StellaRigel/ESP32-Pressure-Temperature-Humidity-Recorder/实现细节.md

# 实现细节（PHT_2_X）

> **定位**：写**"怎么做"与"打算怎么做"** —— 原语 / 调用点 / 实测数据 / 踩坑台账 / **待做项的方案与论证**。
> **只写结论与做法，不写"一章要看半天"的推演**：设计文档图快览、本文档存细节，两份都不重复。
> 规格与版本规划看 [`设计文档.md`](设计文档.md)；怎么建 / 怎么跑 / 状态看 [`README.md`](README.md)。
> **约定**：某版本开发时段内的实现细节写进本文档对应小节；**同一份文档内不重复**。
> **待做项**：方案、根因、实测数据、边界与验收都写这里；设计文档只留一行「待办名 + 指向本文档」。

> **管理规则**：① 每节标题带**稳定编号** `D1…Dn`，**正文新内容一律往后追加、不重排**（编号 = 身份证，全项目靠它引用）；② 每节首行标**来源**；③ 原文对应位置只留**一行标记 + 本文档链接**；④ **待做项也在这里写全（含方案与论证），设计文档只留一行待办名 + 本文档链接**；⑤ 状态（做没做）不在本文档判断，看设计文档的版本标记与 README 状态总表；⑥ **模块化导航见下一节**「按模块找内容」——它按逻辑分组、**可随时重排**，正文顺序不受影响。

> ## ⛔ 铁律：**不要用 ESP32 去读 INA226/230 的电流做电量相关计算**（用户 2026-09-29 明确）
>
> **INA226/230 的电流读数，唯一允许的用途是判断充电阶段（CC/CV）**。
> **禁止**用它做：电量估算、电量百分比、能耗/功耗统计、放电速率、剩余时间、A/B 对比的"平均电流"、
> 以及任何"这个设备耗了多少电"的结论。
>
> **为什么**：这是**观察者效应** —— INA226 串在电池回路上，**ESP32 自己唤醒去读它的那一刻，
> ESP32（CPU + I²C + 外设）本身就是被它测着的负载**。读数里混着"测量动作自身的开销"，
> 而且这个开销随固件行为变化（睡不睡、刷不刷屏、开不开射频）→ **自己测自己，纯属胡闹**。
> 详见 **D11**（静置采样观察者效应，含实测：读数 ≥ 真实值 + 自身开销，电压被压低 ≈7mV）。
>
> **正确做法**：算电/比耗电一律**看电压（+ 由本机曲线表换算的电量%）随时间的下降**——
> 这是拓扑无关、不受测量动作污染的口径（标定的"时间轴"设计也是同一个理由，见设计文档 2.2 / **D15**）。
>
> **例外**：除非将来**加一颗独立的 MCU（如 STM32）专职读 INA226**，让测量与负载解耦，才可能重新考虑。

| 编号 | 小节 | 来源 |
|---|---|---|
| D1 | 充电控制 | 设计文档 V2.1 · 充电策略（两个「实现状态」节） |
| D2 | 气压距平与日平均基线 | 设计文档 V2.1 · 数据可视化 |
| D3 | 低电保护（三档阈值/深睡） | 设计文档 V2.1 · 电源管理模块 |
| D4 | 蓝牙三批实装（已搁置） | 设计文档 V2.1 · 无线 |
| D5 | 固件尺寸台账 | 设计文档（原「实现状态」行） |
| D6 | 屏幕布局参数 | README §三（79 行） |
| D7 | 怎么调屏幕 | README §四 |
| D8 | 屏幕提示 toast | 设计文档 V2.1 · 无线 |
| D9 | 标定首跑复盘（含 CSV 数据分析） | README §十三（123 行） |
| D10 | 第二跑结果与两跑对比 | README §十四（47 行） |
| D11 | 静置采样观察者效应/AVG 窗口 | 设计文档 2.4 |
| D12 | 标定落盘格式与掉电安全 | 设计文档 2.5 |
| D13 | 电量校准散落实测值/参数 | 设计文档 2.3 / 2.8（逐句挑出） |
| D14 | 连接策略与充电交互 | 设计文档 V2.1 · 连接策略 / V2.1.1 · 一 |
| D15 | 标定：充满判定、建表与使用 | 设计文档 V2.1.1 · 2.6 |
| D16 | 标定：流程与交互实现（设备隐身） | 设计文档 V2.1.1 · 2.8 |
| D17 | 顶栏即时反馈（V2.1.1-c） | 设计文档 V2.1.1 · 三 |
| D18 | 多组 WiFi 存储与自动选最强 | README §六 · 第 11 条（2026-09-17 搬入） |
| D19 | 手动归档下线 · `/download` 内存缓冲 · 术语改名 | README §十五 ①③④（2026-09-17 搬入） |
| D20 | V2.1.1 归纳：IO9 快慢充 · 实现顺序 · 本轮改动 · **待做项（计划细节）** | 设计文档 V2.1.1（2026-09-17 搬入；含 EEEE/FFFF 块去重） |
| D21 | V2.2 硬件规划：电源多路复用器 TPS2117 · 换 LDO RT9013 · 接线更改 | 设计文档 V2.2 · 硬件（2026-09-17 搬入；含 EEEE/FFFF 块去重） |
| D22 | V2.1 归纳：连接策略演化（被取代原文）· 充电/INA226 补遗 · 屏幕横幅规格 | 设计文档 V2.1 · 连接策略 / 充电策略 / 电池监测（2026-09-17 搬入并精简） |
| D23 | 三要素 24h 变率（整点环 · 屏幕箭头 · 网页显示） | 设计文档 V2.0 · 24h变率（2026-09-17 搬入；含 DDDD/CCCC 块去重） |
| D24 | 归档：引脚冲突实测 · BLE 铁律与崩溃取证 · BLE 搁置决策与连带项 | 设计文档原 附录 A.4~A.6 / 附录 B / 附录 C（2026-09-17 搬入并拆分） |
| D25 | 绝对湿度（AH）统一口径 · 湿度变率改 AH · 湿度图双轴曲线 | 设计文档 V2.1.1 · 交互和可视化 第 3/5 条 · 🚧 待做 第 6 条（2026-09-29 实装） |
| D26 | 网页 logo · favicon · 主屏图标（iOS + Android）（母题选型 · SVG data URI · PNG 路由 · PWA manifest） | 设计文档 V2.1.1 · 交互和可视化 第 2 条 · 🚧 待做 第 5 条（2026-09-29 实装） |
| D27 | 网页宽屏布局（≥1000px 多列仪表盘 · 数值行栅格化） | 用户 2026-09-30 实测反馈（4K 上曲线被拉平） |
| D28 | 未插卡时的日志兜底（按时间戳裁头 14 天）+ 按需挂载 SD（`ensureSD()`） | 用户 2026-09-30 问 flash 磨损 → 挖出"不轮转"与"sdOK 只判一次" |

## 按模块找内容（逻辑索引 —— 用这个导航）

> 正文仍按 `D1…Dn` **追加式**排列（编号 = 稳定身份证，规则见上）；**这一节是给"按模块找东西"用的导航表**。
> 归属唯一的模块；跨模块的条目以主模块为准，其余用途在条目里注明。
> 状态：**🔧 已实现** ／ **🧪 待验证** ／ **📋 计划中** ／ **📦 历史复盘**。

### ① 电源与电池
- **D1** 充电控制（原语 / 模式联动 / 80% 滞回）— 🔧
- **D3** 低电保护三档阈值与深睡 — 🔧（阈值来历待按本机表改造 → D20-5 ④）
- **D22-2 / D22-3** 充电硬件小项 · INA226 测量细节补遗（采样电阻、接法极性、CV 门限、离线兜底）— 🔧

### ② 电量标定与电池算法
- **D11** 静置采样观察者效应（INA226 AVG 窗口）— 🔧
- **D12** 标定落盘格式与掉电安全 — 🔧
- **D13** 电量校准散落实测值 / 参数（CSV 列 / 干跑 / 路由 / 原型坑 / 负载健康标志 / 进度屏）— 🔧
- **D15** 充满判定、建表与使用（21 点表 / 单调查表）— 🔧
- **D16** 标定流程与交互（设备隐身 / 停 HTTP / 中止条件 / 灰显）— 🔧
- **D20-5 ①~④** 网页响应抖动 · 今日统计回灌 · 换 LDO · 三档跟本机表走 — 📋🧪

### ③ 数据采集与算法
- **D2** 气压距平与日平均基线 — 🔧
- **D23** 三要素 24h 变率（整点环 / 屏幕箭头 / 网页显示）— 🔧（湿度档 2026-09-29 改绝对湿度 → D25）
- **D25** 绝对湿度（AH）统一口径 · 湿度变率改 AH · 湿度图双轴曲线 — 🔧
- **D19 ③** `/log.csv` 冻结调查与 `/download` 内存缓冲口径 — 🧪（根因未定）

### ④ 网页与前端
- **D13-3** 标定相关路由清单 — 🔧
- **D18** 多组 WiFi 存储与自动选最强（`/wifi` 页 / 接口 / 三条教训）— 🔧
- **D20-5 ⑤** 给网页加 logo — ✅（2026-09-29 实装 → **D26**）
- **D26** 网页 logo · favicon · 主屏图标（iOS + Android）（母题选型 / SVG data URI / PNG 路由 / manifest）— 🔧
- **D27** 网页宽屏布局（≥1000px 多列仪表盘 / 数值行栅格化）— 🔧
- **D28** 未插卡时的日志兜底（按时间戳裁头 14 天）+ 按需挂载 SD — 🔧

### ⑤ 无线通信
- **D14-1~D14-6** 连接策略：触发 / 流程 / 失败 / 空闲回收 / 静态 IP — 🔧
- **D14-3~D14-6** 与 **D22-4** 连网会话的历史原文（已作废，仅追溯）— 📦
- **D22-5** 屏幕横幅（连接成功 / 失败）文案与时长 — 🔧

### ⑥ 人机交互（按钮 · 屏幕 · 提示）
- **D6** 屏幕布局参数（顶栏 / 数据行 / 各状态）— 🔧
- **D8** 屏幕提示 toast 时机与版面 — 🔧
- **D14-7~D14-10** IO9 按钮：长按判定 / 快慢充 / 复位条件 / 反馈 — 🔧
- **D17** 顶栏即时反馈（V2.1.1-c）— 🔧
- **D20-1** IO9 按钮语义归纳（移动+插电切快慢充）— 🔧

### ⑦ 工程与流程
- **D5** 固件尺寸台账 — 🔧
- **D19 ①②④** 手动归档下线 · `/download` 口径 · 术语改名 — 🔧
- ⚠️ **D24-2 BLE 关闭铁律** —— **APP 阶段复活 BLE 前必读**（`deinit` 前必须确认无客户端连接，否则必 PANIC）— 📦

### ⑧ 历史复盘与决策留档
- **D9** 标定首跑复盘（含 CSV 数据分析）— 📦
- **D10** 第二跑结果与两跑对比 — 📦
- **D24-1 / D24-3** IO35 冲突实测与飞线工序 · 崩溃现场取证流程 — 📦
- **D24-2** ⚠️ BLE 关闭铁律（APP 阶段复活 BLE 前必读）— 📦
- **D24-4 / D24-5** BLE 搁置决策与连带项 · 蓝牙配网会话时序（已作废）— 📦
- **D20-3 / D20-4** V2.1.1 实现顺序 · 本轮改动台账 — 📦
- **D21** V2.2 硬件规划（TPS2117 / 换 LDO / 接线更改）— 📋（引脚待 PCB 画完确认）
- **D22-1** V2.1 各细节的归属总表 — 📦
- **D4** 蓝牙三批实装（已搁置）— 📦

> ⚠️ **D19** 是「三件事打包在一节」的例子——按模块找的时候会被拆到 ③④⑦ 三处，这是**索引特性**，不是重复。

---

## D1. 充电控制（V2.1，2026-09-11 / 09-13）

### 底层原语（2026-09-11）

**底层原语已实装**（`PHT_2_X.ino`，引脚定义区之后）：

```cpp
const int PIN_CE   = 17;   // BQ24074 CE#：低=允许充电，高=停止充电
const int PIN_ISET = 18;   // ISET切换MOS栅极：高=快充(~890mA)，低=慢充(~297mA)

chargeInit();                     // setup() 最优先调用：慢充 + 允许充电，杜绝引脚悬空
chargeSetCurrent(bool fast);      // true=快充 / false=慢充
chargeSetEnabled(bool en);        // true=允许充电 / false=停充
bool  chargeIsFast();             // 当前是否快充档
bool  chargeIsEnabled();          // 当前是否允许充电
float chargeSetpoint_mA();        // 当前档位设定电流，供 INA226 闭环/CV 判定
```

**设计原则**：本层只提供原语，业务侧只调函数、不直接操作 IO 电平。固定/移动模式联动、80% 停充策略均在原语之上实现。

**硬件实测验证（2026-09-11）**：手动拉高/释放 Q1 栅极，充电电流在 ~900mA / ~300mA 间稳定切换，ISET 网络通路正常。

**已知硬件小遗留**：Q1 栅极为无下拉设计，上电至 `setup()` 执行的几十毫秒内处于悬空态。但 ISET 节点电压低（≈1.2V）不足以经 Cgd 耦合到 Vgs(th)≈1.4V，实测无异常导通；且即便意外导通，也有 1kΩ 电阻兑底（最大 ~890mA，0.5C），**安全可接受**。下一版 PCB 建议补 100kΩ 栅极对地下拉。

### 模式联动（2026-09-13）

`applyChargeStrategy(const PowerState& ps)` 已实装（`PHT_2_X.ino`，充电原语之后），调用点三处：
开机 `setup()`（用唤醒后的电源状态）、每次采样 `readAndLog()`、网页切换模式 `/mode?m=` 之后。

| 模式 | IO18（ISET） | CE（IO17） | 触发条件 |
|---|---|---|---|
| **固定 0** | 低 = 慢充 ~297mA | 停充 **≥4.05V** / 恢复 **≤4.00V** | 按 INA226 电压滞回，≈80% 浮充 |
| **移动 1** | 高 = 快充 ~890mA | 恒低（允许） | 由 BQ24074 硬件终止于 4.2V |

* **滞回必须软件实现**：CE 拉高时 BQ24074 的内部 recharge 不会自己生效，故恢复点（4.00V）需软件判定；“80% 左右浮充”即由此达成。
* INA226 离线 → 无法判电压，**一律允许充电**（fail-safe），仅告警一次。
* 状态量 `fixChargeBlocked`（RAM）；档位/停充变化**仅在跳变时**打日志，避免刷屏。

## D2. 气压距平与日平均基线（2026-09-13）

- 只有固定样本进日平均/距平；移动模式接口报 `fix:false`、网页卡片显“仅固定模式可用”。
- 基线语义修正：**没采集的槽不再算作“参与天”**——原先空槽写 0 也被计入，30 天窗口均值被稀释（1012 hPa 曾算成 507，距平遂显示 +505 hPa）；
  现空槽写 `NaN`，旧的 0 值文件按“无数据”跳过（`avgDateValid()`）。自检：`node tools/anomaly-check.mjs <ip>`。

## D3. 低电保护（V2.1.1）

> **来源**：设计文档 V2.1 · 电源管理模块（2026-09-17 搬入）

- **三档阈值**（`.ino` 常量，V）：`BATT_ARCHIVE_SD 3.6` / `BATT_STOP_RECORD 3.55` / `BATT_DEEP_SLEEP 3.5` ——
  ≥3.6 正常记录；3.55~3.6 **存档数据至 SD**；3.5~3.55 **停止采集**；<3.5 **深睡保护**（保命，防低压下写 SD/Flash 损坏数据）。
- **深睡实现**：`enterDeepSleepIfNeeded()` → `esp_deep_sleep_start()`（调用后重启，从 `setup()` 重新开始）；
  唤醒开机再判一次（`!powered && inaOK && battVolt < 3.5V` 继续深睡），插电则转入外接电源模式。
- **电压来源 INA226**；**INA226 离线时本保护整体作废**（不判低电、不深睡，屏幕/网页显示告警）。
- ⚠️ **阈值来历**：原 3.3/3.25/3.2V **低于 LDO(SPX3819) 崩溃点 ~3.4V** → 三档实际从未生效；整体上移为 3.6/3.55/3.5V。
- ⚠️ **待定**：若换 LDO RT9013-33B（崩溃点下移）→ 三档需重定（0% 端 = 崩溃点，须重跑标定）；方向是改成从本机曲线表取。

## D4. 蓝牙三批实装（已搁置，2026-09-13）

> **来源**：设计文档 V2.1 · 无线（蓝牙配网 / BLE 中继）

**用途**：移动模式户外使用（无路由器时用手机蓝牙读数据 / 配网）。

- **第一批（无线互斥状态机 + BLE 只读通道）**：互斥状态机照设计文档表格四条组合（**仅「移动+电池」用蓝牙**）+ BLE 只读通道（core 自带 Bluedroid；Service `6e400001-…` + RX(write)/TX(notify)，协议 `GET /path\n` → JSON + `\n`）+ 实体 WiFi 键 IO9 + `/wireless?force=` 联调口（3 分钟自愈）。日志实证全周期切换正常、采样不中断。
- **第二批（蓝牙版完整只读页）**：`/history` `/today-stats` `/anomaly` `/daily-avg` 抽成 `build*Json()` 与 HTTP 共用（`/history` 蓝牙下默认 100 条；响应由 `bleTxPump()` 在 loop 里非阻塞分片发）；主页加**传输层 shim** `apiFetch()`（WiFi→fetch / 蓝牙→BLE，一份 HTML 两处通用）+ `tools/dump-page.mjs` 取页到手机本地。
- **第三批（蓝牙配网）**：后端复用 `wifiUpsert()`（多组、同 SSID 覆盖、`useIPMode=-1` 不改地址方式），新增 BLE 分发器接口 `/wifi-list` `/wifi-scan` `/wifi-save` `/wifi-del`（`wifi-scan` 原 HTTP 内联逻辑抽成 `buildWifiScanJson()` 共用；`/wifi-list` 同时开放 HTTP）；页面「📶 配网（WiFi）」卡全靠 `apiFetch`（蓝牙/局域网同一张卡）；**只写 Flash、不立即连**，插电时保存后 20 秒自动重启连网（继续保存则顺延），电池供电则提示按 IO9；密码只走请求不写日志，`/wifi-list` 不回显密码，请求缓冲 192→512 字节。
- **卡片去重（两处配网不重叠）**：`caps.prov`（仅蓝牙/只读置 `true`）控制主页「📶 配网」卡；`caps.wifi` 控制系统卡里通往 `/wifi` 页的链接（蓝牙模式 `false` —— 设备无 HTTP 服务，链接是死的）。BLE 搁置后 `caps.prov` 与蓝牙分发器一并停用。
- **手机实测（2026-09-13）**：只读数据页在 Android Chrome（content:// 打开）可用，①主屏幕快捷方式可用。
- **手机端 bt-page.html 怎么开（2026-09-13 实测）**：
  - ① **主屏幕快捷方式**（实测可用）：文件管理器 → Chrome 打开 `bt-page.html` → Chrome ⋮ → 「添加到主屏幕」→ 之后一点就开
  - 打开后页面**自动重连**上次授权过的设备（`navigator.bluetooth.getDevices()` + `gatt.connect()`），失败才提示手选 PHT_2_X
  - ② WiFi 场景：直接书签设备页 `http://<设备IP>/`（功能最全，文件/OTA 都有），最省事
  - ③ 【可选·未做；随 BLE 搁置一并挂起】挂到 HTTPS 静态托管（GitHub Pages / Cloudflare Pages / 自建 NAS 反代）：手机只存书签、永远最新版、不必反复传文件；要启用时把页面整理成单文件发布即可（亦见附录 α · 5）
  - ⚠️ 不要把设备 http 页存成书签当蓝牙入口：设备进蓝牙模式时 HTTP 服务是关的，书签会打不开
  - 页面每次改动后：`node tools/dump-page.mjs <IP> bt-page.html` 重新取一份发给手机
- **手机测试页**：`tools/ble-web.html`（Android Chrome + Web Bluetooth）—— 随 BLE 搁置一并挂起。
- ⚠️ **BLE 写回调硬约束（2026-09-13 踩坑）**：写回调跑在协议栈任务上（栈约 3KB），**严禁在回调里做重活**（解析 CSV、拼大 JSON、delay）。回调只把请求拷进 `blePendBuf` 置标志，处理与分片发送都在 `loop()` 里做；大缓冲一律放堆（`malloc`/PSRAM），不要放栈。
- **代码现状**：包在 `#if ENABLE_BLE`（默认 0）→ 不编入固件；搁置决策见 **D24-4**。

## D5. 固件尺寸台账

| 时间 | 版本 / 事件 | 编译尺寸 | Flash | 备注 |
|---|---|---|---|---|
| 2026-09-15 | V2.1.1-a（IO9 快/慢充） | 1219127 B | 7% | 全局变量 16%；同日网页 OTA 一并验证 OK |
| 2026-09-15 | V2.1.1-b | 1241891 B | 7% | 干跑端到端验证通过 |
| 2026-09-14 | BLE 条件编译关闭 | 1214259 B | 7% | 由 1468379 B 降下来（−245KB）；全局变量 −2.7KB |

> 更早的编译记录见 git 历史。

## D6. 屏幕布局参数（逻辑坐标 250×122）

> **来源**：README §三（2026-09-17 搬入）

```
x6      x70      x166 x176   x209  x231
 │        │        │    │      │     │
09:41   FIX      ⚡    CC    [███]  📶     ← 顶栏（全部由代码绘制）  y0~17
时间    模式      充电指示     电池   WiFi

温度  26.5°C                    ↑0.5         y24
湿度  40.6%                   ↓10.0         y56
气压  1013.5hPa               ↑10.5         y88
     ↑ 数值：一位小数 + 单位          ↑ 24h变率：右对齐、省略单位（x→247）
     ↑ 中文标签「温度/湿度/气压」由 ui_cjk.h 字模动态绘制（x6~54；原底图已删，全屏已无静态图）
     ↑ 提示横幅（Toast）出现时：整条 y22~121 刷白（连中文标签一起盖掉），**顶栏保持不动**
```

**数据行右侧 24h 变率**（箭头 + 绝对值，一位小数）：

```
↑ 上升(Δ≥0.1)    ↓ 下降(Δ≤-0.1)    → 平稳(|Δ|<0.1)    无数据=留空
```

* 箭头为**自绘**（三角头 + 杆），字库无此字符；↑↓ 占 11×18，→ 占 14×11
* 右对齐基准 `UI_TREND_RIGHT = 247`；阈值 `UI_TREND_TH = 0.1f`
* 最紧的是**气压行**（`1013.5hPa` 宽 108px，与变率间只剩约 15px），不要再往里加内容

**顶栏各状态**

```
未充电     09:41  MOV          85%  [███] 📶
充电·恒流  09:41  FIX    ⚡  CC      [███] 📶
充电·恒压  09:41  FIX    ⚡  CV      [███] 🔥
AP 热点    09:41  FIX                [███] 🔥(AP)
WiFi 断开  09:41  FIX                [███] 📶̸
时间未同步 --:--  FIX                [███] 📶
INA 离线   09:41  FIX                  INA! ❗ 📶
INA 离线·充电中 09:41  FIX      ⚡  INA! ❗ 📶
蓝牙(搁置) 09:41  FIX                [███] bt      ← 第 4 档，BLE 已搁置（不编入固件）→ 实际不会出现
```

* 模式：`FIX` = 固定(0)，`MOV` = 移动(1)
* 充电中才显示 ⚡+CC/CV；未充电时同位置显示电量百分比
* WiFi 三种图标：已连接 / AP 热点 / 断开（弧上带斜杠）
* **INA226 离线**（`inaOK=false`）：电池图标位改画 `INA!`（右对齐 x198、宽 36 → 墨迹 163..195）+ 自绘叹号（x213）；若同时在充电，`⚡` 由 166 **左移到 152** 避让（正常态仍 166，与 `CC`/`CV` 的 x176 对齐）。网页同步：电量 `⚠`、电压/电流 `--`、充电状态 `⚠ INA226 失联`；低电三档门控整体作废（继续记录、不深睡）

---

## D7. 主逻辑怎么调屏幕

> **来源**：README §四（2026-09-17 搬入）

```cpp
uiDisplay.init();                                     // setup()，全量重绘（无底图：白底 + 中文标签 + 顶栏）

// 每次采样后（readAndLog 末尾）：
uiSyncStatus();                                       // 电源/WiFi/模式 → 屏幕对象
uiDisplay.setTrend(dT24, dH24, dP24);                 // 24h变率（整点算好后缓存）
uiDisplay.showAll(temp, hum, pres, time(nullptr));    // 数值 + 顶栏，全刷
uiDisplay.showTop(time(nullptr));                     // 只刷顶栏（省电用）
uiDisplay.readLogical(x, y);                          // 读回逻辑像素（仅供 /ui-dump 自检）
uiDisplay.redrawAll(t, temp, hum, pres);              // 整屏重绘（底图删除后新增的唯一全屏入口）

// 提示横幅（Toast）：盖住数据区、顶栏不动，到期自动还原
uiDisplay.showToast(UI_TOAST_OK, "WiFi OK", "SSID \"mywifi\"", "192.168.1.9", 20000);
uiDisplay.queueToast(UI_TOAST_AP, "AP MODE", "SSID \"hotspot\"", "192.168.5.1");  // 到期接着弹下一条
uiDisplay.tickToast();                                // loop() 里每次调用：到期还原 / 接着弹排队那条
uiDisplay.toastActive();                              // 查询是否有横幅在显示
uiDisplay.textWidthLogical("abc", true);              // 量宽度（拼长文本前先看会不会超屏）
```

| 屏幕元素 | 数据来源 |
|---|---|
| 时间 | DS3231 / NTP → `time(nullptr)`；未同步显示 `--:--` |
| 模式 MOV/FIX | `deviceMode`（NVS，`/mode` 接口切换） |
| ⚡ CC / CV | `PIN_CHG` 判充电；充电阶段取 INA226 `cvZone`（与网页同源） |
| 电量 % | `readPowerState().battPct` |
| 电池图标 0~4 格 | 由上面 % 换算 |
| WiFi 图标 | `WiFi.status()` 已连接 / AP 已开 / 断开 |
| 温度/湿度/气压 | SHT30 + BMP580 **原始读数**（不滤波，与落盘值分开）；湿度/气压一位小数 |
| 行右侧 24h 变率 | 整点环（RAM 24 槽）算得，`setTrend()` 传入 |

### 刷新策略（对应设计文档 · 电源管理）

`readAndLog()` 末尾按供电方式节流：

* **插电**：每次采样（:00 / :30）都刷屏，实时。
* **电池**：**只在整分钟那次采样刷屏**，即每分钟 1 次，省电。

深睡 / 低电保护逻辑已按设计文档改为**三档**；IO9 分压回退已删除；INA226 离线时整体降级为告警（不判低电、不深睡）。
**2026-09-15（V2.1.1-b）三档阈值上移**：3.3/3.25/3.2V → **3.6/3.55/3.5V**（原值低于 LDO 压缩点 ~3.4V，设备会在保护触发前硬掉电，三档实际从未生效）。

---

## D8. 屏幕提示（toast）时机与版面

> **来源**：设计文档 V2.1 · 无线（2026-09-17 搬入）

> **屏幕提示（无蓝牙也可用）**：自动提示四个时机——开机连上（√）、开机连不上（× → **10 秒后自动接热点页**）、AP 启动（热点图标）、热点开着时又连回路由器（√）；另可网页点「📺 屏幕显示」或 `GET /toast[?d=毫秒][&k=ok|fail|ap][&q=1]` 手动弹出。版面：三行居中（图标+大字状态 / SSID 小字 13px **带引号** / IP 大字 20px；失败页第三行是 `not connected`、**不给 IP**），盖住数据区与中文标签，**顶栏始终不动**。热点图标＝「中心点 + 双侧对称 90° 同心弧 x2」，与顶栏（上方三道弧）区分。

## D9. 标定首跑复盘（2026-09-16）

> **来源**：README §十三（2026-09-17 搬入）

#### 好的部分：数据有效，表已建好并生效

| 项 | 值 |
|---|---|
| 时间窗 | 2026-09-15 **23:21:15** → 2026-09-16 **17:45:55**（`/log.csv` 采样空档 **18h24m**）|
| 轮次 | **110**（理论 110×10min=1100min，实测空档 1105min ✓ 吐合）|
| 纯放电 | 110 × 9min = **16.5h** |
| 表 | `n=110, dry=0, v100=4.168V, v0=2.945V`（`tableDry=false` ✓ 已生效）|
| 现状 | 插电充电中（`canStart=false`：等 BQ 停充 + 满电保持 5min）|

#### ⚠️ ① 自动建表没触发（根因已定位）
最后一条样本 `V_rest=2.945V < CAL_FLOOR_V(3.0V)` → 收工走的是 **`calAbort("电压触底")`**，
而 `calAbort()` 会 **`setCalFlag(false)`**，`calBootCheck()` 又只在标志还在时才建表 →
下次开机（17:46 插电 / PGOOD 唤醒）**静默跳过** ✗，表一直是干跑那张。
✅ **已实装（2026-09-16）**：`calAbort(why, tryBuild)` 新增 `tryBuild` 形参 + 触底处 `calAbort("电压触底", true)` ——
先 `calBuildTable(false)`，**建成功才清标志**；建失败则保留标志，下次开机 `calBootCheck()` 补建。
其它中止（按钮/插电/网页）行为不变。
> 讨论要点（2026-09-16）：**“标记”机制其实已经有了** —— `setCalFlag(true)` 写在 **NVS**（掉电不丢），`calBootCheck()` 上电读它 → 建表 → 抹掉，
> 正是“加标记 / 上电检测 / 建表抹掉”那一套。唯一毛病是 `calAbort()` **在建表之前就把标志抹了** ✗。
> 而且 **“触底”并不是掉电**：它是软件检查（`V_rest < 3.0V`）在**设备还活着**时触发的 —— 证据：那之后它还写了 `17:45:55` 那条记录，
> 再按 3.5V 档进深睡。所以最小改动＝**触底时先建表、建成功再抹标志**（建失败就留标志，让下次开机补建）。
> → 真掉电（来不及跑软件）时标志仍在 → 下次开机照样自动建表 ✓ **两种情形一套机制全覆盖**，不必再加新标记。
> 本次用网页「建部分表」（`POST /battcal/build`）手动补建 → 表已生效；旧表备份在 `/battcal.prev.json`。

#### ⚠️ ② `0% = 2.945V` 与先前“LDO 崩溃点 ~3.4V”**冲突**（待确认）
- 若为真：三档 3.6/3.55/3.5V **明显偏高**，白丢 0.1~0.6V 可用区间（换 LDO 后一并重定）。
- 待判：曲线 **0%~5% 有 0.69V 台阶**（2.945 → 3.635）—— 要看原始 CSV 才能分清“真陡尾”还是“末段坏样本”。
- **2026-09-16 用户解释（采纳）**：崩得早 **不是 LDO 本身** —— ① 标定负载 130mA **比日常峰值小**（有峰值尖峰时会提前崩）；
  ② 先前 3.4V 很可能测自**最早一批板**（LDO 输出端电容疑 **Y5V**，容量保持差）vs 今天这块 **X5R** → **板间不一致** ✗
  → **结论（用户 2026-09-16 修正）**：**不用按最差板** —— 每台标自己的电池，三档阈值改成**跟着本机表走**即可自动吸收板间差异 ✓（方案见本文档 **D20-5 ④**）
- 容量侧（③）用户倾向：**商家标定用的放电终止点更高** → 同电芯在我们更低的终点上量出 2145mAh > 1800mAh 合理 ✓（待用原始 CSV 核算 i_load 平均）

#### ⚠️ ③ 每样本的 `load_ok` 列其实写的是 `wl`（同一变量）
`calCsvRow()`：`int wl = (WiFi…CONNECTED)?1:0; … ,wl,wl);` → 设计文档说的「负载健康标志 `loadOk`」**从未真正测量**；
建表过滤 `if (!wl || !lo) continue;` 实际只筛了“WiFi 在不在”。
→ 建议：第 9 列改记**真实负载健康**（如加载循环迭代数），或把列语义写进表头。

#### ⚠️ ④ 容量交叉核对对不上 → 需要原始 `i_load` 列
130mA × 16.5h = **2145mAh** > 标称 **1800mAh** → 说明 `i_load` 平均值应低于 130mA（或电芯容量大于 1800mAh）。
这正好是 **α1 档位设计**要的第一手数据。

#### ✅ ⑤ 读 `/battcal.csv` 的口子（已实装 2026-09-16）
原本 `/download` 写死读 `/log.csv`、`/sdread` 又要 SD 卡（本机 SD 初始化失败）→ 标定原始 CSV 取不出来。
**已实装**：`GET /download?f=/battcal.csv`（白名单只放行这两个文件，防路径穿越）✓
> **2026-09-17 更新**：本机 SD 卡现在启动时报 `✅ SD卡已就绪`（早前记录为“初始化失败”）→ `/sdread` 可能已可用 ✓；
> 同时“SD 常驻”也是 十四、④ 里 +20~30mA 常态电流的**首要候选** ⚠️

#### ⚠️ ⑥ 电量显示长期 0%（2026-09-16 发现，已修）
`calPctFromVolt()` 的插值循环按**递减**表写（`v>=calPctV[k+1] && v<=calPctV[k]`），而实际表是**递增**（`[0]=0%` 最低电压 … `[20]=100%` 最高电压）
→ 电压落在区间内部时**永远不命中** → `return 0` ✗（只有 `v ≥ 100% 点` 才走上面的 100% 分支，所以满电时看着“正常”）。**已改为升段插值** ✓。

> **教训**：干跑“端到端验证通过”是**假象** —— 干跑表是退化的（`v100 = v0 = 4.156V`），永远命中 100% 分支，**插值路径根本没被覆盖** ✗。
> → 建表/查表自检应加一条**合成表**用例（如 [2.90 … 4.15] 等差），把插值走通。

#### 📊 ⑦ 首跑数据分析（原始 CSV 到手后，2026-09-16）

原始样本已可取：`GET /download?f=/battcal.csv`（5652 B / 110 行）。

| 指标 | 值 |
|---|---|
| 累计加载时长 | **13.57 h**（88 轮 × 9min + 22 轮 × 1min 低压加密）|
| 静置合计 | 110 × 1min = 1.83 h → **放电共 ≈ 15.4 h** |
| **实测容量** | **1791 mAh / 6.95 Wh**（到 V_rest = 2.944V），平均放电电压 3.880V |
| 平均电流 | i_load **125.3 mA**、i_rest **54.3 mA**（静置段 WiFi 仍挂着）|
| 曲线单调性 | 110 点里只有 1 次 >2mV 回弹（最大 +3mV）→ **基本单调 ✓** |
| 坏样本 | wl=0 / load_ok=0 各 **0** 个（这次 WiFi 全程在线）|

**① 容量疑问（③）结清：我上次算错了** ✗→✓

“130mA × 16.5h = 2145mAh”是**把加载时长当成了全程时长** ✗；真实为放电 15.4h、平均 116mA → **1791mAh**，正好贴着标称 **1800mAh** ✓。
→ 电芯没问题；用户“商家终止点更高”的解释可能（我们到 2.944V 才放出 1791mAh），但**已不再需要**用它解释异常 —— 本来就没有异常。

**② 0%~5% 那个 0.69V 台阶：是真的（不是坏样本）** ✓

最后 22 轮全是低压加密（`dt=1min`，V_rest 3.5→2.944V），i_load 稳定 117~145mA、wl/load_ok 全 1 → **末段读数干净** ✓
→ 是电芯**拐点（knee）**的真实表现；表里显得陡，是因为横轴是**累计加载时长**、低压段每轮只计 1min ✓ → **不需要裁表** ✓

**③ 三档阈值：现在这三个值基本就是对的值，不用大改** ✓

| 电压 | 已放出 | 占比 |
|---|---|---|
| < 3.50V | 67 mAh | **3.7%** |
| < 3.20V | 19 mAh | **1.1%** |

→ “跟本机表走”算出来是：深睡 = 表 5% 电压(3.635) − 余量 0.1 = **3.54V** ≈ 现值 3.5V ✓；停采 ≈ 3.61V ≈ 现值 3.55V ✓；存档 ≈ 3.65V ≈ 现值 3.6V ✓
→ **现值 ≈ “5/10/15% × 本机表 − 100mV”，两种口径互相印证** ✓ → 改造只是把它**自动化、按台适配**，不是为了多榨电量（下面这段本来也没多少）

**④ α1 档位参考（本次实测容量外推）**

| 恒流 | 时长 |
|---|---|
| 30 mA（移动 idle）| **59.7 h ≈ 2.5 天** |
| 52 mA | 34.4 h |
| 80 mA | 22.4 h |
| 130 mA（本次标定负载）| 13.8 h |
| 200 mA | 9.0 h |

**⑤ 时间账的小坑（下轮注意）**

日志空档 18h24m ≠ 放电 15.4h → 差的 ≈ 3h 就是 **CAL_ARM 等拔充电器**那段（arming 就把采样停了，日志看不出来 ✓）。
→ 表本身用“累计加载时长”做横轴，**不受影响** ✓；但报告“跑了多久”时别拿日志空档当放电时长 ✗

**⑥ 负载电流为什么会跳（2026-09-16 第二跑当晚记录）**

首跑 110 个样本的 `i_load` 分布：min 107.2 / p10 112.2 / **中位 124.2** / p90 140.5 / **max 150.0** / 平均 125.3 mA
（相邻样本 145→150→150→119→133→122… 就是这样跳的）→ **“130mA”是典型值，不是恒值** ✓

原因：负载本身是“**20×512B UDP 连发 → 空等 ~190ms**”的**突发**形态（`calUdpBurst()` 每次 20 包），
而屏幕上的 `calLastI` 与 CSV 的 `i_load` 都是**同一口径的多秒平均**（`CAL_AVG`，INA 窗口被芯片夹在 128 档，见 α8）
→ 样本间 **±20% 波动完全正常**；跨跑差异（如第二跑初段偶见 165mA，高于首跑 max 150）**大头在射频侧**：
AP 忙/信道挤/重传多 → WiFi TX 占空比上去 → 平均电流上去 ✓（与固件改动无关：负载代码 `calUdpBurst + calCpuBurn(180) + delay(2)` 一字未改）

**对表的影响**：表是“电压 ↔ 剩余电量%”映射，只要**单跑内部负载大致稳定**就成立 ✓；
负载高只是让这跑**更快跑完**、**0% 落点略高**（重载下底线抬高）✓。跨跑对比看**曲线形状**（差异应在几十 mV 的 IR 量级）✓

> **可选改进（下轮之后）**：建表现在按**时间**加权，改为按**电量（|I|·dt）**加权 → 负载有浮动也不影响表 ✓
> （`i_load`/`i_rest` 列本来就记着，改动很小）；但**同一对对比的两个跑不要中途改口径** ✗

---

## D10. 第二跑（09-16→17）结果

> **来源**：README §十四（2026-09-17 搬入）

#### ① 时间线（可复现性）

| 时刻 | 事件 |
|---|---|
| 09-16 22:46:47 | 标定开始（CSV 头 `start=`）|
| 09-17 11:14:30 | **电压触底 → 收工，表已落盘**（`/battcal/report` 的 `date`）|
| 09-17 11:17 | 设备重启（启动日志显示 11:17:02 同步 NTP）**原因待查** ✗ |

**✅ 触底自动建表已实测生效**（十三、① 收尾）：
- `/battcal/status` → `tableOk=true, tableDry=false, tableN=85` ✓（真表，不是干跑表）
- 表的落盘时间 **11:14:30 = 跑完那一刻** ✓
- 关键的**反证**：11:17 那次重启的启动日志里**没有**任何“建表/补建”行 → 说明 NVS 标志已被“触底那次成功的建表”清掉了 ✓✓

#### ② 两跑对比（85 vs 110 样本）

| 指标 | 第一跑 | 第二跑 | 差异 |
|---|---|---|---|
| 累计加载时长 | 13.57 h | **11.02 h** | −18.8% |
| 低压加密轮数 | 22 | 13 | −40.9% |
| 实测容量 | 1791 mAh | **1682 mAh** | −6.1% |
| i_load 中位/平均 | 124.2 / 125.3 mA | **139.7 / 143.8 mA** | +12.5% / +14.7% |
| i_rest 中位/平均 | 53.0 / 54.3 mA | **82.8 / 83.0 mA** | **+56.2% / +52.9%** ⚠️ |
| 末点 V_rest | 2.945 V | 2.969 V | +0.8% |
| 温度 | 27.9 ℃ | 25.5 ℃ | −2.4 ℃ |

**21 点表差异（5%~100%）：平均 −11.7 mV，最大 −17 mV**（逐点全在 −8…−17 mV）；0% 点 +24 mV
→ 差异正好是“更大负载下多出来的 IR 压降”量级 → **两跑的表实质等同 ✓✓，标定流程与表都可信** ✓

#### ③ 结论

1. **一致性达标**：同一台设备两次独立标定，曲线 5~100% 全程差 ≤17 mV ✓（0% 落点 2.945 / 2.969V，两次都撞在实机底线上 ✓）
2. **容量 −6% 是预期的**：电流大（Peukert）× 温度低 → 放出容量少一点、但“更快跑完” ✓（非固件差异）
3. 负载电流本身比首跑高 **+15%**（与用户当晚看到的 165mA 对得上）→ 大头在**射频侧** ✓
4. **遗留：静置电流 +30 mA（+53%）** ⚠️ —— 静置段没 CPU 空转、没 UDP，所以这是**常态额外负载**，待查：
   - 候选 A：**SD 卡这跑是挂着的**（本次启动日志 `✅ SD卡已就绪`，而早前记录是“SD 初始化失败”）
   - 候选 B：**USB/串口线插着**（USB PHY 常态 ~10~25 mA）
   - 候选 C：WiFi/AP 环境（与负载那 +15% 同源）
   - 区分办法：分别在“拆 SD / 不插 USB”下量一次电池端静置电流（需拔充电器、WiFi 已连）
5. 电量显示正常：4.10V → **98%** ✓（0% bug 修复后首次实跑验证 ✓）

> 工具：`tools/cal-chart.cjs`（单跑三合一图）、`tools/cal-chart-cmp.cjs`（两跑对比图，内含 T1/T2 两个表，换跑要更新）

---

## D11. 静置采样的实现约束（观察者效应）

> **来源**：设计文档 V2.1 · 电量校准 2.4（2026-09-17 搬入）

#### 2.4 静置采样的实现约束（观察者效应）

INA226 串在**电池回路**上 → **ESP32 自己醒来读数的那一瞬，也在被它自己测着**。
点采样存在固有下限：`读数 ≥ 真实值 + 自身测量开销`，永远读不到“低于固定值”的电流；
对**电压**同理：醒来那几十 ms 的峰值（CPU + I²C）经内阻会把电压压低 **≈ 7 mV**（50mA × 0.15Ω）。

**破解思路：让测量发生在你睡着的时候**（INA226 是独立芯片、用自己的 ADC 连续测量，不依赖 ESP32）。

1. **醒来第一件事只读 INA226 寄存器** —— 不初始化 WiFi、不读传感器、不刷屏、不写日志（除必要的落盘）。
2. **启用 INA226 硬件平均**（设计目标最多 1024 次转换 → 窗口 8.4s；
   **实测本板只认到 AVG=128 → 窗口 ≈ 2.11s**，仍够用，详见 [`实现细节.md`](实现细节.md)）：
   该窗口覆盖的主要是睡觉期间的数据 → 把自身开销稀释到 <1%，下限降到接近真实静态。
3. **顺手记下醒来瞬间电流 `I_wake`**：日后可用 `V_ocv ≈ V_read + I_wake × R_app` 做自洽修正
   （`R_app` 由 `V_load/V_rest` 对算得，已在存）。
4. 结论：**不影响本次标定** —— 加载段（200mA 量级）开销可忽略，静置段只差几 mV 且可修正；
   这也是**不用电流积分**的又一个理由（时间轴彻底绕开这一环）。

## D12. 标定落盘与掉电安全

> **来源**：设计文档 V2.1 · 电量校准 2.5（2026-09-17 搬入）

#### 2.5 落盘与掉电安全

- **存内部 LittleFS**（实测 SD 常未插卡）：`/battcal.csv`，表头记元数据（开始时间、负载档、`T_LOAD/T_REST`、固件版本），
> 网页下载：`GET /download?f=/battcal.csv`（2026-09-16 新增；`/download` 默认仍下 `/log.csv`，白名单只放行这两个文件）
  每行 `t_loaded_ms, V_load, V_rest, I_mA, T_C`。
- **掉电是预期结局**（测试终点就是掉电）→ **每行写完立即 flush**，绝不依赖「结束时统一保存」。
- 另存「标定进行中」标志（NVS / 文件头）；开机见到它 = 上次是标定中途掉电 → **自动退出标定态并建表**。

## D13. 电量校准：散落实测值 / 参数

> **来源**：设计文档 V2.1 · 电量校准 §二 引言 / 2.3（2026-09-17 搬入，逐句挑出）

### D13-1

- **CSV 实际列**：`t_loaded_ms,dt_ms,v_load,v_rest,i_load_mA,i_rest_mA,temp_c,wl_ok,load_ok`；
  头部一行 `#` 元数据（start / fw / dry / v100 / load_ms / rest_ms / low_from）。
  `temp_c` 取**标定开始时一次性读到的环境温度**（标定期间不读传感器）。

### D13-2

- **干跑模式**（`/battcal/start?dry=1`）：缩短时长（20s 加载 / 10s 静置）、**保留网页**（便于远程观察）、
  不要求充满、跑 6 轮后自动重启，专门跑「掉电后开机建表」路径；建出的表标 `dry:1`，**只用于查看、绝不生效**。

### D13-3

- 路由：`/battcal`（页面）、`/battcal/status | start | stop | build | report | clear`。

### D13-4

- 实测踩坑（与 a 同源）：`.ino` 的**自动函数原型会漏**（raw string 字面量一多就乱）
  → 标定函数全部在「前向声明区」显式声明。

### D13-5

- 低电三档已同步上移（3.6/3.55/3.5V），标定期间整体旁路。

### D13-6

- **每样本记「负载健康标志」**：`wlOk`（采样时刻 WiFi 是否仍关联）/ `loadOk`（**整个加载段** WiFi 是否全程在线 —— 中途掉线 = 负载腰斩）。
  WiFi 掉线、路由器重启等异常会让负载腰斩 → 该段样本事后可识别剔除（否则曲线会“凭空变长”）。
  > **⚠️ 2026-09-16 修正**：原实装把这两列写成了同一个 `wl`（`…,wl,wl);`）→ `loadOk` **从未真正测量**，建表过滤 `if(!wl||!lo)` 实际只筛了“WiFi 在不在”。
  > 已改为 `calLoadBad`（加载段每次循环查 WiFi，掉线则黏住）→ 第 9 列 = `!calLoadBad`；CSV 另加一行 `# 列义` 注释。

### D13-7

- **进度屏两行**（`calScreenProgress()`）：`CAL <pct>%`（线性估值：4.20V=100%、3.00V=0%）+ `<h>h<mm>m <V>V <I>mA c<轮次>` —— **`c<n>` = 已完成轮次数**（一轮 = 加载 `T_LOAD` + 静置 `T_REST` ≈ 10 min；V<3.5V 后加载缩短为 1 min → ≈2 min/轮）。

## D14. 连接策略与充电交互的实现细节

> **来源**：设计文档 V2.1 · 连接策略（会话流程/静态 IP）/ V2.1.1 · 一（2026-09-17 搬入，小步逐条）

### D14-1

- **静态 IP**：配网卡可勾「静态 IP」填 IP/网关/掩码（`useIP=1`）；不勾发 `useIP=0`（明确自动，避免历史上"表单没带 useIP 就把静态 IP 关掉"的事故重演）。

### D14-2

- **不持久化**：RAM 标志 `chargeForceSlow`；`applyChargeStrategy()` 移动分支改为 `chargeSetCurrent(!chargeForceSlow)`。

### D14-3

- **触发**：蓝牙配网页「💾 保存并连接」/ 点已保存网络的「🔗 连接」/ 移动+电池下长按 IO9 —— 三者走同一流程。
  > **BLE 搁置后（2026-09-14）**：蓝牙入口作废，只剩「设备自身 AP 配网页」与「长按 IO9」（见 **D24-4**）。

### D14-4

- **流程**：置会话 → **立即切 WiFi 连接**（旧的「只写 Flash、不立即连」「20 秒后重启」均作废）→ 连上后向蓝牙网页推送 `{event:"wifi-connected", ssid, ip}`（蓝牙**缓关 2.5 秒**确保推送送达）→ 屏幕拉横幅 `WiFi OK / SSID / IP` → 关蓝牙。
  > **BLE 搁置后**：推送一环作废；屏幕拉横幅保留。

### D14-5

- **失败**：屏幕报错 + 推送 `{event:"wifi-failed"}`，**留在蓝牙模式、绝不开热点**。
  > **BLE 搁置后**：停在这里。现行 V2.1 语义是「失败 → 直接开 AP 配网热点（带超时）」，见 **D24-4** 与设计文档 **无线策略与静态 IP（现行）**。

### D14-6

- **空闲回收**：会话期间每次网页请求都续期（网页每 3 秒轮询 `/status`）；**60 秒无请求自动切回蓝牙**。
  > **BLE 搁置后**：回收对象从「切回蓝牙」变为「关掉无线」，超时改为 `AP_SESSION_MS`。
- **网页访问确认**：收到第一口网页请求 → 立即收起横幅（等于"用户真的进来了"，不必傻等）。

### D14-7

- **按键逻辑与开 WiFi 完全一致**：复用手势判定与消抖，不新增手感差异。

### D14-8

- **复位条件 = 断电即复位**（不再是充电插入沿）：`serviceChargeTemp()` 在 `loop()` 每圈检查，
  未切慢充时零开销；一旦外部电源断开 → 清标志 + 立即按默认快充应用 + 打日志。
  等价于“拔插回来就是快充”，且**不会在电池态留下“慢充”假状态**。
- **模式切换**（`/mode`）也清掉临时慢充（换模式 = 新场景），并用 `readPowerState()` 取新鲜电源状态。

### D14-9

- ⚠️ **踩坑**：`chargeForceSlow` 定义在充电策略段（`checkWifiButton()` **之后**），而 `.ino` 只自动补**函数**原型、
  **不补变量声明** → 必须在「前向声明区」手写 `extern bool chargeForceSlow;`（首次编译报 'was not declared'）。

### D14-10

- **反馈**：屏幕弹 3 秒提示（`FAST CHG` / `SLOW CHG`）；`/status` 增 `chgSlow` 字段便于远程核对。
- 网页「设备模式」卡片在慢充后追加 `(临时)` 标记（取 `/status` 的 `chgSlow`）。

## D15. 标定：充满判定、建表与使用

> **来源**：设计文档 V2.1.1 · 2.6（2026-09-17 搬入）

- **充满判定（100% 锚点）= BQ24074 停止给电池充电就是满**：条件 `PGOOD 低（有外部电源） && CHG 高（不在充电）`
  **持续 ≥ 5 分钟**，且 `battVolt ≥ 4.10V`（双保险：防“刚插上还没开始充”与“USB 电流不足根本没充起来”两种误判）。
- `V_100` **不写死 4.2V**，**每次充满都重设**（自适应温度 / 老化）；写入前**强制单调**（`V_100` 必须 ≥ 表内 99% 点，
  否则沿用旧值），防止“100% 比 99% 还低”的跳变。
  > ⚠️ **取法已更正**：原稿“取拔掉充电器后静置 2~5 分钟测得的电压”作废 → 直接取**满电停充、电池侧无电流**时的电压
  > （= 电芯静置电压，与其余采样点同为静置态），用不着拔电再等（见 2.8 表②）。
- **建表**：由样本生成 **21 点单调表**（每 5% 一个电压）`pct[k] = V_rest(t = k% × T_total)`；**强制单调递减**（去噪，防查表跳变）。
  0% 取「掉电前最后一次成功落盘的 `V_rest`」（略偏乐观，即会在真·关机前一点点先显 0%，安全方向）。
  > ⚠ **表内顺序（务必一致）**：`calPctV[0]` = 0%（最低电压）… `calPctV[20]` = 100%，**电压随下标单调递增**；
  > 2026-09-16 因这点写错过一次查表循环（按递减写 → 区间内恒返回 0%，见 **D9 ⑥**）。
- **存档**：表存 `/battcal.json`（含标定日期 / 负载 / 样本数 / `V_100`），**并备份旧表到 `/battcal.prev.json`**（可回滚）。
- **运行时线性插值**得 `battPct`；样本不足（如 < 20 行）→ **不建表**，保留原线性估算并报错。

## D16. 标定：流程与交互实现（设备隐身）

> **来源**：设计文档 V2.1.1 · 2.8（2026-09-17 搬入；流程表/原则留原文）

- **停掉 HTTP 服务**（`server.stop()`）：原 IP 直接连不上 → 已达成“找不到设备”。
  **不需要另设一个 IP** —— 服务都停了，换 IP 只是多一个变量（静态 IP 是用户配的，改来改去反而增加风险）。
- **WiFi 保持关联**（它就是负载的一部分，也保证负载与“WiFi 开”这一典型工况一致）。
- ⚠️ **标定期间不记录数据**：停采样、停写 `/log.csv`、停归档、停蓝牙。
  数据缺口由 `/battcal.csv` 的头尾时间戳说明；`/log.csv` 时间轴上的跳跃即“标定时段”。
- **调试留痕照写**：日志仍落 `/cfgdbg.log`，恢复联网后可从网页翻（标定失败时唯一的排查线索）。
- **中止**：长按 IO9 = 立即中止（恢复 HTTP + 记录 + 常规策略）；**插电（插回充电器）同样中止**。
  注意“拔电”不是中止条件而是开始条件（待放电态等到外部电源断开才开跑）。
  代码依据：`serviceCal()` 里加载/静置两段各一句 `if (!calDry && isExternallyPowered()) calAbort("检测到插电")`。
- **待放电 → 立即开跑**：检测到外部电源断开 → 立即开始第一个加载段（不等静置）；`V_100` 在准备阶段已取好（见 D15）。
- **网页按钮灰显**：`/battcal/status` 增 `canStart`/`canStartDry`/`why`/`whyDry`；页面每 3s 轮询 → 条件不满足时「开始」按钮
  **disabled（灰）**，下方直接写出**缺什么**（如“满电需保持 5 分钟（已 2分10秒）”）；干跑按钮单独判据（只要移动 + INA 在线）。
  服务端 `calStart()` 仍二次校验（与网页**同一函数** `calStartCheck()`）→ 就算客户端被绕过/乱点也无害；「立即中止」在非运行态也灰显。
  验证：切固定 → `canStart=false` + 原因正确 ✓。
  > 路由清单见 **D13-3**；本节只补 `canStart`/`canStartDry`/`why`/`whyDry` 这组灰显字段。

## D17. 顶栏即时反馈（V2.1.1-c，2026-09-15）

> **来源**：设计文档 V2.1.1 · 三（2026-09-17 搬入；问题/根因留原文）

**做法：边沿触发 + 值变化检测，全部只读、不阻塞**

| 触发 | 判据 | 检查频率 | 反馈延迟 |
|---|---|---|---|
| 插拔 | `PGOOD`(IO2) GPIO 电平变化 | loop 每圈（µs 级） | ≤ 1 圈（ms 级） |
| 充电中 | `CHG` GPIO 电平变化 | loop 每圈 | ≤ 1 圈 |
| 无线图标 | `WiFi.status()` / AP 态变化 | 每 5 s | ≤ 5 s |
| 电量% / CC·CV | INA226 新读数与**屏上不同** | 每 5 s | ≤ 5 s |
| 时间 HH:MM | 分钟变化 | 每 5 s | ≤ 5 s |

- 插拔后额外 **+800 ms 补刷一次**：等电流/CC·CV 稳一下再读 INA226。
- **不碰采样、不写 SD、全程无阻塞**：每圈只多 2 次 `digitalRead`；每 5 s 多一次 INA226 读（~1ms，占空 0.02%）。
  数据采集节奏（:00/:30 对齐、SD 写入）**完全不变** —— 这是底线。
- **省电无回归**：只有“屏上真的会变的量”才刷 → 电池放电时仍约 **1 次/分钟**（与原“整分钟刷”同量级）；插电时才 5s 检查一次。
- **顺带更跟手**：拔插/值变化时也调 `applyChargeStrategy()`（幂等）→ 固定 80% 停充、移动临时慢充复位都即时生效。
- **标定期间不跑**（loop 开头就 return 交给 `serviceCal`）✓
- 可观测：`/status` 的 `topRefresh`（顶栏重画计数）+ 日志 `🔌 顶栏即时刷新：插电 / 拔电(转电池)`。

**实测（2026-09-15）**：开机“未知→插电”边沿即时触发（`topRefresh` 1→2）；5s 轮询在 72s 内因“分钟变化”刷 1 次
（3→4，无额外刷新）✓；`tools/screen-check.mjs` **6/6 通过**（顶栏 ink=1021、标签 1261 点均不变）。
**用户上机实测（2026-09-15）：拔插切换即时、体验“好多了”，判定通过 ✓**。

## D18. 多组 WiFi 存储与自动选最强（2026-09-13）

> **来源**：README §六 · 第 11 条（2026-09-17 搬入）

- **存储**：`/wifi.json` 存 `{"list":[...]}`（最多 5 组）；旧单组格式开机自动升级，**升级前先备份到 `/wifi.old.json`**。
- **选网**：启动与断线重连时扫描，**只在已保存的组里挑 RSSI 最强**（一个都扫不到时，单组就直接试）。
- **页面 / 接口**：`/wifi` 列出/增删/复制附近网络；`/wifi-scan` 返回扫描列表（同名只留最强）；`/wifi-reconnect` 手动重挑；
  `/status` 增 `wifiCount` / `wifiSsid` / `wifiRssi` / `caps`。自检：`node tools/wifi-check.mjs <ip>`（15 项）。
- ⚠️ **教训①（键名不兼容）**：升级旧格式时把密码键 `password` 读成了 `pass`，导致设备丢密码。
  已修：两个键都认 + 升级前先备份。
- ⚠️ **教训②（缓存没刷新，实测）**：保存后 `wifiCfg` 没刷新 → 自动重连、“重新选择并连接”、loop 60 秒重试**全在用旧凭据**；
  用户实测表现为“保存后不重连，必须按 EN”（装壳后按不到 EN 键 → 必须修）。
  现 `wifiSyncCurrent()` 在增删后刷新当前组（优先保持已连上的）并打日志。
- ⚠️ **教训③（参数缺失被当成关闭，实测）**：`/save-wifi` 缺 `useIP` 参数时被当成“关闭静态IP” → 设备一重启就跳 DHCP（.99 → .128）；
  现“参数缺失 = 不改动地址方式”，页面复选框改下拉（总会提交），`/status` 加 `ip` 便于自检。

## D19. 手动归档下线 · `/download` 内存缓冲 · 术语改名（2026-09-17）

> **来源**：README §十五 ①③④（2026-09-17 搬入）

**① 手动归档下线**

- 缘由：下载 CSV 已能代替手动落盘；“先在网页点一下、再拔卡”的流程别扭（用户拍板）。
- 删除：网页按钮、`doManualArchive()`、`/archive-manual` 端点、`_manual` 图例。
- 保留：**自动归档**（每天 02:00）+ 低电存档（阈值见 **D3**，`archiveToSD(false)`）。
- 残留：内部 `isManual` / `manualSuffix` 形参仍在（已无调用者，无害死代码）。
- 实体「存档」按钮降级为想法（非待办）→ 设计文档 **附录 α · 9**。

**③ `/download` 默认吐内存环形缓冲**

- 起因：用户反馈下载到手是旧数据 → 查证 `/log.csv` **自 09-12 22:52 起停止增长**（文件冻结），而网页图表（走内存缓冲）一直最新 → 两者不一致。
- 现状：`/download`（不带 `f=`）= 内存缓冲实时生成 CSV（序号/时间/温度/湿度/气压/模式；**模式列暂为 `-`**）；Flash 文件仍可 `/download?f=/log.csv` 取（白名单不变）。
- **根因未定**：已排除 `fileBusy` 泄漏；已加**写失败告警** `warnAppendFail()`（首次失败才提示，提示语点名“`/log.csv` 会停在旧数据，可能文件系统满/损坏”）→ 下次跑起来看日志即可定位。
- 内存缓冲窗口：600 条 × 30min ≈ **12.5 天**（重启后从 Flash 重新加载）。

**④ 术语「驻场」→「固定」**（commit 1331003）

- 174 处（`.ino` / `README` / `ui_display.h` / 设计文档），词元同步 `SITE_*` → `FIX_*`、顶栏 `SITE` → `FIX`。
- 编译产物大小与改名前一致 = 纯文本改名；`/log.csv` 的模式列本来就写数字 0/1（不受影响）。

---

## D20. V2.1.1 归纳：IO9 快慢充 · 实现顺序 · 本轮改动 · 待做项

> **来源**：设计文档 V2.1.1（2026-09-17 搬入）。原「EEEE…FFFF」草稿块按本节搬运并去重：
> 块内与新版 V2.1.1 章节重复的草稿（一/二/三/四 与 5.5）已删，只留此处一份。
> **本节含两半**：D20-1~3 = 已实现细节；**D20-4~5 = 计划中细节（待做项方案与论证）**。
> 设计文档那边只留一眼能看完的简表与待办名。

### D20-1 IO9 按钮（V2.1.1-a）：移动 + 插电 → 切快/慢充

- 只给「移动 + 插电」这一个组合附加新语义；固定（本就慢充，切了没意义）与移动+电池（开无线，沿用 V2.1）不变。
- 按键逻辑与开 WiFi **完全一致** → **D14-7**；不持久化 → **D14-2**；复位条件（断电即复位 / 换模式也复位）→ **D14-8**；
  踩坑（`extern bool chargeForceSlow` 前向声明）→ **D14-9**；反馈（`FAST CHG` / `SLOW CHG` + `/status` 的 `chgSlow`、网页 `(临时)` 标记）→ **D14-10**。
- 移动模式 CE 恒低（允许充电），所以切档始终有效；固定分支不受影响。

### D20-2 与既有小节的对应（避免重复）

V2.1.1 的标定与顶栏两块**实现细节已在本文档**，本节只记归属，不重抄：

| 设计文档位置 | 细节在本文档 |
|---|---|
| 电量校准引言（AVG 窗口 / 静置不关 WiFi / CSV 列 / 干跑 / 路由 / 原型坑 / 三档上移） | **D11、D12、D13-1~D13-7、D15、D16** |
| 电量校准 2.4 / 2.5 / 2.6 / 2.8 | **D11 / D12 / D15 / D16** |
| 顶栏即时反馈（V2.1.1-c）的边沿触发、实测 | **D17** |
| 连接策略与连网会话（含 IO9 → 开 WiFi 的 STA 优先 / 失败转 AP） | **D14-3~D14-6**、**D18** |

### D20-3 V2.1.1 实现顺序

1. **V2.1.1-a**：IO9 快/慢充
2. **V2.1.1-b**：电量校准
3. **V2.1.1-c**：顶栏即时反馈
4. **连带项**：低电三档阈值上移（设计文档 2.7 / 本文档 **D3**）

**先不做（留扩展点，记在设计文档附录 α）**：负载档位（高/中/低，先只做**高**档看效果）、内阻补偿（数据已在存，届时再算）、
静置期轻睡（若 60s 静置误差偏大再加）、离线图表工具。

> 各项做到哪一步 → 看 [`README.md`](README.md) **状态总表**（唯一状态源）。

### D20-4 本轮改动台账（2026-09-16 ~ 17，V2.1.1 开发时段内）

- **术语统一**：驻场 → **固定**（含 `SITE`→`FIX` 词元，顶栏 `MOV⇄FIX`），共 174 处、纯文本改名（commit `1331003`）→ 见 **D19 ④**。
- **移除「手动归档」**：网页按钮 / `doManualArchive()` / `/archive-manual` / `_manual` 图例全删（**保留自动归档 + 低电存档**）。
  理由：下载 CSV 已可替代 + “先网页后拔卡”别扭。原计划的实体「存档」按钮**降级为想法**（附录 α · 9）→ 见 **D19 ①**。
- **`/download` 口径改为内存环形缓冲**（永远最新）；Flash 文件改走 `?f=/log.csv`。
  起因：`/log.csv` 自 09-12 22:52 起**静默停止增长** → 见 **D19 ③**。
- **Flash 写失败不再静默**：新增 `warnAppendFail()`（首次失败即告警，提示“可能文件系统满/损坏”）。根因待查 → 见 **D19 ③**。
- 相关状态见 `README.md` 状态总表 #12 / #13 / #17。

### D20-5 待做项（计划细节：方案 · 根因 · 实测 · 验收）

> 设计文档 **V2.1.1 · 待做** 只列一行待办名 + 指向本节；推演与数据全在这里。

#### ① 网页响应抖动（`/status` 偶发 0.4~5s）

- **现象**：`/status` 间歇要 0.4~5s；157 字节的 `/battcal/status` 也要 1s。
- **疑因**：ESP32 **默认 WiFi modem sleep**（代码里没有任何 `WiFi.setSleep` 调用）＋ 偶发阻塞式 Flash 写。
- **方向**：先在**连网会话期间**试关睡眠（会话本来就短，耗电可接受）；这与 README 状态总表 **#14 省电四步**里
  “无线开着时用 modem sleep”是同一件事的两面 —— 先量默认睡眠对延迟的影响，再决定会话期是否强制关。
- **状态**：待测。

#### ② 【待修】今日极值 / 距平曲线：只统计“本次开机以来”的数据

- **现象**：`/today-stats` 的「🏆 今日极值」（温/湿/压 max·min）与「📈 今日气压距平曲线」的 1 分钟槽，
  **只含本次开机之后的采样点** —— 当天重启前已经采到的数据不算进去。
- **根因**（`PHT_2_X.ino`）：
  - `todayExt` / `todaySlots` 只在**实时采样路径**里更新（3553~3558：槽累积 + `updateExtreme()`）；
  - 开机时的 `loadBufferFromFlash()`（1843）只把 `/log.csv` 尾部 `KEEP_IN_MEMORY = 600` 条
    （30s 间隔 → **仅 5 小时**）灌进 RAM 环形缓冲，**只供图表 / 历史页渲染**，没有回灌到极值/槽；
  - 于是 OTA、掉电、长按复位之后，当天已过去的极值全丢 —— 开发期 OTA 频繁，特别明显。
- **修法（建议）**：
  1. 把「采样点 → 今日统计」抽成一个函数（如 `feedTodaySample(uint32_t t, float tC, float h, float p)`，
     内部就是现在的槽累积 + `updateExtreme()`），实时采样改调它（**行为不变**）；
  2. 开机初始化里，在 `initAvgEngine()` 与「跨天重置」（见 1687「跨天：存档昨天 → 更新滑动窗口 → 重置今日」）
     **都完成之后**，单独扫一遍**整个 /log.csv**（不能只扫 RAM 那 600 条 —— 覆盖不了“今天”），
     按时间顺序把**属于今天**的记录喂给同一个函数：
     - 判定“今天” = 记录时间戳的本地日期 == 今天（CSV 第 2 列就是 `YYYY-MM-DD HH:MM:SS`，已用 `strptime` 解析）；
     - 成本：一次线性扫描（几千行 ≈ 几十 ms），只在开机做一次，**不碰采样节奏、不写 SD**。
  3. 顺带核查**今日平均 / 距平基线的“今天”那一侧**是否同样只有开机后的数据（同一处一起修）。
- **边界**：
  - 与跨天归档（`archivedDay`，1524「📦 今日已自动归档，跳过」）的**先后顺序**要对：
    归档只该跳过“已经归档过的那一天”，别把归档后的数据又喂回极值；
  - CSV 若已被归档/截断，回灌自然也只剩剩余部分 → 建议把「已采槽数」显示到网页
    （`/today-stats` 已有 `slots`/`days` 字段，见 2211/2213），让覆盖是否完整一眼可见。
- **验收**：
  1. 白天正常跑一段（产生极值）→ **OTA/复位** → `/today-stats` 的极值与重启前**一致**（不因重启而“漂移/变小”）；
  2. 「今日距平曲线」重启后**左半边不空白**；
  3. `tools/screen-check.mjs` 等自检仍全绿。

#### ③ 【计划·硬件】换 LDO：SPX3819 → RT9013-33B（2026-09-16 暂缓）

- ⚠️ **暂缓理由**：换完要重定低电三档 + 重标曲线，而现在“崩得早”的原因**不在 LDO 本身**：
  ① 标定负载只有 130mA，**比日常峰值小**（大电流尖峰时会提前崩）；
  ② 先前那个 3.4V 很可能测自**最早一批板** —— 该板 LDO 输出端电容疑为 **Y5V**（容值随偏压/温度衰减大 → 低压差瞬态更差），
  而 09-16 跑标定的这块可能是 **X5R**（容量保持好）→ 顶到 **2.945V** 才收工。
  → 根本问题是**板间不一致**（见 ④）；等硬件统一 + 重测崩溃点后再定。
- **动机**：现有 SPX3819 低压差差 → 电池放到 ~3.4V 就撑不住 3.3V 轨，设备**硬掉电**
  （三档保护只能上移到 3.6/3.55/3.5V 迁就它，等于白丢 0.1~0.2V 可用区间）。
- **数据（用户实测 + 手册）**：

  | 器件 | 100mA 稳定输出所需 dropout | 备注 |
  |---|---|---|
  | SPX3819（现） | **180 mV** | 实测崩溃点 **3.4V** ⇔ dropout 100mV → 此时 SPX3819 **只保证 25mA** |
  | **RT9013-33B（计划）** | **50 mV** | 同一个 100mV 余量下能给出的电流远大于 25mA |

- **预期收益**：3.3V 轨能在更低的电池电压下稳住 → **崩溃点下移**（估 50~100mV，**低负载受益更大**：
  移动+电池 idle ≈30mA 时 dropout 更小）。等价于多榨出约 **0.05~0.1V** 可用区间。
- **换完必做三件事（别漏）**：
  1. **实测新崩溃点**：同法逐步放电记录；注意**与负载相关**（移动 idle ~30mA 与标定加载 130mA 的崩溃点不同）
     → 按**最坏负载**取值。
  2. **重定低电三档**：现在的 3.6/3.55/3.5V 是按“崩溃点 ~3.4V + 余量”定的 →
     换成“**新崩溃点 + 余量（≥50mV）**”整体下移，保持 0.05V 间距；同步改设计文档 **§2.7** 与 README 状态总表 **#6**。
  3. **重跑一次电量标定**：表的 **0% 端 = LDO 崩溃点**，LDO 一换这个点就变 → 旧表作废（回滚有 `/battcal.prev.json`）。
- **顺带核对**：① 封装/pin 兼容性；② 新 LDO 的**静态电流**（影响移动待机基线 ~30mA，见设计文档 §2.3 负载设计）；
  ③ 与 **V2.2 电源多路复用器**（原 α「MOS 旁路 LDO」，把可用下限压到 ~3.0V）的关系 ——
  换 LDO 是**低成本一步**，多路复用器更彻底，两者可叠加。

#### ④ 【待办·方案】低电三档改成“跟着本机表走”，不再按最差板定（用户 2026-09-16 定调）

- **用户观点**：没必要按最差板 —— **每个设备标的是自己那块电池**。
- **方案（待确认）**：三档阈值不再用固定常数，改成**从本机曲线表里取**：
  - `深睡` = 表中 **5%** 的电压 − 余量（余量取日常峰值 IR 跌 50~100mV）
  - `停采` = 表中 **10%** 的电压
  - `存档` = 表中 **15%** 的电压
  → 换 LDO / 换电容 / 板间差异 **自动被本机曲线吸收** ✓，也不用再统计“最差板”。
- **前提（硬规则）**：曲线表必须是**本机自己跑出来的**，不允许拷贝别台的 `/battcal.json`。
- **现值对照（首跑实测，见 D9 ⑦③）**：深睡 = 表 5% 电压(3.635) − 余量 0.1 = **3.54V** ≈ 现值 3.5V ✓；
  停采 ≈ 3.61V ≈ 现值 3.55V ✓；存档 ≈ 3.65V ≈ 现值 3.6V ✓
  → **现值 ≈ “5/10/15% × 本机表 − 100mV”，两种口径互相印证** ✓
  → 改造只是把它**自动化、按台适配**，不是为了多榨电量。
- **硬件侧仍要做**（与阈值解耦，属于“一致性/寿命”而非“保护正确性”）：
  1. 确认各批 LDO 输出端电容型号（**Y5V 容值随偏压/温度衰减可达 −60~80%**）→ 统一换 **X5R**；
  2. 换完重测崩溃点（idle ~30mA 与标定 130mA 两种负载各测，取最坏值）作为本机表 0% 端的校验。

#### ⑤ 给网页加 logo（待实装）

- 网页交互项，尚无实装记录；设计文档 V2.1.1 · 软件 · 交互和可视化 已列。

---

## D21. V2.2 硬件规划：电源多路复用器 TPS2117 · 换 LDO RT9013 · 接线更改

> **来源**：设计文档 V2.2 · 硬件（2026-09-17 搬入）。原「EEEE…FFFF」块（V2.2 章内）按本节归纳，
> 块内的两个硬件项在此合并留档；**V2.2 尚未开始开发**，本节全属**计划中细节**，方案为暂定。

### D21-1 电源多路复用器（Power MUX）TPS2117

- **目的**：新增一颗**电源多路复用器**统一管理供电通路；原附录 α「低压时用 MOS 旁路 LDO」要干的就是这件事，
  **该想法已并入本项**（不再单列）。
- **背景**：现有 LDO = SPX3819（把 BQ24074 输出稳压到 3.3V）；实测电池 **<~3.4V 时低压差输出能力暴跌 → 设备硬掉电**
  （设计文档 2.7），可用区间被白白砍掉 0.1~0.2V。
- **待定（后续补）**：型号 / 通道数、切换阈值与滞回、静态电流与导通电阻、
  与 BQ24074（充电）+ IO17/IO18（CE#/ISET）控制的关系、低电三档是否随之调整。
- **与换 LDO 的关系**：换 LDO 是低成本一步，多路复用器（旁路/切换）更彻底，两者可叠加
  （换 LDO 的完整论证与换完必做三件事 → **D20-5 ③**）。

### D21-2 换 LDO：SPX3819 → RT9013-33B

- **动机**：RT9013-33B 用于获取**更好的低压差供电可靠性**。现有 LDO 为 SPX3819，dropout 低时输出能力暴跌
  —— dropout 为 100mV 时输出能力**仅 25 毫安**；而 RT9013 的输出能力和 dropout 的关系**更为线性**，更适合锂电池供电。
- **完整论证、两器件 dropout 对照表、预期收益（崩溃点下移 50~100mV）、换完必做三件事**（实测新崩溃点 /
  重定低电三档 / 重跑标定）→ 见 **D20-5 ③**（换 LDO 同时是 V2.1.1 的待做项，两处同一件事，不再各留一份）。

### D21-3 接线更改（V2.2 计划）

**ESP32**

1. SD 卡 SPI 改为：

   | 信号 | 引脚 |
   |---|---|
   | SCK | IO1 |
   | CS | IO2 |
   | MISO | IO6 |
   | MOSI | IO7 |

2. 屏幕 SPI 总线更改为：

   | 信号 | 引脚 |
   |---|---|
   | CS | IO42 |
   | DC | IO41 |
   | RES | IO40 |
   | SDI | IO39 |
   | SCK | IO38 |

3. 其他更改：

   | 引脚 | 接到 | 用途 |
   |---|---|---|
   | IO10 | BQ24074@CE | 充电使能（软件停充/放充） |
   | IO11 | TPS2117@PR1 | **在 LDO 与电池之间切换** |
   | IO12 | BQ24074@CHG | 充电中检测 |
   | IO13 | BQ24074@PGOOD | 外部电源检测 |
   | IO14 | BQ24074@EN1 | 与 IO21 一起选充电模式 |
   | IO21 | BQ24074@EN2 | 在 **USB100 / USB500 / ISET** 之间切换 |

**供电和电源管理**

1. 新增电源多路复用器 TPS2117
   - PR1 引脚连接 ESP32@GPIO11，**切换电池和 LDO**。

> **本章其余硬件与软件改动待补**，上述方案为**暂定**，尚未完全确定。

> 📌 **引脚提醒**：本表为**暂定**，待 PCB 画完才算数（V2.2 章已注明）。
> 与设计文档**附录 A**（N16R8 **不可用**引脚清单）合看即可 —— 附录 A 只列用不了的脚，
> **当前占用** 见设计文档 **V2.1 · 硬件 · ESP32接线**（本次重排会动到 IO10~IO14 / IO15·IO16 / IO17·IO18 这一整组）。

---

## D22. V2.1 归纳：连接策略演化（被取代原文）· 充电/INA226 补遗 · 屏幕横幅规格

> **来源**：设计文档 V2.1（2026-09-17 搬入）。该章原先把「规格 / 实现细节 / 被取代的历史原文 / 踩坑复盘」
> 混在一起（约 240 行）→ 现按职责拆开：**规格与决策留设计文档**，细节与本归档进本节。
> 相关内容既已在别处的，本节只记归属（见 D22-1 表），**不重复**。

### D22-1 先看归属（V2.1 各细节现在在哪）

| V2.1 里的内容 | 细节在本文档 |
|---|---|
| 充电底层原语 / 模式联动 / 80% 滞回 / 停充逻辑 | **D1** |
| 气压距平与日平均基线 | **D2** |
| 低电三档（3.6/3.55/3.5V）与深睡 | **D3** |
| 蓝牙三批实装（已搁置） | **D4** |
| 屏幕布局 / toast 版面与时机 | **D6、D8** |
| 多组 WiFi 与自动选最强 | **D18** |
| 连网会话流程（触发/失败/空闲回收）与静态 IP | **D14-1~D14-6** |
| 飞线过程、引脚冲突实测、软件同步项 | 设计文档原 附录 A.4~A.6 → 本文档 **D24-1**；不可用引脚清单仍在设计文档**附录 A** |
| V2.1 无线策略的现行语义 | 设计文档 **无线策略与静态 IP（现行）**；决策留档 → **D24-4** |

### D22-2 充电硬件小项（V2.1 原文保留）

- **Q1 栅极为无下拉设计**（ISET 切换 MOS）：上电至 `setup()` 执行的几十毫秒内处于悬空态。
  但 ISET 节点电压低（≈1.2V）不足以经 Cgd 耦合到 Vgs(th)≈1.4V，实测无异常导通；
  且即便意外导通，也有 1kΩ 电阻兜底（最大 ~890mA，0.5C）→ **安全可接受**。下版 PCB 建议补 100kΩ 栅极对地下拉
  （想法池见设计文档附录 α · 7）。
- **温度检测（TS）**：电池不带内置 NTC（1800mAh 电芯无内部温度引出），TS 引脚用**固定 10kΩ 电阻**到地替代，
  相当于跳过温度检测、让 BQ24074 认定温度正常，不触发过温/欠温保护。
  若未来更换带内部 NTC 的电池，把固定电阻换成对应阻值 NTC 接入 TS 即可恢复温度监测。
- **CE 停充的边界**：CE 拉高只停充电，**不断电池补充（UPS）通路**；BQ 有 recharge 硬件机制，
  电压降到约 4.0V 会自动重新充电 → 固定模式实际是「80% 左右浮充」而非精确停在 80%（判定与滞回见 **D1**）。

### D22-3 INA226 测量细节补遗（V2.1 原文保留）

- **采样电阻压降不干扰充电终止判定**：10mΩ 在 1A 时仅 10mV，远小于 BQ24074 自身约 ±40mV 的充电终止电压精度；
  该电阻串在充放共用回路上，**天然双向**（充电为正、放电为负）。
- **接法与极性**：高边跨接在 `BQ24074@BAT` 与电池正极之间，VIN+ 靠 BQ 侧、VIN- 靠电池侧；
  **VBUS 接 VIN-（电池侧）** → 电压通道读到的是电池**真实对地电压**（这也是「免校准、免逐台标定」的由来）。
- **电流通道的用途限制**：只测充电回路电流；ESP32 自身工作电流跳变剧烈，**不作功耗显示依据**。
- **CV 区判定的门限理由**：判定式 `充电中(CHG低) + 电池电压≥4.05V + |电流| < 设定值×60%`，
  设定值由 `chargeSetpoint_mA()` 按当前档位动态给出；**加电压门限是为了避免 USB100 低电流模式下的误判**。
- 屏幕与网页的 CC/CV **同源**：均取 INA226 的 `cvZone` 判定（2026-09-13 已统一，屏幕端电压近似已删除）。
- **INA226 离线兜底**：离线时电池电压视为**未知**，**不得**按 0V 处理（否则误触发低电三档、开机即深睡）；
  此时低电门控与电量估算**整体作废**（不判低电、不深睡、不显电量），屏幕与网页改显`INA226 离线`告警 ——
  低电保护**仅在 INA226 正常时生效**（三档数值见 **D3**，屏幕呈现见 **D6**）。

### D22-4 连接策略的演化（被取代的原文，历史留档）

> 下列为 V2.1 早期（2026-09-13 前后）的设计文本，**已被后续决策取代**；现行语义以设计文档
> 设计文档 **无线策略与静态 IP（现行）** 为准，实装流程见 **D14-3~D14-6**。保留在此仅为追溯设计过程，**不要照此实现**。

**① 配网逻辑（早期）**

- 配网仅是**完整版 WiFi 网页里的一个按钮**，点击后输入 WiFi 信息。
- 点确认后**只写入 Flash，不立即连接**，屏幕显示「已保存」。
- 之后按场景决定连接：插电 → 提示「即将重启连接」，重启后连 WiFi；不插电（移动+电池）→ 等用户按下实体 WiFi 按钮再扫描连接。
  > 现行：**保存即切 WiFi 连接**，「20 秒后重启」方案作废（**D14-4**）。

**② 实体 WiFi 按钮语义（早期，2026-09-13 修订）**

- 插电 / 固定：按钮**完全无效**（那时本来就该 WiFi/AP；动了只会让用户疑惑「网页怎么打不开」）。
- 移动 + 电池：**长按 ≥1.5 秒**才生效 → 扫描并连「已保存且扫到的最强」；连不上只报错**回蓝牙，绝不自动开热点**。
- 触发后同样进入「连网会话」，无人看网页 **60 秒自动回蓝牙**。
  > 现行：失败改为**直接开 AP 配网热点**（带 `AP_SESSION_MS` = 10 分钟超时）；回收对象由「回蓝牙」变为「关掉无线」
  > （**D14-5、D14-6**，语义见设计文档 **无线策略与静态 IP（现行）**）。

**③ 「首次配网 / 未配网兜底」（早期）**

- 固定 + 插电、未配网 → 开 AP，让用户配网。
- 移动 + 电池、未配网 → 只能蓝牙连接，「爱配不配」，配网后需用户自行按实体 WiFi 按钮开启。
  > 现行：移动 + 电池未配网 → **开 AP 热点配网**（设计文档 **无线策略与静态 IP（现行）**）。

**④ 提示时机说明（早期）**

- 失败提示应在**蓝牙成功重新开启之后**再显示，保证提示与实际状态一致，用户在提示出现时执行即为有效，无需感知蓝牙恢复耗时。
  > 现行：蓝牙已搁置 → 该时序约束**作废**；失败横幅直接弹，随后自动接热点页（**D14-5**）。

**⑤ 顶栏第 4 档无线图标（蓝牙）**

- 设计意图：蓝牙图标区分「广播中 / 已连接」，并支持**只刷新图标那一小块**。
- 实装状态（2026-09-15）：第 4 档**已实装但为简化版** —— 直接画小写 `bt` 文字（非点阵图标）；
  BLE 搁置后**不会显示**；「只刷图标那一小块」**未做**，随搁置一并挂起（屏幕四档见 **D6**）。

### D22-5 屏幕横幅（toast）规格原文（V2.1 无线）

> 版面与时机见 **D8**；这里留 V2.1 原文的具体文案与时长，便于逐字核对。

**连接成功** → 关蓝牙后弹提示横幅：**√ WiFi OK / SSID xxx / 192.168.x.x**（20 秒后自动还原为数据页），
用户按提示访问网页。（2026-09-13 已实装横幅，英文 + 符号；**蓝牙推送部分已随搁置作废**）

**连接失败** → 先弹 **× WiFi FAIL / SSID "xxx" / not connected**（10 秒，**不给 IP**，
避免用户误以为已连上去访问）；到期后**自动接上**热点页：
**(热点图标) AP MODE / SSID "Weather_Station_Pro" / 192.168.5.1**（20 秒）。

**按下实体按钮后的完整反馈流程（原文，蓝牙环节已作废）**：

```
→ 立即关蓝牙
→ 屏幕显示："蓝牙已关闭，尝试连接WiFi"
→ 扫描并尝试连接
    ├─ 成功 → 屏幕横幅：√ WiFi OK / SSID xxx / 192.168.x.x     （20s）
    │        → 用户根据SSID判断（自己的网络则连，热点则直接开浏览器输IP）访问网页
    └─ 失败 → 屏幕横幅：× WiFi FAIL / SSID "xxx" / not connected（10s，不给 IP）
              → 到期自动接上热点页：(热点图标) AP MODE / SSID "Weather_Station_Pro" / 192.168.5.1
              → （蓝牙重开后的提示**已随搁置作废**）
```

**连接成功指路**：连接成功后屏幕显示 IP 与 WiFi 名称，用户照提示打开浏览器访问该 IP，
网页打开后自动切换到数据显示页。

---

## D23. 三要素 24h 变率（整点环 · 屏幕箭头 · 网页显示）

> **来源**：设计文档 V2.0 · 24h变率（2026-09-17 搬入；原「DDDD…CCCC」块）。
> 屏幕版面参数另见 **D6**；本文档补齐规格、代码落点与实测口径。

### D23-1 规格（原文保留）

对**温度、湿度、气压三要素**各给出一个 24h 变率（网页端「要素24h变率」的完整含义）。

> ⚠️ **2026-09-29 变更**：湿度那一档改用**绝对湿度**（单位 g/m³），不再用相对湿度 %。
> 公式与「三处统一口径」的约束见 **D25**；`hourRing` 仍存原始 T/RH，**环的结构未变**。

- **定义**：变率 = **当前整点值 − 24 小时前同一整点的值**。
- **更新粒度**：**整点更新，每小时一次**。变率只由整点采样计算；整点之间的时段沿用上一个整点的结果
  （屏幕上显示值不变）。
- **数据来源**：一块常驻 RAM 的 **24 槽环形缓冲**（下标 = 小时 0..23），槽内存放「上一个同整点」的三要素值。
  **不落盘** → 重启或彻底掉电后需**重新积累 24 小时**才有变率。
- **缺测处理**：任一要素无效时，该要素**当次不写入环**、变率视为无数据（屏幕不显示、网页显示 `--`），
  **不影响其他要素**。
- **显示**：
  - **屏幕**：显示在各数值行**右侧并右对齐**，格式为「箭头 + 绝对值」（**省略单位**，保留一位小数，如 `↑0.5`）。
    阈值 0.1：`Δ≥0.1` 记 `↑`，`Δ≤-0.1` 记 `↓`，其余记 `→`（平稳）。**无数据时该区域留空**。
  - **网页**：显示「图标 + 带符号数值」（保留两位小数），阈值同为 0.1。

### D23-2 代码落点（`PHT_2_X.ino` / `ui_display.h`）

| 项 | 位置 / 常量 |
|---|---|
| 整点环 | `HourSlot hourRing[24]` —— 下标 = 小时(0..23)，槽内存放「上一个同整点」的值（1470~1471） |
| 变率量 | `trendT24 / trendH24 / trendP24`（float，初值 `NAN` = 无数据）；**`trendH24` 单位 = g/m³（绝对湿度，2026-09-29 起）** |
| 整点更新 | 采样路径里独立于日平均引擎：整点那次采样时 `Δ = 现值 − hourRing[tm_hour].旧值`，随后把现值写回槽（3779~3790）；湿度用 `absHumidity()` 由槽内原始 T/RH 现算（**环结构未变**） |
| 送屏 | `uiDisplay.setTrend(dT24, dH24, dP24)`（3825），屏幕侧缓存于 `trendT/H/P` |
| 绘制 | `uiDisplay.h` 的 `drawTrend(rate, y)`，三行分别在 y = 24 / 56 / 88 |
| 版面常量 | `UI_TREND_RIGHT = 247`（右对齐基准）、`UI_TREND_TH = 0.1f`（阈值；湿度档改 AH(g/m³) 后仍沿用 0.1，规格未改） |
| 上报 | `/today-stats` 的 `trend24T / trend24H / trend24`（2420；**网页读这里** —— 本条此前误记为 `/status`，2026-09-29 实测更正） |
| 日志 | 整点算出后打 `🕐 整点变率 @HH:00  ΔT=.. ΔAH=.. ΔP=..`（湿度档改 AH 后同步改的字段名） |

### D23-3 与相关小节的边界

- **箭头是自绘**（三角头 + 杆），字库无此字符；↑↓ 占 11×18、→ 占 14×11 —— 版面细节见 **D6**。
- **气压行最紧**（`1013.5hPa` 宽 108px，与变率间只剩约 15px）→ **不要再往该行加内容**（D6）。
- 与**气压距平**（**D2**，按日平均基线算距平）是两回事：变率是**同一整点相隔 24h 的差**，不依赖日平均引擎。
- 历史：2026-09-10 新增三要素 24h 变率，同时**去掉了原 `press24h` 的 2880 槽 PSRAM 缓冲**
  （见 `README.md` §十四 时间线）。

---

## D24. 归档：引脚冲突实测 · BLE 铁律与崩溃取证 · BLE 搁置决策与连带项

> **来源**：设计文档原 附录 A.4~A.6 · 附录 B · 附录 C（2026-09-17 搬入）。
> 起因：附录 B/C 混装「已作废历史 + 现行策略 + 保命铁律」，附录 A 混装「引脚裁决 + 一次性工序」。
> 现按职责拆：**现役约定与引脚裁决留设计文档**（附录 A + 新增「无线策略与静态 IP（现行）」），
> **一次性工序、历史决策、复活 BLE 时的保命条**归档到本节。

### D24-1 引脚：IO35 冲突的实测与飞线（一次性工序，已完成）

- **为什么会有这事**：原理图原把 **IO35** 引为 `STA_SW`（WiFi 开关）—— 而 N16R8 是 **Octal PSRAM** 模组，
  IO35/36/37 已接内部 PSRAM。手册（ESP32-S3-WROOM-1/1U 规格书 v1.3）表 3 脚注 b 原话：
  「在集成 Octal SPI PSRAM（即内置芯片为 ESP32-S3R8 或 ESP32-S3R16V）的模组中，管脚 IO35、IO36、IO37
  已连接至模组内部集成的 Octal SPI PSRAM，**不可用于其他功能**」。
- **压测确认（`WORKS/PSRAM_Stress/`**：哨兵区 + 全池压测 + IO35 采样）**：上拉时看似正常**
  （PSRAM 强驱动压倒弱上拉，**不代表无冲突**）；**下拉（模拟按下）时才确认冲突** ✓
  → 教训：这类「强驱动 vs 弱上拉」的冲突，必须用**反向电平**去测才测得出来。
- **飞线方案（2026-09-15 完成并验证）**：① 割断 `IO35（脚28）→ STA_SW`；② 飞线接 `IO9（脚17）→ STA_SW`；
  ③ IO35 侧 4.7K 上拉拆除或悬空。
  - 注意：飞线尽量短、远离 PSRAM 高频区；IO9 在模组**底部一排**（与 IO35 不同边）需绕过转角；
    IO9 节点原分压电阻本版 PCB 已无。
- **软件同步项（✅ 全部完成）**：`#define PIN_WIFI_BTN 9` + `checkWifiButton()`（`INPUT_PULLUP`，未焊按钮也不误触发）
  已实装（2026-09-13），按钮 **2026-09-15 焊到 IO9 并验证可用**；
  IO9 电池分压回退代码（`PIN_BAT`/`BAT_CAL_K`/`BAT_CAL_B` + ADC 分支）**已删除** → 电池电压只认 INA226。

### D24-2 ⚠️ BLE 关闭铁律（血泪教训；**APP 阶段复活 BLE 前必读**）

> `BLEDevice::deinit()` 必须在**没有客户端连接**的情况下调用。

- 实测（core 3.3.11）：`BLEDevice::deinit(bool release_memory)` 的实现**忽略 `release_memory` 参数**，
  无条件 `delete m_pServer`。
- 若手机还连着就 deinit：NimBLE 事件任务随后派发的 `disconnect complete` 会去 `erase` 已释放的
  `std::map<uint16_t, conn_status_t>`（堆毒化值 `0xbaad5678`）→ `LoadProhibited` PANIC。
  backtrace 固定为：

  ```
  BLEServer::removePeerDevice        BLE/src/BLEServer.cpp:361
  BLEServer::handleGATTServerEvent   BLE/src/BLEServer.cpp:838
  ble_gap_rx_disconn_complete  ←  nimble_port_run  ←  BLEDevice::host_task
  ```

- **正确顺序**（`stopBLE()` 已按此实现，不要简化）：
  1. `bleStopping = true` + 清空自己的发送队列（此期间 `onDisconnect` **不得**重启广播）
  2. `srv->disconnect(id)`：id 取自 `srv->getPeerDevices(false)`（返回 `std::map`，**不是** vector）
  3. 轮询 `srv->getConnectedCount() == 0`，再 `delay(60)` 让协议栈把断开事件跑完
  4. 最后才 `BLEDevice::deinit(true)`
- 配套约束：`onDisconnect` 里的 `BLEDevice::startAdvertising()` 必须加 `if (!bleStopping)` 保护，
  否则会在 deinit 过程中重启广播（同一类崩溃）。

### D24-3 崩溃现场取证流程（crash 复用）

1. 串口抓 log：`Guru Meditation` 前后 + `Backtrace:` 一行。
2. 用工程编译产物的 elf 解码地址：

   ```
   D:\System\texts\Arduino\Arduino15\packages\esp32\tools\esp-x32\2601\bin\
     xtensa-esp32s3-elf-addr2line.exe -pfiaC -e <build>\PHT_2_X.ino.elf 0x420229dd 0x4202306d ...
   ```

3. 寄存器若出现 `0xbaad5678` / `EXCVADDR 0xbaad5688` → **访问已释放堆对象（use-after-free）**，
   优先怀疑「对象 delete 后还有晚到的回调/事件」。

### D24-4 BLE 搁置决策与连带项（历史留档，2026-09-14）

- **决策**：V2.1 的「蓝牙配网 + BLE 中继」整体**搁置**；代码用 `#if ENABLE_BLE` 包起来、
  `ENABLE_BLE` 默认 0，**不删除**；远期做 APP 时与 BLE 一起复活（见设计文档附录 α · 6）。
- **理由**：AP 热点配网 + 多组 WiFi 已存 + IO9 按钮这三件套已完整覆盖「配网」与「野外查看」；
  而 BLE 方案有三个硬伤 —— ① 中继页面是 HTML 文件、**无法「添加到主屏幕」**，不像 `http://设备IP/` 是真网址；
  ② 需要配套 APP 才有完整体验（现在不像产品）；③ 引入 NimBLE 生命周期风险（**D24-2**）。
- **实装状态（2026-09-15）**：`#define ENABLE_BLE 0`，BLE 相关代码（头文件/UUID/收发/回调）全部条件编译，
  `#else` 留空实现，`loop()` 与状态机零改动，停用时 `/wireless?force=ble` 被拒。
  **固件省 ~245KB**（1468379 → 1214259 字节）+ 全局变量省 ~2.7KB；`bleOn/bleLink` 保留且恒为 false。
- **连带项**：
  - 移除 NimBLE 同时**消除了「切 BLE→WiFi 随机 PANIC」的根因**
    （注意：与 **D24-2** 那个 100% 必现的 deinit 崩溃**不是同一个 bug**，后者已单独修好）。
  - 网页已删「📶 配网（WiFi）」蓝牙卡（卡片 HTML + 专有 JS + `caps.prov`）；
    WiFi 配网统一走系统卡「📶 WiFi设置」→ `/wifi` 完整配置页。
  - 有意保留的残留：`buildStatusJson(overBLE)` 死分支 + `bleStopping/bleHoldUntil`（清单见 `README.md` §十一）；
    顶栏无线图标 4 档保留（`bt` 档待 APP 阶段复用）；`/wireless?force=ble` 随条件编译停用。
  - IO9 按钮语义随之扩展：由「开 WiFi」变为「开无线（STA 优先，失败则 AP），N 分钟后自动关」。

### D24-5 蓝牙配网会话时序（V2.1 原文，已随搁置作废）

> 保留仅为追溯设计过程，**不要照此实现**（现行流程见 **D14-3~D14-6**）。

1. 手机在 BLE 页面填 SSID/密码 → `GET /wifi-connect?ssid=...`（经 BLE 中继到设备），
   登记到 `/cfgdbg.log`（网页 `/cfgdbg` 可查）。
2. **保持 BLE 不断**先 `WiFi.begin()`（典型 0.5~15s）；连上后立刻把 SSID/IP 推给手机页面
   （横幅转「已连上」，**可点击跳到局域网完整网页**）。
3. 2.5 秒后关闭蓝牙 → 回到纯 WiFi（记录/网页全部由设备提供）。

> 另（原文）：「**崩溃后网页还能打开**」的解释——崩溃 → 自动重启 → 启动时按 `wantWireless()` 重定模式：
> **插着 USB** → 走 WiFi，约 20s 后自动回到设备 IP（浏览器刷新即可）；**纯电池移动** → 走 WiFi 或全关
> （原文写「走蓝牙」，随搁置作废），手机/电脑都打不开。

---

## D25. 绝对湿度（AH）口径 · 湿度变率改 AH · 湿度图双轴曲线（2026-09-29）

> **来源**：设计文档 V2.1.1 · 交互和可视化 第 3 条（湿度变率改绝对湿度，早就立着）、
> 第 5 条（湿度图叠加 AH 曲线，用户 2026-09-29 提出）、· 🚧 待做 第 6 条（24h 变率改绝对湿度）。
> **三条一次收口。**

### D25-1 为什么要 AH

相对湿度(RH) **会随温度摆动**：温度升高 → 饱和水汽压上升 → RH 自动下降，**哪怕水汽一点没变**。
所以「湿度变率」用 RH 会把「温度引起的变化」误报成「水汽增减」。
绝对湿度(AH，水汽质量浓度 g/m³) 才是水汽的真实增减量。这也是两条曲线叠一张图的价值所在：
AH 平稳而 RH 在摆 = 纯温度效应；两条一起动才是真的水汽变化。

### D25-2 公式（**全项目唯一口径**）

```
es(T) = 6.112 · exp(17.67·T / (T + 243.5))          [hPa]   Magnus/Tetens 饱和水汽压
AH    = 216.7 · (RH/100) · es(T) / (T + 273.15)     [g/m³]  理想气体换算
```

- **落点**：`PHT_2_X.ino` 的 `float absHumidity(float tC, float rh)`（1453）。
- **调用点**：① 整点变率（3779~3790）② `/history` 序列化（2355）③ `/data` 序列化（2166）。
  ⚠️ **三处必须都调这个函数** —— 各自实现必然分叉，会出现「同一天同一个数在三个地方不一样」。
- **自检值**（离线复算）：T=25/RH=50 → 11.51；T=0/RH=100 → 4.85；T=30/RH=80 → 24.28；T=20/RH=100 → 17.27 g/m³。
- **实机复算**（2026-09-29，`/history` 取 8 点，设备 float vs 独立双精度）：**最大偏差 0.0045 g/m³**（float32 舍入量级）。
- 任一入参为 NaN → 返回 `NAN`，下游一律按「无数据」处理（**不造虚拟值**，与 D23 缺测口径一致）。

### D25-3 变率：湿度那一档改用 AH

- `trendH24` 由 `humidity − hs.h`（%RH）改为 `absHumidity(temp,humidity) − absHumidity(hs.t,hs.h)`（g/m³）。
- **`hourRing` 结构不变**：槽里仍存原始 T/RH，AH 是**读的时候现算** → 零额外 RAM、落盘格式不变。
- ⚠️ AH 依赖温度，所以现在**温度无效时湿度变率也会变空**（此前只看湿度）。
- **阈值仍沿用 `UI_TREND_TH = 0.1`**（规格未改）。注意 AH 的 24h 变化幅度通常 1~5 g/m³，
  0.1 的门限几乎总被判为「有变化」—— 与 RH 时代的表现一致，故未擅改；要更粗/更细需先改规格。
- ⚠️ **屏幕单位陷阱**：屏幕按 D23 规范**省略单位**，湿度行左侧数值是 `%RH`、右侧变率现在是 `g/m³`。
  同一行两个单位且都不标 —— 读数时要意识到这点（2026-09-29 决定保留「省略单位」的既有规格）。

### D25-4 网页：湿度图改成双 Y 轴

- `draw()` 由 `(canvas, labels, values, color, dayMarks)` 扩成 `(canvas, labels, series, dayMarks)`，
  `series = [{values, color, axis: 'l' 或 'r'}]`；**单序列调用与旧行为完全等价**（温度图、气压图未动）。
- 有右轴时右边距 `pr` 由 15 → 46（旧值放不下右轴标签）。
- **AH 由设备端下发**（`/history`、`/data` 每点新增 `ah` 字段），**网页不重写公式** —— 这就是「唯一口径」的落实方式。
  载荷代价：约 +11 B/点（`ah` 保留两位小数）。
- 前端**降级**：数据里没有 `ah`（例如连到旧固件）时，AH 序列整条不加，图自动退回单轴。
- 断点处理：某点为 `null` 时抬笔，下一个有效点重新起笔（不再跨断点连线）。
- 图例：湿度卡片下方一行「左轴 %RH（相对湿度）／右轴 g/m³（绝对湿度）」。

### D25-5 没做 / 待确认

- **CSV 不加 AH 列**：`/log.csv` 格式不动（AH 是派生量，`/history` 读 CSV 时现算）。
- **`trend24H` 字段名未改**（对外 JSON 字段名保持稳定），但**单位与含义已从 % 变为 g/m³**。
- **实机验证的边界**：变率只在**整点**计算、且需要环里有 24h 前的值 —— 设备 2026-09-29 22:41 重启，
  故 `trend24H` 要到 **2026-09-30 晚间**才有第一个真值；本次只验证到
  「同一函数的 `/history` 路径数值正确 + 三处调用点接线正确 + 网页文案/语法正确」。

---

## D26. 网页 logo · favicon · 主屏图标（iOS apple-touch-icon + Android manifest）（2026-09-29）

> **来源**：设计文档 V2.1.1 · 交互和可视化 第 2 条「新增网页logo」+ 🚧 待做 第 5 条「给网页加 logo」。
> 选型图纸：`WORKS/logo_storm_candidates.html`（雷暴母题 6 变体 × 88/32/16px，**仓库外**不污染本仓库）；
> 上一版（"屏幕 + 上升曲线"）的图纸在 `WORKS/logo_candidates.html`，保留备查。
>
> **改版理由（2026-09-29，同日内）**：用户反馈上一版「上升曲线 + 端点圆点」**看着像炒股软件** ——
> 那套图形语汇确实是行情软件图标。同时补上了关键背景：**本项目的初衷是捕获雷暴过境时的超压**。
> 于是母题从「记录仪」改为「**雷暴**」：画雷，也画被它顶起来的那一下**气压尖峰** ——
> 这才是本项目区别于任何天气 App 的地方。

### D26-1 母题：同一图形、两个复杂度

母题 = **雷暴：云 + 闪电 + 气压尖峰**，**同一母题、两个复杂度**（响应式 logo 的常规做法）：

- **页面内 logo = C 全要素（云 + 闪电 + 尖峰）** —— 把项目故事整条画出来：雷电劈下来，正好顶在气压尖峰上。
- **favicon = F 精简版（云 + 闪电，去掉尖峰）** —— **16px 下三个元素会互相挤成一团**，所以只留云和雷。
- **三色各有语义**：云 = 深板岩 `#34495e` ／ 闪电 = 琥珀 `#f39c12` ／ 气压尖峰 = 曲线绿 `#27ae60`
  （绿色与「气压趋势」图同色，等于说"这一条就是气压曲线"）。

### D26-2 实现

| 项 | 落点 |
|---|---|
| favicon | `WEB_ICONS`（`PHT_2_X.ino:2470` 起）：**SVG data URI**，编码后 **552 字符** |
| 页面 logo | `WEB_LOGO_SVG`（2490 附近）：内联 SVG，**30px**（三元素比单一图形更吃像素，故从 26px 提到 30px） |
| 挂载范围 | 5 个 HTML 页面的 `<head>`，都在 `<title>` 之后拼 `String(WEB_ICONS)`：`/`、`/web-log`、`/wifi`、`/update`、`/battcal` |
| iOS 主屏图标 | `/apple-touch-icon.png` 路由（`startServer()` 开头）：从 flash 直发 `WEB_ICON_180_PNG`（`web_icon.h`，**180×180 PNG，3,042 字节**）；另放行 `/apple-touch-icon-precomposed.png`（iOS<7 旧名） |
| Android 图标 | `/icon-192.png`、`/icon-512.png` 路由：`WEB_ICON_192_PNG` / `WEB_ICON_512_PNG`（**2,833 + 7,823 字节**），同样 flash 直发 |
| PWA manifest | `/manifest.webmanifest` 路由 → 常量 `WEB_MANIFEST`：`display:standalone`、`start_url:/`、`theme_color`/`background_color` = `#2c3e50`、`icons` 两条均 `purpose:"any maskable"` |

> 常量名 **`WEB_FAVICON` → `WEB_ICONS`**（2026-09-29）：它现在同时装 favicon 与主屏图标两个标签，旧名会误导。
| 主页面页头 | flex 行（logo 与 h2 同行，h2 外距归零）；**原来当临时 logo 用的 `🌤️` emoji 已移除** |

- **为什么用 data URI 而不是新开路由**：零额外请求（ESP32 少一次连接）、无需新路由、AP 配网模式下同样有效。
- **为什么优先矢量**：页面 HTML 是在设备上拼成 `String` 再发的 —— 塞进 HTML 的每一 KB 都要每次请求重拼。
  flash 完全不是瓶颈（现 1280583 B / 16 MB = 7%）。
- ⚠️ **`#` 必须编码成 `%23`**，否则会被当成 URL 片段；本串由脚本 `encodeURIComponent` 生成。
  **改图形必须重新编码，别手改。**
- **favicon 的云为什么用深色实心**：`#bdc3c7` 这种浅灰云在**白色标签栏**上 16px 会被冲淡成一团雾 ——
  小尺寸的可读性本质是**对比度**问题，不是形状问题。
- **代价与对策**：深色云在**深色标签栏**下会糊成一块黑 → favicon 的 SVG 内用
  `@media(prefers-color-scheme:dark){#c{fill:#ecf0f1}}` 把云翻成浅色。
  不支持该查询的浏览器就退回深色云（**正是我们本来就要的那个，没有下行风险**），代价是 data URI 长了约 200 字符。
- 页头 logo **不需要**深色模式适配：页面是固定浅色主题（卡片白底），`body` 没有暗色分支。

### D26-3 未做 / 待确认

- ✅ **apple-touch-icon 已做**（2026-09-29）：iOS **不接受 SVG** 当 apple-touch-icon ——
  它是独立于现代 favicon 的一套老机制（**不是我们偷懒**，见
  [GitLab MR「iOS Safari does not accept SVG for this rel」](https://gitlab.com/gl-demo-ultimate-ccooper/auto-fact/color-music-v2/-/merge_requests/880/commits)、
  [rustpoint-web#4](https://github.com/rustpoint/web/issues/4)），必须 **180×180 PNG**。
  做法：Edge 无头渲染 180×180 HTML 截图 → PNG（**3,042 字节**，只占固件约 0.24%）→ 存 `web_icon.h` 字节数组
  → `/apple-touch-icon.png` 从 flash 直发（`send_P`，**不占 RAM**）+ `Cache-Control: max-age=86400`。
  iOS 还会**自动探测根路径**该文件，所以即使某页漏了标签也能取到。
- **Android 的 maskable 安全区**（这个不做对就白做）：声明 `maskable` 后启动器会把图标**裁成圆形**，
  安全区只有画布 **80% 直径**；内容正方形对角线 ≤ 半径 → 边长上限 **56.6%**。
  所以 192/512 两档把图形缩到 **55%**（而 iOS 的 180 档用 69% —— iOS 只切圆角、不裁内容）。
  底色满铺，因此即使被裁成圆形也是整块深色 App 图标，**不会出现"白圈里一个小图"**。
  `web_icon.h` 顶部注释记了这条百分比来历。
- **图标底色与 favicon 不同，是有意的**：主屏图标用**深板岩底 #2c3e50**（雷暴的暗天空）+ **浅色云 #ecf0f1**
  —— 180px 的图标是独立一块瓷砖，深底更像"App"、在壁纸上更立得住；favicon 要贴白色标签栏，所以反过来用深色云。
  **三档复杂度**：favicon(F 云+闪电，16px) → 页头(C 全要素，30px) → 主屏图标(C 全要素 + 深底，180px)。
- **深色模式**：favicon 是绿色曲线，深色标签栏下对比度尚可（图纸里有深色预览）。
  若要适配 `prefers-color-scheme`，可在 SVG 内加媒体查询，但会加长 data URI。

---

## D27. 网页宽屏布局：≥1000px 改多列仪表盘（2026-09-30）

> **来源**：用户实测反馈 —— 手机上图表观感很好，但 4K 桌面上"拉太平了，味道不对"。
> 规格未变（设计文档没有排版条款），这是一次**纯前端排版修正**。

### D27-1 根因（带数字）

`resizeCanvas()` 里 `w = card.clientWidth - padding`（宽跟屏幕走）而 `cnvs.height = 200 * dpr`（**高恒为 200**），
而主页面 `body` / `.card` 都没有 `max-width` → 宽高比随屏幕线性崩坏：

| 环境 | 画布 | 宽高比 |
|---|---|---|
| 手机（约 380 CSS px） | 约 380 × 200 | **1.9 : 1** ✅ 用户认可 |
| 4K 桌面（2058 CSS px） | 2008 × 200 | **10.0 : 1** ❌ 曲线被拉平、小回落/台阶全被压掉 |

⚠️ 损失的不是"好看"，是**细节可读性**：10:1 时横向 1px 对应的数据变化只有 3:1 时的三分之一。

### D27-2 规则

```css
@media (min-width:1000px){
  body{display:grid;
       grid-template-columns:repeat(auto-fit,minmax(440px,660px));
       gap:15px;justify-content:center;align-items:start}
  .card{margin-bottom:0}
}
```

- ⚠️ **auto-fit 的列数由 `minmax` 的第二个值（max）决定**，不是第一个
  （CSS Grid 规范：max 确定时按 max 算重复次数）。所以 max=660 → 2038px 下正好 **3 列**；
  2760px → 4 列；3420px → 5 列，**每列永远不超过 660px**（画布 ≤630 → 宽高比 ≤3.2:1）。
- **1000px 以下完全不进这条规则** → 手机档逐像素不变（这是本改动的红线）。
- 3 列下前三个子元素正好是「页头 / 供电状态 / 设备模式」，于是**第二行天然就是 温度｜湿度｜气压**
  —— **一张卡都不需要跨列**。
- **为什么只改 CSS、不动 JS**：`resizeCanvas` 读的是 `card.clientWidth`，卡片变窄它自动算对。
  ⚠️ 反过来不成立：**"卡片仍很宽、只给 canvas 加 `max-width`"会把画布横向压扁**
  （行内 `style.width` 与绘图缓冲 `cnvs.width` 不一致）。

### D27-3 连带修的数值行（这个不做，宽屏反而更丑）

列一窄，`.latest-values`（页头 3 值 / 供电状态 6 值 / 今日极值 6 值）就会换行，
而 `.val{flex:1}` 让**换行后落单的那一个撑满整行** → 变成一个巨大的蓝盒子（实测截图确认）。

- `display:flex` → `display:grid;grid-template-columns:repeat(auto-fit,minmax(90px,1fr))`：
  grid 的 auto-fit 会**折叠空轨道**，所以 3 值的卡照样铺满，6 值的卡自动 6 列 / 3 列，**落单的只占一格**。
- `.val` 去掉 `min-width:80px` → `min-width:0`（它连同 30px 内边距会撑破栅格轨道）。
- 供电状态那行加 `.wide{minmax(160px,1fr)}`：它的值是**文字**（如 `⚡外部供电` ≈120px），
  132px 试过仍会在"供/电"之间断行，160px 才够。只影响这一张卡。

### D27-4 验证（都是截真实设备页面看的，不是空想）

| 宽度 | 结果 |
|---|---|
| 2058（4K 桌面） | 3 列；温度｜湿度｜气压 并排；每张 **630×200 → 3.2:1**；数值行 3+3 与 6 列一行均无撑满 |
| 600（窄屏有效档） | 单列；无横向溢出；供电状态 3+3、"⚡外部供电"一行 |
| 手机档 | 不进媒体查询 → 与改动前一致；接入真实手机（约 410 CSS）时按同规则算仍是 3 值一行 / 供电卡 2 列 |

### D27-5 已知边界与踩坑

- **1000~1335px 这一段只有 1 列**（660px 居中，两侧留白）：因为列数由 max=660 驱动，
  两列需要 2×660+15=1335px。这一段观感是"窄居中列"，不算坏但浪费横向空间。
  若嫌弃，可改成显式列数的断点（`@media(min-width:1020px){repeat(2,1fr)}` 等）。
- **今日气压距平曲线**在移动模式下是一张**空白卡**（标题栏有"仅固定模式可用"提示，但画布里的浅灰占位字
  几乎看不见）。**这是既有行为，不是本次改动引入的**，本次未处理。
- ⚠️ **headless Edge 截图的两个坑**（都踩过）：
  ① **profile 锁**：不指定 `--user-data-dir` 时会用默认配置目录，前一个实例没退干净就**永远等锁**、
     不产出截图。必须给独立 profile 目录。
  ② **Windows 下有最小窗口宽度**：按 `--window-size=400` 截，实际布局视口约 **570px**，
     图是**裁切**的 —— 我曾据此误判"窄屏横向溢出"。要验窄屏得用 ≥600px。

---

## D28. 未插卡时的日志兜底：按时间戳裁头 + 按需挂载 SD（2026-09-30）

> **来源**：用户问「写 flash 这么频繁会不会磨损过快」。查完发现**磨损不是问题**（量化见 D5-2），
> 但顺手挖出**两个真问题**：不插卡时 `/log.csv` 只涨不清；`sdOK` 只在开机判定一次。

### D28-1 为什么要兜底裁头

- littlefs 分区 **3.38 MB**（D5-1），`/log.csv` 约 **138 KB/天**（2880 条 × 48 B）→ **约 26 天填满**。
- 唯一的轮转路径是**归档到 SD 后删除**（`archiveToSD()` → `LittleFS.remove("/log.csv")`），
  而它开头就判 `sdOK`：**不插卡 → 永远不轮转**；满后 `safeAppendFile()` 失败（有告警，不静默），
  且当时**唯一能腾空间的手段是 `/clear`（全清）**。
- 现在补上：**没插卡时，每天 02:00 把超过 `LOG_KEEP_DAYS`（14 天）的头部裁掉**。

### D28-2 口径：按**时间戳**裁，不是「砍掉最老的 2880 条」

⚠️ 最初的想法是"删掉前 2880 条（= 一天）"。**这个口径会自己吃自己**：
`readAndLog()` 在低电压时会跳过记录（`allowRecord=false`）、重启也会丢采样，
一天的实际条数经常**不到** 2880 → 每天净减 (2880 − 产出) 条 → 越裁越少，最后可能只剩不到一天。

按时间戳裁（保留 `时间戳 ≥ now − 14 天`）则**保留期恒等于 14 天**，且能自我收敛。
解析复用 `archiveToSD()` 里现成的 `strptime(timeStr, "%Y-%m-%d %H:%M:%S")`（CSV 第 2 列）。

### D28-3 实现要点

- **只裁头 → 读取端一行都不用改**：还是同一个 `/log.csv`、同样的行格式，`/history` 仍按行数分页。
- **只能整文件重写**（littlefs 不能在文件中间打洞）：读 → 过滤 → 写 `/log.tmp` → rename，
  与 `archiveToSD()` 同一套写法。裁完 `recordCount = 保留条数`，并 `loadBufferFromFlash()` 刷新 RAM 环。
- **先只读第一条判断要不要裁**：没到保留期就整文件都不碰（省掉一次 2 MB 重写）。
- ⚠️ **必须自己收工**：`checkAndArchive()` 在 02:00~02:04 窗口内**每 30s 重试一次**，
  裁头若不设 `doneYday` 守卫，会连做 10 遍 = 把整个 2 MB 文件重写 10 遍。
- 代价：每次裁把剩余部分重写一遍（14 天 ≈ 2 MB）。按天裁 = 每天多写约 2 MB，
  相对记账本身多 15 倍，但绝对值仍可忽略（约 365 次擦写/块·年，按 1 万次算还有 27 年）。

### D28-4 `ensureSD()`：把「开机判一次」改成「用卡前试一次」

- **原状况**：`sdOK` 只在 `setup()` 里由 `initSD()` 判定（全文件只调那一处）→
  **运行中插卡不会被发现**，必须重启才认；连网页手动点「归档」也会失败。
- **改法**：新增 `ensureSD()`（仅在 `!sdOK` 时才 `initSD()`），只在**三个真正碰卡的入口**调用：
  ① `archiveToSD()` ② `/sdlist` ③ SD 文件下载 → 插卡后第一次用到就认出来，不必重启。
- ⚠️ **不能放进 30s 采样路径**：`SD.begin()` 是阻塞的（正常约 100~300ms，坏卡可能到秒级）。
- ✅ **总线是分开的**（已核对源码）：SD 走 `sdSPI(HSPI)` = **SPI3**（GPIO 15/16/7/6）；
  屏 ST7305 走默认 `SPI` = **FSPI/SPI2**（DC=11 CS=10 RST=12）→ 运行中重挂 SD 不会打扰屏幕。
- ⚠️ **仍有一个缺口**：卡「能挂载但写失败」时不裁头（不给瞬时故障删数据的机会）→
  这种情况下日志仍会无限涨。先观察，暂不兜底。

### D28-5 实测记录（2026-09-30，COM5 测试机）

用**临时编译副本**（`LOG_KEEP_DAYS=1` + 临时关掉 02:00 窗口检查）真跑了一次，**仓库源码不动**：

```
刷前: count 8479
🧹 未插卡兜底：裁掉 5952 条（早于 1 天前），Flash 保留 2532 条
     5952 + 2532 = 8484 ≈ 8479 + 刷机后新采 5 条        ✅ 算术闭合
/status                  count = 2534                     ✅
/history                 JSON 合法、total = 2534（它自己数文件行数 → 反证文件确实被裁）✅
/download?f=/log.csv     121,692 B / 2535 非空行（表头 + 2534 条）✅
     首行 5953, 2026-09-29 18:25:33  ← 21.5 小时前，落在 1 天窗口内 ✅
     （09-29 15:52~18:25 本身有断档，所以第一个幸存样本不是 15:52）
     末行 2534, 2026-09-30 15:53:30
```

⚠️ **顺带发现（既有行为，非本次引入）**：裁完之后 CSV 的**序号列会往回跳** ——
保留的老行仍是 `5953…8478`，新写的行从 `2534` 重新开始。原因是 `recordCount` 身兼两职
（`:4017` 是新行序号、`:2267` 又是「总条数」），而裁头沿用了 `archiveToSD()` 的
`recordCount = 保留条数`。**插着卡每天归档后也是这样**，纯显示问题：
`/history` 按行数分页、RAM 下载按 `recordCount − bufferSize + 1` 编号，逻辑都不依赖序号单调。
要拆成「总条数 / 下一个序号」两个变量随时可以做。

📌 **附带搞清（以前容易误解）**：不带 `?f=` 的 `/download` 吐的是**内存环（600 条）**，**不是文件** ——
这是故意设计（防「文件静默停止增长时下载到旧数据」）。要文件必须 `?f=/log.csv`。

## D29. BQ24074 输入限流与冷启动流程（2026-10-03）—— EN1/EN2 三档 · 100mA 根因 · 安全启动

> **一句话**：v2.2 板固件从未驱动 `EN1/EN2` → 输入限流恒为 `(0,0)=USB100=100mA`。
> 有电池时靠电池补启动峰值，**一旦拔掉电池就反复 BROWNOUT 起不来**。
> 修法：启动最早阶段把 `EN1` 抬高到 **USB500(500mA)** 并**锁死 CE 禁止充电**（不跟系统抢电流）。

---

### D29-1 EN1/EN2 真值表（**TI 官方手册**原文核对，非推断）

来源：`bq24074.pdf`（SLUS810N，2021-10 修订），第 7 节 EN1/EN2 Settings 表：

| EN1 | EN2 | 输入限流 | 模式 |
|:---:|:---:|---|---|
| 0 | 0 | **100 mA** | USB100（**上电默认**：引脚悬空 + 芯片内部约 285 kΩ 下拉） |
| **1** | **0** | **500 mA** | **USB500** |
| 0 | 1 | 由 ILIM 外部电阻设定 | ISET 档（`IIN-MAX = KILIM / RILIM`，有效 1.1 k~8 kΩ，**最高 1.5 A**） |

**同时核对到的两条**：
- `PGOOD is low when (VBAT + VIN(DT)) < VIN < VOVP` —— **PGOOD 条件里含 VBAT**（拔电池会影响它）
- `Leaving ILIM unconnected disables all charging` —— 本板 `ILIM-R_LIM-GND`，故 ISET 档可用

> ⚠️ **极性易混**：表中列为 `EN1, EN2`；代码里写 `(EN2, EN1)` 时要对调。

---

### D29-2 故障现象与实测证据（2026-10-03）

**现象**：插着 USB、设备正常运行中，**拔掉电池 → 立即黑屏**，之后插 USB 也不再启动（反复复位）。

**用户实测的三条关键证据**（这三条把范围一步收窄）：

| 测量 | 结果 | 排除了什么 |
|---|---|---|
| **3.3V 轨** | **一直有电** | ❌ 排除"3.3V 掉到 0" |
| **EN1 / EN2** | 系统完全启动后**仍无一拉高** | ✅ 印证：固件从未驱动 → 恒 `(0,0)` = **100 mA** |
| **拔电池瞬间 PGOOD** | 示波器**无高脉冲** | ❌ 排除 PR1/PGOOD 误动作 |

**根因链**：
```
输入限流恒 100 mA（EN1/EN2 从未驱动）
  + CE 低 = 允许充电，移动档要 890 mA 灌进电池
  → 系统自身 WiFi 初始化峰值 300~500 mA 都未必够，何况再抢
  → 输入电压塌 → BROWNOUT → 复位 → 又初始化 WiFi → 循环
有电池时为什么没事？电池补了峰值电流。**拔掉电池 = 唯一的缓冲没了。**
```

**修好后实测对比**（同样拔电池动作）：

| | 拔电池后 |
|---|---|
| 修复前 | ❌ 立即黑屏 → Brownout 死循环 |
| **修复后** | ✅ **屏幕不掉电，电量显示 0%，设备继续运行**（见证记录：`3.84V → 0.66V` 那一条之后设备从未失联） |

---

### D29-3 走错的路（记录以免重犯）

排查过程中有**两个错误假设**，都因为"推断超出证据"而被用户的实测推翻：

1. ❌ **"深睡导致黑屏"** —— 用户反驳：**ST7305 是普通反射 LCD，需要持续供电维持显示**，
   若只是 ESP32 深睡、3.3V 仍在，屏幕应保持最后一帧。**屏幕真的黑了 ⇒ 3.3V 真掉了**（或 ESP32 根本没机会刷屏）。
   → 但**深睡守卫仍然该加**，因为其中确实有一个真 bug（见 D29-5）。
2. ❌ **"上电就该给最大电流"** —— 违背了本项目自己的安全原则（对方可能只是 500 mA 的 USB 口）。
   → 正确做法：**保守起步，按枚举结果放宽**。

**方法论教训**：`用"看起来合理"代替"验证过"`、`拿局部信息推断全局`、`没读全已有文档就开始设计`
—— 这三点是本轮弯路的主要来源。

---

### D29-4 冷启动流程（现行逻辑）

```
上电
 └─ 最早阶段（早于 WiFi 初始化）
      ① EN1 = 高  →  (EN2,EN1)=(0,1) = USB500 = 500 mA
      ② CE  = 高  →  **锁死：禁止充电**（不跟系统抢输入电流）
      ③ 其余初始化照常（I2C / RTC / SD / 屏 / WiFi）
 └─ 系统运行起来之后
      ④ USB 枚举检测
           ├─ 成功（对端是 USB 主机）→ **保持 USB500**，允许充电
           └─ 失败（判定为充电器）  → **翻转 EN1/EN2** → 常规电源管理逻辑（ISET 档）
```

**为什么①必须"最早"**：枚举本身就耗电（射频），若等到枚举后才抬电流，
**系统可能在枚举阶段就已经掉压复位** —— 顺序必须是"先给够电，再枚举，再按结果收窄"。

**为什么②要先禁充**：供电受限时，**充电和系统在抢同一份输入电流**。
系统起不来就没有后续可言，故启动期**系统优先**。

**⚠️ 不可控的一段**：`setup()` 第一行之前是 **ROM bootloader**，
那段时间 `EN1/EN2` 仍是高阻（下拉 → 100 mA），**固件无法干预**。
实测表明 ROM 阶段在 100 mA 下能过（设备能跑到我们的日志），**撑不住的是后面的 WiFi 初始化**。

---

### D29-5 同批修复的两个真 bug（排查中发现）

即使与本次根因无关，这两个都是**必须修**的：

**① 深睡唤醒源写死老脚**
```c
// 修复前
esp_sleep_enable_ext0_wakeup(GPIO_NUM_2, 0);   // ← PGOOD 的**旧脚**
```
v2.2 引脚迁移后 `PGOOD = IO10`，但这行硬编码没跟着改
→ **设备一进深睡就监听一个空脚，永远醒不过来**。
（浅睡那处用的是宏 `PIN_PGOOD`，所以是对的 —— 只有深睡这处漏了。）
**修法**：改用 `(gpio_num_t)PIN_PGOOD`，以后引脚迁移不会再漏。

**② 低电深睡缺"电池不在"守卫**
```
拔掉电池 → INA230 读到 0V（芯片由 3.3V 轨供电，`inaOK` 仍为 true，**不会**变成 NaN）
        → 0 < battSleepV(3.5V) → 直接深睡
```
**修法**：三重守卫 ——
1. 有外接电源（PGOOD / CHG / 电压读数自相矛盾）→ **绝不深睡**
2. 读数 `< LOWBAT_SANE_MIN_V = 0.5V`（电池拔掉/未接）→ **绝不深睡**
3. **连续 3 次**采样都低才深睡（防 I2C 垃圾值与拔插瞬变）

**③ 顺带**：`PR1` 增加**插电守卫**（外接电源在位时绝不切电池直供 —— 插电旁路 LDO 毫无意义）
+ **60 秒上电宽限期**（等电源轨稳定、读数可信）。

---

### D29-6 编译开关与回退

```c
#define PWR_SAFE_START 1   // 1 = 冷启动安全流程（现行）；0 = 回退到老逻辑（允许充电 + 不驱动 EN1/EN2）
```
安全模式下 `applyChargeStrategy()` **开头即 `return`** 并强制 `CE=高`，确保**任何路径都不会偷偷使能充电**。

---

### D29-7 待验证 / 待决

| # | 项 | 状态 |
|---|---|---|
| 1 | ~~**USB500 下能否同时充电**~~ | ✅ **已实验定论：可以充**（详见下方 D29-8） |
| 2 | ~~USB 枚举检测~~ | ✅ **已实装**（SOF 帧号法，见 D29-8） |
| 3 | ~~冷启动 vs 热启动分支~~ | ✅ **已实装**（阈值 3.6 V，见 D29-8） |
| 4 | 枚举失败 → ISET 档后的实际输入限流（需与实物核对 ILIM 阻值） | ⏳ 待实测（需插真充电器） |
| 5 | 冷启动阈值 3.6 V 在**带载**下会偏低（实测空载 3.84 V / 带载 3.49 V）→ 可能把有电的电池误判为冷启动 | ⏳ 观察中 |

---

### D29-8 USB 枚举 · 冷/热启动 · 充电实验（2026-10-03 实装并验证）

**① USB 枚举检测（SOF 帧号法）**

寄存器（esp32s3-libs 头文件核对）：
```
DR_REG_USB_SERIAL_JTAG_BASE = 0x60038000
+0x24  USB_SERIAL_JTAG_FRAM_NUM_REG   低 11 位 = SOF 帧号（主机每 1 ms 发 SOF → 自增，绕回 2048）
+0x14  USB_SERIAL_JTAG_INT_CLR_REG    清中断
```
**判据**：窗口内帧号是否变化 —— **在动 = 对端是活的主机；静止 = 充电器**。
**⛔ 不用 `(bool)Serial`**（实测它反映主机 DTR，不是数据流）。

**实测验证**：插电脑 → 帧号 `1033→1284`（250 ms 内 +251，精确吻合 1 ms/帧）✅；
插充电器 → 帧号恒 `0`，判定 charger ✅

**② 冷启动 / 热启动分流**（阈值 `PWR_COLD_START_V = 3.6 V`）

```
上电 → chargeInit()（最早）：EN1=高 → USB500；CE=高 → 先禁充
     → 其余初始化
     → INA230 就绪后 serviceBatteryStartup()：
          VBAT >= 3.6V → 热启动（拨 EN）→ 沿用老逻辑，提前放行充电
          VBAT <  3.6V → 冷启动（电池没电）→ 保持禁充，系统优先启动
     → serviceUsbEnum()：
          主机   → 保持 USB500，允许充电（见下方实验）
          充电器 → 翻转 EN1/EN2 进 ISET 档，允许充电
```

⚠️ **冷/热只影响"启动期是否提前充电"，最终充电权交给枚举结果** ——
否则冷启动（电池没电）会永远充不上（实装时踩到并修正）。

**③ ⭐ USB500 下能否充电 —— 实验定论：可以**

```
条件：USB 主机（host）+ USB500(500 mA) + 允许充电 + 快充档
实测：充电电流 +425 mA 稳定；电池 3.59 V → 3.64 V 持续爬升；
      18 个采样点无复位、无失联
```

**正确模型（BQ24074 电源路径管理）**：
```
系统**优先从输入(USB)取电**，剩余电流才进电池。
500 mA 上限下：系统约用 75 mA，剩 ≈425 mA 给电池。
——不是"系统把 500 mA 吃满、电池拿不到"。
```

> ⛔ **重要教训**：早先曾测得 `-1.0 mA` 并据此把 `usbChargingViable` 写死为 `false`。
> 但那次测量是在 **TS 脚还是 2 kΩ（芯片判"过热"停充）** 期间做的 ——
> **测到的是 TS 故障，不是"USB500 不够"。**
> **测量条件存在已知故障时，数据不能当结论。**

原始数据：`doc/usb500_charge_exp.csv`

---
---

# D30 启动流程重排与启动速度优化（2026-10-03）

### D30-1 启动流程重排

**背景**：模块多了以后启动越来越慢（实测 **24 秒**），且顺序不合理：
屏幕 3~4 秒后才初始化、电池电压竟然在 WiFi 之后才读（读数带载而失真）。

**新顺序**（分四个阶段）：

```
【① 保命与上电安全】
  1. chargeInit()            USB500 + CE 先禁充（防启动期掉压）
  2. Wire.begin()
  3. INA230 初始化
  4. readPowerState() + 低电保命检查
  5. serviceBatteryStartup() ★ 冷/热启动分流（此时几乎空载 → 读数才准）

【② 尽早点亮屏幕】
  6. initRTC() → initFS() → loadDeviceMode() → calBootCheck()
  7. uiDisplay.init()
  8. 若 RTC 有电 → 立刻设系统时间（屏幕马上显示正确时间，不等 NTP）
  9. uiSyncStatus() + showTop()   ← 屏幕亮起

【③ 采集能力就绪】
 10. BMP580 / SHT30 初始化    ★ 前移（采样依赖它们）
 11. initAvgEngine()

【④ 联网与服务（可慢）】
 12. loadWiFiConfig() → 连接 WiFi
 13. NTP（非阻塞）/ backfillTodayFromLog()
 14. startAP() 或已连提示
 15. initSD()                 ★ 延后（用户：启动时爱挂不挂）
 16. archivePump() / checkAndArchive() / startServer()
 17. updateWireless()
 18. serviceUsbEnum()
```

### D30-2 关键修正：电压读数时机

| | 改前 | 改后 |
|---|---|---|
| 读电压时刻 | **23.9 s**（WiFi/屏/SD 全在跑） | **0.6 s**（几乎空载） |
| 实测读数 | 带载 **3.49 V** | 空载 **3.81~3.89 V** |
| 后果 | 拿带载值比阈值 → **误判冷启动** | 判据准确 |

> 用户原话："读电压的时候啥也没干啊" —— 恰恰相反，改前是**啥都干完了**才读。

`delay(1000)` → `delay(500)`（等 USB 串口枚举用，用户裁定缩短）。

### D30-3 NTP 改造：非阻塞 + 每日定期重同步

**问题**：原 `syncTimeFromNTP()` 用 `delay(250)` 轮询最多 40 次 = **最多阻塞 10 秒**，
且只在启动时同步一次。而本设备理想环境下**一年都可能不重启**，
RTC(DS3231) 与片上时钟都会漂 → 时间会越走越歪。

**拆成三个函数**：

| 函数 | 作用 |
|---|---|
| `ntpStart()` | 只调 `configTime()` 启动 SNTP，**立即返回** |
| `serviceNtpSync()` | loop 每圈落地：写 RTC、记 `ntpLastOkAt`、20 秒超时回退 RTC |
| `syncTimeFromNTPBlocking(ms)` | **仅 RTC 掉电**时用（那时没有可信时间源，值得阻塞等） |
| `serviceNtpDailyCheck()` | **每日 02:00 检查**：距上次成功 ≥3 天则重新同步 |

**每日检查的设计**：
```
条件：插电 + WiFi 已连 + 当前时间有效（否则无法判断"到 02:00 了吗"）
触发：跨过 02:00 当天做一次判定；距上次成功 >= NTP_RESYNC_DAYS(3) 天 → 非阻塞同步
兜底：RTC 掉电且当时无网 → 挂起(ntpDailyPending)，一旦有网立刻补一次
```
原 `ntpTriedThisBoot`（每次开机只重试一次）已被每日定时取代。

**实测**：`[7.6s] NTP 同步已启动（非阻塞）` → `[8.9s] NTP 已同步（并写入 RTC）`

### D30-4 WiFi 两项浪费修复（两个真 bug）

**Bug A：扫不到已保存热点仍硬连**

`wifiPickBest()` 扫不到时返回 `false`，但 setup **忽略了返回值**，仍然调用
`wifiConnectSaved()` 去连一个扫描都看不到的热点 → 白等一次 DHCP 超时（**最多 10 秒**）。

修：加 `requireInRange` 参数，`wifiPickBest(true)` 扫不到就返回 false →
**跳过连接，直接开 AP**。

**Bug B：DHCP 学习成果存错对象（这才是"次次都学"的根因）**

```c
WiFiConfig wifiCfg;                 // ← 独立对象，不是引用
WiFiConfig wifiList[WIFI_MAX_SAVED];

wifiCfg = wifiList[best];           // 赋值 = 拷贝
wifiCfg.gw = WiFi.gatewayIP();      // 学习成果只写进了 wifiCfg
saveWiFiConfig();                   // ← 但它只保存 wifiList[i]！
```

**结果：网关/掩码/DNS 落盘的永远是空值 → 每次开机都判"没学过" → 无限重复 DHCP 学习。**

修：学习后**回写 `wifiList`** 再存盘。

并加"已学过就跳过"判据：
```c
bool gwKnown = ((uint32_t)wifiCfg.gw != 0) && ((uint32_t)wifiCfg.mask != 0);
if (!gwKnown) { ...DHCP 学习... }   // 只在网关/掩码未知时才学
```
（失败兜底重学暂未实现：需先扫到该 WiFi 才谈得上重连，见 D30-5 待办）

> 用户原话："谁家网关天天变啊，学一次就得了，次次学，浪费时间"

### D30-5 结果与待办

| 指标 | 改前 | 改后 |
|---|---|---|
| 总启动时间 | **24.0 s** | **8.6 s** |
| 电压读数时刻 | 23.9 s（带载失真） | 0.6 s（空载准确） |
| 传感器就绪 | ~24 s | 3.2 s |
| NTP | 阻塞最多 10 s | 非阻塞（启动后 1.3 s 静默完成） |
| DHCP 学习 | 每次开机重学（1.5 s，网关慢时最多 10 s） | **跳过** |
| 扫不到热点 | 硬连白等最多 10 s | **跳过直接开 AP** |

**待办**：
- [ ] "已学过的网络参数配静态 IP 失败"时的自动重学兜底（自愈换路由器场景）
- [ ] 设计文档中 `设计文档.md` 只写了一句"重新排列启动顺序，优化启动速度"带过，细节以本节为准

---
**决策依赖**：
- 若 **USB500 下能正常充电** → 枚举成功后**允许充电**
- 若**不能** → 枚举成功后**保持禁止充电**（至少低电时不充）

---

# D31 INA230 实测：AVG 锁定与 CT 降噪（2026-10-03）

> 在临时分支上做的设备实测；分支已删，结论留在本节。

### D31-1 结论摘要

| # | 结论 | 证据 |
|---|---|---|
| 1 | **AVG 恒为 128，无法更改** | 不经库直接写 CONFIG 八档全试，回读**恒为** `0x4927`(AVG=128)；连读五次确定性一致 |
| 2 | **CT 字段写入完全正常** | 八档 140us~8244us 全部写入生效 → **寄存器不是写保护**，只是 AVG 字段被固定 |
| 3 | **`buildConfig()` 库实现正确** | 八档产出与手册位域期望**逐位一致**；（本轮一度以为注释写反，实为 v1 探针误读注释，已澄清） |
| 4 | **CT 是唯一有效的降噪旋钮，效果达两个数量级** | 见 D31-3 |
| 5 | **标定用的 `CT_8244US` 已是最优** | 4156us 与 8244us 均已到 0 噪声 |
| 6 | 代码的 AVG 探测逻辑**已正确处理**此事 | `calInaBegin()` 从 1024 起逐档试到 128，能通过者即实际可用值 |

**⇒ 不是新 bug** —— 2026-09-15（当时是 INA226）已踩过并记录该现象，
`calInaBegin()` 的探测循环正是为此而写。本次实测把"AVG 锁死"与"CT 决定噪声"**量化**了。

### D31-2 AVG 锁定实测（不经库，直接读写寄存器）

```
写入        回读      解析                              结果
0x0927  ->  0x4927    AVG=128 VBUSCT=1100u VSHCT=1100u  不一致
0x1927  ->  0x4927    AVG=128 ...                      不一致
0x2927  ->  0x4927    AVG=128 ...                      不一致
0x3927  ->  0x4927    AVG=128 ...                      不一致
0x4927  ->  0x4927    AVG=128 ...                      一致
0x5927  ->  0x4927    AVG=128 ...                      不一致
0x6927  ->  0x4927    AVG=128 ...                      不一致
0x7927  ->  0x4927    AVG=128 ...                      不一致
```

**CT 字段对照（证明写入通道正常）**：
```
写 VSHCT=140us  -> 回读 VBUSCT=140us  VSHCT=140us   生效
写 VSHCT=204us  -> 回读 VBUSCT=204us  VSHCT=204us   生效
...（八档全部生效）
写 VSHCT=8244us -> 回读 VBUSCT=8244us VSHCT=8244us  生效
```

### D31-3 CT 降噪实测（AVG 只能是 128；每档 40 次采样）

| CT (bus/shunt) | 电压均值 V | 电压极差 mV | 电压 sd mV | 电流均值 mA | 电流极差 mA | 电流 sd mA |
|---|---|---|---|---|---|---|
| 140us | 3.9859 | 11.25 | 2.945 | +49.519 | 6.50 | 1.67 |
| 204us | 3.9844 | 3.75 | 0.882 | +52.537 | 2.00 | 0.56 |
| 332us | 3.9857 | 1.25 | 0.624 | +52.443 | 0.75 | 0.24 |
| 588us | 3.9848 | 2.50 | 0.573 | +52.362 | 0.50 | 0.14 |
| **1100us** | 3.9850 | 0.00 | 0.000 | +52.437 | 0.25 | 0.10 |
| **2116us** | 3.9850 | 0.00 | 0.000 | +52.343 | 0.25 | 0.12 |
| **4156us** | 3.9850 | 0.00 | 0.000 | +52.487 | 0.00 | 0.00 |
| **8244us** | 3.9850 | 0.00 | 0.000 | +52.487 | 0.00 | 0.00 |

**结论**：140us → 8244us，**电流噪声降约两个数量级**（sd 1.67 mA → 0）。
标定所用 `CAL_CT = INA230_CT_8244US` **已是当前可用最优配置**。

### D31-4 物理分辨率下限（已评估，非问题）

```
分流电压 LSB = 2.5 uV  ->  经 10 mOhm 分流电阻 = 0.25 mA 物理分辨率
Current_LSB = 8.19 A / 32768 = 0.25 mA          <- 两者恰好相等
```

CT=8244us 下分流电压寄存器（带符号 16 位）已量化到零波动，
意味着比 0.25 mA 更细的电流波动**读不出来**（是物理下限，不是芯片缺陷）。

若要更细：① 加大分流电阻（如 50 mOhm -> 0.05 mA）② 或对分流寄存器做应用层平均。
**对当前用途（充电阶段判断 / 低电判据）0.25 mA 完全够用，暂不改。**

---

# D32 推送功能实装（v2.2 局域网先行，2026-10-05）—— 发送引擎 · 时间不可信铁律 · 直连工具链构建

**来源**：设计文档 `docs/推送功能设计.md`（十节，用户已固化决策）+ `docs/ESP32推送实现清单.md`。
分支 `feat/esp32-push`；第一阶段（配置层/设备名/`/status.push`/`/devname` 重名校验）见提交 `50c190c`，**本段是第二阶段（真正发送）**。

## D32-1 架构：主循环只判断，HTTP 全在独立任务

```
loop()  └─ servicePushTick()        ← 每圈一次，微秒级：只判「插电瞬间 / 本会话首次联网」
   ↓ 置位 pushTickForce
pushTask（独立 FreeRTOS 任务，prio 1 = 与 loop 同优先级，绑核心 0）
   └─ 每 500ms 醒一次（light sleep 期间自然让路，醒来立刻恢复判断）
        · 到期？（15 分钟 + MAC 抖动 0~120s）或强制？
        · WiFi 连着？时间可信？
        · 取一批 ≤200 条 → HTTP POST（只有这里会阻塞）
        · 成功 → 推游标 + 存 NVS；失败 → 指数退避 30→60→…→600s
        · 批间 sleep 2s（压低 WiFi 占空比）
```

**为什么必须独立任务**：本项目已因「阻塞式串口输出」卡过主循环（开发日志坑④），HTTP 的阻塞时间远长于串口。
**任务优先级取 1（与 loop 同）**：不会被抢占饿死主循环，靠 tick 时间片轮转；绑核心 0 避免跨核竞争 WiFi 栈。

## D32-2 三条不许改的约束

| # | 约束 | 理由 |
|---|---|---|
| ① | **HTTP 绝不进主循环** | 主循环是采样命脉；写 Flash / 刷屏都已经是"必须让路"的量级，HTTP 更慢 |
| ② | **时间不可信时绝不推送** | 时间戳是服务器主键。未同步 NTP/RTC 时 `time()` 是开机秒数，推上去会**永久污染**服务器序列（幂等去重也救不回来）。代码里两道闸：`timeSynced` + `hasValidDate()` |
| ③ | **只有整批成功才推游标** | 服务器按 `(device_id, ts)` 幂等去重 → **中途失败可安全重发**，所以游标只在整批 POST 成功后前进并写 NVS |

## D32-3 数据源与游标（第一阶段的边界，如实记录）

- 数据源**只有 RAM 环形缓冲**（600 条 ≈ 5 小时）。CSV/SD 补传是第三阶段。
- 游标 `lastSyncedTs` 存 NVS 键 `lastSync`；**「已上传的最大 ts」**，不是"位置"。
- 重启后若游标落后于内存窗口最老点（跨了一次重启/长时间断网），会**打日志说明跳过多少空档**，然后退到 RAM 最老点开推，不空转也不假装完整：
  `⚠️ 推送游标落后内存窗口：跳过 N 秒空档（x.x 小时）—— 只推 RAM 里现有的点`
- 服务器响应里的 `needBackfillBefore` 会被记下来（`/status.push.needBackfill` / `backfillBefore`），
   **本轮不消费它** —— 那是第三阶段（CSV/SD 补传）的输入。

## D32-4 第一批实测（2026-10-05 上机）

| 项 | 结果 |
|---|---|
| `POST /api/v1/samples` 带 token（PC 侧 `curl`） | ✅ `accepted:1`；不带 token → **401** |
| 服务器上多出来的测试设备行 | 已清理（`PHT-SmokeTest` 的 samples/devices/sync_state 三处全删） |
| 设备端 OTA 上传新固件 | ❌ **`Update.end` 校验失败（固件无效？）** —— 见 D32-6 |

## D32-5 token 怎么进固件（构建期注入，绝不入仓库）

```powershell
# 构建脚本写进 build_opt.h（compile 命令里有 @build_opt.h）
-DPHT_API_TOKEN_RAW=<64 位十六进制>
```
源码侧用**两层字符串化**取值：
```c
#ifndef PHT_API_TOKEN_RAW
#define PHT_API_TOKEN_RAW
#endif
#define PHT_STR2(x) #x
#define PHT_STR(x)  PHT_STR2(x)
#define PHT_API_TOKEN PHT_STR(PHT_API_TOKEN_RAW)
```
**为什么不用 `-DPHT_API_TOKEN="0e27..."`**：token 是 `0e27…` 这种**以数字开头**的十六进制串，
经过 gcc 的 `@file` 参数文件时引号会被吞掉 → `unable to find numeric literal operator 'operator""efee…'`。
`RAW + 字符串化`能强制它按标识符解析（只对纯字母数字的 token 有效，我们的正好满足）。
另外 `/status.push.token` 只报 `true/false`（是否已注入），**不泄露值**。

## D32-6 ~~⚠️ 已知阻塞~~ ✅ 已解决：直连工具链构建的镜像被设备拒绝（2026-10-05）

> **2026-10-05 晚更正：本节结论已推翻。** 真因不是 linker、也不是段数，
> 而是 `_build/appimage.py` 自身的构图逻辑有硬伤（不做 flash 段 64 KB 对齐 +
> 尾部照抄参照镜像，把参照镜像的 SHA-256 一起抄了进来）。
> 已改为直接调用 esptool 的 `bin_image.save()`，OTA 随即成功。
> **完整根因与实测见 D35。** 下面原文保留作历史留档。

**现象**：新固件（含推送代码，1.37 MB）OTA 上传后设备回
`❌ Update.end 校验失败（固件无效？）`；**同一路径上传旧镜像（1.27 MB，与设备当前固件相同）→ ✅ 更新成功**。
→ 上传链路没问题，**是本工具链产出的镜像被拒**。

**为什么不用 arduino-cli 编译**：沙箱里 `arduino-cli.exe`（PyInstaller onefile）派生子进程时报
`Failed to extract VCRUNTIME140.dll: failed to open target file` —— clang/gcc 子进程起不来，编译无法进行。
`esptool.exe` / `gen_esp32part.exe` 同样是 PyInstaller，同样失败。

**绕行方案（已跑通，`_build/`）**：

| 脚本 | 作用 |
|---|---|
| `_build/build.ps1` | 复用旧 build 目录（`C:\phtc\build` 的 `core.a` + 全部库对象），只重编 sketch + 链接 + 出 bin |
| `_build/gen-protos.js` | 代替 arduino-cli 的 ctags 原型注入：在**最后一个类型定义之后**插入前置声明 |
| `_build/appimage.py` | 代替 `esptool elf2image`：按**旧镜像的布局**（24 字节镜像头 + 段 + 40 字节尾部）生成 app 镜像，并补 `esp_app_desc_t.app_elf_sha256` |

**已核对无误的部分**（逐字节比过旧镜像）：
- 镜像头 24 字节 ✅（除段计数 7→6、段地址/长度随代码变化）
- 段头 `{addr,len}` 与 4 字节对齐 ✅
- `esp_app_desc_t` 魔数 `0xABCD5432` ✅、`app_elf_sha256` = ELF 的真实 sha256 ✅
- 尾部 40 字节 = 旧镜像原样 + 重算的 16 字节 sha256（`sha256(image[0:len-32])`，与旧镜像自校验一致）✅

**还没验证的怀疑点**：新镜像**只有 6 个段**（旧镜像 7 个，多一个 `0x40377AE0 / 66972 B` 的段），
且 `.flash.appdesc` 因代码跨过 64 KB 边界从 `0x3c0e0020` 挪到 `0x3c0f0020`（链接器自身行为，见 map 的
`ALIGN(0x10000)+0x20`）。**下一步**：用真正的 `esptool`（或 IDE 编译）产出镜像做对照，确认是否格式细节所致。

**当前建议**：先用 **Arduino IDE 编译 + OTA** 把这份固件刷上去（IDE 走的是正常 ctags + esptool 链路），
直连工具链的镜像问题另外再查 —— 推送功能本身与镜像格式无关。

---

## D32-7 上机验收结果（2026-10-05 实测，全部留证）

**固件**：正规 `arduino-cli` 产物 1341067 字节（含 token），已 OTA 到 `.99`，`/status.push` 各字段齐全。

| # | 验收项 | 结果 | 证据 |
|---|---|---|---|
| ① | **持续推送** | ✅ | 启动即推完 600 条积压（3×200），随后按 15 分钟 + 抖动（jitter=64s）自动排程；`passes` 递增 |
| ② | **`/devices` 能看到真实设备与递增样本数** | ✅ | `PHT-6B4580` `n=599→602`，`fw=2.2.0-dev` |
| ③ | **`/series` 能查出连续数据** | ✅ | 原始 `count=599`，首行 `t=24.51 h=65.14 p=1003.92 mode=1`，末行 `t=25.08 h=61.27 p=1002.69` |
| ④ | **断网恢复不丢不重** | ✅ | `POST /push?full=1` 全量重推 600 条：`新入库 0 / 0 / 2`，服务器只 +3（期间新产生的），幂等成立 |
| ⑤ | **失败不阻塞采样** | ✅ | 把推送目标改到 `127.0.0.1:9` → `connection refused`、`failStreak=1`、退避 30s；**同期 `count` 1693→1694 照常采样** |
| ⑥ | **电源状态切换不崩** | ⚠️ 部分 | 满电插电态 ✅（4.18V/100%、`mode=1`、无重启、无断言）；**深睡分支未触发**（`sleep` 阈值 3.519V，设备满电）→ 待放电或低压时补测 |
| ⑦ | **连续跑数小时** | ⏳ 进行中 | 已连续运行 50+ 分钟、2 个推送周期：日志无 `panic/Brownout/WDT/assert`，服务器 8 小时后仍 `ok:true`、内存 11.7% 稳定 |

**顺带发现（下一轮可考虑）**：`/status` 里 `bv`（电池电压）与 `bp`（电量%）**是现成可用的**，
但 `DataPoint` 结构只有 `time/temp/humidity/pressure` → 推送里 `bv/bp` 恒为 `null`。
要让服务器侧也存电池曲线，需要扩展 `DataPoint`（或在采样时刻另存一份）；`mode` 已经从 `deviceMode` 带上了。

## D32-8 ⚠️ 编译/刷机流程（血泪版，别再踩）

**结论：在这个工作区里，arduino-cli 必须满足三个条件才能编出可被设备接受的固件。**

| 条件 | 为什么 |
|---|---|
| **① sketch 必须放在纯 ASCII 短路径**（如 `C:\phtbuild\PHT_2_0`） | 工作区路径含 `C++` → `platform.txt` 的 `cmd /c if exist ... COPY` 系列配方报 `The syntax of the command is incorrect.`（`device.ps1` 备注②早就记过这个坑） |
| **② 必须用一个全新的 build 目录** | 那些 `cmd` 配方只在**目标文件不存在**时才跳过；目录已存在时它们会真的执行并失败 |
| **③ token 写进 sketch 目录的 `build_opt.h`，并强制 sketch 重编** | `--build-property compiler.cpp.extra_flags=...` **不生效**（会被平台的同名属性覆盖）；写进 `build_opt.h` 后还得**碰一下源码时间戳**，否则 arduino-cli 认为"没改动"而复用旧 `.o`，token 白写 |

**token 到底进没进固件，别靠猜**：`/status.push.token`（`true/false`，只报有没有，不泄露值）。
本次就是靠它发现"编译成功但 token 没进去"——日志里 `token:false` + `401` 才揪出来的。

**完整命令**（需要沙箱外权限，因为 arduino-cli / esptool 都是 PyInstaller onefile，沙箱里派生子进程时自解压失败）：

```powershell
# 1) 复制 sketch 到纯 ASCII 路径
robocopy <仓库>\PHT_2_X C:\phtbuild\PHT_2_0 *.ino *.h /NFL /NDL
Rename-Item C:\phtbuild\PHT_2_0\PHT_2_X.ino PHT_2_0.ino

# 2) 写 token（构建期注入，绝不入仓库）
"-DPHT_API_TOKEN_RAW=<64 位十六进制>" | Set-Content C:\phtbuild\PHT_2_0\build_opt.h -Encoding ascii

# 3) 全新 build 目录编译（用一个不存在的目录名）
arduino-cli --config-file ~\.arduinoIDE\arduino-cli.yaml compile `
  --fqbn 'esp32:esp32:esp32s3:FlashSize=16M,PSRAM=opi,PartitionScheme=custom,FlashMode=qio,CPUFreq=240,CDCOnBoot=cdc' `
  --build-path C:\phtbuild\out C:\phtbuild\PHT_2_0

# 4) OTA
curl.exe -s -X POST -F "firmware=@C:\phtbuild\out\PHT_2_0.ino.bin" http://192.168.1.99/update
```

**为什么之前自己拼的直连工具链镜像被拒**：复用了上一次会话留下的 `core.a` 与库对象，
与当前 sketch 的段布局不匹配（我的产物 6 段 / 1405632 B，正规产物 7 段 / 1341067 B），
且 `esp_app_desc_t` 的定位与 esptool 的 `--elf-sha256-offset` 处理无法完全复刻 → 设备 `Update.end` 拒绝。
**`_build/` 里那套脚本保留作参考**（`appimage.py` 的镜像格式解析是对的，可当文档用），但**正常路径就走上面四条**。

## D32-9 更正与补充（2026-10-05 晚）

### ① 更正：D32-6 里那条"重启后不推积压"的怀疑**不成立**

当时看到 OTA 重启后 `pending=1`、`passes` 不涨，误以为是"游标超前于内存窗口导致积压永远推不上去"。
**实测推翻**：全量重推把游标推到最新（`lastSyncedTs=1791182010`）→ OTA 重启 → 游标原样恢复，
15 秒后自己推了 `pending=1` 的那 1 条（重启期间新采的点）。
**真相**：`pending=1` 本来就是对的；误导我的是 `passes`（`pushPassCount`）是**本次开机以来**的计数，
重启归零了。**教训：判断"卡没卡"要看 `pending` + 服务器侧的 `n`，不要看会话内计数器。**

### ② 顺手做的加固（留着，逻辑更顺也更安全）

- 把"游标夹紧"抽成 `pushClampCursor()`，并**提前到"无待传"判断之前**调用 —— 这样两条路径口径一致
  （原来只在真要推的时候才夹紧）。它只在**真的落后**时才动手，正常情况零副作用。
- 新增 `/status.push.cursorOk`：`true` = 环已推干净、`lastSyncedTs` 可以信；
  `false` = 中间有空档（刚夹紧过）。配合 NVS 键 `syncOk` 持久化，重启后也能看出来。

### ③ 屏幕黑屏（2026-10-05，硬件面）

**现象**：用户报告 2.13" 面板全黑（"像没通电"），但设备本身完全正常。
**软件侧已排除**（两条独立证据）：
- `/ui-dump` 读回：顶栏 1357 点、数据区 2449 点，内容齐全；
- 官方 `tools/screen-check.mjs`：6/6 全过，**中文标签 1261 点**（与基准逐像素一致）。

→ 驱动、映射、送显逻辑都正常；`display_on(true)` 也发过。
**注意**：ST7305 这类墨水屏是**双稳态**的 —— 就算控制器停摆，最后一屏画面也会一直留着。
所以"全黑"意味着**面板被刷成全黑之后又掉了电**（或排线松了/面板坏了），不是固件把它清黑。
**待用户现场确认**：① EN 开关关-开一次 ② 重插面板 FPC ③ 量面板 3.3V 轨。
**补充**：屏幕挂了不影响核心功能 —— 采样、SD 归档、网页、推送全部照常（已实测）。

## D32-10 验收④ 真凭实据版 + 一个既有采样空档（2026-10-05）

### ① 真实停机测试（不是"改目标地址"那种模拟）

| 步骤 | 实测 |
|---|---|
| 停 `pht-server`（14:46:05 ~ 14:47:46，**101 秒**） | 8080 停止监听；设备侧 `connection refused` |
| 停机期间在 PC 侧触发一次推送 | `❌ 推送失败：connection refused` → `failStreak=1` → 退避 30s |
| 停机期间设备采样 | `count` 1727 → 1728 **照常**（验收⑤ 复证） |
| 恢复服务器 | 设备**自动**在退避到点后推完积压：`📤 推送 15 条 → 新入库 15`（**无人干预**） |
| 服务器计数 | 638 → 638（那 15 条正是再之前一轮已推的，`accepted=15` 是新入库；总点数与设备缓存一致） |
| 断档检查 | 停机窗口（14:46:05~14:47:46）内采的 14:46:30 / 14:47:00 **都在** → **停机窗口零丢失** |

### ② 既有采样空档：**不是推送引入的回归**

全量 5.38 小时（638 点）里只有 **2 处** >90s 的空档，且都是 ~120 秒 / 漏 3 个点：

```
10-05 14:00:02 后空 118s   ← 当时跑的是【旧固件】（10-04 那版，没有推送代码）
10-05 14:38:00 后空 120s   ← 新固件
```

**结论**：**旧固件时期也有同型空档** → 与推送功能无关，是既有的采样/定时行为
（最像 NTP 校时导致墙钟回跳、采样网格重锚后重放的那 3 个槽位被跳过；
`loop()` 的"采样落后"日志在 49 条环形缓冲里已被冲刷，无法直接证实）。
**待查**（不阻塞本目标）：把 `/weblog` 环形缓冲调大或加个"空档计数器"，下次复现时抓现场。
`/log.csv` 里那 3 个槽位**也是空的** → 设备当时确实没采，不是传输丢的。

## D33 第三阶段：flash(/log.csv) 补传（2026-10-05 实装 + 上机）

### 起因

用户看到服务器上 `PHT-6B4580` 只有 **735 条**，而设备 flash 里明明有 **1831 条**（SD 卡还有 3 个归档文件）：
> "现在设备是在往服务器推东西吗🤔怎么只有这么点，我记得设备里东西不少吧？"

**是的在推**，但二阶段的数据源**只有 RAM 环（600 条 ≈ 5 小时）** —— 开机前的历史在 `/log.csv` 里，**从来没推过**。
服务器上那条 `needBackfillBefore` 提示（= `MIN(ts)`）一直在喊"我还缺更早的"，设备只记录不消费。

### 实装（`pushBackfillPass()` + `pushLogSeekAfter()`）

| 点 | 做法 |
|---|---|
| 数据源 | 流式读 `LittleFS /log.csv`，**不一次性读进内存**（日志可能上万行） |
| 只推有效时间 | 早期没校时的行存成 `HH:MM:SS`（`<1e9`）→ **跳过**，否则永久污染服务器时间轴 |
| 游标 | NVS `flashSync`（uint32）+ `flashDone`（bool）；每批成功后立即落盘，中断可续 |
| **防跳档** | 新增 `pushRamFloor`：补传未完成时，RAM 里比游标新的点**先不推** —— 否则会把"未来"的点推上去，中间那段永久成空洞 |
| 节奏 | 单轮上限 1200 行（≈6 批 × 200 条，批间 2s），推不完 2 秒后接着补，**不把任务占死** |
| 失败 | 走同一套退避（30→600s）；WiFi 掉线时任务 `continue` 重排，不会卡住主循环 |
| 补完 | `pushFlashDone = true` 落盘 → 之后只走内存环 |

### 上机结果（OTA 升级，14.8 秒）

```
📚 flash 补传 200 条 → 新入库 200（游标 ...）   × 4 批
📚 flash 补传 200 条 → 新入库 92
📚 flash 补传 200 条 → 新入库 0   × 3（这几批 RAM 环里也有一份 → 服务器幂等去重，新入库 0）
📚 flash 补传  53 条 → 新入库 25
📚 flash 补传：已到文件尾，切回内存环推送
```
**服务器：703 → 1852 条**，范围变成 **10-05 00:00:00 ~ 15:48:30（15.81 小时）**。
（"新入库 0"那几批正好证明了服务器的 `(device_id, ts)` 幂等去重在工作。）

### 还没做的

- **SD 归档**（`2026-10-02/03/04.csv`）当时仍未接入 —— 见 **D34**（已实装）。
- 反过来也值得做：**服务器 → 设备**的方向没有（设备无法补拉服务器数据），目前没这需求。

### 教训

补传最容易踩的不是"怎么读文件"，而是**防跳档**：一旦先推了新点，中间的空洞就永远补不回来了。
所以顺序必须是"**先把游标推过空洞，再放开新数据**"。

---

## D34 第三阶段下半段：SD 归档补传「牌组（deck）模型」（2026-10-05 实装 + 上机）

### 起因

D33 把 `/log.csv` 补上了，但服务器 `ts_min` 仍然卡在 **10-05**，而 SD 卡上躺着
`2026-10-02.csv` / `10-03.csv` / `10-04.csv` 三个冻结归档（10-02 12:42 起）。
用户："开整吧，整完这SD卡就歇会😎"

### 设计：把 `pushRamFloor` 换成「牌组」

D33 用 `pushRamFloor` 这个"下限"挡住 RAM，防止补传没走完就先推了新点。能work，但很脆：
**每加一个数据源就要再想一个下限**。改成牌组后这个机制整个删掉了：

```
数据在三处，时间上互不重叠，必须【从旧到新】依次补：
  ① SD 归档 /2026-10-XX.csv（冻结，每天一个）
  ② flash   /log.csv（最近几天，还在长）
  ③ RAM     内存环（最后 600 条）
```

**为什么不再需要下限**：每个牌组用**自己的游标**表进度；牌组**内部**天然按 ts 递增，
而**跨牌组**的顺序由调度保证（走完旧牌组才轮到新牌组）。顺序本身就杜绝了"跳过空洞"。

| 点 | 做法 |
|---|---|
| 列归档 | `pushSdCollect()`：列根目录，挑 `YYYY-MM-DD.csv`（14 字符 + 两处 `-`），插入排序（字典序 == 时间序） |
| 选下一个 | `pushSdFindNext()`：从上次的文件往后找，用 `pushLogSeekAfter(f, 0)` 探"有没有可信时间" |
| 通用牌组 | `pushBackfillDeck(File&, uint32_t& cur, tag, maxRows, …)`：SD 与 flash **共用同一份实现** |
| 调度 | `pushBackfillTick()`：一次只走**一个**牌组，单轮上限 1200 行（≈6 批），推不完 2s 后接着来 |
| 游标 | 每批成功后立即推进 + 落 NVS（`sdSync`/`sdFile`/`sdDone`），换页/断电都能续 |
| 收尾 | 走完整份（`sent==0`）→ 记下文件名，下轮自动前进；没有更新的文件了 → `sdDone=true` |

任务循环里那段只认 flash 的分支，整段换成了：

```cpp
// ---- 第三阶段：补历史（SD 归档 → flash → RAM），先旧后新，一次只走一个牌组 ----
if (pushBackfillTick()) continue;
```

### 两个防呆（都是真会咬人的）

1. **卡没挂上 ≠ 补完了。**
   `initSD()` 失败只置 `sdOK=false`，运行中还能靠 `ensureSD()`（插卡/网页操作触发）重挂。
   如果 `pushSdFindNext()` 探不到文件就判定"已补完"，**整个 SD 归档会被永久跳过**。
   → `pushBackfillPick()` 先查 `sdOK`，未就绪则本轮先补 flash，等卡上来再说。

2. **文件打不开不要死循环。**
   卡在 `pick` 和 `open` 之间被拔掉的话，下一轮会立刻重试、无限刷日志。
   → 打一条日志 + `pushReschedule(120)`，2 分钟后再来。

### 上机结果（OTA 后自动完成，无需人工干预）

**服务器 `PHT-6B4580`：1852 → 6418 条，`ts_min` `1791163440` → `1790916120`。**

```
10-02  221      ← SD 归档 12:42:00 起
10-03 1544
10-04 2757
10-05 1896      ← RAM/flash，还在涨
覆盖 10-02 12:42:00 → 10-05 16:10:30
```

- `/days` 从 **1 天** 变 **4 天**。
- **SD→flash 交接处 0 断点**（10-04 01:39:30 归档结束点两侧连续）。
- 全量只剩 19 处 >90s 断点，其中最大一处 **65730s**（10-02 14:26 → 10-03 08:52）
  —— 那是**设备真实停机期**，正好落在两个归档文件之间，不是补传遗漏。
- 编译体积：1345723 B (8% program) / 66056 B (20% dynamic)。

### 教训

- **别用"下限/水位"去补洞，用"牌组 + 每牌组各自游标"**。前者每加一个数据源就多一个坑，
  后者是结构性的正确：只要"从旧到新"这个顺序在，空洞就不可能被跳过。
- **"读不到" 和 "没有了" 是两件事**，在补传逻辑里必须分开处理 —— 把前者当后者，
  代价是永久丢掉一整个数据源。

### 踩坑记录（工具链，非固件）

给 `PHT_2_X.ino` 打这个补丁时，**脚本改文件连续翻车三次**（CRLF 锚点不匹配、
`replace` 把注释替换成整段新代码导致新旧代码拼在一起、丢掉函数闭合花括号），
每次都是编译报一堆"函数定义不允许出现在这里"之类的连环错。
最后**放弃脚本，改用逐处 `edit` 手工替换**才过。结论：**这个文件不要再上自动化补丁脚本。**

## D35 设备一机一密（HMAC 签名 + NVS 密钥）· OTA 构图根因修正（2026-10-05 实装 + 上机）

### 起因

静态 token 是"全网一把钥匙"：抓到一个包的 `X-PHT-Token` 就能冒充任意设备写数据。
改成一机一密：**每台设备自己生成密钥、只存 NVS、固件里没有**；推送时用
`HMAC-SHA256(secret, "v1|device_id|ts|body")` 签名，服务器按 device_id 取密钥验签。

### 密钥来源与生命周期

| 环节 | 行为 |
|---|---|
| 生成 | 设备用 **TRNG**（`esp_random()`）生成 32 字节密钥，hex 存 NVS（`dkSec`/`dkId`/`dkAt`） |
| 上报 | 只把**公开的 `key_id`** 显示在网页；服务器存一份 secret 副本用于验签 |
| 注册 | 设备自己 POST `/api/v1/devices/{id}/key`，带 `X-PHT-Enroll` 口令；**仅内网** |
| 回退 | 没绑定密钥时仍用旧 `X-PHT-Token`（过渡期），绑了之后旧路径**自动失效** |

`dkSec` 这类 NVS 键名是刻意短的；密钥**绝不进固件**（见 D32-5 的构建期注入约定）。

### 验证链路（三道门 + 三处实测）

服务器注册接口 `_require_enroll()`：

1. **口令没配 → 整个接口禁用**（安全默认）。实测返回
   `503 服务器未配置 PHT_ENROLL_PASSWORD，密钥注册已禁用` ✅
2. **来源必须是内网**，用**直连对端 IP**，不解析 `X-Forwarded-For`
   （否则伪造个头就能从公网注册）。实测非允许网段 → `403` ✅
3. **绑定口令**走请求头 `X-PHT-Enroll`。实测正确 → `200`，错误 → `401 绑定口令错误` ✅

⚠️ **踩坑**：口令是**请求头**，不是 JSON 正文里的字段。
`DeviceKeyBody` 只有 `secret` 和 `key_id`；把口令塞进正文会被 Pydantic 忽略、
然后在校验处报"口令错误"，看起来像口令错，其实压根没传进去。

### 上机实测（2026-10-05，设备 PHT-6B4580）

```
/devkey  → {"bound":false,"selftest":true,"clockOk":true,"wifi":true}
POST act=gen    → {"ok":true,"keyId":"0a677bbb5cf876819d8115daeec58419"}
/devkey  → {"bound":true,"keyId":"0a677bbb5cf876819d8115daeec58419","setAt":1791206303}
POST act=enroll → {"ok":true}
服务器    → key_id=0a677bbb5cf876819d8115daeec58419  has_secret=True   ← 与设备完全一致
act=push  → lastOk=True failStreak=0 lastAccepted=9 pending=0
```

**关键点：这份固件是用 `-NoToken` 编译的 —— 镜像里根本没有静态 token**
（已用字符串扫描确认 `0e27efee…` 不存在）。所以推送成功**不可能是回退路径**，
只能是 HMAC 验签通过。

反向验证（都符合预期）：

| 尝试 | 结果 |
|---|---|
| 旧静态 token 推已绑密钥的设备 | `401 该设备已绑定密钥，请改用签名认证（固件需升级）` |
| 伪造 HMAC 签名 | `401 设备签名无效` |

第二条同时说明**绑定密钥即自动关闭该设备的旧 token 通道**，无需额外吊销动作。

### `selftest` 是什么

`pht_crypto.h` 里自带一份 SHA-256（FIPS 180-4）+ HMAC-SHA256（RFC 2104），
不依赖 mbedTLS。`pht_crypto_selftest()` 用三个标准向量自检
（`SHA256("abc")`、`SHA256("")`、RFC 4231 的 `key`/`fox` 向量），
开机跑一次，结果就是 `/devkey` 里的 `selftest` 字段。真机上为 `true`。

### ⚠️ D32-6 的真实根因：不是 linker、不是段数，是 `appimage.py` 本身

D32-6 当时把 OTA 被拒归因于"新镜像只有 6 个段"。**这个归因是错的。**
拿到 esptool 5.4.0 源码后逐字节复查，真因是 `appimage.py` 的构图逻辑有两个硬伤：

**硬伤 1：不做 flash 段的 64 KB 对齐。**
`ESP32FirmwareImage.save()`（`bin_image.py` L905-931）会**切开后面的 RAM 段**，
用它的前部当对齐填充，剩下的部分再作为独立段写出。这就是旧镜像"多一个段"的来源
—— 不是另一个 IRAM 区，而是**被切剩的尾巴**。`appimage.py` 从不做这件事，
于是段表写完第三段就错位。

**硬伤 2：尾部照抄参照镜像。**
被拒镜像的末尾 48 字节实测是：

```
006004a2b07fc01d369f2db56a5ee505 37d4e21fecc08090d654bf6d53f21d82 b45398574a9f8f7ff35ba0969a1a2a98
└──── 1+15 字节垃圾 ────┘└────────── 参照镜像的 SHA-256 ──────────┘
```

**它把自己参照镜像的哈希原样抄了进去**。段表解析在第 4 段直接读到
`addr=0x00002000 len=241659970`（越界 2.4 亿字节），checksum 字节是 `0x00`（应为 `0xAB`）。

**结论：`appimage.py` 产出的镜像从来就不是合法镜像。**
它此前"能用"，只是因为旧镜像恰好也由它生成、两边一样错。

### 修正：直接调用 esptool 自己的构图代码

新增 `_build/esptool_img.py`：**加载 esptool 5.4.0 的 `bin_image.py` 并调用它的
`save()`**，所以输出与 `esptool elf2image` 逐字节一致。

esptool 包会拉进 rich_click / pyserial / cryptography / intelhex 等重依赖，
但只需要 `bin_image`，所以给它的相对导入父模块喂上它真正用到的那几个常量与函数
（`byte`/`pad_to`/`get_bytes`/`FatalError`/`ESPLoader.checksum`，均照抄 esptool 源码）。
`targets` 里的芯片类名**从 `bin_image.py` 自己的 import 语句解析**，换版本不会漏。

还差一步：这个工具链的 ELF **本身就不合法** —— esptool 会主动拒绝：

```
Segment loaded at 0x3c0f0120 lands in same 64 KB flash mapping as
segment loaded at 0x3c0f0020. Can't generate binary.
```

原因是这批目标文件把同一映射区的节拆开了（IDF linker 通常会合并）：

| 节 | 地址 | 长度 | 说明 |
|---|---|---|---|
| `.flash.appdesc` | `0x3C0F0020` | 256 | 与下一节同区 |
| `.flash.rodata` | `0x3C0F0120` | 301608 | **正好接续**（`0x20+256=0x120`） |
| `.rtc.data` | `0x50000200` | 8 | 与下一节同区 |
| `.rtc.force_slow` | `0x50000208` | 32 | 正好接续 |
| `.rtc.text` | `0x600FE000` | 92 | 与下一节同区 |
| `.rtc.force_fast` | `0x600FE05C` | 4 | 嵌套在 `.rtc.text` 内 |

所以 `esptool_img.py` 增加了 `merge_same_region()`：**只合并 flash 映射区的节**
（RAM 段必须保持独立，esptool 还要切它们做对齐），按地址铺开、空隙补 0。

这同时印证了参照镜像的布局：它的 DROM 段是 **301180** 字节 = `0x20+256+301608`
（合并前 `256+301608=301864`，差 684 是版本差异），即**参照镜像本来就是合并过的**。

### 上机结果（同日）

```
编译：ELF 16.25 MB  →  镜像 1352368 B (1320.7 KB)，10 段，sha256 self-check OK
OTA ：✅ 更新成功！设备重启
/devkey → {"bound":false,"selftest":true,"clockOk":true}       ← 新端点从 404 变 200
POST act=gen / enroll → 与服务器 key_id 一致
act=push → lastOk=True pending=0，样本入库（7038 条，最新 80s 前）
```

**遗留**：`build.ps1` 仍复用旧 build 目录 `C:\phtc\build`（`core.a` + 库对象）。
它能用，但那批对象的节划分与 IDF 默认不同（才需要 `merge_same_region`）。
**根治办法是干净重编**（见 D32-8 的流程）。当前先用合并逻辑绕开。

### 教训

- **"看起来能跑" ≠ "格式正确"。** `appimage.py` 的镜像自检一直报 OK，因为它
  拿参照镜像的尾部当模板 —— **自检逻辑与被检对象同源，就永远不会发现错**。
  真正揭穿它的是一次**外部对照**：拿接受版镜像逐字节比对段表与尾部。
- **别手工实现别人已经写好的格式。** 直接加载 esptool 的 `bin_image.save()`，
  比任何"照文档重写"都可靠，而且以后换版本只要把源码目录指过去。
- **报错信息会把锅甩给别处。** "Update.end 校验失败（固件无效？）"让人一路去查
  linker、段数、哈希算法，而真因在一个自制的 200 行构图脚本里。
- **自检要通过"改变输入"来验证。** HMAC 那条链路之所以可信，是因为
  `-NoToken` 构建让回退路径**物理上不存在**，同时又实测了旧 token 与伪造签名都被拒。

---

### D35 附：操作手册

**加设备 / 加用户**的逐步操作（含每步预期结果、排错对照表、安全边界）见
仓库外的 `docs/加设备与用户SOP.md`。

> 为什么单列一条：D35 记的是**实现原理**，不是"照着做"的步骤。而加设备时真正
> 容易踩的是操作细节 —— 例如**设备网页根本没有密钥入口**（`/devkey`、`/pushcfg`、
> `/devname` 都是 JSON 接口），所以步骤是命令而不是点按钮；
> 以及**注册请求是设备发给服务器的**，所以服务器的"仅内网"检查看的是**设备的 IP**，
> 与你在哪台电脑敲命令无关。

---

## D36 设备网页补「密钥 / 推送地址」配置页（2026-10-05）

### 起因

写「加设备 SOP」时才发现的：`/pushcfg`、`/devkey`、`/devname` **只有 JSON 接口**，
在固件里对它们的 **UI 引用是 0 处**（`pushcfg` 全文只出现 1 次，就是它自己的处理函数）。
结果「加一台新机器」要手敲 5 条 `curl` —— 一次两次还行，作为一个**要被照着做的
流程**就不合格了。

### 做法：只补 UI，**后端零改动**

新增 `/keycfg` 页面（`keyPageHtml()`），它只驱动**已经存在**的 JSON 接口：

| 页面上的操作 | 调用的接口 |
|---|---|
| 看状态 | `GET /devkey` + `GET /push` + `GET /devname` |
| 保存推送地址 / 暂停推送 | `POST /pushcfg`（`on` / `host` / `port`）|
| 保存设备名 | `POST /devname`（`dev`）|
| 生成 / 注册 / 清除密钥 | `POST /devkey`（`act=gen\|enroll\|clear`，注册带 `pw`）|

⚠️ 这些 POST 都是 **form-urlencoded**（固件用 `server.arg()` 读），不是 JSON ——
页面里的 `post()` 辅助函数按 `application/x-www-form-urlencoded` 编码。

### 入口**故意低调**，但页面内**警告拉满**

这是本次最关键的设计取舍。设备网页**没有任何鉴权**（同局域网的人都能打开），
而这一页的按钮能让设备**立刻和服务器失联**。用户的原话是：

> 「不然我朋友肯定不可能带着设备出现在我家，点一下按钮，设备立刻和服务器失联」

所以：

* **入口低调**：放在「🛠 系统」卡末尾，一行 `font-size:11px; color:#a0aec0` 的灰色小字，
  **不是**和「WiFi设置 / OTA升级」并排的按钮。找得到，但不扎眼。
* **页面内三段警告**（红框）：① 生成/清除密钥后立刻无法推送 ② 换完必须马上注册，
  否则一直 401 ③ **本页没有口令保护，同局域网任何人都能点**。
* **危险操作二次确认**：`doGen()` 确认一次；`doClear()` **确认两次**
  （第二次专门再问一遍"真的要清除吗"）。
* **防顺序点错**：未绑定密钥时，「注册到服务器」与「清除密钥」按钮**禁用**
  （`disabled=!k.bound`）—— 没生成就注册本来也会被设备拒绝。

### 上机验证（2026-10-05 晚）

```
编译          : ELF 16.27 MB -> 镜像 1360064 B (1328.2 KB)，9 段，sha256 OK
                镜像内 old token / current token 均 absent，且含 "keycfg"
OTA           : ✅ 更新成功
GET /keycfg   : 200，6339 字符；三段警告与三个按钮都在
主页          : 含 href="/keycfg"，样式确认为 11px 灰字（低调）
密钥跨 OTA    : bound=true，keyId 不变，selftest=true
推送          : lastOk=true failStreak=0
页面 JS       : 抽出后 node --check 通过；JS 引用的 9 个 id 与页面定义一一对应
```

**「密钥跨 OTA 保住」这条值得单独记**：NVS 分区独立于 app 分区，所以
**升级固件不会清掉密钥** —— 这正是当初"内网绑一次、之后随便 OTA"能成立的前提。
这次顺手实测确认了。

### 一个换行符的坑（写给下一个改 .ino 的人）

`PHT_2_X.ino` 是 **纯 CRLF（7031 行）**，而 `PHT_SERVER` 下的 `.py/.html/.md`
都是 **纯 LF**。用 Python 脚本改 `.ino` 时**必须匹配换行符**：

* 锚点按 LF 写 -> 在 CRLF 文件里**根本匹配不到**（报 anchor not found）
* 就算匹配上了，插入 LF 文本会让文件变成**混合换行** -> 产生整文件重写的假 diff

正确做法（见 `_b/p9_keypage.py`）：`io.open(..., newline="")` 读、
把所有锚点与插入文本统一 `replace("\n", "\r\n")`、再以 `newline=""` 写回，
并在写入前后各断言一次"是否仍是纯 CRLF"。

---

## D37 设备「身份 / 显示名」分离 + 以服务器为准的对时（2026-10-05）

> 服务器侧的对应改动见 `PHT_SERVER/开发日志.md` §9.10。本节只讲**固件侧**。

### 一、两个概念彻底分开

| | `pushDevId` | `pushDevName` |
|---|---|---|
| 是什么 | **身份** | **显示名** |
| 来源 | `ESP.getEfuseMac()` 派生 `PHT-<MAC后6位>` | 用户设置（设备网页或服务器网页） |
| 变不变 | **终身不变** | 随时可改 |
| 进签名串 | ✅ | ❌ |
| 进注册 URL | ✅ | ❌ |
| 进推送 body 的 `device` | ✅ | ❌ |
| 服务器样本归属 | ✅ | ❌ |
| NVS 键 | `devName`（沿用老键以兼容降级） | `devShow` |
| 长度/字符 | 定长 ASCII | UTF-8，≤24 **码点**（中文一个字算一个） |

**为什么用 `getEfuseMac()` 而不是 `WiFi.macAddress()`**：后者能被
`esp_wifi_set_mac()` 改掉，前者是**出厂熔丝值**，跨刷机/OTA 恒定。

**老库迁移**：老固件只有一个 `devName`，它既当身份又当显示名。
如果老库里存着一个**不等于**派生值的名字，说明那台设备在服务器上的身份就是
那个名字 —— 必须继续沿用它当 ID，否则历史数据对不上账。
显示名统一从空开始（服务器与网页都会回退显示 ID）。

### 二、改名：**服务器验签通过才落 NVS**

```
设备网页输入名字 → POST /devname
  → 本地校验（1~24 码点、无控制字符）
  → 必须已绑密钥 + 已连 WiFi + 时钟可信
  → 组装 {"name":"..."} 并 **用设备自己的密钥签名**（X-PHT-Auth）
  → POST /api/v1/devices/<身份>/name
  → 只有 200 才 strlcpy 到 pushDevName + savePushConfig()
  → 否则拒绝并提示（原因同时写进设备日志）
```

**为什么这样设计**：网络断了你本地改了、服务器没改，两边就长期不一致；
而且服务器是"改名通知"的源头，本地擅自改会被它下次下发覆盖回来。
所以**"保存成功"就意味着服务器已经记下了**，两边不会分叉。

**为什么用密钥签名而不是绑定口令**：绑定口令能**给任意设备换密钥**
（= 劫持数据流），绝不能交给朋友。而签名只能证明"我是这台设备"，
正是这里需要的，且设备本来就有密钥 —— **不需要任何口令**。

**重名不再拒绝**：服务器允许重名（只影响观感），响应里回 `duplicate_of`，
固件把提示写进日志。服务器网页展示时会给重名的加 ` ·<ID后4位>` 后缀。

### 三、以服务器为准的对时（NTP 退居二线）

服务器给**所有**响应加 `X-PHT-Now: <Unix秒>`；固件在推送响应里读它
（`http.collectHeaders` + `http.header`，**必须在 `http.end()` 之前读**）。

**为什么这个功能很值**：签名窗是**拿服务器的钟判的**。设备钟漂了 >90 秒 →
每次推送必然 401；而 NTP 为省电只在"插电 + ≥3 天"才跑（用户明确要求绝不为
NTP 用电池连 WiFi）→ **电池供电时数据会一直堆着传不上去，直到插上电**。

而服务器把时间放在**响应头**里（含 401/429），所以：
**时钟坏掉时推送虽然 401，但 401 也带着时间 → 设备下一次推送就自愈了。**
如果只在"成功响应"的 body 里放时间，它永远拿不到时间、永远好不了。

**对电池策略零冲突**：推送本来就在发生，对时是顺带的，不额外开射频。

**层级**：① 服务器（能连上就用，最权威）② DS3231（离线基准）
③ NTP（仅"RTC 掉电 + 服务器够不到"时兜底）。**NTP 不下岗** ——
设备要往 SD 写时间戳，离线时必须有时钟。

#### ⚠️ 向后跳时钟会静默丢数据（必须一起处理）

```
推送只发 ts > lastSyncedTs 的点
把时钟往回拨 Δ → 新采的点时间戳变小 → 可能落到游标之下
→ 永远发不出去（RAM 环和 SD 归档两条路都卡住）
```

规则（写在 `applyServerTime` 的注释里）：

* **偏差 < 30 秒 → 整个忽略**（别为几秒折腾系统钟）
* **向前校正** → 直接跳，安全（最多留个空档）
* **向后校正** → **同时回退 `lastSyncedTs`**（还多退 60 秒留余量）并置
  `pushCursorValid=false`。被跳过的点会**重发**一遍 ——
  服务器按 `ts` 幂等去重，**重发无害、漏发有害**。

### 四、可观测性：`pushSrvClock`

只在"偏差够大"时才打日志的话，**"头压根没读到"这种静默失效根本看不出来**
（功能会悄悄变成空转）。所以：

* 新增全局 `pushSrvClock`，每次读到就记下来，并暴露在 `/status` 的 `push` 里；
* 第一次发现响应里**没有** `X-PHT-Now` 时打一条警告（只打一次，免得刷屏）。

实测：`push.srvClock = 1791213565`，与服务器 `date +%s` 差 18 秒（含等待时间）
→ 头确实读到了、时间确实是对的。

### 五、顺手修掉一个老 bug：`/devname` 返回的不是合法 JSON

原来的拼接是：

```cpp
",\"cursorOk\":" + (pushCursorValid ? "true" : "false") +   // 说明文字 ",\"enabled\":" +     ← 字段名被注释吞了
String(pushEnabled ? "true" : "false") + "}";
```

行尾注释把字段名 `,"enabled":` 一起吃掉了，于是拼出
**`"cursorOk":falsetrue}`** —— 任何 JSON 解析器都会直接报错
（我自己的验证脚本就先踩到了）。已把 `,"enabled":` 移出注释独立成行。

> 教训：**字段名不要写在行尾注释能碰到的地方。**
> 这类 bug 编译器不会报，只有真去 parse 才发现。

### 六、本地网页标题

设备网页的 `<title>` 与 `<h2>` 现在显示**显示名**，为空则回退出厂默认
（分别是「微型气象站 v2.1」和「气象站 v2.1」）。

实现方式是**把 raw 字面量切开**插入 `pushTitle(bool)`：

```cpp
<h2 style="margin:0">)rawliteral" + pushTitle(false) + R"rawliteral( <span ...
```

比"运行时对整页做字符串替换"更安全（不会误伤别处的同名字符串）。

主页「🛠 系统」卡里加了一行**设备名输入框 + 保存按钮** ——
**无害的东西放明面**（朋友要能自己改），危险的才低调放在 `/keycfg`。

### 七、上机验证

```
编译          : 1333.8 KB / 10 段 / sha256 OK
OTA           : ✅ 更新成功；密钥跨 OTA 保住（同 keyId、selftest=true）
/devname      : {"dev":"PHT-6B4580","name":"阳台 🌤",...,"cursorOk":true,"enabled":true}  ← JSON 已合法
设备自助改名   : {"ok":true,"name":"阳台","dev":"PHT-6B4580"}
服务器库       : name='阳台' pending=0（设备改的 → 不需要回传）
网页标题       : <title>=阳台  <h2>=阳台
管理员改名     : pending=1 → 一次推送后 pending=0、下发日志 1 次、设备采纳 '阳台 🌤'
再推一次       : 下发日志仍是 1 次（不空转）
非法名         : 空 / 仅空白 / 25 字符 → 全部被拒
对时           : /status 的 push.srvClock 非零，与服务器时间一致
```

**未能上机验证的一条**：设备没有设置时间的接口，无法在真机上制造 >30 秒偏差，
所以**"实际执行校正"这条路径没跑过** —— 只验证了"头读到且时间正确"。
校正逻辑很短且带守卫（`pushCursorValid` 为假时不动游标），风险低，但如实记录。
