StellaRigel/ESP32-Pressure-Temperature-Humidity-Recorder/设计文档.md

# 气压温湿度记录器V2.0

> **文档结构**：主干按版本递增（`V2.0` → `V2.1` → `V2.1.1` …），**只增不改历史**。
> **状态标记**：各版本小节标题带 `🚧 正在开发 / ✅ 已实装 / 💤 搁置` —— **当前在干什么，直接翻带 🚧 的那一章**。
> **归置规则**：各版本规划的功能原则上**要在对应版本实现**；实现过程中的**改动与新待办一律写进该版本小节**；附录只作参考与决策留档，附录 α 是**想法池（非待办）**，升级为待办须移进开发中的版本。
> **职责边界**：本文档只写**硬件与功能规格**；实现进度 / 工程结构 / 代码怎么调屏幕 / 待办清单见 [`README.md`](README.md)（状态以其**状态总表**为准）。

---

## 硬件

- 控制器为ESP32-S3 N16R8，带有16MB Flash和8MB PSRAM
- 电源管理芯片为BQ24074
- LDO为SPX3819，将BQ24074的输出稳压为3.3V
- 带有电池，容量1800mAh
- 带有Type-C接口和Micro-SD卡槽
- 带有SMA外螺内孔天线接口，引出自ESP32的IPEX天线座
- 气压传感器为BMP580
- 温湿度传感器为SHT30
- RTC时钟模块为DS3231
- 屏幕为鱼鹰科技2.13寸TFT全反屏

---

### 电路设计

#### ESP32接线  

1. I2C总线
    - IO4-SDA
    - IO5-SCL
1. SD卡
    - IO6-CS
    - IO7-MOSI
    - IO15-SCK
    - IO16-MISO
1. USB
    - IO19-D-
    - IO20-D+
1. 模组功能
    - EN-复位按钮
    - IO0-烧写模式按钮
1. 电源管理
    - IO9-电池电压采样，由两个1M电阻分压  
    - IO2-BQ24074＠PGOOD(检测是否接通外部电源)
    - IO21-BQ24074＠CHG(检测是否正在充电)
2. 屏幕(SPI接口)
    - IO10-CS2
    - IO11-DC
    - IO12-RES
    - IO13-SDI
    - IO14-SCLK
3. 特殊引脚(不得使用)
   - IO3
   - IO8
   - IO45
   - IO46
   - IO47
   - IO48

#### 供电方式和电源管理  

1. 内置电池
   - 容量1800mAh，最大0.5C放电

2. 外接电源
   - USB/5V电源适配器

电源管理芯片接线方式如下，对于一个分支只接一个两脚元件的引脚，以下会列出链条

- IN-5V输入
- OUT-SPX3819@IN&EN
- EN1-R_EN1-GND
- EN2-R_EN2-GND
- PGOOD-ESP32S3@IO2、PWR_LED
- CHGESP32S3@IO21、CHG_LED
- TMR-GND
- EP-GND
- CE-GND
- VSS-GND
- TS-R_TS-GND
- ILIM-R_LIM-GND
- ISET-R_SET-GND
- ITREM-R_TERM-GND
- BAT-Battery+
  *R_EN1和R_EN2的阻值为2K,R_SET和R_LIM阻值为1K,R_TREM阻值为3K,R_TS阻值为10K*

另有一3P排针负责配置EN1/EN2,约定其引脚从左侧开始为1,依次递增,则其引脚接线为:

- 1-EN2
- 2-R_H-BQ24074@OUT
- 3-EN1

由此，短接1和2可使EN2为高电平，EN1为低电平，进入外部电源模式，启用大电流充电，短接2和3则使得EN1为高电平，EN2为低电平，进入USB500模式，排针三脚均不处理则进入USB100模式，实际使用中，USB100/500模式仅在测试阶段使用，外壳封装后，设备一直运行在外部电源模式

--- 

## 软件  

> **启动顺序重排（2026-10-03）**：重新排列启动顺序，优化启动速度（24s → 8.6s）。

### 核心模块

#### 数据采集和记录  

通过BMP580和SHT30采集气压与温湿度，采集间隔为30秒，对齐网络时间，在每个HH:MM:00和HH:MM:30时刻采集，数据暂存在Flash。

每日2:00 AM将当日的数据写入SD卡，以CSV格式储存。

采集的最新数据显示在屏幕上，且屏幕常亮。

### 附加模块

#### 连接到智能设备

1. 热点连接（AP）
    连接设备热点后可查看网页，仅WiFi连接失败时可用
1. WiFi连接
    连接WiFi后，可通过局域网访问网页，同时设备会自动尝试从网络同步时间

#### 交互和可视化

##### 网页
   - 显示最新测量值
   - 显示当日极值和要素24h变率
   - 显示电源状态，包括电池电量（电池供电时）和当前供电方式
   - 显示连接状态
   - 显示当日每时刻气压距平曲线
   - 可手动下载flash中的数据和SD卡中的文件，也可以清空flash中已有的数据
   - 可查看日志
   - 可手动同步时间

24h变率说明：

对**温度、湿度、气压三要素**各给出一个 24h 变率（网页端「要素24h变率」的完整含义）。

- **定义**：变率 = **当前整点值 − 24 小时前同一整点的值**；**整点更新，每小时一次**，整点之间沿用上一个整点的结果。
- **依赖**：一块常驻 RAM 的 24 槽整点环，**不落盘** → 重启后需重新积累 24 小时；缺测的要素当次不写入环、该要素变率留空，不影响其他要素。
- **显示**：屏幕在各数值行右侧右对齐（箭头 + 绝对值，省略单位）；网页为图标 + 带符号数值。
  **阈值按量纲分开**：温度(°C)/气压(hPa) 用 **0.1**；**湿度用绝对湿度(g/m³)，阈值 0.5**（≈2.2 %RH，见下）。判定：`Δ ≥ 阈值` ↑ / `Δ ≤ −阈值` ↓ / 其余 →。
  > ⚠️ 湿度阈值必须单独定：0.1 是为 %RH 设的；换成 g/m³ 后 0.1 只相当于 **0.4 %RH**（比传感器噪声还小），箭头会永远在跳。室温下 **1 %RH ≈ 0.23 g/m³**，故取 0.5（代码：`ui_display.h` 的 `UI_TREND_TH` / `UI_TREND_TH_AH`）。

> 完整规格（缺测与显示细则）、代码落点（`hourRing[24]` / `UI_TREND_TH` / `setTrend()` / `/status` 字段）与版面参数 → [`实现细节.md`](实现细节.md) **D23**（版面见 **D6**）。

### 电源管理模块

电源管理模块包含两种模式。

1. 外接电源
     - WiFi/AP二选一，未配置WiFi连接或WiFi连接失败时启用AP，否则仅启用WiFi
     - 网页服务器正常运行
     - 屏幕刷新和数据刷新同步，每次获取数据后均刷新屏幕内容
2. 电池供电
     - 仅核心功能保持开启，关闭所有附加功能
     - 屏幕仅在整分钟时刷新
     - 随着电池电压下降，设备会逐级退化，低于3.6V时，存档数据至SD卡，低于3.55V时，停止采集数据，低于3.5V时，设备深睡眠，插电后自动进入外接电源模式。

---
---

# V2.1中的改动 —— ✅ 已实装（2026-09-15）

> **本版要点**：充电控制改为「CE 软件停充 + ISET 切换 MOS + INA226 电池监测」，WiFi 实体开关由 IO35 飞线到 IO9，
> 并新引入「设备模式（固定 / 移动）」这一统一配置项。
> **实现细节**（充电原语与 80% 滞回 / 低电三档 / 蓝牙三批 / 屏幕与 toast / 多组 WiFi）→ [`实现细节.md`](实现细节.md) **D1~D4、D6、D8、D18**；
> **飞线过程与踩坑** → [`实现细节.md`](实现细节.md) **D24-1**；**不可用引脚** → 本档 **附录 A**。

## 硬件

- **撤销原「新增两个 MOS 管」方案**：改为 **1 个 ISET 切换 MOS + CE 引脚软件停充 + INA226 电池监测**。
- 原 IO17（截止点切换）改由 BQ24074 的 **CE 引脚软件控制**，不再用 MOS 管。
- 原 IO18（电流切换）保留为 **ISET 电阻切换 MOS 管**（拉高=快充，拉低=慢充）。
- **电池采样改由 INA226 电压通道承担** → IO9 的分压（两个 1M 电阻）方案退役、IO9 释放，本版焊为 **WiFi 实体开关**。
- 特殊引脚（不得使用）：IO3、IO8、IO45、IO46、IO47、IO48（后两者为 1.8V VDD_SPI 域，防烧芯片保守禁用）。

### 电路设计

#### ESP32接线

| 引脚 | 接到 | 用途 |
|---|---|---|
| IO17 | BQ24074@CE | 软件停充（固定模式充到 80% 拉高停） |
| IO18 | ISET 切换 MOS 管 | 拉高=快充，拉低=慢充 |
| IO2 | BQ24074@PGOOD | 检测是否接通外部电源 |
| IO21 | BQ24074@CHG | 检测是否正在充电 |
| IO4 / IO5 | INA226（I2C，地址 0x40） | 电池电压 + 充电电流（与传感器共用总线） |
| IO9 | WiFi 实体开关 | 原为电池分压采样；**IO35 与 Octal PSRAM 冲突 → 飞线改到 IO9**，详见 [附录 A](#附录-a不可用引脚清单n16r8) |

## 软件

### 核心模块

#### 数据采集和记录

- 采集时记录**设备所处模式**，存档 / 下载时单开一列记录模式代码：**0 = 固定，1 = 移动**。
- 传感器读数异常或失联时**不伪造数值**：该要素记为无效，CSV 中写 `N/A`，屏幕以横杠占位符显示（`--.-°C` / `--%` / `----hPa`）。

> `/log.csv` 第 6 列「模式」取记录时刻的 `deviceMode`；旧文件开机自动迁移（旧 5 列行补占位符 `-`）。
> 实现细节 → [`实现细节.md`](实现细节.md) **D19 ③**。

### 附加模块

#### 连接到智能设备

1. **新增蓝牙连接（配网 + 只读页）**
   > **⛔ 已整体搁置（2026-09-14）**：三批功能均已实装并手机实测通过，现不编入固件；
   > 「配网 / 野外查看」改由 **AP 热点 + 多组 WiFi + IO9 按钮**三件套覆盖。实装细节 → [`实现细节.md`](实现细节.md) **D4**。
2. **WiFi 连接**
   - 新增**多组 WiFi** 的 SSID/密码存储，WiFi 启用后自动选**强度最高**的连接（最多 5 组）。
   - 连接成功后在屏幕上显示所连 WiFi 与 IP（整条提示横幅）。
   - 新增**网页重启** `GET /reboot`（装上壳后够不到 PCB 上的 EN 键时的兼底）。
   > 细节 → [`实现细节.md`](实现细节.md) **D18**（多组存储与选网）、**D8**（横幅版面）。
   > 现行无线语义（按钮 / AP 兜底 / 静态 IP）以 **[无线策略与静态 IP（现行）](#无线策略与静态-ip现行--生效中2026-09-17-由附录-bc-提炼)** 为准；搁置决策留档 → [`实现细节.md`](实现细节.md) **D24-4**。

#### 交互和可视化

1. 气压距平曲线仅**固定模式**下可用，距平曲线所用平均值也**只用固定模式数据**计算（实现细节 → [`实现细节.md`](实现细节.md) **D2**）。
2. 蓝牙网页：数据**仅能查看**，无文件管理/下载，可配网
   > 原「只读页」需求已由 **AP 热点 + 只读网页**路线实现；`caps.prov` 随蓝牙配网卡一并删除
   > （当前 `caps` 只有 `files/ops/sys/ota/wifi`）→ 见 [`实现细节.md`](实现细节.md) **D4、D24-4**。

### 电源管理模块

设备行为由 **统一配置项「设备模式」** 贯穿驱动，而非逐项独立开关。设备模式为持久化配置，存于Flash(NVS)，断电不丢失。

当前有两种设备模式：**固定模式**（0）与**移动模式**（1），每种模式均包含两种子模式（按供电方式划分）。

#### 设备模式 = 配置化

- 模式是**配置项**而非实体开关，用户可在网页中切换；背后由 ESP32 驱动 CE 引脚与 IO18 的 ISET 切换 MOS 管，用户无感知。
- **默认固定模式**（0），第一次配网时可选择，日后可在网页更改；存于 **Flash(NVS)**，断电不丢。
- 模式作为**统一状态变量**，同时驱动：充电策略（CE 停充点 / IO18 电流）、低功耗策略、功能可用性等整套设备行为。

> 💡 待定（想法）：插电累计满 48 小时（或连续 2 天）后，网页提示「检测到您长期插电，是否切换固定模式？」——
> 选「是」则切换，选「否」记录“已忽略”不再重复提示。**不强制，仅温和建议**。

#### 充电策略（由 CE + IO18 驱动）

| 设备模式 | 停充点（CE） | 电流（IO18/ISET） | 效果 |
|:---:|:---:|:---:|---|
| **固定** | 80% 停 | 慢充（~297mA） | 保护电池寿命，浮充 |
| **移动** | 充满 | 快充（~890mA） | 充电快，充满 |

- **充电策略仅由设备模式决定，与是否插电无关**；用户无感知背后有电阻和 MOS，只看到「固定 / 移动」。
- 固定：INA226 读电池电压，充到约 80%（≈4.05~4.1V）拉高 CE 停充，电压回落到 ≈4.0V 由 BQ 硬件 recharge 自动恢复
  → 实为「80% 左右浮充」。
- 移动：CE 保持低，由 BQ24074 硬件终止于 4.2V。
- ISET 档位：R_ISET 主干 1k + 2k，IO18 的 MOS 跨接 2k 两端 → **导通短路 2k = 1k ≈ 890mA（快充）/ 关断 3k ≈ 297mA（慢充）**。

> 实现细节（原语与调用点 / CE 电压滞回 4.05↔4.00V / ISET 档位换算 / Q1 栅极无下拉的取舍）→ [`实现细节.md`](实现细节.md) **D1、D22-2**。
> `/status` 有 `mode` 字段，网页有「设备模式」卡片（`setMode()`）；原 `[临时测试]` 卡片与 `GET /chgtest` 已删除。

###### 温度检测（TS）

- 电池不带内置 NTC（1800mAh 电芯无内部温度引出）→ TS 引脚用**固定 10kΩ 电阻**到地替代，
  相当于跳过温度检测、让 BQ24074 认定温度正常，不触发过温/欠温保护。
- 若未来换用带内部 NTC 的电池，把固定电阻换成对应阻值 NTC 接入 TS 即可恢复温度监测。

#### 电池监测（INA226）

- INA226 挂 I2C 总线（地址 0x40，A0=A1=GND），**高边 10mΩ 采样电阻跨在 BQ24074@BAT 与电池正极之间**。
- **电压通道**直接读电池真实电压（不经分压，精度由 TI 出厂保证）→ **免校准、免逐台标定**，替代原 IO9 分压 ADC 方案。
- **电流通道**测充电回路电流（ESP32 自身工作电流跳变剧烈，不作功耗显示依据）。
- **CV 区判定**（屏幕 `CC`/`CV` 与网页「充电阶段」同源）：
  `充电中(CHG低) + 电池电压 ≥4.05V + |电流| < 设定值×60%`，设定值按当前档位动态给出；
  加电压门限是为了避免 USB100 低电流模式下的误判。据此可提示用户「已进入 CV 区，急用可拔电」。
- ⚠️ **INA226 离线兜底（必须遵守）**：电池电压视为**未知**，**不得**按 0V 处理（否则误触发三档低电保护、开机即深睡）；
  此时低电门控与电量估算**整体作废**（不判低电、不深睡、不显电量），屏幕与网页改显告警（如 `INA226 离线`）。

> 实现细节（采样电阻压降与 ±40mV 终止精度、接法与极性、CV 门限理由、离线兜底全表）→ [`实现细节.md`](实现细节.md) **D22-3**。

#### 连接策略（连接决策状态机）

**核心规则：WiFi 与蓝牙绝不同时开启**（ESP32 两者共享射频，同一时刻只能用一种）。

| 设备模式 | 供电 | 使用的无线 | 蓝牙 | WiFi |
|:---:|:---:|:---:|:---:|:---:|
| 固定 | 外接电源 | WiFi | 禁用 | 使用 |
| 固定 | 电池 | WiFi | 禁用 | 使用 |
| 移动 | 外接电源 | WiFi | 禁用 | 使用 |
| 移动 | 电池 | 蓝牙 | 使用 | 禁用 |

- **自动开 WiFi 条件**：仅在插电（外接电源）时自动开 WiFi；**不插电绝不自动开**（否则实体 WiFi 开关设计无意义）。
- **配网**：就是完整版 WiFi 网页里的一个按钮，没有独立配网页；**保存即切 WiFi 连接**。
- **实体 WiFi 开关（IO9）**（2026-09-13 修订）：
  - **插电 / 固定**：按钮**完全无效**（那时本来就该 WiFi/AP）。
  - **移动 + 电池**：**长按 ≥1.5 秒**才生效 → 连「已保存且扫到的最强」；失败 **→ 开 AP 配网热点**（带 10 分钟超时，无人访问自动关）。
- **未配网兜底**：一律**开 AP 热点**，手机连上热点进真网页配网（原「只能蓝牙、爱配不配」已作废）。
- **连接成功指路**：屏幕显示 IP 与 WiFi 名称 → 用户照提示开浏览器访问，网页打开后自动切到数据显示页。

> 实现细节 → [`实现细节.md`](实现细节.md) **D14-1~D14-6**（会话流程 / 失败 / 空闲回收 / 静态 IP）、**D22-5**（屏幕横幅文案与时长）、**D22-4**（本节的早期原文，已作废，仅追溯用）。
> 现行无线语义 → 本档 **[无线策略与静态 IP（现行）](#无线策略与静态-ip现行--生效中2026-09-17-由附录-bc-提炼)**；被取代的原文见 **D22-4**。

#### 供电与无线总览（固定 / 移动 × 外接 / 电池）

| 设备模式 | 供电 | 充电 | WiFi / AP | 蓝牙 | 屏幕 |
|:---:|:---:|---|---|:---:|---|
| **固定**（0） | 外接 | 80% 浮充 · 慢充 | WiFi，连不上则 AP | 禁用 | 与数据同步刷新 |
| **固定**（0） | 电池 | **不停充**（CE 逻辑同固定档） | WiFi，连不上则 AP | 禁用 | 仅整分钟刷（顶栏即时刷） |
| **移动**（1） | 外接 | 充满 · 快充 | WiFi，连不上则 AP | 禁用（省去切换麻烦） | 与数据同步刷新 |
| **移动**（1） | 电池 | — | **默认关闭**（按 IO9 开） | 设计上启用 | 仅整分钟刷（顶栏即时刷） |

- ⚠️ 电池/无线两列的**现行语义以「无线策略与静态 IP（现行）」为准**（本表右两列是 V2.1 原始设计，BLE 已搁置）：
  固定不分供电一律 WiFi（连不上再 AP 兜底）；移动 + 电池为**无线全关**，按 IO9 才开 WiFi/AP。
- 「仅整分钟刷」指**数据区**；顶栏已改为按需即时刷（**V2.1.1 · 三**）。
- 固定模式即使电池供电（如停电）也不依赖蓝牙 —— 因为固定总有 AP 兜底。

---
---

# V2.1.1中的改动（2026-09-15）

> **定位**：V2.1 之上的**增量版本**。

## 硬件

### 供电

- SPX3819更换为RT9013-33B，用于获取更好的低压差供电可靠性

## 软件

### 交互和可视化

1. 实体按钮
   - IO9按钮在移动模式充电时按下可在快充和慢充之间切换
2. 网页交互
   - 网页新增电量校准页面，可通过运行校准程序获取设备电池放电特性曲线，校准电量显示。校准期间所有功能下线，仅可通过插电/按下按钮退出。
   - 新增网页logo（**✅ 已实装 2026-09-29**：页头内联 SVG + 全 5 个页面的 favicon → 实现细节 **D26**）
3. 网页/屏幕中的湿度变率由相对湿度改为绝对湿度（**✅ 已实装 2026-09-29**，口径见 [`实现细节.md`](实现细节.md) **D25**）
4. **“手持模式”** 更名为 **“移动模式”** 
5. 湿度趋势图在相对湿度曲线上叠加**绝对湿度**曲线（同一张图、双 Y 轴：左 %RH / 右 g/m³；设备端统一口径算，网页不重写公式）→ [`实现细节.md`](实现细节.md) **D25**；**✅ 已实装 2026-09-29**
6. 网页布局优化，限制图表宽度，防止在PC端访问时出现图表长宽比失控。

### 电源管理模块

1. 临时充电模式切换
    - IO9按钮在移动+充电时可临时切换充电速度，该切换方式仅影响一次充电。
2. 电量校准
    - 方案为以ESP32为负载，开启WiFi等功能进行耗电，近似模拟恒负载，在放电曲线时间等间隔取电压值，用于计算电量。
3. 省电模式
    - 移动模式电池供电时，采样间隔期间浅睡。
4. 低电特性更新
    - 如果有校准文件，则低电退化特性由校准后的文件低电端百分比确定（深睡 = 表的 **5%** 点 − 100mV 余量、停采 = 表 **10%**、存档 = 表 **15%**，已实装 2026-09-29）；无表 / 只有干跑表时回落到固定 **3.6/3.55/3.5V**（与首跑实测口径一致，且与最早那批 Y5V 板的 LDO 崩溃点 ~3.4V 留 100mV 余量）。

## Bug修复

1. 网页响应速度不稳定
2. 今日极值和距平曲线仅统计本次开机后测定的数据

## 实现顺序

1. **V2.1.1-a**：IO9 快/慢充
2. **V2.1.1-b**：电量校准
3. **V2.1.1-c**：顶栏即时反馈
4. **连带项**：低电三档阈值上移（见 2.7）

> 做到哪一步 → 看 [`README.md`](README.md) **状态总表**（唯一状态源）；实现顺序与计划细节 → [`实现细节.md`](实现细节.md) **D20-3**。

## 🚧 待做

1. ~~**网页响应抖动**~~（`/status` 偶发 0.4~5s）—— 疑因 modem sleep + 阻塞式 Flash 写 **2026-09-29新发现：疑因网络问题**
2. ~~**【待修】今日极值 / 距平曲线只统计“本次开机以来”的数据**~~ —— 根因：极值/槽没从 `/log.csv` 回灌 ****✅ 已实装 2026-09-29****
3. ~~**【计划·硬件】换 LDO：SPX3819 → RT9013-33B**~~（2026-09-16 **暂缓**，先查板间输出电容差异）—— 换完需重定低电三档 + 重跑标定
4. ~~**【待办·方案】低电三档改成“跟着本机表走”**，不再按最差板定（用户 2026-09-16 定调）~~**✅ 已实装 2026-09-29**
5. ~~**给网页加 logo**~~ → **✅ 已实装 2026-09-29**（母题「屏幕+曲线」+ favicon「极简曲线」；见 实现细节 **D26**）
6. ~~**24小时变率中的相对湿度改为绝对湿度**~~ → **✅ 已实装 2026-09-29**（见 [`实现细节.md`](实现细节.md) **D25**）

> 以上五项的现象 / 根因 / 修法 / 验收 / 实测数据 → [`实现细节.md`](实现细节.md) **D20-5**（①~⑤ 同序）。

---
# V2.2中的改动（2026-09-17 立项）—— 🚧 正在开发

> **状态**：V2.2 目前**只是开始规划**，**V2.1.1 仍在开发中**（不受影响）。本章先立骨架，其余改动后续逐步补入。

## 硬件

1. **新增电源多路复用器 TPS2117** —— 统一管理供电通路（原附录 α「MOS 旁路 LDO」并入本项），把可用下限压到 ~3.0V；PR1 由 IO18 控制，在**电池与 LDO 之间切换**。
2. **换 LDO：SPX3819 → RT9013-33B** —— 为了更好的低压差供电可靠性（现 LDO dropout 100mV 时输出能力仅 25mA，RT9013 的 dropout-输出关系更线性）；RT9013 是低成本一步，与多路复用器可叠加。
3. **接线整体重排** —— SD 卡 SPI → IO5(SCK)/IO7(CS)/IO4(MISO)/IO6(MOSI)；屏幕 SPI → IO40(CS)/IO41(DC)/IO42(RES)/IO2(SDI)/IO1(SCK)；电源与检测 → IO13(CE)/IO9(CHG)/IO10(PGOOD)/IO11(EN1)/IO12(EN2)/IO18(PR1)/IO17(ISET 切换 MOS)；I2C → IO47(SDA)/IO48(SCL)；按钮 → IO21；总开关 → EN 拨动开关。
4. **电池电压和电流测量芯片更换为INA230** —— QFN封装，对个人手工焊接友好。引脚、I2C 地址（仍 0x40）、寄存器位域、AVG 选项与转换时间与 INA226 **逐项一致**，**驱动与标定代码无需改动**；ALERT 脚**不接**（低电与过流仍由软件轮询判定）。
5. **取消EN按钮，改为拨动开关** —— 弥补设备没有开关的缺陷，该修改实装后，WiFi开关等按钮改为短按触发，不再长按触发。
6. **取消BOOT按钮** —— 该功能仅调试时使用，而前面几个版本的开发调试过程中完全没有用到该按钮，因此取消。

> 上述各项的细节（TPS2117 待定项、两器件 dropout 对照与换完必做三件事、完整接线表）→ [`实现细节.md`](实现细节.md) **D21**。

### 电路设计

#### ESP32接线

1. SD卡SPI改为：
   - IO5-SCK
   - IO7-CS
   - IO4-MISO
   - IO6-MOSI
2. 屏幕SPI总线更改为：
   - IO40-CS
   - IO41-DC
   - IO42-RES
   - IO2-SDI
   - IO1-SCK
3. 其他更改
   - IO13-BQ24074@CE
   - IO18-TPS2117@PR1(用于在LDO和电池之间切换)
   - IO9-BQ24074@CHG
   - IO10-BQ24074@PGOOD
   - IO11-BQ24074@EN1
   - IO12-BQ24074@EN2(以上两项用于控制充电模式，在USB100、USB500和ISET之间切换)
   - IO17-接MOS管，充电速度切换
   - IO21-按钮
   - EN-单刀双掷拨动开关，作为设备总开关
   - IO3-下拉电阻
4. I2C
   - IO47-SDA
   - IO48-SCL
#### 供电和电源管理

1. 新增电源多路复用器TPS2117
   - PR1引脚连接ESP32@IO18，切换电池和LDO
   - PR1低电平为LDO供电，高电平为电池直供，PR1有下拉电阻，上电默认低电平，接通LDO供电。

2. 由于EN1和EN2的功能更改，移除BQ24074的EN1和EN2跳线。
   
## 软件

### 交互和可视化

1. IO21处的按钮交互逻辑改为短按，长按安排为其它待定功能入口。
2. 如果长按触发的功能确定并实装，考虑增加长按屏幕反馈，如动画计时，提醒用户何时可以松手。

### 电源管理模块

1. **电池直供切换（TPS2117 PR1 / IO18）** —— 现由硬件下拉给出安全默认，固件只在运行中按电池电压**单向收紧**：
   - **上电 / 复位 / 判定不了**：PR1 低 → 选 **VIN2 = LDO 3.3 V**（硬件下拉保证）。
   - **切电池直供**：仅当 `VBAT < 3.4 V` 才允许 PR1 高 → 选 **VIN1 = 电池直供**（绕开 LDO 低压差，榨出可用区间）。
   - **切回**：`VBAT ≥ 3.5 V` 回 LDO（滞回 **3.4 / 3.5 V**）。
   - ⚠️ **硬约束**：`VBAT > 3.6 V` **禁止**拉高 PR1 —— 模组 VDD33 绝对最大 3.6 V，满电电池 4.2 V 直供会**永久损坏芯片**。
   - **INA230 离线 / 读数无效**：保持 PR1 低（fail-safe：宁可早关机，也不能把高电压灌进模组）。
2. **启动流程规范化。**
   1. 冷启动——上电后测量电池电压，低于3.3V即为冷启动。
      -  上电前和上电瞬间，EN1/EN2外部下拉到地，默认进入USB100模式
      -  程序启动后首先驱动EN1和CE，进入USB500模式，禁用充电
      -  正常启动其余功能
      -  枚举串口，确认对端设备，如果具有USB主机，保持在USB500；如果不具有USB主机，判定为充电器，启用正常的电源管理逻辑。
   2. 热启动——上电后测量电池电压，高于于3.3V即为热启动。
      - 正常启动，进入USB500模式，正常充电
      - 完全启动后枚举串口，规则同上。
   3. 启动流程重排，优化启动速度。
   > 细节（EN1/EN2 真值表、100mA 根因、DPPM 验证）→ 实现细节.md D29
3. **USB和充电器自动切换**
   - 检测到外部电源接入时（PGOOD出现下降沿）重新检测对侧设备，USB则进入USB500，非USB则正常充电。

> （本章其余硬件与软件改动待补，上述方案为暂定，尚未完全确定）

---

# 附录 A：不可用引脚清单（N16R8）

> **依据**：《ESP32-S3-WROOM-1 & ESP32-S3-WROOM-1U 技术规格书 **v1.3**》表 3（管脚定义）及脚注 b、§3.3（Strapping 管脚）。
> 本表只列**用不了 / 不能随便用**的脚；**新增引脚前先查这里**。
> 本机固件当前占用了哪些脚（充电链 / 屏幕 / SD / I2C / 按钮）→ 见 **V2.1 · 硬件 · ESP32接线**。
> ⚠️ **V2.2 的接线重排**（屏幕 → IO38~42、SD → IO1/2/6/7、充电控制 → IO10/12/13/14/21）**尚未确认**，
> 待 PCB 画完再定 → 该章为暂定，**现阶段以本节与 V2.1 表为准**。

## A.1 不可用（别接）

| 引脚 | 模组脚 | 原因 |
|---|:--:|---|
| **IO26 ~ IO32** | 无 | **模组未引出**（内部接 SPI Flash / PSRAM），模组上根本没有这些焊盘 |
| **IO35** | 28 | **已接模组内部 Octal SPI PSRAM**（`SPIIO6 / FSPID`），不可用于其他功能 |
| **IO36** | 29 | **已接模组内部 Octal SPI PSRAM**（`SPIIO7 / FSPICLK`），不可用于其他功能 |
| **IO37** | 30 | **已接模组内部 Octal SPI PSRAM**（`SPIDQS`），不可用于其他功能 |
| **IO0** | 27 | Strapping：与 IO46 共同决定**启动模式**；已接烧写按钮 |
| **IO45** | 26 | Strapping：决定 **VDD_SPI 电压**（复位后才变普通 IO） |
| **IO46** | 16 | Strapping：与 IO0 共同决定**启动模式** |
| **IO3** | 15 | Strapping：**JTAG 信号源**选择；无内部上下拉，值须由外部决定 |

- IO35/36/37 的依据是规格书表 3 脚注 b 原话：*「在集成 Octal SPI PSRAM（即内置芯片为 ESP32-S3R8 或
  ESP32-S3R16V）的模组中，管脚 IO35、IO36、IO37 已连接至模组内部集成的 Octal SPI PSRAM，不可用于其他功能。」*
  —— 本机 **N16R8（8MB Octal SPI PSRAM）正属此列**。
- ⚠️ **IO33 / IO34**：模组管脚表从 IO25 直接跳到 IO35，**未列出这两脚** → 按「模组无此焊盘」处理，不要依赖。
- 💡 **实测提醒（血泪）**：这类「内部强驱动 vs 外部弱上拉」的冲突，**接上拉时看不出问题**，
  必须**拉低**才测得出来（IO35 的冲突就是这么确认的，过程见 [`实现细节.md`](实现细节.md) **D24-1**）。

## A.2 可用但功能受限（接了就要放弃对应外设）

| 引脚 | 模组脚 | 受限于 | 说明 |
|---|:--:|---|---|
| **IO19 / IO20** | 13/14 | **USB D- / D+** | 当普通 IO 用即**放弃 USB**（含 USB 串口/JTAG 与下载） |
| **IO39 ~ IO42** | 32~35 | **JTAG**（MTCK / MTDO / MTDI / MTMS） | 用 **USB-JTAG** 调试时可当 GPIO；需**外部 JTAG 调试**则避开 |
| **IO47 / IO48** | 24/25 | VDD_SPI 电源域 | 本机 **N16R8 的 VDD_SPI = 3.3V**，与普通 IO 同域、**可正常使用**（仅 R16V 型号是 1.8V） |

## A.3 一页速查（贴墙用）

```
本模组不可用：IO0 IO3 IO26~IO34 IO35 IO36 IO37 IO45 IO46
  ├ IO26~IO32  模组未引出（内部 Flash/PSRAM 接口）
  ├ IO33/IO34  模组管脚表未列 → 不要依赖
  ├ IO35~IO37  Octal PSRAM 占用（N16R8 已实测确认冲突）
  └ IO0/IO3/IO45/IO46  Strapping（启动模式 / VDD_SPI / JTAG 源）

功能受限：IO19/IO20 = USB ｜ IO39~IO42 = JTAG ｜ IO47/IO48 正常（3.3V 域）
N16R8 环境温度上限 = 65 C（R8 系列均为 65；其它型号 85）
```

---

# 无线策略与静态 IP（现行）—— ✅ 生效中（2026-09-17 由附录 B/C 提炼）

> **为什么单独开一章**：附录归置规则说「附录只作参考与决策留档」。而**现役的无线策略**（含 IO9 按钮语义、
> AP 兜底、静态 IP）此前一直埋在**附录 C** 里、还和「BLE 搁置决策」的历史记录混在一起 —— 现按规则提上来：
> **本节 = 现行策略**（规矩）；BLE 搁置的来龙去脉与保命铁律 → 归档到 [`实现细节.md`](实现细节.md) **D24**。
> **本文替换 V2.1 章里 2026-09-13 前后的旧说法**（旧文已存档 → **D22-4**）。

## X.1 无线优先级

**核心规则：WiFi 与蓝牙绝不同时开启**（ESP32 两者共享射频）。BLE 已整体搁置（代码保留在 `#if ENABLE_BLE`），
所以当前实际只有 **WiFi STA / AP / 全关** 三种状态：

| 设备状态 | 无线 | 说明 |
|---|---|---|
| 外接电源（含固定 FIX） | **WiFi STA** | 自动连已存网络（多组里挑最强的）；连不上 → 转 AP 配网 |
| 移动 + 纯电池 | **全关** | 默认不开（省电：史诗级续航）；按 **IO9** 按需开启 |
| 无已存网络 / 连不上 | **AP 热点** | 手机连设备热点 → 打开真网页配网 |

- ⚠️ **切换瞬时可共存**（十几秒）：S3 支持，连上后立刻关对面射频。
- 调试口：`GET /wireless?force=wifi`（`force=ble` 随 BLE 条件编译停用），**3 分钟后自动恢复**场景判定（自愈，避免把设备锁死）。

## X.2 实体 WiFi 开关（IO9）语义

- **固定 / 插电**：按钮**完全无效**（那时本来就该 WiFi/AP）。
- **移动 + 电池**：**长按 ≥1.5 秒**才生效 → **STA 优先**（连「已保存且扫到的最强」）→
  **失败 / 无已存网络 → 开 AP 配网热点**（带 `AP_SESSION_MS` = **10 分钟**超时，期间有网页访问自动续期；
  配网成功或超时后自动关，避免把电耗光）。
- **AP 配网流程**：按 IO9 → 设备开热点（SSID/密码见屏幕）→ 手机连上 → 浏览器打开设备 IP
  （**真 HTTP 地址，可添加到主屏幕**）→ 网页里选/填 WiFi → 设备切 STA → **屏幕显示自己生效的 IP**。
- 按钮长按判定与联机流程 → [`实现细节.md`](实现细节.md) **D14-7**、**D20-1**；
  屏幕横幅文案与时长 → **D22-5**。

## X.3 静态 IP（默认开）

- **目的**：动态地址「连到哪全靠运气」，不便于随时开网页 → **默认静态**，**用户只填末段**（默认 `200`，留空即用默认）。
- **网关 / 掩码 / DNS 自动获取**：先 DHCP 连一次读 `gatewayIP()/subnetMask()/dnsIP()` → `base = 网关 & 掩码`
  → 静态地址 = `base + 末段` → `WiFi.config()` 重连。掩码来自 DHCP，**/16 等非 /24 网段也能适配**。
- **防撞**：默认取靠后的 `.200`（避开常见 DHCP 池）；用 **ICMP ping** 查重，被占则 +1（最多试 5 个）；
  全不可用或静态连不上 → **自动退回 DHCP**，并把实际生效 IP 显示在屏幕/网页（避免「配网成功却找不到设备」；
  此时横幅标题由 `WiFi OK` 变为 `WiFi DHCP`）。
- 只作用于**末段留空**的条目；已配置的网络（含 DHCP 的）不被覆盖。
- 落地细节（`/wifi.json` 字段、旧格式迁移、`IPAddress` 小端坑）→ [`实现细节.md`](实现细节.md) **D14-1、D18**。

---

# 附录 α：想法池（可能到来的更新 · 非待办）

> **性质**：只放「可能到来」的想法，不承诺版本与时间，**不放真·待办**；要真做 → 移进**正在开发**的版本小节（当前 `V2.1.1`）+ 在 `README.md` 状态总表登记一行。编号仅供引用。

1. **标定负载档位化（高/中/低）** —— 高档快、低档贴近真实工况；现只有高档（→ 实现细节 D20-5 / D13）。两跑实测的电流/容量/档位外推数据见 README 十三、⑦④。
2. **内阻补偿**（`V_ocv ≈ V_read + I×R_app`）—— `V_load`/`V_rest` 对已在存，届时直接拟合，让表在任意负载下通用。
3. **静置期轻睡** —— 再降 ~15mV 静置误差；若 60s 静置不够干净再加（→ 实现细节 D20-3）。
4. **电量显示锚点整体平移** —— 每次充满重设 `V_100` 后把整条曲线跟着平移（不只改 100% 一格），更好跟踪老化。
5. **HTTPS 静态托管手机页** —— 手机只存书签、永远最新版（需 GitHub/Cloudflare；用户暂无）。
6. **BLE 与 APP 一起复活** —— 代码仍保留在 `#if ENABLE_BLE`；搁置决策与复活注意 → [`实现细节.md`](实现细节.md) **D24-4 / D24-2**。
7. **实体「存档」按钮**（💡 想法，尚在考虑，2026-09-17）—— 移动/无网时也能把当前数据落盘 SD，**拔卡前按一按**，避开"先网页后拔卡"的别扭流程。若决定做 → 按升级通道移进当时的开发版本。
8.  **离线标定图表工具**（`tools/battcal-chart.mjs`，2026-09-17）—— 设备只存 `/battcal.csv`，电脑上拉下来画：复用 `tools/lib.mjs` 画布能力，输出 PNG（电压-时间曲线 + 电量映射曲线）；比设备端渲染省事、不占固件空间。
9.  **启动横幅**
10. **启动后测量中横幅**
11. **菜单**
12. **旋钮操作设备**
13. **ESD和共模注入问题待解**

---
