StellaRigel/ESP32-Pressure-Temperature-Humidity-Recorder/硬件核对清单.md

# 硬件核对清单（PHT_2_X）—— 已确认项，别再反复确认

> **用途**：把**已核对过、已拍板**的硬件细节固化在这里（引脚可用性 / 上电默认电平 / 外设接线 / 固件互锁）。
> 目的是**防止重复确认**：下次画板或改固件前，直接看这份表；表里没有的再查手册。
>
> **与其它文档的分工**：
> - 本文 = **硬件事实与已确认结论**（"这条查过了，结论是 X"）；
> - [`设计文档.md`](设计文档.md) = **规格与决策**（版本章只增不改历史；未定案的东西不往里写）；
> - [`实现细节.md`](实现细节.md) = **怎么做 / 怎么试出来的**（`D1…D24`）；
> - [`开发日志.md`](开发日志.md) = **什么时候发生了什么**（按时间，纯追加）。
>
> **维护规则**（AI 助手维护）：① 只记**已确认**项，未定的进文末「待定」而不是正文；② 每条注明**依据**（手册章节 / 实测 / 用户确认）
> 与**确认日期**；③ 结论变了**不改旧条目**，新加一条并写明"取代 X"；④ 本文件在 `tools/check-md.mjs` 扫描范围内。

---

## 一、引脚可用性（N16R8）—— 铁律

**依据**：《ESP32-S3-WROOM-1 & ESP32-S3-WROOM-1U 技术规格书 v1.3》表 3 及脚注 b、§3.3；
完整清单与"可用但功能受限"另见 [`设计文档.md`](设计文档.md) **附录 A**。

| 类别 | 引脚 | 结论 |
|---|---|---|
| **接了内部 Octal PSRAM** | **IO35 / IO36 / IO37** | ❌ **绝对不可用**（历史事故：原把 IO35 当 WiFi 开关 → 飞线改 IO9，见 **D24-1**） |
| **模组未引出** | IO26 ~ IO32（IO33/IO34 管脚表亦未列） | ❌ 没有焊盘，不要依赖 |
| **strapping** | IO0（启动模式/烧写键）、IO3（JTAG 源）、IO45（VDD_SPI 电压）、IO46（启动模式） | ⚠️ 别当普通 IO 用 |

## 二、V2.2 计划的引脚分配 —— 逐脚核过（2026-09-17）

**结论：全部合法，没有踩到 PSRAM / strapping / 未引出任何一类。**

> ⚠️ **2026-09-17 晚：本表已被整表重写取代** —— SD 的 SCK/CS、LCD 的 CS/RES/SDI/SCK、电源控制线、
> I2C、按钮**全部换脚**，另新增 **INA230 换型**、**EN 改拨动开关**。**现行分配与核对结论见第六节**；
> 下面这张表只作历史保留（按规则：结论变了不改旧条目，另立新条）。

| 功能 | 引脚 | 核对结果 |
|---|---|---|
| SD 卡 SPI | **IO1**(SCK) / **IO2**(CS) / **IO6**(MISO) / **IO7**(MOSI) | ✅ 均为普通 IO；IO2 原为 PGOOD，已随 V2.2 释放 |
| 屏幕 SPI | **IO42**(CS) / **IO41**(DC) / **IO40**(RES) / **IO39**(SDI) / **IO38**(SCK) | ✅ 合法，但 IO39~42 是 JTAG 脚 → **前提：IO3 必须为低**（见第三节 ①） |
| 充电 / 电源 | **IO10**(CE) / **IO11**(TPS2117 PR1) / **IO12**(CHG) / **IO13**(PGOOD) / **IO14**(EN1) / **IO21**(EN2) / **IO17**(ISET 切换 MOS) | ✅ 全部合法（IO10 原为 LCD CS，已随重排释放） |
| 其它 | IO4/IO5(I2C) / IO9(WiFi 按键) / IO19/IO20(USB D-/D+) / IO43·IO44(串口日志) | ✅ 不变 |

- **IO18 已释放**（原 ISET 切换 MOS 栅极），V2.2 未分配。
- **IO15 / IO16 已释放**（原 SD 的 SCK/MISO）。
- 对照（V2.1 的旧分配）：LCD = IO10~14、SD = IO6/7/15/16、CE/ISET = IO17/18、PGOOD/CHG = IO2/21。

## 三、上电/复位时的默认电平 —— 已逐条确认

### ① IO3 = 低（**用户已确认接 10 kΩ 下拉**）

- **为什么必须有**：手册 §3.3.4 表 8 —— **GPIO3 决定 JTAG 信号源**：
  `GPIO3 = 0` → JTAG 走 **USB 串口/JTAG 控制器** → **IO39~42 空闲，可作 LCD 的 SPI** ✅；
  `GPIO3 = 1` → JTAG 占用 **IO39/40/41/42（MTCK/MTDO/MTDI/MTMS）**，正好是 LCD 用的四根 ❌。
- 手册明说 **GPIO3 无内部上下拉**，"值必须由外部决定" → 这颗 10 kΩ 是**硬前提**。
- 📌 **本工程用的是纯 USB 方案**（板上无串口芯片），所以 `GPIO3 = 0` 选 USB-JTAG 同时满足"能下载"和"LCD 脚可用"两件事。

### ② TPS2117 的 PR1 = **默认低 → 选中 VIN2（LDO 输出）**（用户已加下拉）

- **为什么必须是这个默认**：模组 VDD33 **绝对最大 3.6 V**（S3 手册表 9；工作 3.0~3.6 V）。
  电池满电 4.2 V，若上电瞬间选中 VIN1（电池）→ **超出绝对最大值，直接损坏芯片**。
  VIN2 = LDO 的 3.3 V → 安全。
- **PR1 语义**（TPS2117 手册）：PR1 ≥ VREF(≈1 V，0.92~1.08) → 用 VIN1；PR1 < VREF → 用 VIN2。
  `MODE` 上拉到外部偏置（≥1 V）= **手动模式**，PR1 直接由 GPIO 控。
- **切换是 break-before-make**（手册 §7）：切换瞬间两路都关断 → 留意 VOUT 掉压。

### ③ BQ24074 的输入脚内部有下拉（不需要额外处理）

**依据**：BQ24074 手册 §7 引脚表。

| 脚 | 内部 | 上电悬空时的结果 | 结论 |
|---|---|---|---|
| **CE**（IO10） | 约 285 kΩ 下拉 | 低 = **允许充电** | 安全默认，无需处理 |
| **EN1 / EN2**（IO14 / IO21） | 各约 285 kΩ 下拉（+ 板上 2 kΩ 下拉） | (0,0) = **USB100**（最保守） | 安全默认，无需处理 |
| **TD** | 约 285 kΩ 下拉 | — | 本工程未用 |

### ④ PGOOD / CHG（**IO10 / IO9**）—— 开漏 + **外部 12 kΩ 上拉**（用户确认）

- BQ24074 手册：两者都是**开漏状态输出、低有效**；V2.1 固件只用内部上拉（`INPUT_PULLUP`），
  **V2.2 有 12 kΩ 外部上拉** → 更稳（长线/噪声余量更好）。
- 逻辑与 V2.1 保持一致：`PGOOD 低 = 有有效外部电源`；`CHG 低 = 正在充电`。

## 三点五、2026-10-03 故障：插 USB 拔电池 → 设备起不来（**根因=输入限流 100 mA**）

**现象**：插着 USB、设备正常运行中，拔掉电池 → 屏幕黑、之后插 USB 也不再启动（反复复位）。

**用户实测三条证据（一步把范围收窄）**：

| 测量 | 结果 | 排除/确立 |
|---|---|---|
| 3.3V 轨 | **一直有电** | ❌ 排除"3.3V 掉到 0" |
| EN1 / EN2 | 启动后**仍无一拉高** | ✅ 确立：固件从未驱动 → 恒 `(0,0)` = **USB100 = 100 mA** |
| 拔电池瞬间 PGOOD | 示波器**无高脉冲** | ❌ 排除 PR1/PGOOD 误动作 |

**根因**：输入限流恒为 100 mA，而 CE 低（允许充电）时移动档要 890 mA；
系统自身 WiFi 初始化峰值 300~500 mA 都不够，何况再被充电抢。
**有电池时靠电池补峰值 → 拔掉电池就塌 → BROWNOUT 循环。**

**修法**（详见 [`实现细节.md`](实现细节.md) **D29**）：启动最早阶段
① `EN1`=高 → **USB500 = 500 mA**；② `CE`=高 → **锁死禁止充电**（系统优先）。
**修复后实测：同样拔电池 → 屏幕不掉电，设备继续运行** ✅

> ⚠️ **勘误**：本节早先写成"**深睡导致黑屏**"，该结论**已被推翻** ——
> 用户指出 ST7305 是普通反射 LCD、需持续供电，若只是 ESP32 深睡则屏应保持最后一帧。
> 真因是上面的输入限流问题。排查中因此走了弯路，教训见 D29-3。

### 附：排查中同时修掉的两个真 bug（与本次根因无关，但必须修）

| # | bug | 修法 |
|---|---|---|
| **1** | **深睡唤醒源写死老脚 `GPIO_NUM_2`** —— v2.2 引脚迁移后 PGOOD 已改到 **IO10**，`enterDeepSleepIfNeeded()` 里这行没跟着改 → **设备一进深睡就监听一个空脚，永远醒不过来** | 改用 `(gpio_num_t)PIN_PGOOD` 宏。（浅睡那处用的是宏，所以是对的） |
| **2** | **低电深睡缺"电池不在"守卫** —— 拔掉电池后 INA230 读到 **0V**（芯片由 3.3V 轨供电，`inaOK` 仍 true，**不会**变 NaN）→ `0 < 3.5V` → 直接深睡 | 三重守卫：有外接电源不睡 / 读数 <0.5V 不睡 / **连续 3 次**确认才睡 |
| **3** | **PR1 无插电守卫** | 外接电源在位时**绝不**切电池直供 + 60 秒上电宽限期 |

---

## 三点六、2026-10-03 故障：**BQ24074 的 TS 脚画错 → 全程拒绝充电**（已定位）

**现象**：换了新电池、换了新 BQ24074、CE/ISET/EN1/EN2 各种组合全试过，
**充电电流恒为 -1.01mA（约 0）**，指示灯不亮，电池电压纹丝不动。

**根因**：**图纸把 TS（温度检测）脚画成了 2 kΩ 电阻**，而该脚本应接 **10 kΩ NTC 热敏电阻**
（或不测温时接 **10 kΩ 固定电阻**）。

### 芯片行为（TI 手册 SLUS810N 核对）

```
TS 脚内部以 75 uA（72/75/78）恒流源灌电流，VTS = 75uA x R_TS

VHOT  (高温跳变) = 270 / 300 / 330 mV    <- VTS 低于此值 -> 判“过热” -> 【停充】
VCOLD (低温跳变) = 2000 / 2100 / 2200 mV <- VTS 高于此值 -> 判“过冷” -> 【停充】
tDGL(TS)         = 50 ms 去抖
```

**本板 2 kΩ → VTS = 75uA x 2k = 150 mV < 300 mV → 芯片全程判定“电池过热” → 拒绝充电。**

### 为什么这个坑特别隐蔽

| 表现 | 容易被误判为 |
|---|---|
| 电流恒为 0、指示灯不亮 | 电池坏 / 充电通路虚焊 |
| 换 BQ24074 无效 | “芯片没坏，问题在别处” |
| 换电池无效 | “不是电池问题” |
| CE/ISET/EN1/EN2 任意组合都无效 | “固件没驱动对” |
| **芯片无任何报错** | 完全无提示，只能靠量 TS 电压发现 |

### 修法

| 方案 | VTS | 结果 |
|---|---|---|
| ~~2 kΩ（原图）~~ | 150 mV | 判过热，停充 |
| **12 kΩ（实测替换）** | **900 mV** | **能充**（判定窗口正中） |
| **10 kΩ 固定**（手册推荐） | 750 mV | 等价“恒定 25 度”，免测温标准接法 |
| 10 kΩ NTC（B ≈ 3435/3950） | 随温度变 | 有真实温保（需改设计文档并飞线） |

> **手册原文**：*"For applications that do not use the TS function, connect a 10-kΩ fixed resistor
> from TS to GND."* —— 之所以是 10 kΩ，是因为 **10 kΩ NTC 在 25 度时正好 10 kΩ**，
> 固定 10 kΩ 等于让芯片“永远认为 25 度”。

### 换固定电阻的代价

**失去电池温度保护**。极端温度（低于 5 度或高于 45 度）下充电无保护 ——
对**密封在壳内、可能暴晒或置于室外**的设备有风险。
若日后要恢复温保：把 R_TS 换成 **10 kΩ NTC（B ≈ 3435）**，并同步改设计文档。

### 修复后实测（最小诊断固件 tests/charge_en/，从 0.474 V 起充）

```
慢充档(ISET=低)  I = +29.24 mA   V: 2.902 -> 2.926 V 上升
快充档(ISET=高)  I = +89.51 mA   V: 2.939 -> 2.971 V 上升
```

**电流值与“预充”行为完全吻合**：电池低于 3.0 V 时 BQ24074 进入预充，
电流为编程值的 1/10 → 快充 890/10 ≈ 89 mA、慢充 297/10 ≈ 29.7 mA（实测吻合）

---

## 三点七、SD 卡初始化失败 → **根因 = 卡是 GPT 分区表**（2026-10-04）

> **最终结论（已验证修复）**：ESP32 的 `SD.h` / `SdFat` **都只支持 MBR 分区表**。
> 这块卡被 Rufus 烧 Armbian 启动盘时改成了 **GPT**，导致库找不到 FAT 分区 → 挂载失败。
> `diskpart` → `clean` → **`convert mbr`** → `create partition primary` → `format fs=fat32`
> → **立即 `✅ SD卡已就绪`**，归档功能完整验证通过。

### 症状（极具误导性）

| 层面 | 现象 |
|---|---|
| 固件日志 | `⚠️ SD卡初始化失败`，`sdOK=false` |
| `ensureSD()` 重挂 | 也失败 |
| **底层 SPI 探针** | **CMD0/CMD8/CMD58/ACMD41/CMD9/CMD17 全部通过**，能读出扇区内容 |
| `SD.start()` | 400k~20M 全速度、SPI 模式 0~3、加延时、连续 10 次重试 —— **全部失败** |
| `SdFat`（换库） | **同样失败**，`sdErrorCode()` 多为 0x00 |
| 手动读 MBR | 扇区 0 **有** `0x55AA` 签名，但唯一的项是 **type=0xEE（GPT 保护性 MBR）** |

**⇒ 硬件、引脚、走线、卡本身、库 —— 全部无辜。**

### 完整排查链（值得留档：每一步都排除了一个假设）

1. 查代码引脚 → `SCK=IO5 MISO=IO4 MOSI=IO6 CS=IO7`，与 V2.2 表一致，**无冲突**
2. 查 `initSD()` 实现 → 标准写法，无问题
3. 写底层 SPI 探针 → `CMD0` 返回 **0x01**（卡有响应）→ **硬件层排除**
4. 完整协议探针 → CMD8 `R7=0x1AA`、CMD58 OCR、ACMD41 就绪、CMD9 识别 32GB SDHC、CMD17 读扇区 → **卡与协议层排除**
5. 试 `SD.begin()` 各种速度/模式/延时/重试 → 全失败
6. **换 `SdFat` 库重试** → 也全失败 → **库层排除**
7. 手动读 MBR → **发现 type=0xEE（GPT 保护性 MBR）** → 🎯 **根因**

### 为什么会变成 GPT

- **Rufus 烧 Armbian 启动盘时默认用 GPT**（尤其 UEFI 模式）
- ⚠️ **Windows 资源管理器的「格式化」不会改分区表类型** —— 它只重建文件系统
  → 所以"格了 FAT32 还是不行"是必然的，**GPT 一直留着**
  → 也解释了这块卡历史上"时好时坏"（取决于当时卡上是不是 MBR）

### 修复命令（diskpart）

```
list disk                     # ⚠️ 先按容量认准是哪块盘！
select disk N                 # N = 你的卡（本例约 29 GB）
clean                         # 清空分区表（数据全没）
convert mbr                   # ★ 关键：GPT -> MBR
create partition primary
format fs=fat32 quick
assign
exit
```

### 验证结果（修复后）

```
✅ SD卡已就绪
📦 开始自动归档（分片，不阻塞采样）...
📥 归档期间新增 200 行已补入归档
📊 归档统计: 归档 1966 条, Flash保留 2479 条
✅ 归档完成！

SD 目录: 2026-10-02.csv (19592 B) / 2026-10-03.csv (73754 B)
```

### 📌 对项目的长期约束

> **凡是给气象站用的 SD 卡，必须是 MBR + FAT32。**
> 遇到"卡明明好的却挂不上"，**第一件事就是查分区表类型**（`diskpart` → `list disk` 看 GPT 列）。
> 诊断固件留档：`tests/sd_probe9/sd_probe9.ino`（手动读 MBR/BPB，能直接看出分区表类型）。

---

## 四、固件互锁（必须遵守，硬件已给出安全默认）

**PR1 选择 VIN1（电池直供）的前置条件 —— 写固件时别漏：**

```
默认（上电 / 复位 / 看不出来时）：PR1 低 → VIN2（LDO）
仅当 VBAT < 3.5~3.6 V（带滞回）才允许 PR1 高 → VIN1（电池直供）
VBAT 回到 ~3.7 V 以上 → 切回 PR1 低
INA226 离线 / 读数无效 → 保持 PR1 低（fail-safe：宁可早关机，也不能灌 4.2 V 进模组）
```

- 硬件默认值是安全的（下拉 → LDO），但**软件一旦乱切就是永久损坏**，所以这条属"硬约束"。
- 可选硬保险：把 PR1 的纯下拉换成 `VBAT —R1— PR1 —R2— GND` 分压，使 `VBAT×R2/(R1+R2) ≥ VREF`
  只在 VBAT 低时成立 → 满电时**物理上选不中** VIN1（代价：阈值不如软件灵活）。

## 五、外设与结构（已确认）

| 项 | 结论 | 依据 |
|---|---|---|
| **USB** | IO19/IO20 = **原生 USB D-/D+** 直连 Type-C，是板上**唯一**的 USB 通路（**无串口芯片**）；USB 枚举结果用作充电电流决策依据 | 用户确认 + S3 手册表 3（USB_D-/D+ 为固定功能脚，不可映射） |
| **Type-C CC1 / CC2** | 各 **5.1 kΩ 下拉**到 GND（UFP 必备，已确认接好） | 用户确认 |
| **EN1/EN2 的 3P 排针** | **删除**（V2.1 的硬件跳线方案作废；改由 GPIO 软件控制） | 用户决定 2026-09-17 |
| **LCD 网络迁移** | IO10~14 → IO38~42 **整体迁移**（EDA 里换网络即全量迁移，无"残留"问题） | 用户说明 |
| **ISET 切换 MOS** | **不取消**，仍由 **IO17** 驱动（高 = 快充 ≈890 mA / 低 = 慢充 ≈297 mA） | 用户说明 |

## 六、V2.2 引脚表（2026-09-17 晚整表重写）—— 核对结果

> **来源**：用户重写后的 `设计文档.md` V2.2 · 电路设计。**取代第二节那张表。**

### 7.1 新分配（现行）

| 功能 | 引脚 |
|---|---|
| SD 卡 SPI | SCK=**IO5** / CS=**IO7** / MISO=**IO4** / MOSI=**IO6** |
| 屏幕 SPI | CS=**IO40** / DC=**IO41** / RES=**IO42** / SDI=**IO2** / SCK=**IO1** |
| BQ24074 | CE=**IO13** / CHG=**IO9** / PGOOD=**IO10** / EN1=**IO11** / EN2=**IO12** |
| TPS2117 PR1 | **IO18** |
| ISET 切换 MOS | **IO17**（保留，未取消） |
| 按钮 | **IO21** |
| I2C | SDA=**IO47** / SCL=**IO48** |
| 总开关 | **EN** ← 单刀双掷拨动开关（取消 EN 按钮） |

### 7.2 核对结论

**引脚可用性：全部合法** —— 没有一脚是 PSRAM 占用（IO35~37）、模组未引出（IO26~34）；
strapping 脚（IO0/IO3/IO45/IO46）**均未被分配**。

**① IO47 / IO48 做 I2C —— 合法**（"1.8 V 域"的旧说法对 N16R8 不适用，此处更正）

- 手册表 7 + 第 185 行：**仅 N16R16V / N16R16VU 的 VDD_SPI = 1.8 V**；**N16R8 的 VDD_SPI = 3.3 V**
  → GPIO47/48 工作在自己的 **3.3 V** 域，**I2C 电平没问题** ✅
- ⚠️ **前提：GPIO45 绝对不许动**（VDD_SPI 电压由 EFUSE + GPIO45 决定）——
  不能给它加上拉/下拉/跳线，否则复位瞬间可能把 VDD_SPI 误配成 1.8 V，整组 3.3 V I2C 器件全废。
- ⚠️ **I2C 上拉要跟着搬**：原 IO4/IO5 的 4.7 kΩ 上拉须迁到 IO47/IO48（**上拉到 3.3 V**）。

**② LCD 改到 IO1/2/40/41/42 → IO39 被释放，IO3 下拉从"硬前提"降级为"建议"**

- 新方案里 LCD 只用 IO40/41/42 + IO1/IO2，**只有 IO39 落在 JTAG 组内且未被使用**。
- 即使 GPIO3 上电读到高（JTAG 占走 IO39~42），也**只丢 IO39 一根**（未使用）→ **不再阻塞打板**。

**③ PR1 改到 IO18（原 IO11）** —— 普通 IO，合法 ✅ 语义与默认态不变（见第三节 ②、第四节互锁）。

**④ 按钮从 IO9 → IO21，IO9 改为 CHG** —— 引脚层面不冲突 ✅，但**固件要改**：
`#define PIN_WIFI_BTN 9` 必须改；V2.1 的 IO9 飞线（原 IO35→IO9）随之作废。

### 7.3 ✅ INA230 换型 —— 已核，**驱动零改动**

> **2026-09-17 晚核对完毕**（`doc/ina230.pdf`，与 `doc/ina226.pdf` 逐表比对）。此前"缺手册"的说法作废。

| 项 | INA226 | INA230 | 结论 |
|---|---|---|---|
| **10 脚 VSSOP(DGS) 引脚** | A1=1 / A0=2 / ALERT=3 / SDA=4 / SCL=5 / VS=6 / GND=7 / VBUS=8 / IN–=9 / IN+=10 | **完全相同** | ✅ **同封装可直换** |
| **16 脚 VQFN(RGT)** | — | A0=2 / A1=1 / ALERT=3 / SDA=4 / SCL=5 / VS=9 / GND=10 / VBUS=11 / IN–=12 / IN+=13（另有 NC 与散热焊盘） | ✅ 也要拆开时注意脚位不同 |
| **地址 0x40** | A0=A1=GND → 1000000 | A0=A1=GND → **1000000** | ✅ 一致（地址方案、16 个可选地址都一样） |
| **CONFIG 寄存器位域** | bit15 RST / 14:12 AVG / 11:9 VBUSCT / 8:6 VSHCT / 5:3 保留(默认 100) / 2:0 MODE | **逐位相同** | ✅ `buildConfig()` 原样可用 |
| **AVG 选项** | 1/4/16/64/128/256/512/1024 | **同一张表** | ✅ 枚举一致 |
| **转换时间** | 140µs … 8.244ms | **同一张表** | ✅ 窗口公式 `AVG×2×8.244ms` 不变 |
| 量程 | 36V / 16 位 | 36V / 16 位 | ✅ 本机 5.5V 以内，余量充足 |

**两点实操提醒**：
1. **封装按 QFN(RGT) 画时别忘了那 6 个 NC 脚与散热焊盘**（焊盘可接地或悬空，手册允许）。
2. **AVG 探测逻辑继续留着**：`calInaBegin()` 已实现"1024→512→256→128 逐个试写 + 回读"的自适应
   （现板 INA226 的 AVG 会被芯片夹到 128，窗口 2.11 s —— 见 **D11** / `PHT_2_X.ino` 3977 行注释）。
   换 INA230 后若它真能接受 512/1024，窗口会自动变长（最长达 `1024×2×8.244ms ≈ 16.9 s`）；
   **不需要改代码，但建议首板实测一次实际生效的 AVG**（日志会打 `🔧 INA226 重配(标定)：… AVG=n 窗口≈x.xxs`）。

### ⚠️ 但有一处固件必须改：**身份校验会失败**（2026-09-17 晚发现）

- 现状（`ina226.h` 84 / 150~156 行）：
  ```c
  #define INA226_MANU_ID_TI   0x5449      // FEh 制造商 ID
  #define INA226_DIE_ID_226   0x2260      // FFh 器件 ID
  if (!checkIdentity()) { _ok = false; return false; }   // begin() 里直接判离线
  ```
- **INA230 手册（ZHCS766B）里 FFh 的 DIE ID 只写「ASCII 唯一标识」，未给具体值**；
  按其命名规律（INA226 的 die ID 就是 `0x2260`，手册另注 `2260 = 美国或日本 / 2261 = 美国`）
  → **INA230 很可能是 `0x2300`**。且 INA230 寄存器表**没有 FEh 制造商 ID 项**（07h 直接跳到 FFh）。
- **后果**：`begin()` 判 `_ok=false` → 视同「INA230 离线」→ **电量百分比不显示、低电三档保护整体作废、
  CC/CV 与 `/status` 电压电流全部告警**（V2.1 的离线 fail-safe 被误触发）。
- **修法（二选一，都是软改）**：
  ① **推荐**：身份校验改为「**能写 CONFIG 并回读一致即算通过**」（`ina226.h` 本来就有写后回读），ID 仅作日志打印
     → INA226 / INA230 都能用；
  ② 保留 ID 校验：`checkIdentity()` 改成 **`0x2260 || 0x2300` 都接受**，且 `manu` 读不到（0 / 0xFFFF）时不过度严格。
- **✅ 落地时机**：**不用现在改**。首板到手先把 **FEh / FFh 原值读出来**（`PHT_2_X.ino` 3788 行已把 `manu/die` 打印）
  确认 INA230 真实 die ID，再一次性改准 —— 已登记进 **第七节 · V2.2 开发时要做的事**。
- 附：**CONFIG 上电默认值** INA226 = `0x4127`、INA230 = `0x4127`（**同一套位域**）→ 位域部分确认无误。

### 7.4 ✅ 另两条已确认

- **GPIO45：无任何连接**（用户确认）→ 不会误把 VDD_SPI 配成 1.8 V，IO47/48 的 3.3 V I2C 安全。
- **按钮语义：改短按**（用户确认）。V2.1.1-a 的"长按切快/慢充"与"长按开无线"随之改为**短按触发**；
  用户将在 `设计文档.md` 补上这条规格以保证确定性 —— **那条规格落地前，这两件事的功能入口仍属未定案。**

> 📌 **不要反复确认的两条**（用户 2026-09-17 明确）：
> ① **引脚/网络迁移在 EDA 里是整体迁移**，不存在"残留"问题（不完全迁移会直接 DRC 报错）——**不用再查走线残留**；
> ② 本清单只记**尚未确认**的项，已确认的不要再回来问。

---

## 七、V2.2 开发时要做的事（代码改动清单，2026-09-17 立）

> **用途**：把"换板后固件必须改 / 必须实测"的东西一次列全，V2.2 开工时照着做，不必回头翻聊天记录。
> **规格依据**：`设计文档.md` V2.2 章（`## 软件` → `### 交互和可视化` / `### 电源管理模块`）。

| # | 项 | 要做的事 |
|---|---|---|
| 1 | ~~**⚠️ INA230 身份校验**~~ ✅ **已做（2026-10-02）** | 改为"能读回 FEh/FFh 即在位"（全0/全FF 视为无应答）；FEh/FFh 的打印**提到 begin() 之前**（原先藏在成功分支，校验不过就看不到真实 ID）→ 首板上电后从日志核对真实 manu/die，如需收紧再加白名单（提交 `5946e8e`）|
| 1b | 原 INA230 校验说明 | 首板先读 **FEh / FFh 原值**（`PHT_2_X.ino` 3788 行已打印 `manu/die`）→ 按实值改 `ina226.h::checkIdentity()`，或改成"能写 CONFIG 并回读一致即通过"。**不改则 INA230 被判离线 → 低电三档保护整体作废**（依据：本文 7.3） |
| 2 | **INA230 的 AVG 实测** | 开一次标定，看日志 `🔧 INA226 重配(标定)：… AVG=n 窗口≈x.xxs`，确认新片接不接受 512/1024（窗口最长 ≈16.9 s）（依据：本文 7.3 / `实现细节.md` D11） |
| 3 | **USB 枚举检测** | 写「枚举成功 → EN1/EN2=(0,1) USB500；失败 → (1,0) ISET 档」的分支；`/status` 增字段（如 `usb`）便于插电脑 / 插充电器两种情形核对（依据：V2.2 · 软件 · 电源管理模块 1） |
| 4 | ~~**PR1 电池直供互锁**~~ ✅ **已做（2026-10-02）** | 实现 `VBAT<3.4V → PR1 高` / `≥3.5V → 回 LDO`（滞回 3.4/3.5）；**`VBAT>3.6V` 一律禁止拉高**（三重保险：功能开关 + 函数内硬保险 + 硬上限分支提前返回）；`INA230` 离线/读数越界 → 保持 LDO（fail-safe）。上电在 `chargeInit()` 里显式拉低双保险。**4.2V 满电实测：全程保持 IO18=0，无切换、无告警** ✅。原说明： 实现 `VBAT<3.4V → PR1 高（电池直供）` / `≥3.5V → 回 LDO`（滞回 3.4/3.5）；**`VBAT>3.6V` 一律禁止拉高**；INA230 离线时保持 PR1 低（依据：V2.2 · 软件 · 电源管理模块 2） |
| 5 | ~~**按钮改短按**~~ ✅ **已做（2026-10-02）** | 短按（30ms~1200ms）= 常规动作（移动+插电切快/慢充；移动+电池开无线；固定忽略）；**长按≥5s 仍是救援模式**（用户裁定保留长按防误触）；1.2~5s 的"犹豫按压"不触发动作并打日志；顶栏快通道判定同步改短按。原说明： 交互由长按改短按（V2.1.1-a 的"切快/慢充"、开无线都受影响）；`PIN_WIFI_BTN` 由 9 改 **21**（依据：V2.2 · 软件 · 交互和可视化 1） |
| 6 | ~~**引脚常量全线改**~~ ✅ **已做（2026-10-02，提交 `00368b7`）** | LCD(IO40/41/42/1/2，走默认 SPI) · SD(IO5/4/6/7，走 **HSPI**) · I2C(IO47/48) · CE13/CHG9/PGOOD10/EN1-11/EN2-12 · **PR1=IO18（新增常量）** · ISET 18→**17** · 按钮 **21**（原已是 21）。编译 1300003B。原说明： `ST7305_2p13.h` 的 `LCD_*_PIN`（→IO40/41/42/2/1）· `SD_CS`（→7）与 `sdSPI.begin()`（→5/4/6/7）· `PIN_CE`(→13) / `PIN_ISET`(17 不变) / `PIN_PGOOD`(→10) / `PIN_CHG`(→9) · 新增 PR1(18) / EN1(11) / EN2(12) · `Wire.begin()`（→47/48）· `PIN_WIFI_BTN`(→21)（依据：V2.2 · 电路设计） |
| 7 | **SD 走哪条 SPI 主机** | 定 HSPI（需 IO 矩阵）还是 FSPI —— 引脚都合法，纯实现选择（依据：本文第九节） |
| 8 | **V2.1.1 未完项** | 网页 logo、今日响应抖动（见 `实现细节.md` **D20-5**）—— **今日统计回灌 ✅**、**低电三档跟本机表走 ✅**（2026-09-29 已完成并上机验证） |
| 9 | **⚠️ 浅睡（省电）实装的前置约束** | 见下方「浅睡注意」——**浅睡期间 USB-Serial-JTAG 会把主机侧串口搞死**（实测：需拔插 USB 才能恢复）；实装时必须保留"外部供电 / USB CDC 连着就不睡"的守卫，且**验证只能在没有 USB 主机连接时做** |

**不需要改的**：I2C 从机（BMP580/SHT30/DS3231）地址与驱动、INA230 的寄存器/校准算法、标定流程本体。

### ⚠️ 浅睡（`esp_light_sleep_start`）注意（2026-09-29 实测）

- **不是"睡死"**：浅睡醒来后从下一行继续执行，RAM / 程序状态全保留，**不需要重新初始化**（与深睡 `esp_deep_sleep_start()` 的"重启从头跑"完全不同）。
- **踩过的坑**：让设备在 **USB 插着电脑**的状态下进浅睡 → 主机侧串口报
  `A device attached to the system is not functioning`、COM4 打不开、**按 EN 也无效**（芯片没跑飞），
  **必须拔插 USB**（给 USB 外设重新上电）才能恢复。
  → 根因：ESP32-S3 浅睡会关掉部分外设时钟，**板载 USB-Serial-JTAG 受影响**，主机侧端口随之失效。
- **⛔ 排查顺序（2026-09-30 血的教训）**：浅睡一旦"没响应"，**先怀疑串口/网络输出阻塞，最后才怀疑浅睡本身**。
  实测真凶是 `while(f.available()) Serial.write(...)` 这类**阻塞写**：USB CDC 缓冲一满就卡住整个 loop，
  **症状与"睡死"完全一样**。当时误判成浅睡问题，把睡眠切成 5s 小片 → 收益从 ~95% 掉到 ~7%，实验失效。
- **实装时的正确做法**：
  ① 浅睡**只在「移动 + 电池」**启用；
  ② 守卫必须包含 **`Serial`(USB CDC) 未连接** 这一条 —— 只看 `isExternallyPowered()` 不够，
     因为**电池供电时设备也可能给 USB 口供电**（`powered` 仍是 false）；
  ③ 单次睡眠**切成 ≤2 s 小片** + **睡/醒各记 RTC 计数**，便于事后定位；
  ④ **验证浅睡只能在「没有 USB 主机连接」的环境做**（即用独立充电头供电，或干脆纯电池）。

---

## 八、手册文本本地副本（我按需生成的）

手册 PDF 本体在 `doc/`（`.gitignore` 里，不入库）；需要复读图表/表格时，用工作区外的 `pdftotext` 解成文本
放到 `PHT_2_X\.tmp-pdf\`（用完即删）。相关的：**ESP32 S3技术手册.pdf**（模组规格书 v1.3）、
**bq24074.pdf**、**tps2117.pdf**、**ina226.pdf / ina230.pdf**（两者已逐表比对，见 7.3）。

---
## 九、待定 / 下一轮再定

- **SD 卡走哪条 SPI 主机**：V2.1 用独立 HSPI（`sdSPI.begin(15,16,7,6)`）；V2.2 引脚变了，走 HSPI（需 IO 矩阵）还是改走 FSPI，**待定**。
- **V2.2 的 TPS2117 切换时序实测**（break-before-make 期间 VOUT 掉压幅度，是否会带崩模组）。
- **天线净空区**：下一版 PCB 重新布线，按 S3 模组手册要求留净空。
- **IO 余量**：按第六节分配后空闲的有 IO0(烧写键) / IO3(strap，建议留下拉) / IO8 / IO14 / IO15 / IO16 / IO38 / IO39 / IO46(strap)。
