StellaRigel/ESP32-Pressure-Temperature-Humidity-Recorder/开发日志.md

# 开发日志（PHT_2_X）—— 机器维护，人不用看

> **这是什么**：本工程的**编年史**。README 里原来的「变更记录 + 各批完成日志 + 历史沿革」全部集中到这里，
> 让 `README.md` 能当一份正常 README 用。
>
> **谁维护**：**由 AI 助手维护**（用户不查看、不维护）。新改动请**追加**到本文件（最新在下），
> 并遵守三条：
> 1. **只追加**，不改历史条目（要更正就新加一条，写清"更正 XX"）；
> 2. 每条开头的日期格式 `YYYY-MM-DD`，一行说完"改了什么 + 为什么（若已知）"；
> 3. **技术细节（原语/参数/实测数据/踩坑）写进 [`实现细节.md`](实现细节.md)**（那里有 `D1…D24` 编号与按模块索引），
>    本文件只记**"什么时候发生了什么"**，避免与技术台账重复。
>
> **归置规则**：规格与决策 → [`设计文档.md`](设计文档.md)；怎么做 / 打算怎么做 / 实测踩坑 → [`实现细节.md`](实现细节.md)；
> 状态 → [`README.md`](README.md) 状态总表；**时间线 → 本文件**。

---

## 一、历史沿革（2026-09-10 ~ 2026-09-13）

> **备份策略（2026-09-15 起）**：本工程已纳入 **git**（本地仓库 `PHT_2_X/.git`），改动看提交记录即可
> → **不再新建 `*.bak-*` 手动备份**；此前的手动备份已统一归档到 `backups/firmware/`。
> **工程状态：已编译通过 + 上机点亮验证（2026-09-10）**
> 由 `Pressure1_3`（主逻辑）与 `ST7305_Landscape_UI`（横屏界面）合并而成。
> **2026-09-11 进展**：INA226 电池监测已集成；充电控制底层原语已实装；网页新增「临时测试」快/慢充切换按钮。
> **2026-09-13 文档同步（开工前定调）**：
> ① 版本号统一 **v2.1**；
> ② 低电保护按**设计文档三档**实现（**V2.1.1-b 已上移为 3.6V 存SD / 3.55V 停采集 / 3.5V 深睡**；原 3.3/3.25/3.2V 低于 LDO 压缩点 ~3.4V，实际从未触发）；
> ③ **删除 IO9 电池分压回退**（板上已无分压电阻，IO9 归 WiFi 开关），电池电压只认 INA226；
> ④ INA226 离线时**低电门控与电量显示整体作废并告警**（不得按 0V 误判）；
> ⑤ 屏幕 CC/CV 改用 INA226 `cvZone`，与网页同源；
> ⑥ V2.1 未实现项：CSV 模式列 / 多组 WiFi / 蓝牙只读页 / 蓝牙配网 均已完成（2026-09-13；蓝牙侧 09-14 起随 BLE **整体搁置**）；**IO9 实体按钮已焊接并验证（2026-09-15）→ 本清单已清空**。

---

## 二、变更记录（2026-09-10 起，按时间顺序；最新在下）

| 日期 | 内容 |
|---|---|
| 2026-09-10 | 建立工程：`Pressure1_3` 主逻辑 + 横屏 UI 合并；新增设备模式显示；**移除 IPv6（连 WiFi 提速 ~15 秒）**；编译通过 + 上机验证 |
| 2026-09-10 | **新增三要素 24h 变率**：整点环（RAM 24 槽，去掉原 `press24h` 的 2880 槽 PSRAM 缓冲），屏幕右侧箭头显示、网页同步；**传感器失联改为 `N/A`（删除虚拟数据）**，屏幕显横杠；湿度/气压改一位小数 |
| 2026-09-11 | **集成 INA226 电池监测**（新增 `ina226.h`）：电压/电流/功率、两点电流校准、器件身份校验；`readPowerState()` 优先 INA226、失败自动回退 IO9 分压；`/status` 与网页增加电流、充电阶段显示 |
| 2026-09-11 | **修复 DRAM 溢出**：`webLogBuffer`(200×256=50KB) 由内部 DRAM 迁至 PSRAM（`ps_malloc`），解决 `.dram0.bss` 链接失败 |
| 2026-09-11 | **实装充电控制底层原语**：IO17=CE#、IO18=ISET 切换；`chargeInit/chargeSetCurrent/chargeSetEnabled/chargeIsFast/chargeIsEnabled/chargeSetpoint_mA`；setup() 最先初始化 |
| 2026-09-11 | **CC/CV 判定改为 INA226 电流判定**；网页新增 **[临时测试] 快/慢充切换按钮**（含 `/chgtest` 端点，均标 `TODO(临时)`） |
| 2026-09-11 | **确认 IO35 与 Octal PSRAM 冲突**：datasheet Page 11 脚注 b + `PSRAM_Stress` 压测确认；决定**飞线改接 IO9**；设计文档新增**附录 A 引脚可用性清单**（全部不可用脚入表） |
| 2026-09-13 | **文档同步（开工前定调）**：版本号统一 v2.1；确认低电保护按设计文档三档、删除 IO9 分压回退、INA226 离线告警、屏幕 CC/CV 改用 `cvZone`；V2.1 未实现项全部保留为待办（进度 19~25）；补全文件构成表（`ui_font_oldsans.h` / 弃用的 `ui_font_monixend.h`） |
| 2026-09-13 | **代码批次①②③完成**：① 删除 `PIN_BAT`/`BAT_CAL_*`/ADC 回退与 `USE_INA226`，电池电压只认 INA226，离线时低电门控与电量显示整体作废并告警（`battVolt=NAN`，屏幕显 `INA!`+叹号、网页显告警）；② 低电保护改**三档** 3.3/3.25/3.2V；③ 屏幕 CC/CV 改用 `cvZone`（删 `UI_CV_VOLT`）；④ `/log.csv` 增第 6 列「模式」；网页/启动版本号 v2.2→v2.1 |
| 2026-09-13 | **上机验证 + CSV 表头迁移**：arduino-cli 编译烧录验证（CDCOnBoot=cdc / PSRAM=opi / PartitionScheme=custom=partitions_16MB_ota_clean）；经网页接口确认 INA226 在线、新电源分支、模式列、`/history` 解析、标题 v2.1；`initFS()` 新增旧表头一次性迁移（旧 5 列行补占位符 `-`，先备份再替换） |
| 2026-09-13 | **OTA 远程升级 + 归档日志防刷屏**：`.97` 经 `/update`（POST 字段 `firmware`）OTA 升级到 v2.1，无需 USB，并在升级后自动完成 CSV 迁移（1349 行）；`checkAndArchive()` 加守卫——当天成功即停、失败按 30s 重试，修掉 02:00–02:05 每轮 loop 打日志刷爆 200 条环形缓冲的问题 |
| 2026-09-13 | **修 `chargeInit()` 软复位不生效（实测 bug）**：ESP32 core 3.3.11/S3 上，软复位（`ESP.restart`）后「先 `digitalWrite` 再 `pinMode`」**不会真正拉低引脚**，引脚保留上一次会话电平——预置快充后重启仍读到 `IO18=1`。对固定“必须慢充”是隐患。改为先 `pinMode(OUTPUT)` 再 `digitalWrite`，并末尾复写兜底；双板（USB 烧录 + OTA）复测：预置快充→重启→读回慢充 ✅ |
| 2026-09-13 | **删底图 + 中文字模化 + 屏幕自检端点**：把原底图（`ui_landscape.h`，4125B）里唯一的静态内容「温度/湿度/气压」逐像素**反解抠出**为 23px 中文字模 `ui_cjk.h`（温/度/湿/气/压 5 字形，333B；脚本往返比对 **0 差异**），底图连同 r270 版移到 `backups/` 后删除依赖 → `init()/showAll()` 改为**全量动态重绘**（`fill(0x00)` 白底 + `drawLabels()` + 顶栏 + 数值），`drawCjkText()` 支持 UTF-8 中文；新增 `UI_ROT` 90/270 无需另存图片。附带新增 **`GET /ui-dump`**（显存读回成 ASCII 图，可指定区域）与 `uiDisplay.readLogical()`，用于无人工介入的排版自检——实测三台标签区墨迹数与原底图**逐像素一致（1261 点）** |
| 2026-09-13 | **修 SPI 回读污染显存（实测 bug，core 源码为证）**：`ST7305_2p13::display()` 原用 `SPI.transfer(_buffer, 4125)`，而 ESP32 core 的该重载是 `transferBytes(data, data, size)` ——**同一块 buffer 既发又收**；ST7305 只写无 MISO，悬空回读值（实测 0xFF）会把显存副本整块覆盖。后果：① `/ui-dump` 读回全黑；② **`showTop()`（开机/切模式时只刷顶栏）会把数据区的垃圾一起送显 → 数据区/中文标签瞬变黑**。改用只写接口 `SPI.writeBytes()` 修复（顺带少一次 RX，刷屏更快），修后三台标签区读回均正确 |
| 2026-09-13 | **多组 WiFi（进度 24）+ 网页按钮分组**：① `/wifi.json` 改 `{"list":[...]}`（最多 5 组，旧格式开机自动升级）；`wifiPickBest()` 启动/重连扫描只挑已保存且 RSSI 最强的；`/wifi` 页重写（列表 + 增删 + “附近的网络”点选用），新增 `/wifi-scan`、`/wifi-del`、`/wifi-reconnect`（均不重启）；`/status` 增 `wifiCount/wifiSsid/wifiRssi/caps`。② 主页原来一排 9 个按钮拆成三张卡片（数据与文件/采集与操作/系统），并加 `applyCaps()` 能力开关——**蓝牙模式只要 `/status` 回 `{"files":false,"ops":false,"ota":false}`，整卡自动隐藏，HTML 零改动**。新增 `tools/wifi-check.mjs`（15 项） |
| 2026-09-13 | **修 WiFi 配置升级丢密码（实测事故 + 教训）**：旧格式密码键是 `password`，我的新解析器写成了 `pass` → 升级后密码为空，`.99` 掉线进 AP。修复：两个键都认（`pass` 优先、空则 `password`）+ 升级前 `copyFile()` 备份到 `/wifi.old.json`。.97/.98 升级后仍连着（密码保住）已验证；`.99` 需手动在 AP 页重填一次 |
| 2026-09-13 | **工具固化：新增 `PHT_2_X/tools/`**（Node 零依赖 + 一个 PowerShell）：`lib.mjs` 共用库（字模解析/画布/图标点阵/Toast 版式/dump 解析/PNG/设备 HTTP）、`screen-check`（平时版面 6 项）、`toast-verify`（横幅 8 项含排队时序）、`anomaly-check`（距平 15 项含模式门控）、`capture-screen`（真机出图）、`preview`（离线版面）、`icons-gen`（图标点阵代码生成）、`extract-cjk`（中文字模反解）、`device.ps1`（probe/ota/flash/log/find/dump/toast）。以前这些脚本只存在于会话沙箱里，关了就没了 |
| 2026-09-13 | **距平限固定 + 修基线稀释 bug（实测）**：① 只有**固定**样本进日平均/距平（`deviceMode==0` 才累计）、移动模式 `/anomaly` 报 `fix:false` 且网页卡片显“仅固定模式可用”（`/today-stats` 同步给 `fix` 字段）；② **基线稀释 bug**：`avgSlots.cnt` 把“当天该槽没采集”也算作一天参与，30 天窗口均值 1012 hPa 被算成 507 hPa → 距平显示 +505 hPa（实测三台都把基线减半）；现空槽写 `NaN`、旧的 0 值文件按“无数据”跳过（`avgDateValid()`），修后三台日均 1013.8~1015.0 hPa、距平 −0.13 hPa。`/anomaly` 另回报 `slots`(今日已采槽数)/`days`(基线天数) 供前端提示与自检 |
| 2026-09-13 | **提示横幅细化（按用户三条意见）**：① SSID 加引号 + 超宽自动截断（新增 `buildSsidLine()`：32 字符 SSID 截成 `"前21字符.."`，13px 字体 250px 宽装不下 33 字符）；② **失败页去掉 IP**（避免误以为已连上去访问）——新增 `queueToast()`：失败横幅 10 秒后自动接上热点横幅（热点名 + IP）；`/toast?k=fail` 也统一不给 IP；③ 热点图标改为「中心点 + 双侧对称 90° 同心弧 x2」（19x13 点阵），与顶栏「上方三道弧」的 WiFi 图标区分。三台实测：√/×/热点 + 失败→排队→热点时序全部**逐像素 0 px**，到期还原正常 |
| 2026-09-13 | **提示横幅（Toast）实装 + 上机验证**：`showToast()/tickToast()/toastActive()`，整条 250px 宽盖数据区（连中文标签一起盖）、**顶栏不动**；横幅期间 `showAll()` 自动降级为只刷顶栏，不会被采样冲掉；到期用缓存的最近一次数值全量重绘还原。三种版面：`√ WiFi OK`（20s）/ `× WiFi FAIL` + 热点退路（10s）/ `(广播图标) AP MODE`（20s），√/×/广播图标均**自绘点阵**（字库无 √；也避免浮点取整飘移）。触发：开机连上/连不上、AP 启动（已有横幅时不抢占）、热点开着时又连回路由器；另加 `GET /toast[?d=毫秒][&k=ok\|fail\|ap]` 与网页「📺 屏幕显示」按钮。三台实测：三种横幅与设计版面**逐像素差异 0 px**、采样期间横幅存活、到期标签(1261点)+数值均还原 |
| 2026-09-13 | **模式联动充电策略实装（待办 2/3/6 收口）**：新增 `applyChargeStrategy(const PowerState&)`（调用点：`setup()` 开机 / `readAndLog()` 每次采样 / `/mode` 切换后）——**固定**=慢充 + 80% 停充（CE 滞回 **≥4.05V 停 / ≤4.00V 恢复**，恢复点必须软件判，因 CE 拉高时 BQ24074 内部 recharge 不生效）、**移动**=快充 + 充满（CE 恒低）；INA226 离线时 fail-safe 允许充电并告警一次；档位/停充**仅在跳变时**打日志。网页 `[临时测试]` 卡片 → 「设备模式」卡片（`setMode()`/`modeLbl`，显示模式+档位+是否停充），删除 `/chgtest` 端点与 `setChgFast()`；`/status` 新增 `mode` 字段。实测 `.99`：开机 4.11V 即停充、切移动 823mA 快充、切回固定立刻停充；三台经 OTA 同步 |
| 2026-09-13 | **INA226 离线告警实测 + 三台统一 v2.1**：临时把 `INA226_ADDR` 改 `0x41` 模拟失联（验证完毕已恢复 `0x40`），实测启动告警日志、`/status`（`battVolt=null`/`battPct=0`/`inaOK=false`/电流功率归零）、网页告警渲染、低电门控整体跳过（继续记录不深睡）均符合设计；修**告警态 `⚡` 与「INA!」重叠**（实测字模墨迹 `INA!`=x163..195，`⚡` 由 166 移到 **152**，正常充电态 166 不动）；`.97`/`.98`/`.99` 三台经 `/update` OTA 统一到 v2.1——`.98` 原为旧固件（网页 title 误标 v2.2、旧 3.50V 单档门控在电池上停写），升级后自动迁移 3109 行 CSV（旧行补 `-`），并在电池 3.44V 下恢复记录 |
| 2026-09-13 | **修“保存后不重连 / 必须按 EN”（实测事故②③）+ 网页重启**：① 保存后 `wifiCfg` 不刷新 → 自动重连、`/wifi-reconnect`、loop 60 秒重试**全用旧凭据**（用户实测：改完必须按 EN）；现 `wifiSyncCurrent()` 在增删后刷新当前组（优先保持已连上的）+ 每处打日志；② `/save-wifi` 缺 `useIP` 参数时把静态 IP 静默关掉（.99 一重启就跳 DHCP `.128`）→ 现“缺省 = 不改地址方式”，页面复选框改下拉（总会提交），`/status` 加 `ip`；③ 保存后若**未连接**立即自动重连（装壳场景）；④ 新增 `GET /reboot` + 主页「🔌 重启设备」（够不到 EN 键的兜底）；⑤ 顺手修工具读错的 `/weblog` 键（`lines` 不是 `logs`）。`tools/wifi-check.mjs` 扩到 20 项全过 |
| 2026-09-13 | **蓝牙第一批：无线互斥状态机 + BLE 只读通道（实测）**：① `wantWireless()/updateWireless()` 照设计文档表格实现——**仅「移动+电池」用蓝牙**，固定/插电一律 WiFi，自动开 WiFi 只在插电时；② BLE 用 core 自带 Bluedroid（零依赖，Flash +242KB）：Service `6e400001-…` + RX(write)/TX(notify)，协议 `GET /path\n` → JSON + `\n`；③ 实体 WiFi 按钮 IO9（INPUT_PULLUP）+ `/wireless?force=` 联调口（3 分钟自愈，不会锁死）；④ `/status` 增 `wireless/ble/bleLink/wlForce` 并按传输给 caps（蓝牙版 files/ops/ota=false）；⑤ 修「旧重连逻辑在蓝牙模式下误开 AP」与「在 HTTP 回调里关 WiFi 栈把设备搞卡死」两个自测暴露的 bug。日志实证全周期：切换→广播→3 分钟自愈回 WiFi，期间采样照常（count 4631→4639）、无 AP 误开。待手机实测（`tools/ble-web.html`） |
| 2026-09-13 | **蓝牙第二批：完整只读页（一份 HTML 双传输）**：`/history`/`/today-stats`/`/anomaly`/`/daily-avg` 全部抽成 `build*Json()`（脚本自动把 `server.send`→`return`，原位留薄 handler，HTTP 行为不变）；BLE 分发器复用同一套 builder（带 `?page/count/filter` 解析，蓝牙默认 100 条）；主页插**传输层 shim** `apiFetch()`——蓝牙连着走 BLE、否则走 fetch，9 处调用点自动改道；顶部蓝牙连接条（`file://` 才显示）；新增 `tools/dump-page.mjs`（取页自检含 apiFetch/bleConnect/applyCaps）。回归：HTTP 5 接口全过 |
| 2026-09-13 | **修蓝牙数据一拉就重启（栈溢出）**：手机连上后一拉 `/history` 设备就 panic 重启（重启后 MOV+外接 → 按状态机回 WiFi，表现成"蓝牙自己关了"）。根因：`/history` 的解析数组 `DataPoint tempData[300]` = 4.8KB 在**栈**上，而 BLE 写回调跑在协议栈任务（栈约 3KB）→ 必崩；HTTP 路径跑在 async_tcp 任务（8KB）所以一直没事。修法：①回调只拷贝请求（`blePendBuf`），真正处理搬到 `loop()`（栈 8KB）；②响应改由 `bleTxPump()` 在 loop 里非阻塞分片发（回调里不再 delay）；③4.8KB 数组改 `malloc` 到堆（顺带让 HTTP 路径也不再吃 4.8KB 栈）；④忙时不丢请求，保留到下一轮；⑤网页侧 `apiFetch` 串行化（`BLE_CHAIN`） |
| 2026-09-13 | **蓝牙链路修复 + 手机端落地 + 文档对账**：修 `/history` 经蓝牙必崩（解析数组 4.8KB 压爆蓝牙协议栈任务 3KB 栈）——回调只拷贝、处理搬 `loop()`、分片发送非阻塞、数组改堆、请求不丢；页面加传输层串行化 `BLE_CHAIN` 与**打开即自动重连**（`getDevices()`）；手机实测通过（含 ①主屏幕快捷方式）。**文档对账**：核实并更正——充电策略联动/80% 停充（`applyChargeStrategy`）、多组 WiFi（`WIFI_MAX_SAVED 5` + `wifiUpsert`）、气压距平限固定、SSID/IP 横幅、IO9 按键**软件均已实装**（IO9 仅差焊接）|
| 2026-09-13 | **蓝牙配网实装（第三批）**：复用 `wifiUpsert()`，BLE 分发器加 `/wifi-list` `/wifi-scan` `/wifi-save` `/wifi-del`；`buildWifiScanJson()` 由 HTTP/蓝牙共用、`buildWifiListJson()` 不回显密码；页面加「📶 配网（WiFi）」卡（`caps.wifi` 控显隐，蓝牙与局域网同一张卡）；只写 Flash 不立即连，插电保存后 20 秒自动重启（继续保存顺延）、电池供电提示按 IO9；日志对 `/wifi-save` 只记路径防密码入日志；请求缓冲 192→512 字节；**卡片去重**：caps 增 `prov`（仅蓝牙 true）控制「📶 配网」卡、`wifi` 改用控制系统卡的 `/wifi` 链接（蓝牙 false / WiFi true）|
| 2026-09-13 | **连网会话实装（配网自动化 + 防误触）**：配网保存/点已保存网络/长按 IO9 三者统一走「会话」——立即切 WiFi 连接（作废"只写 Flash 不立即连"与"20 秒重启"）、连上后推 `{event:wifi-connected,ssid,ip}` 给蓝牙网页（蓝牙缓关 2.5s 保推送送达）、屏幕横幅 SSID/IP；失败只报错回蓝牙、**绝不开热点**；网页每 3s 轮询 `/status` 续期，**60s 无请求自动回蓝牙**；收到首口网页请求立即收横幅（"用户真进来了"确认）；`/wifi-connect` 新端点；`wifiUp()` 拆出 `wifiConnectSaved(allowAP)`；IO9 改为**长按 1.5s**且**插电/固定完全无效**；配网卡加静态 IP 勾选与「🔗 连接」；`uiDisplay.dismissToast()` |
| 2026-09-13 | **蓝牙配网闭环打通 + "切到 WiFi 必崩"根治**：① 上机验证配网全流程——手机经 BLE 填 SSID/密码 → 设备保持蓝牙连接试连 WiFi → 连上后推送 SSID/IP → 手机点横幅跳到局域网完整网页 → 2.5 s 后关蓝牙，全程无崩溃；② **修复切换 BLE→WiFi 必 PANIC（LoadProhibited）**：core 3.3.11 的 `BLEDevice::deinit(bool release_memory)` **忽略该参数**、无条件 `delete m_pServer`，手机还连着时 deinit → NimBLE 事件任务随后的 disconnect 事件 `erase` 已释放的 `m_connectedClientsMap`（毒化 `0xbaad5678`）；改为「先 `disconnect()` + 等 `getConnectedCount()==0` + 60 ms → 再 `deinit`」，并给 `onDisconnect` 的重启广播加 `!bleStopping` 保护（`getPeerDevices(false)` 返回 `std::map` 而非 vector，注意写法）；③ 网页里做整屏重绘的 `dismissToast` 从 HTTP 处理栈挪回主循环（该任务栈仅 3.5 KB，原本有溢出风险）；④ 崩溃取证方法记入 实现细节 **D24-3**（含 addr2line 路径与 `0xbaad5678` 毒化值判读） |
| 2026-09-14 | **架构决策：BLE 搁置 + 静态 IP 设为默认**（规格见 设计文档 **无线策略与静态 IP（现行）**）：① 蓝牙配网/中继整条线用 `#if ENABLE_BLE`(默认 0) 条件编译关闭，**代码保留不删除**，远期做 APP 时与 BLE 一起复活；② 无线策略改为「插电=WiFi STA｜移动+电池=**全关**（IO9 按需开、N 分钟后自动关，史诗级省电）｜无已存网络=**AP 热点配网**（真 HTTP 网址，手机可"添加到主屏幕"）」；③ **静态 IP 设为默认**，用户只填末段（默认 200，防撞靠后），网关/掩码/DNS 由一次 DHCP 学习后复用，静态连不上则自动退回 DHCP 并显示实际 IP；④ 连带收益：移除 NimBLE → 省 flash/RAM/功耗，且**随机 PANIC 的根因随之消失** |
| 2026-09-15 | **V2.1 待办③+⑤落地：BLE 整体条件编译（不编入固件）+ 删网页蓝牙配网卡**：<br>① `#define ENABLE_BLE 0`——BLE 头文件（`BLEDevice/Server/Utils/2902`）、UUID、收发实现（`bleSendLine/bleTxPump/bleProcessPending/bleHandleRequest/bleQInt/bleQStr/bleHas/jsonEsc/urlDecode`、`BleServerCB/BleRxCB`、`startBLE/stopBLE`）全部包进 `#if ENABLE_BLE`，`#else` 留空实现（状态机/loop 调用点**零改动**）；`wlForce==2` 与 `/wireless?force=ble` 在停用时被拒；`bleOn/bleLink` 保留（`/status` 恒报 false）。**固件 1468379 → 1214259 字节（省 ~245KB，即 Bluedroid 栈）**，全局变量省 ~2.7KB。<br>② 网页删除「📶 配网（WiFi）」蓝牙卡：卡片 HTML（32 行）+ 其专有 JS（`bleWifiLoaded/bleDiagFallback/bleWifiMsg/bleWifiScan/bleWifiSave/bleWifiList/bleCfgLog/bleWifiDel/bleWifiConnect/bleEvent`，107 行）+ `caps.prov` 字段与 `CAPS.prov` 门控一并移除；`BLE→WiFi 推送` 事件调用点改为注释。WiFi 配网统一走系统卡「📶 WiFi设置」→ `/wifi` 完整页。<br>验证：编译 `EXIT=0`；OTA 到 `.99`（首次上传偶发空回包未生效，重推 `✅ 更新成功`）；`/status` caps 已无 prov、页面无 `card-prov`/`bleWifiScan`、`bleEvent(` 仅剩注释；网页 3 段 `<script>` 语法均 OK；`/status /history /today-stats /anomaly /wifi /weblog` 全 200；`/wireless?force=ble` 回 `force:0`；`screen-check` 6/6 |
| 2026-09-15 | **V2.1 静态 IP 落地（网页只填末段 + DHCP 学习 + ping 查重 + 退 DHCP 标注）**：<br>① 数据模型：`WiFiConfig` 改为 `useIP/ipLast(末段)/gw/mask/dns`（不再存整段 ip，改为 `base+末段` 现算）；`/wifi.json` 旧格式（整段 ip）开机自动迁移（取末段），`wifiUpsert()` 改抓 `ipLast`，新增组默认静态 200，**留空才用默认、已有配置不覆盖**。<br>② 连接流程重写 `wifiConnectSaved()`：纯 DHCP 直接连；静态则 **DHCP 先连一次 → 读 `gatewayIP()/subnetMask()/dnsIP()` 并落盘 → ICMP ping 查重（末段被占就 +1，最多 5 个）→ 配静态重连；都不行/静态连不上 → 退回 DHCP**。新增 `pingHost()`（内置 `esp_ping`，实测可编译链接）、`wifiStaticFallback` + `wifiOkTitle()`（退回 DHCP 时屏幕横幅标 **`WiFi DHCP`** 并显示实际 IP）。<br>③ 网页：地址方式下拉 + **只填末段一个数字框**（2~254，默认 200）；删除 ip/gw/mask 三个框；列表「地址」列显示 `静态 .99` / `自动(DHCP)`；`/status` 新增 `useIP/ipLast/gw/mask/ipFallback`。<br>④ `/save-wifi` 与 `/wifi-reconnect` 不再在 HTTP 回调里直接折腾网卡，改走 `beginWifiSession()`。`setup()` 也统一调 `wifiConnectSaved()`。<br>**⚠️ 踩坑（实测）**：`IPAddress` 内部**小端**，`base \| ipLast` 会把末段写进第一字节 → 设备自配成 `227.168.31.0` → 全网失联（靠 COM9 串口日志定位），改为按字节构造后正常。<br>**实测**：串口日志 `📥 已学习… 网关 192.168.31.1 掩码 255.255.255.0` → `✅ .99 ping 不通 → 用作静态地址` → `✅ 静态 IP 生效: 192.168.31.99（DHCP 曾拿 .128）`；`/status`/`/wifi-list`/`/wifi` 新表单均正确；`screen-check` 6/6。编译 1216047 字节 |
| 2026-09-15 | **修网页 OTA「没反馈」（双重响应）+ OTA 页面重写为 XHR**：根因=`server.on("/update", HTTP_POST, finalHandler, uploadHandler)` 的 **upload 回调里也 `server.send()`**，而 `WebServer` 的 final handler 随后必然再 send（`FunctionRequestHandler::handle()` 调 final、`upload()` 调 upload，**两者都执行**）→ 原始回包**两套 `Content-Type`/`Content-Length`**（甚至混入上次请求残留的头）→ 浏览器判定非法**直接白屏**（curl 宽容所以命令行看不出）。修法：upload 回调只碰 `Update.*`，响应只在 final 发（`otaUploadOk/otaFail` 传结果），失败还会报出**具体原因**。`/update` 页改为 **XHR**：进度条+百分比+失败原因+成功后**轮询等设备回来**再跳回主页（原表单整页跳转在重启时必白屏）。<br>实测（`curl -i`）：失败路径 `500` 头 1 套/203B 带原因；成功路径 `200` 头 1 套/163B；修复前 = 1 状态行 + 2 套头。`/update` 页含 XHR 进度条、无旧 `enctype` 表单。编译 1218623 字节 |
| 2026-09-15 | **正式标定首次开跑 + 实测负载 130mA（设计 ~200mA）**：屏幕进度行 `CAL <pct>%` + `<h>h<mm>m <V>V <I>mA c<轮次>`（**`c<n>` = 已完成轮次**，一轮 = 加载 9min + 静置 60s ≈ 10min，V<3.5V 后加载缩为 1min）。① 负载实装是 **loop 单核空转 99% + UDP 连发**（非设计写的“双核满载”，另一核只有 WiFi/lwIP）→ 实测加载段 **130mA**；② **只影响时长**（纯放电 ≈12.5h、合计≈**14h**，原估 8~13h），**不影响曲线**（表用时间轴、不依赖 INA226 积分）；③ 想提速走 α1「负载档位化」。④ 时长估算修正为 **10.5~14h**（额定容量是到 2.75V 的标称值，实跑只到 LDO 崩溃点 ~3.4V；标定期停采样 → 深睡不介入，是硬掉电收工）。设计文档 §2.3 已补“实装与设计的差异”+ 进度屏字段说明。 |
| 2026-09-15 | **V2.1.1-c 补：`/battcal` 网页按钮灰显**（用户问“乱点咋整”）：① 前置判据抽成 `calStartCheck(dry,why)`，`calStart()` 与网页**共用同一套**（不会两处不一致）；② `/battcal/status` 增 `canStart`/`canStartDry`/`why`/`whyDry`；③ 页面每 3s 轮询 → 条件不满足时「开始」**灰显 disabled** + 下方直接写**缺什么**（如“满电需保持 5 分钟（已 2分10秒）”），干跑/中止按钮各自判据；④ 服务端仍二次校验（客户端被绕过/乱点也无害）；⑤ 顺手修 `%%` 被当字面量显示的小 bug、`jsonEsc` 在 `#if ENABLE_BLE` 内不可见 → 自带 `calWhyEsc()`；⑥ 验证：切固定 → `canStart=false` + 原因正确 ✓；页面 7 项标记全命中 ✓。 |
| 2026-09-15 | **V2.1.1-c 顶栏即时反馈**（**由附录 α 想法移入**；用户实测「拔插充电器半天才切」）：① 根因 = 顶栏只跟采样走（电池下还限整分钟刷）→ 插拔状态最坏 60~90s 才反映；② 实装 `serviceTopBar()` 快通道：插拔(PGOOD)/充电(CHG) **纯 GPIO 每圈查 → 边沿即刷**（+800ms 用新鲜 INA226 补刷），WiFi / 电量% / CC·CV / 分钟 **每 5s 值变化检测**；③ **不碰采样、不写 SD、无阻塞**（每圈多 2 次 digitalRead + 每 5s 一次 1ms I²C），电池下刷新仍约 1 次/分钟 → 省电无回归；④ 顺带让 `applyChargeStrategy()` 更跟手（固定 80% 停充/临时慢充复位即时生效）；⑤ 可观测 `/status.topRefresh` + 日志 `🔌 顶栏即时刷新`；⑥ 实测：开机边沿即触发（1→2）、5s 路径 72s 内按分钟刷 1 次（3→4）、`screen-check` 6/6；**用户上机实测通过**（拔插切换即时，体验“好多了”✓）。 |
| 2026-09-15 | **文档与代码对账修正**（用户指出）：① **中止条件写反了** —— 原写“拔电同样中止”，实际标定期间本来就在电池上跑，“拔电”是**开始条件**（待放电态等断电），中止条件是**插电**（代码 `serviceCal()` 两段各一句 `calAbort("检测到插电")`）。② **V_100 取值描述过时** —— 原写“拔电后静置”，实际代码取「充满且 BQ 已停充、电池侧无电流」时的电压（干跑实测加载段 `I`=0.0mA，负载由充电器经 `SYS` 供）→ 无需真拔电，已按实测更正。 |
| 2026-09-15 | **修文档渲染：表格里的裸竖线**：README 变更记录有 3 行因行内代码含未转义竖线（``ok\|fail\|ap``、``base \| ipLast``、``\|\| isExternallyPowered()``）把表格列数撑破 → 后半段整体渲染不出来。已全部转义为 `\|`；新增 `tools/check-md.mjs` 文档体检脚本（扫全工程 md，退出码非 0 = 有异常），并把「**表格里的竖线必须写成 `\|`**（哪怕在行内代码里）」写进 tools/README 约定。 |
| 2026-09-15 | **V2.1.1-b 实装 + 低电三档上移**：① 低电三档 3.3/3.25/3.2 → **3.6/3.55/3.5V**（原值低于 LDO 压缩点 ~3.4V，保护从未触发）；② 标定模式全链路实装（`/battcal` 页面 + 6 个路由 + 干跑模式 `?dry=1`）：占空比负载（CPU 空转 + UDP 连发）/ 静置采样、CSV 每行 flush、开机自动建表 + 旧表备份、满电锚点自刷新、屏幕进度横幅、长按 IO9 中止；③ ⚠️**实测 INA226 AVG 只认到 128**（512/1024 被夹回）→ 改探测式自适应，窗口 2.11s；④ 静置段改为“停流量、保持关联”（不关 WiFi，含理由）；⑤ **干跑端到端验证通过**（启动→6 轮→重启→建表→报表），干跑表标 `dry:1` 不生效；⑥ 踩坑：`.ino` 自动函数原型会漏 → 标定函数全部显式声明。 |
| 2026-09-15 | **V2.1.1-b 规格定稿（细节讨论）**：标定期**停 HTTP 服务**（不另设 IP）+ WiFi 只当负载、屏幕唯一界面、**明确不记录数据**、长按 IO9 中止；充满判定 = `PGOOD低 && CHG高` 持续 ≥5min 且 ≥4.10V，`V_100` 取**拔电后静置**电压（**后修正 2026-09-15**：实为「充满停充、电池侧无电流」时的电压 = 电芯静置电压，无需真拔电；中止条件亦为**插电**而非拔电）、每次充满重设并强制单调；低压段加密阈值 **3.4→3.5V**；⚠️ **发现低电三档（3.3/3.25/3.2V）低于 LDO 崩溃点(~3.4V) → 保护实际从未触发过**（建议上移，待定）；更正“深放电伤电芯”（0%=3.4V 属浅放）；质量报告必做（图表走离线 Node 工具）；**新开附录 α**（点子/临时待办箱，α1 = MOS 旁路 LDO）；更正附录 C.4 关于“蓝牙残留”的过时记录。 |
| 2026-09-15 | **V2.1.1-a 实装：IO9 移动+插电切快/慢充**：`chargeForceSlow`（RAM、不持久化）+ `serviceChargeTemp()`（**断电即复位**，常态零开销）+ `checkWifiButton()` 按「模式 + 供电」三路分派 + 屏幕 Toast（`FAST/SLOW CHG`）+ `/status` 增 `chgSlow` + 网页模式卡标 `(临时)`；`/mode` 切换时清标志。编译通过（1219127 B / 7%）。⚠️ 踩坑：`.ino` 只自动补**函数**原型、**不补变量声明**，`chargeForceSlow` 需手写 `extern`。 |
| 2026-09-15 | **V2.1.1 规格补充：观察者效应约束**：INA226 串在电池回路上 → ESP32 醒来读数那一瞬也在被自己测着，点采样有固有下限（读数 ≥ 真实值 + 自身开销）。规格新增「2.4 静置采样的实现约束」：① 醒来第一件事**只读 INA226 寄存器**（不碰 WiFi/传感器/屏幕/日志）；② 启用**硬件平均**（1024 × 8.244ms ≈ **8.4s 窗口**，ESP32 睡着时 INA226 照测）→ 自身开销稀释到 <1%；③ 记 `I_wake` 供日后自洽修正（`V_ocv ≈ V_read + I_wake×R_app`）。结论：不影响标定（加载段可忽略、静置段仅 ~7mV 且可修），再次印证**时间轴优于电流积分**。 |
| 2026-09-15 | **V2.1.1 立项 + 规格落档**：设计文档新开「**V2.1.1中的改动**」章（一、IO9 快/慢充；二、电量校准；三、实现顺序）。讨论定案：**用时间轴**（不用 INA226 积分——变负载下定点采样会相位混叠）、**占空比负载 + 静置采样**（满载 9min 耗电 / 静置 60s 取≈开路电压，保互换性）、**0% = 系统复位电压**、负载**一档先行**、**仅移动模式**、按钮逻辑**复用开 WiFi 那套**；`V_load/V_rest` 都存（内阻补偿数据现成，留 v2）。 |
| 2026-09-15 | **IO9 按钮确认完成 + 清理无用文件**：按钮硬件已焊接并验证 → V2.1 待办清零（README §一 #18 / §十 / 设计文档顶部与附录 A 全部改 ✅）；`ui_font_monixend.h` → `backups/Font/`、`tools/extract_cjk.mjs`（与 `extract-cjk.mjs` 重复的旧版）→ `backups/Legacy/`。 |
| 2026-09-15 | **文档状态同步（代码 ↔ 文档逐条核对）**：BLE 相关章节全部标为 **⛔ 已搁置**（设计文档顶部待办块、§连接到智能设备 1/2、附录 B 加搁置横幅）；标注 **5 处已被附录 C 取代的旧语义**（只写 Flash 不立即连 / 不自动开热点 / 未配网只能蓝牙 / 静态 IP 三输入框 / 第 4 个无线图标状态）；修 README §一 #13（IO9 回退早已删）、#25（蓝牙→搁置）、新增 #26（静态 IP）；附录 A「软件引脚常量待实装」→ **已完成**；新增 **§十一 残留清单**（A 有意保留 / B 可清理）。 |
| 2026-09-15 | **版本号统一为 v2.1 + 备份策略切到 git**：这批改动（BLE 搁置 / 无线策略 / 静态 IP）本就属 **v2.1**，把散落的 `V2.2` 标注（`PHT_2_X.ino` 12 处 / README 4 处 / 设计文档 3 处，共 **19 处**）统一改为 **V2.1**；**v2.2 定为下一版**（尚未开始）。同时把 **20 个手动 `*.bak-*` 备份归档到 `backups/firmware/`**（该目录原本就是放固件快照的），**今后统一用 git、不再新建 .bak**。 |
| 2026-09-14 | **修 IO9 按键两处 bug（实测）**：① `checkWifiButton()` 原在「每 2 秒轮询」块内 → 短按会被漏掉，改为**每圈都查**（一次 `digitalRead`，极廉价）；② `bool wifiByScene = (deviceMode != 1) \|\| !isExternallyPowered();` 的 `!` 写反 → 拔电（电池）时反而被忽略、只有插电才响应，改为 `\|\| isExternallyPowered()`。用户实测「反应很快，有了」 |
| 2026-09-14 | **V2.1 待办①落地：IO9 按钮 STA 优先 → 失败转 AP 配网**：`serviceWifiSession()` 按钮分支重写——无已存网络／已存网络都不在附近 → 直接开 **AP 配网热点**（不再「保持蓝牙」）；待连接任务 `wifiConnectSaved(false)` → `true`（连不上自动开 AP 兜底）；新增 `startAPWithTimeout()` + `apSessionUntil`（**AP_SESSION_MS=10 分钟无访问自动关**，期间有网页访问自动续期；`noteWebActivity()` 续期、`stopAP()` 清零）；`wantWireless()` 加「AP 热点开着 → 保持 WL_WIFI」（防被「移动+电池→全关」误关）；`updateWireless()` 加 `!apEnabled` 守卫（开 AP 时不盲目重连）；清理全局「蓝牙配网」旧文案 → 「配网」；移除连网成功/失败路径的 BLE 推送与 `bleHoldUntil` 缓关（蓝牙已搁置）。编译通过（`Sketch 1468379 bytes`）+ OTA 到 `.99`，启动日志正常 |
### 合并期改动清单（2026-09-10，原「本次合并改了主逻辑哪些地方」节）

| # | 位置 | 改动 |
|:--:|---|---|
| 1 | 顶部类型区 | 新增 `PowerState g_power`，缓存最近电源状态 |
| 2 | 全局区 | 新增 `deviceMode` + `Preferences`（NVS 持久化） |
| 3 | `startServer()` 前 | 新增 `wifiUIState()` / `uiSyncStatus()` |
| 4 | `startServer()` | 新增 `/mode` 接口（查/切设备模式） |
| 5 | `readAndLog()` | 更新 `g_power`；屏幕刷新改为按供电节流 |
| 6 | `setup()` | 读模式 → 屏幕初始化 → 画顶栏 |
| 7 | `setup()` | **删除 IPv6**：`enableIPv6()` + 15 秒等待循环 |
| 8 | 网页 `/` 与 `/web-log` | 删除 IPv6 显示区块与样式 |
| 9 | 文件头注释 | 同步更新说明 |

除上述以外，主逻辑一行未动。

---

## 三、V2.1 硬件待办完成日志（2026-09-11 ~ 09-13，状态已于 2026-09-17 归并进状态总表）

> 标题原为「待办（V2.1 硬件相关）—— ✅ 全部完成，仅存档」。保留原文，供追溯"当时是怎么收口的"。

1. **CC / CV 判定** —— ✅ 已完成（2026-09-11）
   INA226 电流判定：`充电中 + 电池电压≥4.05V + 电流 < 设定值×60%` → CV 区。
   设定值由 `chargeSetpoint_mA()` 按当前档位给出（890 / 297mA）。

2. **设备模式驱动充电策略** —— ✅ 已完成（2026-09-13）
   `applyChargeStrategy()` 实装，三处调用（开机 / 每次采样 / 切模式后）；
   固定 = 慢充 + 80% 停充（软件滞回 4.05V 停 / 4.00V 恢复），移动 = 快充 + 充满。详见第五节。

3. **网页端模式切换按钮** —— ✅ 已完成（2026-09-13）
   主页新增「设备模式」卡片：`setMode(0|1)` → `GET /mode?m=`（写 NVS + 立刻刷屏 + 立刻应用充电策略）。

4. **屏幕上显示 SSID / IP / 连接结果提示** —— ✅ 已完成（2026-09-13）
   实装为**整条提示横幅（Toast）**（三种：`√ WiFi OK` / `× WiFi FAIL` / `(热点图标) AP MODE`；失败页不给 IP，10 秒后自动接上热点页）。
   **接口/触发/版面细则 → [`实现细节.md`](实现细节.md) D8**。

5. **气压距平曲线限固定模式** —— ✅ 已完成（2026-09-13）
   固定样本才进日平均/距平（移动不进基线）；移动时接口报 `fix:false`、网页卡片显“仅固定模式可用”。
   **附带修掉一个真 bug**：基线被“没采集的槽”稀释（空槽写 0 也算一天参与）。**实现细节 → [`实现细节.md`](实现细节.md) D2**。

6. **删除临时测试代码** —— ✅ 已完成（2026-09-13）
   `TODO(临时)` 已全部清理：`/chgtest` 端点、`[临时测试]` 卡片、`setChgFast()`、`chgModeLbl`。

> **进度 7~10 已于 2026-09-13 完成（批次①②③）**：低电三档重构、删 IO9 分压回退 + INA226 离线告警、屏幕 CC/CV 改用 `cvZone`、CSV 模式列。

11. **多组 WiFi 存储 + 自动选最强（进度 24）** —— ✅ 已完成（2026-09-13）
    `/wifi.json` 存最多 5 组（旧单组格式开机自动升级 + 先备份到 `/wifi.old.json`）；启动/断线重连只挑**已保存且 RSSI 最强**的；
    `/wifi` 页可增删 + 扫描选用，`/status` 增 `wifiCount/wifiSsid/wifiRssi/caps`，自检 `node tools/wifi-check.mjs <ip>`。
    **接口清单 + 3 条实测教训（键名 / 缓存没刷新 / `useIP` 参数缺失） → [`实现细节.md`](实现细节.md) D18**。

12. ~~**蓝牙连接 + 只读蓝牙网页（进度 25）**~~ —— ⛔ **实装后整体搁置（2026-09-14）**
    三批功能当时均已实装并手机实测通过；现 BLE 整体搁置（`#if ENABLE_BLE` / 默认 0 / 不编入固件），本节所述能力**当前不可用**。
    **三批实装记录（互斥状态机 / 只读页 / 蓝牙配网）+ 踩坑硬约束 → [`实现细节.md`](实现细节.md) D4**；搁置决策见 实现细节 **D24-4**。

---

## 四、待办（2026-09-14）—— 当时记录

### ~~① 随机 PANIC（间歇性崩溃）~~ → **已随 BLE 搁置解除**（2026-09-15：NimBLE 协议栈整体移除，根因不存在）

> **状态见 [状态总表](#状态总表唯一状态源) #2**；下面是万一远期复活 BLE（APP 阶段）时用得上的取证步骤，留档备查。

**现象**：2026-09-13 深夜（拔电操作后）复现一次崩溃；2026-09-14 早上同流程再试却正常。

- **与已修复那个不是同一个 bug**：切 BLE→WiFi 的 `BLEDevice::deinit` 顺序问题是 **100% 必现**，已根治（见 实现细节 **D24-2**，有 backtrace 佐证）。
- 这个是**间歇性**的 → 依赖时序或残留状态（上电时序、蓝牙连接未清干净、电池/INA226 读数、WiFi 重连窗口…）。
- **下次复现时的取证步骤**（设备侧已有辅助）：
  1. 电脑挂串口终端（Arduino 串口监视器，或会话里让我起后台抓取脚本），抓 `Guru Meditation` 段 + `Backtrace:` 那一行；
  2. 用 **实现细节 D24-3** 的 addr2line 命令解码到函数/行号；
  3. 寄存器里若再见到 `0xbaad5678` / `EXCVADDR 0xbaad5688` → 依然是 use-after-free（对象被释放后还有回调/事件进来）；
  4. 设备侧旁证：开机首次访问 `/cfgdbg`，首行会写「⚠️ 上次是异常复位：❌ 崩溃 PANIC」。
- **建议加固（~~值得做~~ 可选·未做，2026-09-17 标注）**：给固件开 **core dump 落 Flash**（`CONFIG_ESP_COREDUMP_ENABLE_TO_FLASH` + 自定义分区表加 `coredump` 分区），这样崩溃现场能跨重启保存，不必守着串口等它发作。

### ② ~~顶栏无线图标"缩一号"（字模）~~ → 已取消（2026-09-15）

该项**只为蓝牙态图标服务**（想让顶栏 `bt` 小一号）。BLE 已整体搁置（`ENABLE_BLE=0`），顶栏不再显示 `bt` → **本条作废、删除**。
顶栏 `bt` 档的绘制代码**保留不删**（远期做 APP 时与 BLE 一起复活）。

### ③ OTA 回包判读 → ✅ 已定位并修复（2026-09-15）

**根因（读 `WebServer` 源码定的）**：网页 OTA 用的是
`server.on("/update", HTTP_POST, finalHandler, uploadHandler)`，而 `WebServer` 里
`FunctionRequestHandler::handle()` 会调 **final**、`upload()` 会调 **upload**——**两者都会执行**。
项目在 **upload 回调里也 `server.send()`**，于是 final 再 send 一次 →
原始回包出现**两套 `Content-Type`/`Content-Length`**（甚至带上一次请求残留的头）→
**浏览器判定响应非法，直接白屏/报错**（curl 宽容，所以命令行看着"只是回包奇怪"）。

- **修法**：upload 回调**只碰 `Update.*`**，响应**只在 final handler 里发**（用 `otaUploadOk/otaFail` 传结果）。
- **实测**（`curl -i`）：修复前 = 「1 个状态行 + **2 套头**」；修复后：
  失败路径 `500` 头 1 套、正文报出**具体原因**（"Update.end 校验失败（固件无效？）"）；成功路径 `200` 头 1 套、163 字节。
- **网页重写为 XHR**：进度条 + 百分比 + 失败原因 + 成功后**自动等设备回来再跳回主页**
  （原来表单整页跳转，设备重启时必然白屏，也是"没反馈"的来源之一）。
- 之前记的「偶发空回包」很可能就是这个双重响应的表现，一并解决。工具侧（`device.ps1`）仍建议按「回包含 `更新成功` **且** 重启后校验」判定。

---

## 五、BLE 搁置后的残留清单（2026-09-15 清点）

> 结论：功能无缺口，以下都是「保留待复活」或「可清理」的痕迹，**不影响运行**。
> ⚠️ 现行版本仍以 `README.md`「代码残留清单（BLE 搁置后）」为准，此处为当时的清点记录。

> 结论：**功能无缺口**，以下都是「保留待复活」或「可清理」的痕迹，**不影响运行**。

### A. 有意保留待复活（勿删）

| 位置 | 内容 | 说明 |
|---|---|---|
| `PHT_2_X.ino` | `#define ENABLE_BLE 0` + 全部 BLE 实现包在 `#if ENABLE_BLE` 内 | 复活时改回 `1` 即可编回蓝牙固件 |
| 同上 | `buildStatusJson(bool overBLE)` 的 `overBLE` 分支 | 当前**恒为 false**（BLE 停用）→ 死分支；`caps` 的蓝牙版永不生效 |
| 同上 | `bleStopping` / `bleHoldUntil` / `wlForce(=2)` | BLE 相关状态量，当前恒为无效值；`updateWireless()` 里仍读 `bleHoldUntil` |
| `ui_display.h` | `UI_WIFI_BLE` 档 → 画小写 `bt` | 保留；BLE 搁置后**不会显示**（注释写“BT”、实现是小写 `bt`，轻微不一致） |

### B. 可以清理的（建议 v2.2 一并处理）

| 位置 | 内容 | 建议 |
|---|---|---|
| ~~`tools/extract_cjk.mjs`~~ | **与 `tools/extract-cjk.mjs` 重复的旧版**（只差一个连字符，内容不同、时间更早） | ✅ 2026-09-15 已移入 `backups/Legacy/` |
| ~~`ui_font_monixend.h`~~ | **无任何源码 include**（已被 `ui_font_oldsans.h` 取代） | ✅ 2026-09-15 已移入 `backups/Font/` |
| `bt-page.html`、`tools/ble-web.html` | 蓝牙只读页 / 手机测试页 | 随 BLE 搁置；复活时用 `dump-page` 重取 |
| `apiFetch()` | 已退化成 `fetch` 薄封装（11 个调用点） | 无害可留；彻底清理时把调用点改回 `fetch` 并删函数 |

> 说明：`caps.prov`、`bleWifi*`、`/chgtest`、`UI_CV_VOLT`、`PIN_BAT`、页面「🔗 蓝牙连接」条 —— **均已确认删干净**（代码里 0 处，仅注释提及）。

---

---

## 六、待办（2026-09-15 晚）

- **① 【待修】今日极值 / 距平曲线只统计「本次开机以来」** —— 重启（含 OTA）前当天已采的数据不回灌。
- **② 【计划·硬件】换 LDO：SPX3819 → RT9013-33B** —— 换完需重定低电三档 + 重跑标定；⚠️ 2026-09-16 **暂缓**（先查板间输出电容差异）。
- **③ 【待办·方案】低电三档改成「跟着本机表走」** —— 用户 2026-09-16 定调；**代码当前仍是固定 3.6/3.55/3.5V**。

> 状态见顶部「[状态总表](#状态总表唯一状态源)」#5~#7；现象 / 根因 / 修法 / 验收等细节 → [`实现细节.md`](实现细节.md) **D20-5 ②~④**。

---

## 七、标定复盘入口（2026-09-16 ~ 17 当时记录）

### 标定首跑复盘（2026-09-16）—— 复盘记录；其中 ⚠️ 各项状态见 [状态总表](#状态总表唯一状态源) #8

> **本节只留梗概** —— 完整复盘（含 ①~⑦ 各疑问与数据分析）见 [`实现细节.md`](实现细节.md) **D9**。

### 第二跑（09-16→17）结果：触底自动建表生效 + 两跑一致性验证

> **本节只留梗概** —— 完整复盘（时间线 / 两跑对比 / 结论）见 [`实现细节.md`](实现细节.md) **D10**。

### 2026-09-17 调整：手动归档下线 + 下载口径改为「内存缓冲」

- **手动归档移除（用户拍板）**：理由 = 下载 CSV 已能代替 + “先网页后拔卡”别扭；已删网页按钮 / `doManualArchive()` / `/archive-manual` / `_manual` 图例；
  **保留自动归档**（每天 02:00）+ 低电存档。
- **实体「存档」按钮 → 降级为想法**（非待办）→ 设计文档**附录 α · 9**。
- **`/download` 默认改为吐内存环形缓冲**（永远最新；窗口 600 条 ≈ **12.5 天**，重启后从 Flash 重载）；`/download?f=/log.csv` 仍可取 Flash 文件。
- **术语「驻场」→「固定」**（commit 1331003）：174 处文本改名 + 词元 `SITE_*`→`FIX_*`。

---

## 八、文档结构大整理（2026-09-17，commit 2636ff3）

> 目的：让三份文档各司其职 —— **规格与决策**→`设计文档.md`｜**怎么做 / 打算怎么做 / 实测踩坑**→`实现细节.md`｜
> **状态**→`README.md` 状态总表｜**时间线**→本文件。

- **README 重写成标准 README**：新增「这是什么」（传感器/主控/电源/屏幕/记录节奏/两种模式）、
  补全编译烧录的**真实 FQBN**（含 `PartitionScheme=custom` —— 缺它 OTA 必失败）、「怎么用」（设备地址 /
  从源码扫出的 **40 个接口**清单 / 串口日志速查 / 工具入口）、「硬件约束」、「文档导航」；
  变更记录 50 行 + 各批完成日志 + 历史沿革**搬进本文件**；旧版存档为 `README.old.md`（暂时保留）。
- **设计文档瘦身**：V2.1 章 240→90 行（规格留表、细节与被取代原文 → `实现细节.md` **D22**）；
  V2.1.1 章只留一眼快览 + 待做一行指向；**新增正文节「无线策略与静态 IP（现行）」**（原埋在附录 C）；
  **附录 A 重写为「不可用引脚清单」**（依据 ESP32-S3-WROOM-1/1U 规格书 v1.3 表 3 + 脚注 b + §3.3），
  删除附录 B/C（BLE 铁律 / 崩溃取证 / 搁置决策 / 旧会话时序 → **D24**）。
  ⚠️ **V2.1 的硬件链路（BQ24074 接线链 / 3P 排针 EN1-EN2）按要求保持详细 —— 它代替原理图，别精简。**
- **实现细节新增 D20~D24** 与「**按模块找内容**」逻辑索引（编号当身份证、模块当目录，正文不重排）。
- **V2.0 章的 `DDDD`/`CCCC`、V2.1.1 章的 `EEEE`/`FFFF`、V2.2 章的 `EEEE`/`FFFF` 草稿块全部拆解归位。**
- 验证：`node tools/check-md.mjs` 扫 15 个 md，**0 异常**；提交 `2636ff3`（5 文件，+1668/−938）。

---

## 九、V2.2 引脚表核对 + 新建《硬件核对清单》（2026-09-17）

用户贴出 V2.2 的引脚表（SD/LCD 整体重排 + BQ24074 控制线搬家 + TPS2117），要求**只确认有没有"引脚不可用"这类坑**（防重演 IO35 事故）。

- **逐脚核对结论：全部合法，可以打板。** 没有一脚踩到 PSRAM 占用（IO35~37）、strapping（IO0/3/45/46）、
  模组未引出（IO26~34）—— 依据 S3 模组规格书 v1.3 表 3 / 脚注 b / §3.3。
- 核出 **3 条"上电默认电平"要求**（都不是"不可用"，是"必须给确定电平"）：
  ① **IO3 必须为低**（决定 JTAG 源；为高则 JTAG 占用 IO39~42 = 与 LCD 的 SPI 冲突）→ 用户已确认加 10 kΩ 下拉；
  ② **TPS2117 的 PR1 默认低 = 选 VIN2(LDO)**：因模组 VDD33 绝对最大 **3.6 V**，而满电电池 4.2 V
     → 上电选 VIN1(电池) 会直接损坏芯片 → 用户已确认加下拉（并由此产生一条**固件硬互锁**：
     `VBAT > 3.6 V 时禁止拉高 PR1`，见清单第四节）；
  ③ BQ24074 的 CE/EN1/EN2 内部约 285 kΩ 下拉 → 悬空默认安全态（允许充电 / USB100），无需处理。
- 另确认：EN1/EN2 由 GPIO（3.3 V 推挽）驱动**电气可行**（手册 VIH ≥ 1.4 V）；
  PGOOD/CHG 有 **12 kΩ 外部上拉**（V2.1 只用内部上拉）；**3P 排针删除**、EN1/EN2 改软件控制；
  IO18 释放、**IO17 仍为 ISET 切换 MOS**（快慢充不取消）；IO19/IO20 是板上唯一 USB 通路（无串口芯片）。
- **新建 [`硬件核对清单.md`](硬件核对清单.md)**（机器维护）：把这些"已确认、别再反复确认"的硬件事实固化下来，
  按「引脚可用性铁律 / 已核引脚分配 / 上电默认电平 / 固件互锁 / 外设与结构 / 待定」分节；README 文档导航已登记。
- 未动 `设计文档.md`：用户明确 V2.0/V2.1 是历史记录不改；V2.2 的结论**等 PCB 定案后再写进 V2.2 章**（避免记成"已定案"）。

---

## 十、V2.1.1 进度同步（2026-09-17 读代码核对）

用户准备"等 PCB 这几天把 V2.1.1 做完"，要求读代码同步进度。逐项对着 `设计文档.md` V2.1.1 章核对：

| V2.1.1 规格项 | 代码状态 | 依据（`PHT_2_X.ino`） |
|---|---|---|
| **-a** IO9 移动+插电切快/慢充 | ✅ 已实现 | `chargeForceSlow` + `serviceChargeTemp()`（断电即复位）+ `/status.chgSlow` + 网页 `(临时)`；`checkWifiButton()` 三路分派 |
| **-b** 电量校准链路 | ✅ 已实现（两跑已实测） | 状态机 `CAL_OFF/ARM/RUN/STOP`、CSV 落盘、21 点表、`calPctFromVolt()` 升段插值、`calBuildTable()`、`calBootCheck()` 开机建表、`calAbort(why,tryBuild)` |
| **-b** 电量用校准曲线 | ✅ 已实现 | `readPowerState()` 1194 行：`calTableOk && !calTableDry` → 曲线插值，否则退回线性估算（下限 3.4V） |
| **-b** 满电锚点自刷新 | ✅ 已实现 | `serviceBattAnchor()`：满电停充保持 5 min → 刷新表内 100% 点（强制单调） |
| **-c** 顶栏即时反馈 | ✅ 已实现 | `serviceTopBar()`：PGOOD/CHG 每圈边沿 + 800ms 补刷；WiFi/电量/CC·CV/分钟每 5s 值变化（实测 `topRefresh` 1→2、screen-check 6/6） |
| **临时充电模式切换** | ✅ 已实现 | 同 -a（临时、不持久化、断电复位） |
| **低电特性更新（三档跟校准表走）** | ❌ **未实现** | 三档仍是硬编码常量 `BATT_ARCHIVE_SD=3.6 / BATT_STOP_RECORD=3.55 / BATT_DEEP_SLEEP=3.5`（1092~1094 行）；未按表的 15%/10%/5% 取值 → 即待做④ |
| **省电模式：移动+电池时采样间隔期间浅睡** | ❌ **未实现** | 全代码**无 light sleep**（`esp_sleep.h` 只用于深睡保护 `esp_deep_sleep_start()` + ext0 唤醒）；现有省电手段只有：无线全关(WL_OFF)、屏幕仅整分钟刷、AP/会话超时自动关 |
| **网页 logo** | ❌ 未实现 | HTML 里无 logo / favicon |
| **Bug① 网页响应抖动** | ❌ 未修 | 待测（疑 modem sleep + 阻塞式 Flash 写） |
| **Bug② 今日极值/距平只统计本次开机以来** | ❌ 未修 | `todayExt/todaySlots` 仍只在实时采样路径更新（3586~3591）；`loadBufferFromFlash()`（1853）只灌 RAM 环形缓冲供图表用，**未回灌今日统计** |
| **连带项：低电三档上移** | ✅ 已完成（3.6/3.55/3.5V） | 但"跟着本机表走"仍属待做 |
| **硬件：换 LDO RT9013-33B** | ⏸ 已暂缓 | 2026-09-16 决定暂缓（先查板间输出电容差异）；已挪进 **V2.2** 章 |

**结论**：V2.1.1 三条主线（-a/-b/-c）**均已实装并实测**，标定还跑了两轮；**剩 4 件**：
① 低电三档跟本机表走（代码改造）② 省电浅睡 ③ 网页 logo ④ 两个 bug（响应抖动 / 今日统计回灌）。

---

## 十一、WiFi「连上却够不着」根治 + AP 救援兜底（2026-09-17，V2.1.1 期间）

**现象**：串口日志显示 WiFi 连上了（`✅ 静态 IP 生效: 192.168.42.99`、NTP 同步成功），但 PC 怎么都够不着它 —— 彻底失联，只能拔电。

**根因（串口日志 + 用户网络拓扑确认）**：
- 网络参数（`gw/mask/dns`）是「**DHCP 学一次就落盘**」的（`wifiConnectSaved()` 静态分支）；
- 用户环境里三楼 CPE **故障时会自己发另一个网段的 DHCP**（192.168.42.1/24；正常时是 192.168.1.1/24）；
- 设备曾在故障期连过一次，把这套 **42 网段**参数学进了 `/wifi.json`；
- 之后网络恢复正常，设备仍按旧参数配 **静态 IP 192.168.42.99 + 网关 192.168.42.1**
  → WiFi 显示已连接，但它上不了网、PC 也在别的网段 → **够不着**。
- 证据：串口 `📥 已学习网络参数: 网关 192.168.42.1 ...`；而 PC 侧网关是 192.168.1.1（ARP 里 MAC 与扫到的 AP 同源）。

**修法（两条，均已实装并编译通过）**：

1. **网关自检 + 自愈**（新增 `checkGatewayReachable()`）：连上后 ping 一次网关，并做同网段字节比较 ——
   - 同网段 && ping 通 → 正常放行；
   - 不通 / 不同网段 → **清掉学来的 gw/mask/dns**，若原是静态则**改回自动(DHCP)** 后重连，
     屏幕横幅标 `WiFi DHCP`、日志打印自愈结果。
   → 下次 CPE 再犯病，设备**自己就能爬回来**。代价：开机多一次 ping（600ms 超时）。
2. **AP 救援兜底**（长按 IO9 **≥5s** 松手触发，任何模式/供电都生效，新增 `wifiRecover()`）：
   - 清掉该网络学到的 gw/mask/dns（**关键**，否则重连还用旧网段）；
   - **强制断开 WiFi** + 开热点 `Weather_Station_Pro` @ `192.168.5.1`（10 分钟超时）；
   - 期间 `wantWireless()` 恒返回 WiFi、主循环 60s 重连被禁用 → **热点稳定可达**，不会被自动重连顶掉；
   - 屏幕横幅 `AP RESCUE`；超时/关 AP 时自动清救援态、恢复正常判定；
   - 按住满 5s 时先提示 `HOLD... 松开 = 进 AP 救援`（消歧，避免误切快慢充）；
   - 手势优先级：`≥5s` 救援 > `≥1.5s` 快慢充 / 开无线。

**验证**：`arduino-cli compile` **exit 0**，`Sketch uses 1266483 bytes (7%)`（FQBN 见 README）。
**已串口刷入**（COM4，输出 `Hash of data verified` + 硬复位成功）。

> ⚠️ **上机后的反转（刷完立刻实测）—— 上面"学错参数"的判断只对了一半**：
> 开机日志显示 **`✅ 网关自检通过：192.168.42.1 可达（本机 192.168.42.99）`** ——
> 设备**此刻确实身处 192.168.42.0/24，且它的网关真的可达**，参数**没学错**。
> 失联的真实原因收敛为：**PC 在 192.168.1.0/24（网关 192.168.1.1），与设备所在的 42 网段不互通**
> （PC 侧实测：`192.168.42.x` 全扫不通含 .99；`192.168.1.1` 可达）。
> 修正结论：
> - **不是设备参数错，是两边在不同子网**（三楼 CPE 有"故障期切 42 网段"的行为，设备此刻正落在那个网里）；
> - **自愈逻辑这次不会触发**（它只在"网关不可达"时才动）→ 它是**以后的保险**，不是这次的解药；
> - 要连上设备只能二选一：**① 把 PC 挪进 42 网**（或插到那台 42 网关的 LAN 口）；
>   **② 用新刷入的 AP 救援把设备挪到 1 网**（长按 IO9 ≥5s → 连热点 → `/wifi` 里重配）。

**用户操作路径**：长按 IO9 5 秒松手 → 连热点 `Weather_Station_Pro`（密码 `12345678`）→
打开 `http://192.168.5.1/wifi` → 删掉旧的 `MyHomeWiFi` 记录、重新保存 → 设备重新 DHCP 学一遍参数。

> 📌 **刷入方式**：当前固件够不着网络、OTA 走不通 → 只能**串口刷**（COM4 = `USBSER000`）。
> 编译踩坑（值得记）：工程在 OneDrive + 路径含 `C++`/空格 → `arduino-cli` 的自定义分区 COPY 配方会
> `The syntax of the command is incorrect`；**解法**：把 `.ino/.h/.csv` 复制到纯 ASCII 短路径（如 `C:\phtc\PHT_2_X`）再编译。
> 另：`arduino-cli.exe` 在 `E:\TOOLS\Arduino\Arduino IDE\resources\app\lib\backend\resources\`（`device.ps1` 里写的 D 盘路径已失效）。

---

## 十二、V2.1.1 Bug② 修复：今日统计开机回灌（2026-09-17）

**问题（用户实测）**：`/today-stats` 的今日极值 + 气压距平 1 分钟槽**只统计本次开机之后**的采样；
OTA / 掉电 / 长按复位后，当天已过去的数据全丢（开发期 OTA 频繁 → 特别明显）。

**根因**：`todayExt` / `todaySlots` 只在**实时采样路径**（`readAndLog()`）里更新；
开机 `loadBufferFromFlash()` 只把 `/log.csv` 尾部 `KEEP_IN_MEMORY=600` 条灌进 RAM 环形缓冲
**供图表渲染**，没有回灌今日统计 —— 而 600 条 × 30s ≈ **仅 5 小时**，本来也盖不住一整天。

**修法（已实装）**：
1. 抽函数 **`feedTodaySample(t, tC, h, p)`**：负责「一条采样 → 今日槽 + 三要素极值」，
   **实时采样与回灌共用**（对实时路径行为不变）。
   - 日平均槽仍【只吃固定模式】样本（移动不进基线）；三要素齐全才计入（缺测整体跳过）；
   - 极值不走日平均门控（与原先一致）——`updateExtreme()` 按数值比较、**不看时间戳**，所以回灌旧时间戳安全；
   - ⚠ 本函数**不做跨天重置**（调用方职责）：回灌时若触发 `rolloverDay()` 会把刚重置的存储又清空。
2. 新增 **`backfillTodayFromLog()`**：开机扫**整个 /log.csv**（不只 RAM 那 600 条），
   按 `时间戳本地日期 == 今天` 过滤，逐条喂给 `feedTodaySample()`；
   - 进入前先把 `todayExt.date` 设为今天（否则 `feedTodaySample` 会因日期未就绪直接返回）；
   - 不写 SD、不碰采样节奏，只做一次线性扫描（几千行 ≈ 几十 ms）。
3. **调用点**：`setup()` 里紧接 WiFi/NTP 之后、`startAP()` 之前 —— 保证「时间已就绪 + 引擎已起 + 首次采样之前」。
   实测日志会是：`📥 今日回灌：/log.csv 命中 YYYY-MM-DD 共 N 条（跳过时间戳异常 M 条）`。

**验证**：✅ **已编译通过**（`arduino-cli compile` → exit 0，`Sketch uses 1268207 bytes (7%)`，比修复前 +1724 B）。
✅ **已串口刷入 COM4 并上机实测通过（2026-09-29）**：
- 开机日志实打实出现：`📥 今日回灌：/log.csv 命中 2026-09-29 共 1992 条（跳过时间戳异常 0 条）→ 极值与距平槽已补齐`
- `/today-stats` 与「刷机前用全量 CSV 离线算出的应得值」**逐项对上**：

  | 指标 | 应得（离线算） | 设备实测 | |
  |---|---|---|---|
  | 温度 max/min | 32.92 @13:08:30 / 26.95 @08:45:00 | 32.92 @13:08 / 26.95 @08:45 | ✅ |
  | 湿度 max/min | 73.01 @08:53:30 / 32.22 @00:00:30 | 73.01 @08:53 / 32.22 @00:00 | ✅ |
  | 气压 max/min | 997.96 @08:56:00 / 993.40 @15:43:30 | 997.96 @08:56 / 993.40 @15:42 | ✅（数值一致） |

- ⚠️ 唯一差异：「气压 min」时间戳差 1 分钟（15:42 vs 15:43:30）—— 该值在 15:42~15:44 出现过多次，
  `updateExtreme()` 保留**最后一次**出现的时刻，而离线对照按排序取**第一次**。**数值完全一致，非 bug。**
- 修复前对照（同一次重启后）：温度只报 29.43/29.42、湿度 44.47/44.08、气压 993.60/993.59
  → 即**白天最热的 3.5 ℃ / 28 %RH / 4.4 hPa 全丢**，现在补齐 ✓

> ⚠️ **编译期踩坑（我的锅，已修）**：第一次改 `readAndLog()` 时**留下了一个重复的函数头**
> （新头 + 旧头各一个 `void readAndLog() {`）→ 大括号错位 → 编译器从该处起把后续**所有函数**
> 都报成 `a function-definition is not allowed here before '{' token`（十几个连环错）。
> **教训：函数级替换后要确认旧函数头被一并替换掉** —— 症状是"后面全红"，根因却只在最前面那一个错。

**顺带修的**：`tools/device.ps1`
- `arduino-cli` 路径改为 **`Find-ArduinoCli` 自动搜索**（首选 IDE 2.x 内置路径，候选 + PATH + 限定深度搜索），
  `flash` 改走 `Invoke-ArduinoCli` 包装；默认 `ip` → `192.168.42.99`、默认串口 `COM9` → **`COM4`**。
- ⚠ **踩坑（我的锅）**：该文件原本是 **UTF-16 LE** 编码，我用编辑工具改成了 UTF-8 无 BOM →
  **PowerShell 5.1 会按 ANSI 误读中文** → 已重新存为 **UTF-8 with BOM**（5.1/7 都能正确读）。
  **教训：改动仓库里带中文的 .ps1 后，务必确认编码仍带 BOM。**
- 另把 `ota`/`flash` 两处「行内 `if` 当参数」的写法改成先赋值再输出（PS 5.1 下那种写法会解析报错）。

---

## 十三、V2.1.1 低电三档改成「跟着本机表走」（2026-09-29）

**规格**（设计文档 V2.1.1 · 电源管理模块 4）：有校准文件 → 低电退化特性由文件的低电端百分比确定。

**实装**：
- 新增 `updateBattThresholds()`，在 `calBootCheck()` 里 `calLoadTable()` **之后**调用（开机一次）。
- 取表方式：表是「电压 → 电量%」的 21 点映射 → 从低到高扫，找**首次显示为 k% 的电压**；
  `深睡 = 表5% − 100mV`、`停采 = 表10%`、`存档 = 表15%`。
- **回落值**：无表 / 只有干跑表（`calTableDry`，注意干跑表 `calTableOk` 也是 true，必须用它挡）→ **3.6/3.55/3.5V**（与原固定值一致）。
- 三档由 `const` 改为**运行期变量** `battArchiveV / battStopV / battSleepV`（全代码使用点已替换）；
  `/status` 新增 `lowThr:{archive,stop,sleep}` 便于核对生效值。

**首板实测（本机表 n=85、dry=0、v0=2.969V、v100=4.141V）**：
```
🔋 低电三档已按本机表刷新：存档 3.735V(表15%) / 停采 3.701V(表10%) / 深睡 3.522V(表5% 3.622−100mV)
```
⚠️ **比原固定值更保守**（存档 +135mV、停采 +151mV、深睡 +22mV）：本机表低电端平缓（5% 就有 3.622V），
而原 3.6/3.55/3.5 是"按表 5/10/15% **再减 100mV**"的口径。**是否给三档都加余量待用户定**（见下）。

**踩坑（我的，已修）**：
- 第一版守卫写成「0% 点 ≤ 3.0V 就判表可疑并整表否定」→ **把正常表全否了**：
  本机表 0% = 2.969V，正是标定被 `CAL_FLOOR_V=3.0V` 硬底线收工时的落点（设计文档 2.3 记的同一数值），
  **是实测到的真实底线，不是脏数据**。已改为：只夹紧深睡档（`sleep ≥ CAL_FLOOR_V + 50mV`），不整表否定。
- ⚠️ 该函数里**格式串占位与实参必须对齐**：改日志文案时漏加 `v5` / `clamped` 两个实参 → 编译期
  `-Wformat` 会报（或运行时乱读栈）。**教训：改 `printf` 风格日志时，先数占位符再改实参。**

**待用户决定**：是否把三档统一改成"表 5/10/15% − 100mV"（≈3.635/3.601/3.522，与旧口径一致）？
当前实现是**严格按规格**（只深睡留余量）。

---

## 十四、省电对比实验（临时 harness）+ ⚠️ 浅睡把 USB-Serial-JTAG 搞死（2026-09-29）

**目标**（用户提议）：跑一晚，**逐小时交替两个状态**（当前实现 loop 空转 ⇄ 采样间隔浅睡），
**比较每小时"电压/电量下降"**（不是比电流 —— 见下方铁律），看浅睡到底省多少。

**harness（临时，带开关，实验完删除）**：
- `ABTEST_ENABLE` / `ABTEST_PREFLIGHT` 两个编译开关；`AB_BLOCK_MS` 换模式周期（预检 60s / 正式 1h）。
- 仅在 **移动 + 电池** 时跑（此时按设计**无线全关**，射频不是变量）；每个 block 结束把
  `session,idx,mode,start,dur_min,Vstart,Vend,dV_mV,dV_mV_per_h,pctStart,pctEnd,dPct,n_Iref_samples`
  **追加落盘 `/abtest.csv`**（防掉电丢数据），并缓存进 RAM；`GET /abtest` 出 JSON。
  **CSV 记录不受影响**（本实验不停 CSV）。
- **主指标 = 每小时电压降 `dV_mV` / `dV_mV_per_h` 与电量%降 `dPct`**（用户 2026-09-29 指定）：
  **不用电流算电量** —— 铁律见 [`实现细节.md`](实现细节.md) 顶部「⛔ 不要用 ESP32 读 INA226/230 电流做电量计算」。
- **睡眠要睡满整段**：每 30s 采样周期里睡 ~29.7s（到下一采样点前 300ms），
  "插电/按键立刻醒"由 **ext1 GPIO 事件唤醒**保证（GPIO 能立刻打断长睡眠）。
- 电流仅**每 10 分钟采一次、只打参考日志**，明确标注"不作电量依据"。

**⚠️ 三次自己造成的返工（都记下来，别再犯）**：
1. **睡眠切片的粒度错了**：一开始把单次睡眠切成 **≤2s 小片**（本意是保响应）→ **每 30s 只睡 2s，
   最多省 2/30 ≈ 7%，根本测不出浅睡收益** ✗。正解：**睡满整段**，"立刻醒"交给 GPIO 事件唤醒。
2. **用电流算电量**：原 harness 每 25s 攒"平均电流"并给出 `mAh_per_block` → **违反观察者效应铁律**
   （ESP32 自己唤醒读表那一刻，自己就是负载）✗。已全部改为电压/电量口径，电流降级为"仅参考日志"。
3. **字符串整段替换误删括号**：把 `loop()` 里 `if (!abStarted) {` 的闭合括号吞掉 →
   编译报 `void loop(){ ... expected '}' at end of input`。**教训：整段替换后先做括号配平检查**
   （症状是"loop() 缺右括号"，根因在那个多出来的左括号）。

**⚠️ 重大踩坑：浅睡 + 板载 USB-Serial-JTAG = 设备假死**
- 我图省事让**预检在 USB 供电下也执行浅睡** → 结果：主机侧串口报
  `A device attached to the system is not functioning`、COM4 打不开、设备从网络上消失（ARP 都没了）。
- **按 EN 也救不回来** —— 说明卡的是 **USB 外设那一层**（不是芯片跑飞）：ESP32-S3 浅睡会挂起 USB-Serial-JTAG。
  预期恢复手段：**拔插 USB 线**（给 USB 外设重新上电）。
- **教训**：涉及 `esp_light_sleep_start()` 的验证，**必须在「没有 USB 主机连接」的前提下做**；
  板载 USB-Serial-JTAG 与浅睡是冲突组合，别指望插着 USB 调它。
- **已加的硬保护**（改进版已编译通过）：
  ① `isExternallyPowered()` 或 USB CDC 连着（`Serial` 为真）→ **一律不睡**；
  ② 单次睡眠**切成 ≤2 s 小片**（不至于长时间无响应）；
  ③ 睡/醒各累加一个 `RTC_DATA_ATTR` 计数，重启后仍可读 → 能区分"睡了没醒"还是"醒了没输出"。

**结论（待验证）**：正式实验前必须先确认"电池态浅睡不假死"。若仍假死，则浅睡方案本身要重新设计
（可能需要先 detach USB 或改用 modem-sleep）。

---

## 十五、V2.1.1 术语更名：「手持」→「移动」（顶栏 `HAND` → `MOV`）（2026-09-29）

**规格来源**：设计文档 **V2.1.1中的改动 · 软件 · 交互和可视化** 第 4 条（用户 2026-09-29 写入）。
**词元定案**：`MOV`。理由：与「移动」1:1 对应；**3 字符与 `FIX` 等宽**（`FIX`=27px / `HAND`=36px），
顶栏模式列不再随模式左右跳；且不与现有词撞车——`ACT` 轴不对（本模式讲的是**部署方式**，
不是"活跃"）、`FREE` 不指向"移动"且 `FIX↔FREE` 不成对、小屏易读成"空闲"、
`MOB` 有歧义、`PORT` 与项目里的"端口"撞车。
**呈现**：顶栏 `FIX ⇄ MOV`；网页 `🏠 固定 FIX` / `🎒 移动 MOV`；`/status` 的 `modeStr` 与 `/mode` 日志同步。

**范围与处数**（纯文本 1:1 改名，**零逻辑改动**）：

| 文件 | 手持→移动 | HAND→MOV |
|---|:---:|:---:|
| `PHT_2_X.ino` | 60 | 10 |
| `实现细节.md` | 24 | 4 |
| `设计文档.md` | 19 | 0 |
| `README.md` | 9 | 2 |
| `ui_display.h` | 3 | 5 |
| `硬件核对清单.md` | 1 | 0 |
| 本文件（含历史行） | 15 | 1 |
| **小计（不含 `tools/`）** | **150** | **26** |
| `tools/`（`anomaly-check.mjs` / `ble-web.html` / `device.ps1` / `README.md` / `dump-page.mjs`） | 19 | 4 |

- **顺带补上 `1331003` 漏掉的 `tools/`**：该目录至今还残留上次没改的 `驻场`/`SITE`，一并改为 `固定`/`FIX`（17 处）。
  这些脚本会打印设备模式（如 `MOV 移动` / `FIX 固定`），不改就会和新固件对不上。
- **未动**：`README.old.md`（归档，保留原术语）、`backups/`（归档）。
- **历史行也改了**：对齐 `1331003` 的先例（该 commit 同样改了 `README` 变更记录里的历史日期行）。
  代价：日志文字与其引用的旧 commit 标题（git 里仍写「手持」）不再逐字一致。

**校验**：
- 改名后全库只剩 3 个位置还有「手持」：`设计文档.md` 的规格行本身、`README.old.md`（归档，保留原术语）、以及本条目（描述改名本身）。
- **编译通过 `Sketch 1270175 B`**；同配置改名前基准 `1270191 B`，**−16 B**。
  字节层面的变化只可能来自 `HAND→MOV`（每处字符串字面量短 1 字节，7 个字面量 → −7 B），
  其余差额是 rodata 长度变化带来的对齐/填充涟漪；`手持↔移动` 是等长 UTF-8（各 6 字节），字节层面零影响。
  > 二次核验：改后固件 `.bin` 里 `手持`/`驻场` 均为 **0** 处；`HAND` 仍有 6 处，但**全部来自链接进来的 ESP32 SDK**
  > （SDK 预编译库里该子串共 103 处，均为 `HANDLE`/`HANDSHAKE`/`HANDSET` 类符号）——源码里已无任何 `HAND`。
- 改名在 **`feat/mobile-mode-rename` 分支**上做（遵守 2026-09-29 定的「测试性/实验性改动先开分支」约定）。

---

## 十六、绝对湿度（AH）曲线上线 + 湿度变率口径统一（2026-09-29）

**规格来源**：设计文档 V2.1.1 · 交互和可视化 第 3 条（湿度变率改绝对湿度，早就立着）、
🆕 第 5 条（湿度图叠加 AH 曲线，用户 2026-09-29 提出）、· 🚧 待做 第 6 条 —— **三条一次收口**。

**做了什么**：

1. **共用公式** `absHumidity(tC, rh)`（`PHT_2_X.ino:1453`）：Magnus/Tetens
   `es = 6.112·exp(17.67T/(T+243.5))` hPa、`AH = 216.7·(RH/100)·es/(T+273.15)` g/m³。
   **网页曲线 / 网页变率 / 屏幕变率三处都调它** —— 这是「唯一口径」的硬约束，分开写必然分叉。
2. **变率改 AH**：`trendH24` 由 `humidity − 槽内湿度`（%RH）改为 AH 之差（g/m³）。
   `hourRing` **结构不变**（槽里仍存原始 T/RH，读时现算）→ 零额外 RAM、落盘格式不变。
   整点日志同步改成 `ΔT=.. ΔAH=.. ΔP=..`。阈值仍 `UI_TREND_TH = 0.1`（规格未改）。
3. **`/history` 与 `/data` 每点新增 `ah` 字段**（设备端算，网页不重写公式）→ 载荷约 +11 B/点。
4. **湿度图改双 Y 轴**：`draw()` 扩成多序列 `series=[{values,color,axis}]`，左轴 %RH、右轴 g/m³；
   有右轴时右边距 15→46；加图例；**单序列调用与旧行为等价**（温度图、气压图未动）。
   前端对缺 `ah` 的数据**整条降级**，图自动退回单轴。

**验证（全部实测）**：

- **公式自检**：T=25/RH=50 → 11.51；0/100 → 4.85；30/80 → 24.28；20/100 → 17.27 g/m³（对上教科书值）。
- **实机复算**：AH 版固件刷入设备（COM5）后，`/history` 取 8 点，设备 `ah` vs 独立双精度复算
  **最大偏差 0.0045 g/m³**（float32 舍入量级）；`/data` 同字段齐全。
- **网页 8 项文案/接线逐项命中**（图例两轴、单位 g/m³、无旧词「手持」、多序列 draw、AH 序列已接线…）。
- **内嵌 JS 语法**：新写的校验器把 7 个 `<script>` 块用 `new Function()` 逐个过 —— **0 失败**。
  ⚠️ **C++ 编译器不管原始字符串里的 JS，这一步不能省。**
- **编译**：按仓库现状（harness 开）`Sketch 1279051 B / 7%`，exit=0；刷机用的 harness 关版本 `1273403 B`。
- 花括号平衡与 HEAD 同为 −2（历史固有，来自字符串里的 `}`），本次 +17/+17 平衡。

**踩坑**：

- ⚠️ **arduino-cli 要求 sketch 目录名与 .ino 同名**：副本放 `C:\phtc\PHT_2_X_off` 直接报
  `main file missing from sketch: ...\PHT_2_X_off.ino` → 必须 `C:\phtc\off\PHT_2_X`。
- ⚠️ 补丁脚本的正则漏了个前导逗号导致 0 命中；但脚本**因断言失败拒绝写回**，文件没被改坏。
  **教训：批量改名/打补丁必须带「恰好命中 1 次」断言，且全成功才落盘。**
- 📌 顺手纠错：D23 原写「`/status` 的 `trend24T`」是错的，实测是 **`/today-stats`**（已改）。

**待确认**：

- `trend24H` 的第一个**真值**要等 24h（只在整点算、需环里有 24h 前的值；设备 2026-09-29 22:41 重启）
  → 约 **09-30 晚间**。本次验证到的是「同一函数的 `/history` 路径数值正确 + 三处调用点接线正确」。
- 屏幕湿度行的**变率省略单位**是既有规格，但现在同一行有两个单位（%RH 与 g/m³）→ 见 D25-3 的提示。

---

## 十七、网页 logo + favicon 上线（2026-09-29）

**规格来源**：设计文档 V2.1.1 · 交互和可视化 第 2 条「新增网页logo」+ 🚧 待做 第 5 条「给网页加 logo」—— 收口。

**选型**（用户 2026-09-29 定）：母题 = **雷暴（云 + 闪电 + 气压尖峰）**，**同一图形、两个复杂度**
- 页面内 logo = **C 全要素**（云 + 闪电 + 尖峰）—— 把项目故事整条画出来：雷电劈下来正好顶在气压尖峰上
- favicon = **F 精简版**（云 + 闪电，去掉尖峰）—— 16px 下三个元素会互相挤成一团
- 三色语义：云 = 深板岩 `#34495e` ／ 闪电 = 琥珀 `#f39c12` ／ 尖峰 = 曲线绿 `#27ae60`
- 6 变体 × 88/32/16px 图纸：`WORKS/logo_storm_candidates.html`（**仓库外**，不污染仓库）

**改版理由（同日内第二版）**：第一版选的是「屏幕 + 上升曲线」，用户反馈**看着像炒股软件**
（上升折线 + 端点圆点确实是行情软件的图标语汇），并补上关键背景：**本项目初衷是捕获雷暴过境时的超压**。
于是母题从"记录仪"换成"雷暴"——**画雷，也画被它顶起来的那一下超压**，这才是区别于任何天气 App 的地方。
> ⚠️ **通用性 vs 辨识度的权衡**：「云 + 闪电」是最经典也**最通用**的雷暴符号（任何天气 App 都有），
> 所以页头带上气压尖峰做区分；favicon 位置太小放不下三元素，靠"雷 + 云"保直观。

**做了什么**：

1. `WEB_ICONS`（`PHT_2_X.ino:2470`，原名 `WEB_FAVICON`）：SVG **data URI**，编码后 **552 字符**，挂到**全部 5 个 HTML 页面**的 `<head>`
   （`/`、`/web-log`、`/wifi`、`/update`、`/battcal`）—— 只挂主页的话，切到设置页标签图标会退回默认地球。
2. `WEB_LOGO_SVG`（2480）：主页面页头内联 SVG（**30px**，三元素吃像素故从 26px 提上来），flex 与标题同行；
   **移除原来当临时 logo 的 `🌤️` emoji**。
3. 用 data URI 而非新开路由：零额外请求、无需新路由、AP 配网模式下同样有效。
4. **favicon 的云用深色实心**（`#34495e`）：浅灰云在白标签栏上 16px 会冲淡成一团雾 ——
   小尺寸可读性本质是**对比度**。代价是深色标签栏下会糊成黑块，故 SVG 内加
   `@media(prefers-color-scheme:dark)` 把云翻成浅色（不支持的浏览器退回深色云，**没有下行风险**）。
5. **iOS 主屏图标（apple-touch-icon）**：iOS **不接受 SVG** 当 apple-touch-icon（独立于现代 favicon 的老机制，
   必须 180×180 PNG）→ Edge 无头渲染 PNG（**3,042 字节**）→ `web_icon.h` 字节数组 →
   `/apple-touch-icon.png` 从 flash 直发（`send_P`，不占 RAM）+ 长缓存；另放行 `-precomposed` 旧名。
   常量 `WEB_FAVICON` 因此**改名为 `WEB_ICONS`**（它现在同时装 favicon 和主屏图标两个标签）。
6. **Android 主屏图标 + PWA manifest**（用户 2026-09-29 追加）：`/icon-192.png`、`/icon-512.png`
   （2,833 + 7,823 字节，flash 直发）+ `/manifest.webmanifest`（`display:standalone`、
   `theme_color`/`background_color` = `#2c3e50`、两条 `purpose:"any maskable"`）；
   5 个页面加 `<link rel="manifest">` + `<meta name="theme-color">` + `apple-mobile-web-app-title`。
   **maskable 会被启动器裁成圆形**，安全区只有画布 80% 直径 → 内容正方形对角线 ≤ 半径 → 边长上限 56.6%，
   故这两档把图形缩到 **55%**（iOS 的 180 档仍是 69%：iOS 只切圆角、不裁内容）；
   底色满铺，所以裁成圆形也是整块深色 App 图标，不会出现"白圈里一个小图"。

**验证（都是实测）**：

- **端到端解码比对**：从设备逐个拉 5 个页面，抽出 favicon 的 data URI、`decodeURIComponent` 解码，
  与预期 SVG **逐字节完全一致（5/5）**；favicon 挂载 **5/5**。
- 主页面 9 项结构逐条命中（flex 页头、云/闪电/尖峰三段、30px、**旧母题已无残留**、emoji 已移除、AH 图例回归…）。
- favicon 特性核对：含深色模式媒体查询 ✅、云 `#34495e` ✅、闪电 `#f39c12` ✅、精简版不含尖峰 ✅。
- 内嵌 JS：7 个 `<script>` 块语法 **0 失败**（这次只加 HTML，但同一道照样跑）。
- 编译：仓库现状（harness 开）`Sketch 1297011 B / 7%`；刷机用 harness 关版本 `1291363 B`
  （iOS 图标那步 +3,920 B；Android 那步 +12,252 B = 新增两档数组 10,656 + 路由/manifest 代码）。
- **主屏图标端到端比对（四条路由全验）**：从设备取回 4 个图标 URL，与本机 PNG **逐字节完全一致**：
  `/apple-touch-icon.png` 与 `-precomposed`（3042 / 180×180）、`/icon-192.png`（2833 / 192×192）、
  `/icon-512.png`（7823 / 512×512）；`Content-Type: image/png` 与 `Cache-Control` 均正确。
- **manifest 逐字段核对**：`Content-Type: application/manifest+json`、JSON 合法，
  name / short_name / start_url / display / theme_color / background_color / icons 两条（含 purpose）全对。
- **5 个页面 × 5 个标签全中**：manifest ✓ theme-color ✓ apple-mobile-web-app-title ✓
  apple-touch-icon ✓ SVG favicon ✓；页头 logo 与 AH 双轴图回归正常。

**踩坑**：

- ⚠️ **补丁脚本生成的 C++ 常量漏了结尾分号**（`static const char* X = "..." void startServer()`），
  编译直接报 `expected ',' or ';' before 'void'`。
  **教训：脚本生成的代码必须走编译验证，不能只靠"看着对"。**
- ⚠️ 一条命令里连做两次 arduino-cli 编译 + 刷写会**超过 120 秒命令上限被腰斩**
  （第二次编译中途被砍、产物不可用）→ 长活要拆开跑或显式加大超时。
- ⚠️ **改母题时又把 `WEB_LOGO_SVG` 定义写重了一份**：补丁脚本第一次替换插入的新定义**位置更靠前**，
  于是第二个「替换旧定义」的正则匹配到了**它自己刚插入的那一份**，旧定义原封不动留下 →
  编译报 `redefinition of 'const char* WEB_LOGO_SVG'`。
  **教训：多步替换脚本里，后一步的锚点可能命中前一步的产物；每步都要断言"替换后全文仍只有 1 处定义"。**
  （本功能一天内被编译逮住两次——也说明"生成代码必须走编译"这条规矩是对的。）

**同一母题、按平台分档**（响应式 logo 做到头）：

| 场合 | 图形 | 图形占画布 | 底/色 |
|---|---|:---:|---|
| 浏览器标签 favicon（16px） | F 云 + 闪电 | — | 透明；深色云（深色模式翻转成浅色） |
| 页面页头（30px） | C 云 + 闪电 + 尖峰 | — | 白卡片 |
| iOS 主屏（180px） | C 云 + 闪电 + 尖峰 | **69%** | 深板岩底 + 浅色云 |
| Android 主屏（192 / 512px） | C 云 + 闪电 + 尖峰 | **55%** | 同上 |

> **两个"故意不一致"都有硬理由**，不是随手定的：
> ① 主屏底色与 favicon 相反 —— 主屏图标是独立一块瓷砖，深底更像"App"、在壁纸上更立得住；
>    favicon 要贴白色标签栏，所以用深色云。
> ② Android 图形只占 55%（iOS 用 69%）—— `maskable` 会被启动器裁成圆形，安全区只有画布 80% 直径，
>    内容正方形对角线 ≤ 半径 → 边长上限 56.6%；iOS 只切圆角、不裁内容，所以能用 69%。

---

## 十九、省电 A/B 测试：把一晚跑废的 6 个坑（2026-09-30，教训台账）

> **背景**：用户拔电跑了一整晚做"浅睡 vs 不睡"对比，**结果一个数据都没拿到**。下列 6 个坑全是**我自己造成的**，
> 逐条记下，避免重犯。**本节的价值 > 实验结果本身**。

### 坑① 预处理器顺序：`#define` 写在使用点之后 → 端点被静默剪掉（最隐蔽）

```c
// 第 3279 行：                  // 第 4959 行（太晚）：
#if ABTEST_ENABLE               #define ABTEST_ENABLE 1
  server.on("/abtest", ...);    // ← 预处理器单遍扫描，3279 行时宏未定义 = 0 → 整块被删
#endif
```
- **症状**：编译 `exit=0` 完全正常；开机日志里 harness 的横幅**照常打印**（因为定义之后的部分生效了）；
  但 `/abtest` 永远 **404**。→ 两边证据矛盾，极难定位。
- **根因**：C 预处理器对**未定义标识符在 `#if` 里当 0**；且**扫描是单遍、从上往下**。
- **为什么没早发现**：我**只验了"编译通过"，没验"端点真的能访问"**。
- **修法**：开关/常量**一律放文件最前**（本工程已放在第 1~15 行）。
- **规矩**：**新增 HTTP 端点后必须实际请求一次**（`curl`/`Invoke-WebRequest`），编译通过 ≠ 功能在线。

### 坑② 启用条件"只判一次" → 用户拔了一晚，程序毫不知情

```c
static bool abStarted = false;
if (!abStarted) {              // ← 只跑一次
  abStarted = true;            // ← 设上就永不重判
  bool eligible = ... !ps0.powered;   // ← 这一刻必须"已拔电"
```
- 我**刷完固件时设备还插着 USB** → 那一瞬判成"不合格" → **之后用户拔电也永不启用**。
- **修法**：资格**每圈重判**，条件一满足就自动开始（`eligible` 每轮算）。

### 坑③ 数据落盘"整块跑满才写" + 每次开机 `remove()`

- 只在 **block 结束**时写文件 → 跑不满一小时 = **一个字节都没有**；且开机 `LittleFS.remove()` 会**清掉已有数据**。
- **修法**：① **只追加、绝不清空**；② 每个 block 边界都写（含未跑满的 partial 行）；③ 首次自动写表头。

### 坑④ 阻塞式串口输出 → **卡死主循环**（伪装成"设备死了"）

```c
while (f.available()) Serial.write(f.read());   // ← USB CDC 发送缓冲满 → 阻塞整个 loop
```
- **触发条件**：主机没在读串口（例如我们正在发 HTTP 请求）→ 缓冲填满 → `Serial.write()` 不返回。
- **症状**：设备 HTTP 无响应、串口也无输出，**表现得和"睡死"一模一样**。
- **连锁误判**：我据此认定"长睡眠把设备搞死"，于是把睡眠切成 5s 小片 → **收益从 ~95% 掉到 ~7%，实验失去意义**。
  **真凶与浅睡无关**，用户追问后才发现。
- **修法**（两道）：① 只在 `abUSBHostConnected()` 为真时写（没主机一个字节都不写）；
  ② 每圈先看 `Serial.availableForWrite()`，只写它允许的量（≤96B/圈）。
- **规矩**：**任何往串口/网络大量输出的地方都必须非阻塞**；嵌入式里"阻塞写"是头号杀手。

### 坑⑤ USB-CDC 的"主机已连接"看的是 **DTR**，且 `DTR` 被拉高会复位芯片

- `(bool)Serial` 对 ESP32-S3 原生 USB-CDC **反映的是主机是否置了 DTR**。
- 我用 `$sp.Open()`（.NET 默认 **DTR=false**）读串口 → 设备认为"没主机" → 挂起式自卸**不写**。
- 反过来 `DtrEnable=$true` 会**触发芯片复位**（正常终端打开串口就会这样），我误判成"设备又卡了"。
- **修法**：自卸改成**"挂起式"**（进待命，等主机真接上再发）+ **插电期间每 5 分钟重开** + **串口敲 `d` 手动重发**。
  这样取数**不依赖时机**，也不依赖 DTR 语义。
- **规矩**：USB-CDC 的"连接状态"不能当可靠的物理量；**取数要设计成"随时能主动要一次"**。

### 坑⑥ 刷机/复位后要等 ~40 秒才上线，我多次误判为"设备死了"

- 启动时序：ROM → 外设自检 → WiFi 连接 → DHCP 学习 → 静态 IP → **网关自检** → NTP → **今日回灌** → 起 HTTP。
  实测**复位后约 40 秒**才响应 HTTP。
- 我多次在 10~30 秒就去请求 → 失败 → 判断"设备卡死/嗝屁" → 白折腾好几轮。
- **规矩**：**验证前先等够**（或轮询到上线为止），别把"还没起来"当成"坏了"。

### 坑⑦【事故】为了"方便验证"临时放宽守卫 → 设备进入崩溃循环（2026-09-30）

- **我怎么做的**：浅睡守卫（`isExternallyPowered()` + `curWireless != WL_OFF`）在插电时不让睡，
  于是**为了在插电状态下"看到"浅睡**，我把两条守注释掉刷进去观察。
- **结果**：设备几分钟内挂死 —— 串口 0 行、`esptool` 也握不上手（`Failed to connect: No serial data received`）、
  网络时通时不通（看门狗反复复位形成的崩溃循环）。**只能靠拔插 USB 才救回来。**
- **日志留下的硬证据**：
  ```
  ⚠️ 浅睡返回错误 259（累计 1 次）        ← 259 = ESP_ERR_INVALID_ARG
  😴 浅睡：累计睡 1 / 醒 1（最近唤醒源 其它）单片 10906ms 失败 1
  ⚠️ 浅睡返回错误 259（累计 2 次）
  ESP-ROM ...                            ← 被复位
  ```
  ① 睡眠时长算出了 **10906ms**（正常应 ~29.7s）→ 说明当时 `timeSynced`/`tm_sec` 取到了异常值；
  ② 返回 **259** 说明参数非法 → **`lightSleepOnce()` 应当对时长做合法性夹紧**（已夹 50~29000ms，
     但"剩 10.9s"这种值本身就该被怀疑：它意味着采样点计算跑偏了）。
- **反证（本次事故最大的价值）**：
  | 守卫 | 结果 |
  |---|---|
  | **正确守卫**（插电不睡、WiFi 不睡） | 昨晚连续跑 **十几小时**，数据完好、无复位 |
  | **放宽守卫**（插电也睡） | **几分钟内挂死**，串口/网络全丢 |
  → **守卫不是"保险"，是"必需品"**。
- **规矩（写死）**：
  1. **绝不为"方便观察"放宽安全守卫**；
  2. 要测被守卫挡住的分支，**必须用独立的最小测试固件**（或编译期开关 + 明确标注"仅测试"），**不得改主逻辑**；
  3. 出事后**先恢复守卫并重新刷入已知良好版本**，再谈验证。

### 教训总结（一句话版）

| # | 一句话 |
|---|---|
| ① | **编译通过 ≠ 功能在线**：加了端点必须真的请求一次 |
| ② | 启用条件**别只判一次**，要每轮重判 |
| ③ | 数据**只追加不清空**，跑不满也要落盘 |
| ④ | **绝不阻塞写**：串口/网络输出前先看缓冲空间 |
| ⑤ | 取数要能**随时主动要一次**，别依赖"恰好有人接着" |
| ⑥ | 复位后**等够再验**（本工程 ~40s） |
| ⑦ | **绝不为"方便观察"放宽安全守卫**——要测被挡的分支就用最小测试固件 |

> **另一条操作教训（git）**：`git checkout <branch> -- <file>` 会**只改这一个文件**、把工作区留成
> "半个分支"状态（本次导致 `web_icon.h` 缺失、编译失败）。**换分支基线应该用 `git stash` + `checkout`，
> 或先提交**；路径式 checkout 只适合"单文件回滚"。

---

## 二十、网页宽屏布局：4K 上不再把曲线拉平（2026-09-30）

**起因**：用户拿手机和 4K 桌面各截了一张图对照 —— 手机上图表比例很好，桌面上"拉太平了，味道不对"。

**根因**：`resizeCanvas()` 的高度**恒为 200px**，而主页面 `body`/`.card` 都没有 `max-width` →
宽高比随屏幕线性崩坏。量了一下：手机约 **1.9:1**，4K 桌面 **10.0:1**。
损失的不是好看，是**细节可读性**（10:1 下横向 1px 的数据变化只有 3:1 的三分之一，小回落/台阶被压没）。

**做法**（用户从 4 个预览方案里选了"3 列、每图封顶 660px"）：

1. 只加一条媒体查询：`@media (min-width:1000px)` 把 `body` 变成
   `grid-template-columns:repeat(auto-fit,minmax(440px,660px))` + 居中。
   **1000px 以下完全不进** → 手机档逐像素不变（本改动的红线）。
2. **一行 JS 都没改** —— `resizeCanvas` 读 `card.clientWidth`，卡片窄了它自动算对。
   ⚠️ 反过来不行："卡片仍宽、只给 canvas 加 max-width"会把画布压扁（行内 width 与绘图缓冲不一致）。
3. 连带修数值行：列一窄，`.latest-values` 换行后 **`flex:1` 让落单的那个撑满整行**（截图上是个巨大蓝盒子）
   → 改成 `grid + auto-fit`（折叠空轨道，落单只占一格）；供电状态的值是文字，另加 `.wide{minmax(160px,1fr)}`。

**验证**：直接截**设备真实页面**看 —— 2058px 下 3 列、温度｜湿度｜气压 并排、每张 **630×200 → 3.2:1**、
数值行正常；600px 下单列、无溢出。3 列下前三个子元素正好是页头/供电/设备模式，所以**三张趋势图天然就在第二行并排**，
一张卡都不用跨列。

**踩坑（都在 D27-5）**：

- 我一度**误判"窄屏横向溢出"** —— 其实是 headless Edge 在 Windows 上有**最小窗口宽度**，
  按 `--window-size=400` 截出来的图是 ~570px 布局的**裁切**。要验窄屏得用 ≥600px。
- headless Edge 不给 `--user-data-dir` 时会用默认配置目录 → 上一个实例没退干净就**永远等锁**、不产出截图。

**已知边界**：1000~1335px 这一段只有 1 列（列数由 max=660 驱动，两列需要 1335px），观感是"窄居中列"。
另外**今日气压距平曲线在移动模式下是空白卡**（画布里的浅灰占位字几乎看不见）—— **既有行为，本次未处理**。

---

## 二十一、未插卡时的日志兜底：按时间戳裁头 + 按需挂载 SD（2026-09-30）

**起因**：用户问「写 flash 这么频繁会不会磨损过快」。结论是**磨损不是问题**，但顺手挖出**两个真问题**。
量化与实现细节见 `实现细节.md` **D5-2 / D28**。

**① 磨损：不是问题（但"怎么查"值得记）**

- **数据量不是重点**：138 KB/天（2880 条 × 48 B）→ 50 MB/年 ÷ 3.38 MB 分区 ≈ 每年写满 15 遍，
  分摊到 864 个块 ≈ **每块 15 次擦写/年**，可忽略。
- **真正的热点是"元数据提交"**：`safeAppendFile()` 是 `open("a") + println + close()`，
  每次 `close()` 提交一次元数据 → **2880 次/天**，全砸在 `/log.csv` 那对
  **固定不搬家的 2 个块**上 → 估算 **2,000~5,600 次/年** → 按 10 万次 endurance 算 **18~50 年** ✅
- ⚠️ **扩分区治不了这一项**（那对块固定）；只有"减少提交次数"（批量写）能降。
  但**批量化会换来"图表最新点滞后 N 分钟"**（`/history` 直接读那个文件，而页面每 30s 轮询一次，
  想"读前先 flush"等于把收益抵消）→ **权衡后不做**，等真有"网页抖动来自 flash 写"的实测证据再说。
- 查证本身的价值：**NVS 只在用户操作时写**（切模式 / 标定开关），没有任何按采样写 NVS 的操作 ✅
  —— 那才是真会要命的写法。另外就是那次用 `esptool flash-id` + 读分区表（→ D5-1 / D5-2）。

**② 真问题：不插卡时 `/log.csv` 只涨不清**

- 轮转唯一路径是"归档到 SD 后删除"→ 不插卡则永不轮转 → 3.38 MB **约 26 天填满**，
  满后写失败（有告警），而唯一腾空间手段是 `/clear`（全清）。
- 补：**没插卡时每天 02:00 裁掉超过 14 天的头部**（`trimLogOlderThan()`）。
- ⚠️ **口径纠正**：最初想"删掉前 2880 条（一天）"，但低电压会跳过记录、重启也丢采样，
  一天常不到 2880 条 → **按固定条数裁会越裁越少、把自己吃光** → 改成**按时间戳裁**（保留期恒为 14 天）。

**③ 真问题：`sdOK` 只在开机判定一次**

- `initSD()` 全文件只在 `setup()` 调一次 → **运行中插卡不被发现**，必须重启；
  连网页手动点「归档」也失败（它开头就判 `sdOK`）。
- 用户提的改法（"写卡前尝试初始化"）**比我原本想的定期轮询更好**：按需触发、不浪费后台探测、
  正好覆盖真实用卡的三处 → 落成 `ensureSD()`，接在 `archiveToSD()` / `/sdlist` / SD 下载三个入口。
- ✅ 安全性已核对源码：SD 在 `SPI3(HSPI)`、屏在 `SPI2(FSPI)` → **两条独立外设**，
  运行中重挂 SD 不打扰屏幕。⚠️ 但 `SD.begin()` 阻塞，绝不能进 30s 采样路径。

**实测**（临时副本 `KEEP_DAYS=1` + 临时关窗口，仓库源码不动）：8479 → 裁 5952 / 保留 2532，
算术闭合（5952+2532=8484）；`/history` 的 total=2534 与 `/download?f=/log.csv` 的
2535 非空行（表头+2534）互相印证；首行时间戳落在 1 天窗口内 ✅ 详见 D28-5。

**踩坑与教训**：

- ⚠️ `checkAndArchive()` 在 02:00~02:04 窗口内**每 30s 重试一次** → 裁头必须自己设
  `doneYday` 守卫，否则会连做 10 遍（= 重写 2 MB 文件 10 遍）。
- ⚠️ **又犯了一次"从 grep 结果推断控制流"的错**：看到 `if (archiveToSD(false)) doneYday = …;`
  就断言归档是"日切后第一次采样"触发，结果被用户一句"凌晨两点本来就是写卡时间"纠正 ——
  `checkAndArchive()` 里明写着 `if (tm.tm_hour != 2 || tm.tm_min >= 5) return;`。
  **教训：控制流必须读函数，不能从 grep 行猜。**
- ⚠️ 补丁脚本把花括号断言写成"全文平衡"是错的：这个 `.ino` 里塞满 HTML/CSS/JS 字符串字面量，
  花括号本来就不配对（实测基线 **−1**）→ 必须比**插入前后的差值**。
- 附带搞清：不带 `?f=` 的 `/download` 吐的是**内存环**（600 条）不是文件（故意设计，防旧数据），
  要文件得 `?f=/log.csv` —— 我一度把它当成"下载只吐 602 行"的怪事。

---

## 二十二、2.1.1 收尾：5 分支合并 + 上机验收（2026-10-02）

**关键发现**：2.1.1 的 5 个 feature 分支**不是彼此独立的兄弟，而是层层叠加的一条链**：

```
9eaf2a2（当时 main）
  └─ 7e12e24 术语统一（feat/mobile-mode-rename）
      └─ 8ecd9d1 绝对湿度（feat/abs-humidity）
          └─ 02229fe…909b234 logo/PWA（feat/web-logo）
              ├─ 24f79ce…07c9269 harness 测试（test/ab-sleep）   ← 丢弃
              ├─ f894e49 教训文档 → ab377e8 宽屏/未插卡兜底（feat/wide-layout）
              └─ 93147ae…6ec6b42 浅睡实装（feat/light-sleep）     ← 最完整、最干净
```

→ **`feat/light-sleep` 已含前 4 个功能**，只缺 `feat/wide-layout` 的 2 个提交。

**合并方式**：不用 `merge`（会把 harness 测试代码一起带回来），改用 **cherry-pick 精选**：
1. `cherry-pick 12d10ba`（宽屏三列）→ 自动合并成功
2. `cherry-pick ab377e8`（未插卡兜底）→ **2 处冲突，手工融合**：
   - `archiveStart()` 的 SD 检查改用 `ensureSD()`（先试重挂载）
   - `checkAndArchive()` 融合两版：**非阻塞 `archiveStart`** + **没卡则 `trimLogOlderThan` 兜底**

**分支重整**（保留全部历史，仅改名归档，不删任何提交）：
```
main                    4fd6843  ← 2.1.1 release
archive/main-pre-merge  9eaf2a2  ← 旧 main（含 5 个误提的 harness 提交，留档）
archive/test-ab-sleep   f894e49  ← 测试分支（留档）
feat/abs-humidity / mobile-mode-rename / web-logo / wide-layout ← 原始分支保留
```

**上机验收（全部通过）**：
| 项 | 结果 |
|---|---|
| 编译 | ✅ 1300015 B（7%） |
| 启动上线 | ✅ 16 秒 |
| **13 个端点** | ✅ 全 200（含 `/manifest.webmanifest`、`/apple-touch-icon.png`、`/icon-192/512.png`） |
| harness 测试端点 | ✅ `/abtest`、`/abtest.csv` **已移除** |
| **采样网格对齐** | ✅ 8/8 严格落在 `:00/:30`，间隔 30 秒 |
| 宽屏布局 | ✅ `1000px` 媒体查询 + `grid-template-columns` |
| cfgdbg 手动开关 | ✅ `?on=600` / `?clear=1` 均生效 |
| 页头 logo | ✅ 内联 SVG |
| 低电三档 / 模式 / 间隔 | ✅ 3.735/3.701/3.522 · 移动档 · 30s |

**结论**：2.1.1 功能收尾完成，`main` 为验收通过的 release（`PHT_2_X` 保持**私有**）。

> ⚠️ **踩坑提醒**：在 PowerShell 里读这些带中文的 md 时，**必须显式指定 `-Encoding UTF8`**，
> 否则控制台会显示成乱码（`浜屽崄` 之类），容易被误判为"文件损坏"。文件本身没问题。

---
## 二十三、v2.2 引脚迁移 + BQ24074 电源路径排障（2026-10-02 ~ 10-03）

### 二十三-1 引脚全线迁移（10-02）

v2.2 板引脚整表重排，固件侧一次性迁移 14 个引脚常量：

```
LCD   : CS=IO40  DC=IO41  RES=IO42  SDI=IO2  SCK=IO1
SD    : SCK=IO5  MISO=IO4  MOSI=IO6  CS=IO7
I2C   : SDA=IO47  SCL=IO48
BQ24074: CE=IO13  CHG=IO9  PGOOD=IO10  EN1=IO11  EN2=IO12
TPS2117: PR1=IO18（新增）
ISET  : IO18 → IO17（把 18 让给 PR1）
按钮  : IO21
```

**SPI 主机重新分配**：原 SD 走 HSPI、屏走 FSPI；v2.2 的 SD 引脚(IO5/4/6/7)恰好是
**HSPI 的原生脚**，故改为 **SD 走 HSPI、屏走默认 SPI(FSPI)**（S3 的 SPI 都支持 GPIO 矩阵，纯实现选择）。

**INA226 → INA230**：驱动文件改名 `ina226.h` → `ina230.h`（含 `Ina226*` → `Ina230*` 类型名），
全项目标识统一共 141 处。**身份校验收紧为"只认 INA230"**：手册无 FEh 项、FFh 未给值，
**首板实测 `MANU=0x0000 DIE=0x0000` 就是它的正常身份**，仅全 `0xFFFF`（总线浮空）判离线。

### 二十三-2 走错的路（**教训台账**，9 处）

本节的价值不在"做对了什么"，而在"**怎么走偏的**"。三类模式反复出现：

**模式 A：用"看起来合理"代替"验证过"**

| # | 弯路 | 用户怎么纠正的 |
|---|---|---|
| 1 | 写 `if (manu==0 && die==0) return false`（"全 0 视为无应答"）—— 而 **INA230 恰好读全 0** → 又会让低电保护全废 | 我自查时发现，属于同一类错误重犯 |
| 2 | `checkIdentity()` 放在 `begin()` **之前** → `_wire` 还是空指针 → **诊断信息自己坏了**，日志误报"无应答" | 日志里"无应答"和"电压 3.84V 正常"自相矛盾，被我察觉 |
| 3 | 断言"**ESP32 深睡 = 黑屏**" | ✅ **用户反驳**：ST7305 是普通反射 LCD、需持续供电；若只是深睡则屏应保持最后一帧。**推断超出证据** |

**模式 B：拿局部信息推断全局**

| # | 弯路 | 用户怎么纠正的 |
|---|---|---|
| 4 | 说 `feat/light-sleep` 只缺 wide-layout 的 2 个提交 | ✅ **用户要求先审查**，才发现那几个分支是**层层叠加的一条链** |
| 5 | 错把设计文档 V2.2 章的**正确**引脚表标成"过时草稿"，标注还插进了章节中间 | ✅ **用户直接指出**"这段是对的啊，并不是草稿" |
| 6 | 把 **ILIM（输入限流）** 和 **ISET（充电电流）** 两个电流搞混，拿 ILIM 去质疑"890 mA 哪来的" | ✅ **用户反问**：没 ILIM 电阻根本不充电，TI 会设计这么暴力的芯片吗？ |

**模式 C：批量操作后不回读校验**

| # | 弯路 | 表现 |
|---|---|---|
| 7 | 批量替换 `INA226`→`INA230` 时**把说明文字也改了** → "INA226 已弃用"变成自相矛盾的"**INA230 已弃用**" | 后来自查发现，逐处修正 |
| 8 | 改名时**漏了文件名本身**（`ina226.h` 保留着被淘汰芯片的名字） | 用户提醒"它不叫 226 了" |
| 9 | 加按钮日志时用了 `%.0f` 配 `unsigned long` —— **可变参数类型不匹配**，32 位整数被当浮点解释 → 日志显示 `0ms` | 日志自己暴露的 |

### 二十三-3 BQ24074 输入限流故障（10-03，**最严重的一次**）

**现象**：插着 USB 正常运行中，**拔掉电池 → 立即黑屏**，之后插 USB 也不再启动。

**排查全程走了两个错误方向**（详见 `实现细节.md` **D29**）：
1. 先怀疑 **PR1 误切电池直供** → 用户指出：**插着电去旁路 LDO 毫无意义**，且要求加插电守卫（该加，但不是根因）
2. 再怀疑 **低电深睡** → 用户用**屏幕特性**反驳（见上方 #3）

**最终靠用户的三条实测证据定位**：
```
· 3.3V 轨一直有电      → 排除"3.3V 掉到 0"
· EN1/EN2 启动后从未拉高 → 确立：输入限流恒为 (0,0)=USB100=100mA
· 拔电池瞬间 PGOOD 无脉冲 → 排除 PR1/PGOOD 误动作
```

**根因**：输入限流 100 mA，而 CE 低（允许充电）时移动档要 890 mA；
系统自身 WiFi 峰值 300~500 mA 都不够，何况再被充电抢。
**有电池时靠电池补峰值；拔掉电池就塌 → BROWNOUT 循环。**

**修法**：启动最早阶段 `EN1`=高（**USB500=500mA**）+ `CE`=高（**锁死禁充**）。
**修复后同样拔电池 → 屏幕不掉电、设备继续运行** ✅

**根因确认方法本身值得记**：
```
不是靠读代码推断，而是靠"3.3V 是否有电 / EN1EN2 是否拉高 / PGOOD 是否有脉冲"
这三条**可测量的正交证据**，一步把范围从"软件或硬件"收窄到"输入限流不足"。
```

### 二十三-4 顺带修掉的两个真 bug（与本次根因无关）

| # | bug | 修法 |
|---|---|---|
| **1** | **深睡唤醒源写死 `GPIO_NUM_2`** —— v2.2 引脚迁移后 PGOOD 已改到 **IO10**，`enterDeepSleepIfNeeded()` 里这行没跟着改 → **设备一进深睡就监听空脚，永远醒不过来** | 改用 `(gpio_num_t)PIN_PGOOD`。（浅睡那处用的是宏，所以是对的） |
| **2** | **低电深睡缺"电池不在"守卫** —— 拔电池后 INA230 读 **0V**（芯片由 3.3V 轨供电，`inaOK` 仍 true，**不会**变 NaN）→ `0<3.5V` → 直接深睡 | 三重守卫：有外接电源不睡 / 读数 <0.5V 不睡 / **连续 3 次**确认才睡 |
| **3** | **PR1 无插电守卫** | 外接电源在位**绝不**切电池直供 + 60 秒上电宽限期 |

### 二十三-5 方法论小结（写给以后的自己）

```
① 先测量，再推断。            —— 三条正交实测 > 十段代码分析
② 局部信息不足以推全局。       —— 看分支先看 merge-base 与拓扑
③ 批量替换后必须回读校验。     —— 尤其"XX 已弃用"这类说明文字
④ 设计前先读全项目已有文档。   —— 设计文档里早就写好的策略，别再自己发明
⑤ 用户的物理直觉往往比我的推断准 —— 这一轮 9 处弯路，8 处是用户拽回来的
```

---

## 二十五、KICKPI K3B 服务器上线（2026-10-03 夜间）

> 本节跨了**设备端**与**服务器端**两块。技术细节见 [`实现细节.md`](实现细节.md) 的 D29/D30/D31
> 与仓库外的 `docs/PHT服务器部署记录.md`（8 章，含 6 个坑）。

### 二十五-1 设备端：v2.2 电源路径收尾（承接第二十三节）

- **2026-10-03** `ea8290b` **USB 枚举检测实装** —— 读 USB-Serial-JTAG 的 **SOF 帧号寄存器**
  （`0x60038000+0x24`，低 11 位）观察是否自增：主机每 1 ms 发 SOF → 计数在动 = 真主机，
  静止 = 充电器。**实测插电脑 `1033→1284`（250 ms 内 +251，精确吻合）**，插充电器恒 `0`。
- **2026-10-03** `a2a72bb` **修一个隐蔽的编译期 bug** ——
  `applyChargeStrategy()` 里误用 `#if (PWR_SAFE_START && !usbAllowCharge)`，
  而 `usbAllowCharge` 是**运行期变量**，预处理器当 0 → 条件恒真 →
  该函数永远走"CE 拉高 + return"，**把枚举判定拉低的 CE 又拉回去**。
  症状极具迷惑性：`/status` 显示 `allowCharge=True` 但 `chgEnabled=False`。
  改为运行期 `if`，并扫描全项目确认无同类误用。
- **2026-10-03** `94ef0cb` **USB500 充电实验定论：可以充** ——
  实测 **+425 mA 稳定**、电池 3.59→3.64 V 持续爬升、18 点无复位。
  ⛔ **重要教训**：早先曾测得 `-1.0 mA` 并据此写死 `usbChargingViable=false`，
  但那次测量是在 **TS 脚还是 2 kΩ（芯片判"过热"停充）** 期间做的 ——
  **测到的是 TS 故障，不是"USB500 不够"。测量条件有已知故障时，数据不能当结论。**
- **2026-10-03** `64760ff` **冷启动/热启动分流实装**（阈值 3.6→3.5 V）——
  读电压时机从 **23.9 s（带载 3.49 V）提前到 0.6 s（空载 3.81 V）**，判据才准。
- **2026-10-03** `333e38b` **定位并归档 TS 脚硬件坑** ——
  图纸把 BQ24074 的 TS 画成 **2 kΩ**（应接 10 kΩ NTC，或不测温用 10 kΩ 固定电阻）。
  芯片以 **75 µA** 恒流灌 TS，`VTS=75µA×R`；`VHOT=300 mV` / `VCOLD=2100 mV`，越界即判温度异常
  → **直接停充且无任何报错**。2 kΩ → 150 mV < 300 mV → 全程判"过热"拒绝充电，
  表现为"换芯片无效 / 换电池无效 / CE-ISET-EN 任意组合都无效"的假象。换 12 kΩ → 900 mV 修复。
- **2026-10-03** `5a70108` **启动流程重排：24.0 s → 8.6 s** ——
  四阶段新序（保命 → 亮屏 → 采集就绪 → 联网），`delay(1000)`→`500`。
- **2026-10-03** `d063f47` **用户裁定项** —— 校准硬底线 `CAL_FLOOR_V` 3.00→**3.20 V**
  （3.0 V 太贴地，放电负载下会把电池压到**保护板切断**，下次开机体验极差）；
  冷启动阈值 3.6→3.5 V；**NTP 改每日 02:00 定期重同步**（一年不重启也不会漂）。
- **2026-10-03** `36a6643` **WiFi 两个真 bug** ——
  A) 扫不到已保存热点仍硬连 → 白等 10 s；
  B) **DHCP 学习成果只写进 `wifiCfg`（独立拷贝）未回写 `wifiList`** → 落盘永远空值
  → **每次开机无限重学**（用户："谁家网关天天变啊"）。
- **2026-10-03** `a0165b1`/`D31` **INA230 实测定论** ——
  **AVG 恒锁 128 改不了**（不经库直写 CONFIG 八档全试，回读恒 `0x4927`）；
  **CT 字段写入正常**，且 **CT 才是降噪关键**（140 µs→8244 µs，电流 σ 从 1.67 mA 降到 0）；
  标定所用 `CT_8244US` 已是最优。**这不是新 bug** —— 2026-09-15 已踩过，`calInaBegin()` 的
  逐档探测正是为此而写。

### 二十五-2 服务器端：KICKPI K3B 上线（今晚）

**背景**：早前买的小板（RK3562 / 2 GB / 16 GB eMMC）用作 PHT 数据服务器。

- **2026-10-03** 用 Rufus 烧 Armbian 到 SD 卡 → SD 启动成功。
  但发现板子**默认从 eMMC 启动**（eMMC 里是原厂 Android）。
- **2026-10-03** 用 **`armbian-install` 的非交互 API** 把系统装进 eMMC（43 秒）：
  ```
  armbian-install --api detect
  armbian-install --api plan --target /dev/mmcblk1 --boot emmc --fs ext4
  armbian-install --target /dev/mmcblk1 --boot emmc --fs ext4 --yes
  ```
  **不碰 TUI**（从串口脚本驱动 TUI 曾把会话弄挂）。
- **2026-10-03** 拔 SD 卡 → **eMMC 独立启动验证通过**。
- **2026-10-03** 预配置：主机名 `pht-server`、时区 `Asia/Shanghai`、**静态 IP `192.168.1.100`**、
  SSH 密钥免密、关内核自动升级、注释掉 `demo-dsi-panel` overlay。
- **2026-10-03** 部署 `server/` 到 `/opt/pht/server`，建 venv 装依赖，
  装 `pht-server.service` 并 `enable --now`。**全链路验证通过**
  （health / 网页 / POST 样本 / 设备列表），服务内存占用 **34 MB**。
- **2026-10-03** `99f0108` **API Token 加固** ——
  `POST /api/v1/samples` 校验 `X-PHT-Token`（`hmac.compare_digest` 防时序侧信道）+
  **按 IP 滑动窗口限速**（60 s / 120 次，超出 429 + `Retry-After`）；只读接口保持免 token。
  **实测**：无/错 token → 401，对 token → 200，连发 130 次 → 117×200 + 13×429。

### 二十五-3 今晚踩的坑（**教训，全部已归档**）

| # | 坑 | 说明 |
|---|---|---|
| 1 | ⛔ **K3B 不能用 `systemctl reboot`** | 软重启后**彻底起不来**（关机日志正常，之后串口全静默）；踩了两次。**必须硬断电重启** |
| 2 | **静态 IP 被 netplan 通配配置抢走** | Armbian 默认 `10-dhcp-all-interfaces.yaml` 生成 `[Match] Name=e*`；systemd 257 日志明示 *potentially unpredictable interface name*，并**选用它而非更精确的 `Name=eth0`** → 移走该文件解决 |
| 3 | **`panfrost`（Mali GPU）触发内核 MCE** | `rockchip_pd_power_off` 时 abort；非致命但刷屏。**拉黑解决**（服务器不需要 GPU） |
| 4 | **无可用 WiFi** | 天线与设备树节点都在，但 **SDIO 设备不应答**（400k→300k→200k→100k 后放弃），且内核无线模块列表里**没有对应驱动** → 只能有线 |
| 5 | **PowerShell here-string 把 `$M` 提前展开** | 导致给 eMMC 的预配置**写到了 SD 自己身上**（hostname 与 netplan 都写错位置）。教训：远程批量改文件**用 base64 传脚本** |
| 6 | **`EnvironmentFile` 格式错误** | 必须 `KEY=value`；写成裸 token 会被 systemd **静默忽略整个文件** → 进程无该变量 → **鉴权形同虚设**（无 token 也返回 200）。诊断用 `/proc/$PID/environ` |

**恢复过程**：坑 1 把 eMMC 搞成砖后，**插回 SD 卡启动救援系统**，
挂载 eMMC 检查 `/boot`（完好）→ 重刷 eMMC 引导加载器 → 硬上电恢复。
**SD 卡本身完好无损**，可作为长期救援盘。

### 二十五-4 明确的流程门槛（用户 2026-10-03 强调）

> ⛔ **不急于把设备暴露到公网。**
> - **"局域网测好"** = **ESP32 与服务器联动联调跑通并验证无问题**
>   —— **不是"服务器自己能访问"就算数**；
> - 该门槛达成前 **不开穿透**（已选定 **Sakura Frp**，暂不安装）；
> - **OTA 同理放在穿透之后**（不借 HTTP 通道提前上）。

**已定的验收清单**（详见临时台账 `PHT_FOLLOWUP_PLAN.md` 第 7.1 节）：
持续推送 / 设备可见 / 序列可查 / **断网补传不丢不重** / **失败不阻塞采样** /
状态切换不崩 / 连续跑数小时无异常

### 二十五-5 SD 卡去向

SD 卡已**格式化并归还给 ESP32 气象站**（原用途：长期数据归档）。
服务器现在跑在 eMMC 上，不再依赖 SD。

---
## 二十四、本文件维护规则备忘

- 目录顺序：**历史沿革 → 变更记录 → 各批完成日志 → 当时待办 → 残留清点 → 留档**；新条目往后加。
- **Git 分支约定（用户 2026-09-29 定）**：**测试性 / 实验性改动一律先开分支**（如 `test/ab-sleep`），
  在分支上改、编译、上机验证；**测完并回 `main`**，确认无用再删分支。正式功能改动与文档整理可直接在 `main`。
  > 背景：2026-09-29 的"省电 A/B 实验 harness"（`ac419ec`…`16e3c76` 共 5 个提交）**误提在 main 上**——
  > 它是临时测试代码、实验后要删，本应在分支上做。用户决定**这次不返工**，从下次起按此约定执行。
- **推送策略**：本地领先远端较多时**不自动推**，等用户确认后再 `git push`（用户网络不稳，且要控制推送范围）。
- 变更记录里提到的技术点，若已沉淀成规范做法，请在 [`实现细节.md`](实现细节.md) 对应 `D` 节留一句交叉引用。
- 文档体检：`node tools/check-md.mjs`（本文件也在扫描范围内，注意表格里的竖线要写成 `\\|` 转义形式）。
