StellaRigel/ESP32-Pressure-Temperature-Humidity-Recorder/PHT_2_X.ino

/**
 * PHT_2_X —— ESP32-S3 气压温湿度记录器
 *   = Pressure1_3 主逻辑  +  横屏 UI（ST7305_Landscape_UI）合并版
 *
 *   - BMP580 + SHT30 + DS3231 + SD卡
 *   - 屏幕：ST7305 2.13" 横屏 UI（ui_display.h + 中文点阵 ui_cjk.h，无底图）
 *       顶栏： 时间 · MOV/FIX模式 · 充电⚡CC/CV 或 电量% · 电池 · WiFi
 *       数据： 温度°C / 湿度% / 气压hPa
 *   - 设备模式 固定(0)/移动(1)：存 NVS，顶栏显 FIX/MOV，网页 /mode 可切
 *   - Flash 只存 26 小时，每天 02:00 自动归档
 *   - 手动归档加 _manual 后缀，不混淆
 *   - Canvas 平滑曲线
 *   - 网页日志控制台（带开关）
 *   - 采样对齐 :00/:30；插电每次采样刷屏，电池只在整分钟刷屏（省电）
 *   - 日平均引擎：30天滑动窗口（PSRAM）
 *   - 今日气压距平曲线 + 24h趋势；今日极值栏：温/湿/压 最高最低
 *   - AP 按需开启：连上WiFi自动关AP省电降热
 */

#include <Wire.h>
#include <Adafruit_BMP5xx.h>
#include <Adafruit_SHT31.h>
#include <RTClib.h>
#include <LittleFS.h>
#include <SD.h>
#include <WiFi.h>
#include <WiFiUdp.h>      // → V2.1.1-b 标定负载：向网关连发 UDP（纯发送就有射频功耗）
#include "apps/ping/ping_sock.h"   // ← 内置 esp_ping（ICMP）：静态IP 查重用（core 3.3.11 实测可编译链接）
#include <WebServer.h>
#include <HTTPClient.h>   // v2.2 推送：向服务器 POST 样本（只用在这个功能的独立任务里）
#include <time.h>
#include <sys/time.h>
#include <sys/time.h>
#include <SPI.h>
#include <stdarg.h>
#include <ArduinoJson.h>   // ← 安装：搜索 "ArduinoJson by Benoit Blanchon"
#include <Update.h>        // ← 内置，OTA 用的
#include "ui_display.h"   // ← ST7305 横屏 UI 模块（底图已删，中文标签字模 ui_cjk.h）
#include "esp_sleep.h"    // ← deep-sleep / ext0 唤醒
#include <Preferences.h>   // ← NVS，存设备模式(固定/移动)
// ===== BLE 整体搁置（V2.1，设计文档附录 C）=====
//   ENABLE_BLE=1 才编入蓝牙组件，默认 0 不编译（省 flash/RAM/功耗，且消除 NimBLE 生命周期风险）。
//   代码保留不删——远期做 APP 时把 ENABLE_BLE 改为 1 即复活（届时先复核设计文档附录 B.3 的 deinit 铁律）。
#define ENABLE_BLE 0
#if ENABLE_BLE
#include <BLEDevice.h>   // ← 内置 BLE（Bluedroid，零外部依赖）
#include <BLEServer.h>
#include <BLEUtils.h>
#include <BLE2902.h>
#endif
#include "ina230.h"        // ← INA230 电池监测（v2.2：取代 INA226）
#include "pht_crypto.h"     // ← 自带 SHA-256/HMAC-SHA256（设备一机一密签名用）

// ===== USB 枚举检测（v2.2 · BQ24074 EN1/EN2 三档切换）=====
//   机制：USB 枚举成功 → EN1/EN2=(0,1) USB500 档；失败 → (1,0) ISET 档。
//   ⚠️ **靠 USB 供电刷机的那台测试机必须置 0**：它依赖 USB 供电，一旦按枚举结果切档
//      可能掉电/影响刷机；其余设备正常识别并切换。
//   用法：默认 0（安全）。启用请改 1 后编译。
//   依据：硬件核对清单 第五节清单 3（待实装）。
// ===== USB 枚举检测（**已实装** 2026-10-03）=====
//   目的：区分"插在 USB 主机（电脑）"还是"插在充电器"，据此选 BQ24074 输入限流档位。
//   原理：USB 主机每 1ms 发一个 **SOF 帧**；ESP32-S3 的 USB-Serial-JTAG 控制器
//         维护一个 **SOF 帧号计数器**（自增，11 位，绕回 2048）→ 计数在变 = 对端是活的主机。
//   ⛔ **不用 `(bool)Serial`** —— 实测它反映的是主机的 DTR，不是数据流，充电器上可能是 false。
//   寄存器（esp32s3-libs 3.3.9-cn 头文件核对）：
//     DR_REG_USB_SERIAL_JTAG_BASE = 0x60038000
//     +0x24 USB_SERIAL_JTAG_FRAM_NUM_REG（低 11 位 = SOF_FRAME_INDEX）
#define USB_JTAG_BASE        0x60038000UL
#define USB_JTAG_FRAM_NUM    (USB_JTAG_BASE + 0x24UL)
#define USB_JTAG_INT_CLR     (USB_JTAG_BASE + 0x14UL)
#define USB_SOF_FRAME_MASK   0x7FFUL          // 帧号 11 位

//   判定窗口：上电后这段时间内观察帧号变化；取 3 次、每次间隔 220ms
#define ENUM_WINDOW_MS  3000UL

#define ENUM_UNKNOWN 0
#define ENUM_IS_HOST 1
#define ENUM_IS_CHARGER 2

// ===== 【阶段1·安全启动】2026-10-03 =====
//   故障：插着 USB 拔掉电池 → 设备反复 BROWNOUT 起不来。
//   实测证据（用户示波器/万用表）：
//     · 3.3V 轨**一直有电** → 排除"3.3V 掉到 0"
//     · EN1/EN2 启动后**仍无一拉高** → 输入限流恒为 (0,0)=USB100=100mA
//     · 拔电池瞬间 PGOOD **无高脉冲** → 排除 PR1/PGOOD 误动作
//   结论：**100mA 输入限流撑不住系统启动峰值**（WiFi 初始化瞬时 300~500mA）。
//         之前"能启动"是靠电池补峰值；一旦拔掉电池就塌。
//   本阶段措施（最小改动，先定论根因）：
//     ① CE 拉高 = **禁止充电**（不跟系统抢输入电流）
//     ② EN1 抬高 → (EN2,EN1)=(0,1) = **USB500 = 500mA**（USB 规范安全值）
//     ③ PR1 保持低（LDO）
//   ⚠️ 设为 0 可整体回退到"老逻辑"（允许充电 + 不驱动 EN1/EN2）
#define PWR_SAFE_START 1
#include "web_icon.h"      // ← iOS 主屏图标 PNG 字节数组（apple-touch-icon 必须 PNG）

// 电源状态结构体（放在文件顶部：Arduino 会给所有函数生成原型到顶部，
// 若自定义类型定义太靠后会报 “does not name a type” 🍄）
typedef struct {
  bool  powered;     // 是否外部供电 (PGOOD 低)
  bool  charging;    // 是否充电中 (CHG 低)
  bool  onBattery;   // 是否电池供电
  float battVolt;    // 电池电压 (V)；INA230 离线时为 NAN（未知）
  uint8_t battPct;   // 估算电量 (0-100)；INA230 离线时无效(0)
  // ---- INA230 电池监测（V2.1，唯一电压来源；原 IO9 分压方案已删除）----
  bool  inaOK;             // INA230 是否在线（false = 电压/电量均不可用）
  float battCurrent_mA;    // 充放电电流（充电为正、放电为负）
  float battPower_mW;      // 电池端功率
  bool  cvZone;            // 是否进入 CV 区（接近充满）
} PowerState;

// 最近一次读到的电源状态（屏幕与逻辑共用，每次 readAndLog() 里更新）
PowerState g_power = {};


SPIClass sdSPI(HSPI);          // v2.2：SD 走 HSPI（IO5/4/6/7 正是 HSPI 的原生引脚）；屏走默认 SPI(FSPI)

// ==================== Web 日志系统 ====================
#define WEB_LOG_MAX 200
#define WEB_LOG_LEN 256
// 日志环形缓冲 = 200×256 = 51200 字节！放内部 DRAM 会把 dram0_0_seg 撑爆，
//   故搬到 PSRAM（ps_malloc）。类型为「指向 WEB_LOG_LEN 字节数组的指针」，
//   索引写法 webLogBuffer[i] / webLogBuffer[i][j] 与原来完全一致。
char (*webLogBuffer)[WEB_LOG_LEN] = nullptr;
volatile int webLogHead = 0;
volatile int webLogCount = 0;
bool webLoggingEnabled = true;   // ← 开关

// ===== 配网调试日志（写 Flash）=====
//   动机（2026-09-13）：移动+电池走蓝牙时设备没有 HTTP，配网出问题看不到内部状态。
//   做法：一旦触发配网（蓝牙保存 / 点已保存网络 / 长按 IO9）→ 此后所有 webLog 追加到 /cfgdbg.log，
//         按 16KB 滚动；10 分钟后自动停写（省 Flash）。**重启/断电都不丢**；
//         插上电后用浏览器打开 http://<设备IP>/cfgdbg 就能看到全过程（也可电脑远程直接读）。
const char* CFG_DBG_PATH = "/cfgdbg.log";
const size_t CFG_DBG_MAX = 16384;
bool   cfgDbgOn    = false;      // 本次是否在写
bool   cfgDbgBoot  = false;      // 本次开机是否已做过「是否续写」判断
unsigned long cfgDbgUntil = 0;
bool   fsReadyForDbg = false;    // LittleFS 挂载完成（懒判：totalBytes()==0 即未挂载）
UiDisplay uiDisplay;   // 提前定义：updateWireless() 里状态一变就要刷顶栏图标


// 复位原因（写进 Flash 日志：能区分「崩了」和「电压跌落」——这一步很关键）
const char* resetReasonStr() {
  switch (esp_reset_reason()) {
    case ESP_RST_POWERON:   return "上电/复位键 (POWERON)";
    case ESP_RST_EXT:       return "外部引脚复位 (EXT)";
    case ESP_RST_SW:        return "软件重启 (SW，含 OTA/ESP.restart)";
    case ESP_RST_PANIC:     return "❌ 崩溃 PANIC（看串口 backtrace）";
    case ESP_RST_INT_WDT:   return "❌ 中断看门狗 INT_WDT";
    case ESP_RST_TASK_WDT:  return "❌ 任务看门狗 TASK_WDT（长时间不喂狗）";
    case ESP_RST_WDT:       return "❌ 其它看门狗";
    case ESP_RST_DEEPSLEEP: return "深睡唤醒 (DEEPSLEEP)";
    case ESP_RST_BROWNOUT:  return "❌ 电压跌落 BROWN-OUT（供电不足！）";
    case ESP_RST_SDIO:      return "SDIO 复位";
    default:                return "未知";
  }
}

void cfgDbgNote(const char* s) {
  File f = LittleFS.open(CFG_DBG_PATH, "a");
  if (!f) return;
  if (f.size() > CFG_DBG_MAX) { f.close(); LittleFS.remove(CFG_DBG_PATH);
    f = LittleFS.open(CFG_DBG_PATH, "w"); if (!f) return; f.print("…（超 16KB，已截断）\n"); }
  f.print(s);
  f.close();
}

// 由 webLog() 调用：会话期间把每条日志落盘
void cfgDbgWrite(const char* s) {
  if (!fsReadyForDbg) return;   // 挂载成功才置位，见 initFS()
  if (!cfgDbgOn) {
    if (cfgDbgBoot) return;                 // 本次开机已判断过（清过就不再续写）
    cfgDbgBoot = true;
    if (!LittleFS.exists(CFG_DBG_PATH)) return;
    cfgDbgOn = true;                        // 文件还在 → 上次调试没读完，续写（含重启后）
    cfgDbgUntil = millis() + 10UL * 60UL * 1000UL;
    cfgDbgNote("\n===== 设备重启，继续记录 =====\n");
    { time_t rt = time(nullptr); char rts[24] = ""; if (rt > 1000000000) { struct tm rtm; localtime_r(&rt, &rtm); strftime(rts, sizeof(rts), "%H:%M:%S", &rtm); }
      cfgDbgNote((String("复位原因: ") + resetReasonStr() + (rts[0] ? (String(" @ ") + rts) : String("")) + "\n").c_str()); }
  }
  if ((int32_t)(millis() - cfgDbgUntil) >= 0) { cfgDbgOn = false; return; }
  cfgDbgNote(s);
}

// 开启一次配网调试日志（每次配网重开一份，便于按时间点对号入座）
void cfgDbgBegin(const char* why) {
  if (!fsReadyForDbg) return;   // 挂载成功才置位，见 initFS()
  LittleFS.remove(CFG_DBG_PATH);
  File f = LittleFS.open(CFG_DBG_PATH, "w");
  if (f) { f.printf("===== 配网调试日志 @ %s =====\n", why); f.close(); }
  cfgDbgOn = true; cfgDbgBoot = true;
  cfgDbgUntil = millis() + 10UL * 60UL * 1000UL;
  webLogln("📝 [调试] 配网日志已写 Flash：%s（浏览器看 http://设备IP/cfgdbg；10 分钟后自动停写）", CFG_DBG_PATH);
}

static void webLog(const char* fmt, ...) {
  char buf[WEB_LOG_LEN];
  va_list args;
  va_start(args, fmt);
  vsnprintf(buf, sizeof(buf), fmt, args);
  va_end(args);
  Serial.print(buf);
  cfgDbgWrite(buf);                 // 配网调试期间把每条日志落盘（未开启时几乎零开销）
  if (!webLoggingEnabled) return;
  // 首次调用时把环形缓冲分配到 PSRAM（51KB，经不起占内部 DRAM）
  if (!webLogBuffer) {
    webLogBuffer = (char (*)[WEB_LOG_LEN])ps_malloc((size_t)WEB_LOG_MAX * WEB_LOG_LEN);
    if (!webLogBuffer) return;   // PSRAM 也不够就只能丢日志，绝不再吃 DRAM
  }
  strncpy(webLogBuffer[webLogHead], buf, WEB_LOG_LEN - 1);
  webLogBuffer[webLogHead][WEB_LOG_LEN - 1] = '\0';
  webLogHead = (webLogHead + 1) % WEB_LOG_MAX;
  if (webLogCount < WEB_LOG_MAX) webLogCount++;
}

static void webLogln(const char* fmt, ...) {
  char buf[WEB_LOG_LEN];
  va_list args;
  va_start(args, fmt);
  vsnprintf(buf, sizeof(buf), fmt, args);
  va_end(args);
  String s = String(buf) + "\n";
  webLog("%s", s.c_str());
}
// =====================================================

// ==================== WiFi 配置 ====================
const char* WIFI_SSID     = "";            // 出厂默认空：运行时由用户配网后写入（勿硬编码个人 SSID）
// WiFi 密码不硬编码（凭据只存 NVS / 网页配置）
const char* AP_SSID       = "Weather_Station_Pro";
const char* AP_PASSWORD   = "12345678";    // ⚠️ 公开默认值，首次使用请务必修改
const char* AP_IP_STR     = "192.168.5.1";   // 必须与 startAP() 里的 local_IP 保持一致

const IPAddress STA_IP(192, 168, 1, 97);    // 仅作 /wifi 页占位示例；实际地址由「末段 + 学习到的网关/掩码」算出
const IPAddress STA_GW(192, 168, 1, 1);    // 同上
const IPAddress STA_MASK(255, 255, 255, 0); // 学习失败时的兑底掩码
// ===================================================

// ==================== WiFi 配置管理（网页可改，支持多组自动选最强）====================
//  存储：/wifi.json = {"list":[{"ssid","pass","useIP","ipLast","gw","mask","dns"}, ...]}
//  旧格式（"ip"/"gw"/"mask" 整段）开机自动升级：取旧 ip 的末段当 ipLast，其余保留，老配置不丢。
//  静态 IP 策略（V2.1）：用户只填「末段」（默认 200）；网关/掩码/DNS 由设备 **DHCP 连一次后自己学习**
//    并落盘（与手动填写同构）。开机流程：先 DHCP 连上 → 学 gw/mask/dns 落盘 → ping 候选末段查重
//    （被占则 +1，最多 5 次）→ 配静态重连；5 次都被占或静态连不上 → **退回 DHCP** 并标出来。
//  连接策略：启动/重连时扫一遍，**只在已保存的网络里挑 RSSI 最大的那组**。
#define WIFI_MAX_SAVED 5
struct WiFiConfig {
  char ssid[32] = "";
  char password[64] = "";
  bool useIP = false;          // true = 静态 IP（只填末段）；false = 自动 (DHCP)
  uint8_t ipLast = 0;          // 静态 IP 末段；0 = 未填（连接时按 200 处理）
  IPAddress gw, mask, dns;     // 网关 / 掩码 / DNS（DHCP 学习或手动填；全 0 = 未知）
  // 由「网关 & 掩码」的网段基址 + 末段拼出静态地址（未学习到网关时返回 0.0.0.0）
  //   ⚠ 必须按字节(octet)构造：ESP32 的 IPAddress 内部是小端，`base | ipLast` 会把末段错写到第一字节！
  IPAddress staticIp() const {
    if ((uint32_t)gw == 0 || (uint32_t)mask == 0) return IPAddress((uint32_t)0);
    IPAddress base((uint32_t)gw & (uint32_t)mask);
    return IPAddress(base[0], base[1], base[2], (uint8_t)ipLast);
  }
};
WiFiConfig wifiCfg;                        // 当前生效（正在连）的那组
WiFiConfig wifiList[WIFI_MAX_SAVED];       // 已保存的多组
int  wifiCount = 0;                        // 有效组数
int  wifiRssi  = 0;                        // 选中那组的信号强度(dBm)，0 = 未知

// 小文件复制（当前只给配置备份用）
void copyFile(const char* src, const char* dst) {
  File a = LittleFS.open(src, "r");
  if (!a) return;
  File b = LittleFS.open(dst, "w");
  if (!b) { a.close(); return; }
  uint8_t buf[128]; size_t n;
  while ((n = a.read(buf, sizeof(buf))) > 0) b.write(buf, n);
  a.close(); b.close();
}

//  注：JSON 解析用 lambda 写在 loadWiFiConfig() 里——.ino 的自动函数原型会把带自定义类型的
//      自由函数原型插到结构体定义之前，报 “WiFiConfig was not declared”。

void saveWiFiConfig() {
  JsonDocument doc;                             // ArduinoJson 7：动态文档，无需容量
  JsonArray list = doc["list"].to<JsonArray>();
  for (int i = 0; i < wifiCount; i++) {
    JsonObject o = list.add<JsonObject>();
    o["ssid"] = wifiList[i].ssid;
    o["pass"] = wifiList[i].password;
    o["useIP"] = wifiList[i].useIP;
    o["ipLast"] = wifiList[i].ipLast;
    o["gw"] = wifiList[i].gw.toString();
    o["mask"] = wifiList[i].mask.toString();
    o["dns"] = wifiList[i].dns.toString();
  }
  File f = LittleFS.open("/wifi.json", "w");
  if (!f) { webLogln("⚠️ WiFi 配置写入失败"); return; }
  serializeJson(doc, f);
  f.close();
}

void loadWiFiConfig() {
  wifiCount = 0;
  if (!LittleFS.exists("/wifi.json")) return;
  File f = LittleFS.open("/wifi.json", "r");
  if (!f) return;
  JsonDocument doc;
  DeserializationError err = deserializeJson(doc, f);
  f.close();
  if (err) { webLogln("⚠️ WiFi 配置解析失败，按未配置处理"); return; }
  // 一条记录的解析（lambda：避开 .ino 自动原型对自定义类型的限制）
  auto entryFrom = [](WiFiConfig& c, JsonObject o) {
    strlcpy(c.ssid, o["ssid"] | "", sizeof(c.ssid));
    // 密码键：新格式 "pass"，旧格式 "password"——两个都认（当初升级时只读 pass，把密码丢了）
    const char* pw = o["pass"] | "";
    if (!*pw) pw = o["password"] | "";
    strlcpy(c.password, pw, sizeof(c.password));
    c.useIP = o["useIP"] | false;
    // 新格式：ipLast（末段）。旧格式：整段 "ip" → 取末段当 ipLast（平滑迁移）
    c.ipLast = (uint8_t)(o["ipLast"] | 0);
    if (!c.ipLast) {
      const char* ipOld = o["ip"] | "";
      if (*ipOld) { IPAddress t; if (t.fromString(ipOld)) c.ipLast = t[3]; }
    }
    const char* gw = o["gw"] | "";      if (*gw) c.gw.fromString(gw);
    const char* mk = o["mask"] | "";    if (*mk) c.mask.fromString(mk);
    const char* dn = o["dns"] | "";     if (*dn) c.dns.fromString(dn);
  };
  JsonArray list = doc["list"].as<JsonArray>();
  bool legacy = false;
  if (!list.isNull()) {
    for (JsonObject o : list) {
      if (wifiCount >= WIFI_MAX_SAVED) break;
      if (!o["ssid"]) continue;
      entryFrom(wifiList[wifiCount], o);
      if (strlen(wifiList[wifiCount].ssid)) wifiCount++;
    }
  } else if (!doc["ssid"].isNull()) {      // 旧格式 → 升级成一组
    entryFrom(wifiList[0], doc.as<JsonObject>());
    if (strlen(wifiList[0].ssid)) { wifiCount = 1; legacy = true; }
  }
  if (wifiCount > 0) wifiCfg = wifiList[0];
  if (legacy) {
    copyFile("/wifi.json", "/wifi.old.json");   // 保险：升级前留一份原格式备份
    saveWiFiConfig();
    webLogln("⬆️ WiFi 配置已升级为多组格式（1 组，原文件备份到 /wifi.old.json）");
  }
}

// 增/改一组（同 SSID 视为覆盖）；返回下标，已满返回 -1
//  useIPMode: -1 = 不改动地址方式；0 = 自动(DHCP)；1 = 静态IP（只填末段）
//   之前用 bool，表单没带 useIP 就当成 0 → 静默把静态 IP 关掉，设备一重启就跳 DHCP（实测事故）
//  ipLast: 静态末段；0/越界 = 留空 → 用默认 200（“默认只针对留空”，已填的原样保留）
int wifiUpsert(const char* ssid, const char* pass, int useIPMode, int ipLast) {
  int idx = -1;
  for (int i = 0; i < wifiCount; i++) if (strcmp(wifiList[i].ssid, ssid) == 0) { idx = i; break; }
  bool isNew = (idx < 0);
  if (isNew) {
    if (wifiCount >= WIFI_MAX_SAVED) return -1;
    idx = wifiCount++;
    wifiList[idx].useIP = true;          // 新增组：默认静态（末段留空 → 200）
  }
  WiFiConfig& c = wifiList[idx];
  strlcpy(c.ssid, ssid, sizeof(c.ssid));
  // 密码留空 = “不改密码”（页面不回显已存密码，避免手滑把密码清掉）；新条目留空则当作开放网络
  if (pass && *pass) strlcpy(c.password, pass, sizeof(c.password));
  else if (isNew)    c.password[0] = '\0';
  if (useIPMode >= 0) {                  // 表单/工具显式提交了地址方式 → 才动它（-1 时保留原样）
    c.useIP = (useIPMode == 1);
    if (c.useIP) c.ipLast = (ipLast >= 2 && ipLast <= 254) ? (uint8_t)ipLast : 200;   // 留空 → 默认 200
  }
  saveWiFiConfig();
  wifiSyncCurrent(idx);      // ★ 刷新“当前组”wifiCfg，否则重连还在用旧凭据（曾导致存完必须按 EN 才重连）
  return idx;
}

// 配置变动后刷新“当前组”wifiCfg：优先保持已连上的那个 > 指定下标 > 第一个
// 每处都打日志——自检靠它确认“保存后当前组真的刷新了”（曾经不刷新 → 存完必须按 EN 才重连）
void wifiSyncCurrent(int preferIdx) {
  if (WiFi.status() == WL_CONNECTED) {
    String cur = WiFi.SSID();
    for (int i = 0; i < wifiCount; i++)
      if (cur == wifiList[i].ssid) { wifiCfg = wifiList[i]; webLogln("🔁 当前组已刷新 '%s'（保持已连上的）", wifiCfg.ssid); return; }
  }
  if (preferIdx >= 0 && preferIdx < wifiCount) { wifiCfg = wifiList[preferIdx]; webLogln("🔁 当前组已切到 '%s'", wifiCfg.ssid); return; }
  if (wifiCount > 0) { wifiCfg = wifiList[0]; webLogln("🔁 当前组已刷新为 '%s'", wifiCfg.ssid); return; }
  memset(&wifiCfg, 0, sizeof(wifiCfg));
  webLogln("🔁 已无保存的 WiFi，当前组清空");
}

// 已保存的 WiFi 列表 → JSON（配网页展示/删除；**不回显密码**）
String buildWifiListJson() {
  String s = "{\"count\":" + String(wifiCount) + ",\"max\":" + String(WIFI_MAX_SAVED) +
             ",\"current\":\"" + String(wifiCfg.ssid) + "\",\"list\":[";
  for (int i = 0; i < wifiCount; i++) {
    if (i) s += ",";
    s += "{\"ssid\":\"" + String(wifiList[i].ssid) + "\",\"useIP\":" +
         String(wifiList[i].useIP ? 1 : 0) + ",\"ipLast\":" + String(wifiList[i].ipLast) +
         ",\"gw\":\"" + wifiList[i].gw.toString() + "\",\"mask\":\"" + wifiList[i].mask.toString() + "\"}";
  }
  return s + "]}";
}

// 扫描附近 WiFi → JSON 数组（HTTP /wifi-scan 与蓝牙共用；saved=是否已保存；同名只留最强的）
String buildWifiScanJson() {
  int n = WiFi.scanNetworks();
  String s = "[";
  int added = 0;
  for (int i = 0; i < n; i++) {
    String ssid = WiFi.SSID(i);
    if (ssid.length() == 0) continue;
    int r = WiFi.RSSI(i);
    bool dup = false;
    for (int k = 0; k < i; k++) if (WiFi.SSID(k) == ssid && WiFi.RSSI(k) >= r) { dup = true; break; }
    if (dup) continue;
    bool saved = false;
    for (int k = 0; k < wifiCount; k++) if (ssid == wifiList[k].ssid) saved = true;
    String esc = ssid; esc.replace("\\", "\\\\"); esc.replace("\"", "\\\"");
    if (added++) s += ",";
    s += "{\"ssid\":\"" + esc + "\",\"rssi\":" + String(r) + ",\"saved\":" + (saved ? "true" : "false") + "}";
  }
  WiFi.scanDelete();
  return s + "]";
}

bool wifiRemove(const char* ssid) {
  for (int i = 0; i < wifiCount; i++) {
    if (strcmp(wifiList[i].ssid, ssid) == 0) {
      for (int k = i; k < wifiCount - 1; k++) wifiList[k] = wifiList[k + 1];
      wifiCount--;
      saveWiFiConfig();
      wifiSyncCurrent(-1);
      return true;
    }
  }
  return false;
}

// 扫描 → 在已保存的组里挑信号最强的写进 wifiCfg；返回是否挑到
//   requireInRange=true：**扫不到就返回 false，绝不硬连**（用于启动期，避免白等 10 秒）
bool wifiPickBest(bool requireInRange) {
  if (wifiCount == 0) return false;
  int n = WiFi.scanNetworks();
  int best = -1, bestR = -127;
  for (int i = 0; i < n; i++) {
    int r = WiFi.RSSI(i);
    String s = WiFi.SSID(i);
    for (int k = 0; k < wifiCount; k++)
      if (strlen(wifiList[k].ssid) && s == wifiList[k].ssid && r > bestR) { bestR = r; best = k; }
  }
  WiFi.scanDelete();
  if (best < 0) {
    if (wifiCount == 1) { wifiCfg = wifiList[0]; wifiRssi = 0; return true; }
    // ⚠️ 扫不到任何已保存热点：
    //   requireInRange=true（启动期）→ 返回 false，调用方**直接开 AP**，不再硬连（白等 10s）
    //   否则（运行期重连）→ 沿用上次的 wifiCfg 再试一次
    webLogln("⚠️ 已保存的 %d 组 WiFi 都不在扫描范围内", wifiCount);
    return false;
  }
  wifiCfg = wifiList[best];
  wifiRssi = bestR;
  webLogln("🎯 选中 '%s'（RSSI %d dBm / 共存 %d 组）", wifiCfg.ssid, wifiRssi, wifiCount);
  return true;
}

// 当前 wifiCfg（SSID+密码）的 djb2 哈希：/status 用来自检“保存后当前组是否已刷新”
uint32_t wifiCfgHash() {
  uint32_t h = 5381;
  for (const char* p = wifiCfg.ssid; *p; p++)     h = ((h << 5) + h) + (uint8_t)*p;
  h = ((h << 5) + h) + (uint8_t)'|';
  for (const char* p = wifiCfg.password; *p; p++) h = ((h << 5) + h) + (uint8_t)*p;
  return h;
}
// ===================================================

// ==================== 无线互斥状态机（V2.1：BLE 搁置） ====================
//  规格：设计文档 附录 C（V2.1 无线策略）
//    | 设备状态        | 无线        | 说明                                        |
//    | 固定(0)/插电     | WiFi STA    | 自动连已存网络；连不上 → AP 兜底               |
//    | 移动(1) + 电池   | 全关(WL_OFF) | 默认不开（史级省电）；按 IO9 按需开，超时自动关   |
//    | 无已存/连不上     | AP 热点     | IO9 按需开热点，手机连上 → 真网页配网          |
//    另：不插电绝不自动开 WiFi（否则实体 WiFi 开关无意义）；实体按钮 IO9 → 开无线。
//  注：BLE 整体搁置（ENABLE_BLE 默认 0，代码保留），仅保留 WiFi STA/AP 两条路径。
//      下面 BLE 相关代码待 #if ENABLE_BLE 包裹（待办：README 十一.5）。
#define WL_OFF  0
#define WL_WIFI 1
#define WL_BLE  2

#define PIN_WIFI_BTN  21                       // 实体按钮（v2.2：IO9 -> IO21；交互改短按）
#define BLE_DEV_NAME  "PHT_2_X"
// 前向声明：.ino 的自动函数原型在遇到 class 定义后可能失效，本段用到的后置定义全部显式声明
//   （与文件顶部 “extern uint8_t deviceMode;” 同理）
//   ⚠️ V2.1.1-b 实测：自动原型确实会漏（raw string 字面量多时会错乱）→ 标定相关函数全部显式声明
extern uint8_t deviceMode;
extern bool apEnabled;
extern unsigned long apClosedMs;
extern bool chargeForceSlow;   // V2.1.1-a：移动+插电时的「临时慢充」（定义在下方充电策略段）
// ---- V2.1.1-b 电量校准（实现见文件后半部）----
bool     calAbortPressed();
void     calScreen(const char* l1, const char* l2);
void     calScreenProgress();
void     calUdpBurst();
void     calCpuBurn(uint32_t ms);
bool     calInaBegin(bool calMode);
void     calReadIna(float& v, float& i);
void     setCalFlag(bool on);
uint8_t  getCalFlag();
void     calNowStr(char* out, size_t n);
void     calCsvHeader();
void     calCsvRow(uint32_t tLoaded, uint32_t dt);
void     calSaveTable();
void     calLoadTable();
uint8_t  calPctFromVolt(float v);
bool     calBuildTable(bool partial);
uint32_t calFullHeldMs();
// 直连工具链构建（_build/）没有 ctags 自动原型，这两条必须自己写：
//   PowerState 的定义在后面，但 applyChargeStrategy() 的调用点更靠前。
void     applyChargeStrategy(const PowerState& ps);
void     serviceBattAnchor();
// V2.1.1 低电三档跟本机表走（2026-09-29）：开机载表后刷新 battArchiveV/battStopV/battSleepV
void     updateBattThresholds();
// V2.1.1 Bug② 修复：今日统计抽成函数（实时采样与开机回灌共用）
void     feedTodaySample(uint32_t t, float tC, float h, float p);
int      backfillTodayFromLog();
bool     calStart(bool dry, String& msg);
void     calBeginDischarge();
void     calAbort(const char* why, bool tryBuild = false);
void     serviceCal();
void     serviceTopBar();   // V2.1.1-c 顶栏快通道
String   calStatusJson();
String   calReportJson();
String   calPageHtml();
// 密钥 / 推送地址配置页（2026-10-05）
String   keyPageHtml();
void     calBootCheck();
void startAP();
void stopAP();
PowerState readPowerState();
void _fallbackToRtcTime();
bool syncTimeFromNTPBlocking(unsigned long maxMs);
void ntpStart();
// 归档/缓冲相关（定义在文件后半部；enterDeepSleepIfNeeded 等早期函数会先用到）
void     archivePump();
void     checkAndArchive();
void     loadBufferFromFlash();
void serviceNtpSync();
void serviceNtpDailyCheck();
bool wifiPickBest(bool requireInRange);
// 只读数据的 JSON builder（HTTP 与 BLE 共用，定义在文件后半部）
String buildStatusJson(bool overBLE);
String buildHistoryJson(int page, int count, bool applyFilter);
String buildDailyAvgJson();
String buildAnomalyJson();
String buildTodayStatsJson();
#if ENABLE_BLE
static const char* BLE_SVC_UUID = "6e400001-b5a3-f393-e0a9-e50e24dcca9e";
static const char* BLE_RX_UUID  = "6e400002-b5a3-f393-e0a9-e50e24dcca9e";   // 手机 → 设备（请求）
static const char* BLE_TX_UUID  = "6e400003-b5a3-f393-e0a9-e50e24dcca9e";   // 设备 → 手机（响应）
#endif

uint8_t  curWireless = WL_OFF;      // 当前在用的无线
bool     bleOn = false;             // BLE 协议栈已 init 并在广播（ENABLE_BLE=0 时恒为 false，/status 仍回报）
bool     bleLink = false;           // 有手机连着（同上）
bool     wifiForced = false;        // 实体按钮强制开 WiFi
unsigned long wifiRecoverUntil = 0;
time_t   nextSampleTime   = 0;      // 下一个采样点的墙上时间（采样与浅睡共用锚点；置 0 = 待重算）
// ===== NTP 重试（2026-10-02）=====
//   背景：syncTimeFromNTP() 原先**只在 setup() 调一次**、且窗口只有 10 秒；
//        若开机那 10 秒恰好没外网，整个会话内再也不会重试（只能靠 DS3231 兜底）。
//   策略：**只在「插电 + WiFi 已连 + 距上次 NTP 成功 ≥ 3 天」时**才试一次，且每次开机最多试一次。
//   ⛔ 绝不出现"电池供电还去连 WiFi 同步 NTP"的逻辑（用户明确要求）。
time_t   ntpLastOkAt      = 0;      // 上次 NTP 成功的时间（0 = 从未成功过）
// NTP 定期重同步（2026-10-03 改）：**每日 02:00 检查一次**，超过 NTP_RESYNC_DAYS 天没成功就同步。
//   理由：RTC(DS3231) 与片上时钟都会漂；本设备理想环境下**一年都可能不重启**，
//         只靠"开机时同步一次"会让时间越走越歪。
//   原 ntpTriedThisBoot（每次开机只重试一次）已由每日定时取代。
int      ntpDailyLastDay  = -1;      // 上次做每日检查的"日"（防止同日重复）
bool     ntpDailyPending  = false;   // RTC 掉电且当前无网 → 挂起，等有网再补一次
const long NTP_RESYNC_DAYS = 3L;     // 超过这么多天没成功 → 重新同步
// 【兜底】长按 IO9 强开热点模式：到此刻为止拒绝任何 STA 重连（0 = 正常）
int      wlForce = 0;               // 联调/调试：0=自动 1=强制WiFi 2=强制蓝牙（/wireless?force=）
unsigned long wlForceUntil = 0;     // 强制到期时刻（自愈：3 分钟后自动回到场景判定，避免把设备锁在蓝牙）
unsigned long lastWirelessCheck = 0;
#if ENABLE_BLE
String   bleRxBuf;
BLECharacteristic* bleTx = nullptr;
bool bleStopping = false;       // 正在主动关闭蓝牙：期间 onDisconnect 不要再重启广播
#endif

// ===== 「连网会话」：配网/按钮触发的临时 WiFi（设计文档 · 无线切换与配网流程）=====
//   移动+电池平时走蓝牙（省电）；用户配网保存 / 点已保存网络 / 长按按钮 → 临时切 WiFi 用网页。
//   会话期间只要有网页请求就续期（网页每 3 秒轮询 /status）；断流 WIFI_SESSION_MS 自动回蓝牙。
//   防误触：① 插电/固定时按钮完全无效（那时本来就该 WiFi/AP）
//          ② 会话到期自动回蓝牙 —— 丢包里蹭到也不会傻等把电耗光
//   ⚠️ v2.2（2026-10-02）：交互由**长按改短按**（依据 设计文档 V2.2 · 软件 · 交互和可视化 1）。
//      短按上限设 1200ms：既覆盖正常点按，又把 1.2~5s 的"犹豫按压"排除在外，
//      避免"想长按结果按了一半就松手"被误判成常规动作。
const unsigned long WIFI_SESSION_MS   = 60000;
const unsigned long WIFI_BTN_SHORT_MS = 1200;    // ≤ 此值 = 短按（下限见 WIFI_BTN_DEBOUNCE_MS）
const unsigned long WIFI_BTN_DEBOUNCE_MS = 30;   // < 此值视为抖动，忽略
// 【兜底】长按到这个时长（松手才触发）→ 强制开热点 + 断开 WiFi，用于设备失联时救援
//   失控场景：设备连上了某个网、却因「静态 IP/网关学错网段」而彻底够不着（实测踩到，见 开发日志 §十二）
const unsigned long WIFI_BTN_RECOVER_MS = 5000;   // 长按（松手触发）= 救援模式，**保持长按以防误触**
const unsigned long AP_SESSION_MS     = 600000;  // AP 配网热点：无人访问满 10 分钟自动关（省电，移动+电池尤其重要）
unsigned long wifiSessionUntil = 0;    // 会话到期时刻（0 = 无会话）
unsigned long apSessionUntil   = 0;    // AP 配网热点到期时刻（0 = 无超时/未启用；仅按需开启的 AP 用）
unsigned long bleHoldUntil     = 0;    // 切 WiFi 时「缓关蓝牙」到此刻（先把 SSID/IP 推送给网页）
bool     wifiBtnArmed    = false;      // 已识别按钮长按，等 loop 执行
String   pendingSSID;                  // 待连接的网络
unsigned long pendingAt   = 0;         // 何时开始连（留 400ms 把 BLE 回包发出去）
bool     webSeenSinceConnect = false;  // 本次连网后是否收到过网页请求
bool     toastDismissReq = false;      // 收到网页请求 → 请求收横幅（真正的重绘放到主循环做）

// ---- 诊断环：最近 6 条关键日志（只读，供蓝牙网页拉取）----
//   为什么需要：移动+电池走蓝牙时设备没有 HTTP，出问题时看不到内部状态；
//   页面发完请求若 12 秒没结果，就拉 `/diag` 把这几行显示出来。
String diagLines[6];
int    diagHead = 0;
void diag(const String& s) {
  diagLines[diagHead] = s;
  diagHead = (diagHead + 1) % 6;
  webLogln("🧪 %s", s.c_str());
}
String buildDiagJson() {
  String s = "{\"lines\":[";
  for (int i = 0; i < 6; i++) {
    int k = (diagHead + i) % 6;
    if (!diagLines[k].length()) continue;
    if (s.length() > 12) s += ",";
    s += "\"" + diagLines[k] + "\"";
  }
  return s + "]}";
}

// 网页被访问：给会话续期；并作为「用户真的进来了」的确认（立刻收横幅，别傻等）
//   ⚠ 定义放在 uiDisplay 对象之后（serviceWifiSession 前）—— 这里先声明，因为路由在 setup() 里就要用它
void noteWebActivity();

// 开始一次连网会话（配网保存 / 点已保存网络 / 长按按钮 都走这里）
//   ⚠ 真正的连接在 loop 末尾做（会阻塞几秒）：这里只登记，先把 BLE 回包发出去
void beginWifiSession(const String& ssid) {
  wlForce = 0; wlForceUntil = 0;      // 用户的配网意图优先：清掉 /wireless?force= 联调口留下的强制标志
  pendingSSID = ssid;
  pendingAt   = millis() + 400;
  cfgDbgBegin("配网：保存或点已保存网络");
  diag("登记连接 " + ssid + "，模式=" + String(curWireless) + " (1=WiFi 2=蓝牙)");
  webLogln("📶 准备连接 WiFi: %s …", ssid.c_str());
}

// 按设计文档表格判定「现在该用哪种无线」
uint8_t wantWireless() {
  if (wlForce && wlForceUntil && millis() > wlForceUntil) {   // 强制到期 → 自动回场景判定
    webLogln("🔧 无线强制模式到期，恢复自动");
    wlForce = 0; wlForceUntil = 0;
  }
  if (wlForce == 1) return WL_WIFI;
#if ENABLE_BLE
  if (wlForce == 2) return WL_BLE;
#endif
  // 【兜底·最高优先】长按 IO9 进入的「热点救援模式」：期间一律 WiFi 且不重连 STA
  //   ⚠ 必须排在 wlForce 之后、其余判定之前：它是逃生门，不能被任何场景判定顶掉
  if (wifiRecoverUntil && (int32_t)(millis() - wifiRecoverUntil) < 0) return WL_WIFI;
  // 连网会话（配网/按钮触发）：临时 WiFi，到期自动回蓝牙
  //   ⚠ 必须排在 wlForce / wifiForced 之前：否则被“强制蓝牙”锁住时会默默忽略配网请求
  if (wifiSessionUntil && (int32_t)(millis() - wifiSessionUntil) < 0) return WL_WIFI;
  if (wifiForced)   return WL_WIFI;          // 实体按钮：强制 WiFi + 顶掉蓝牙
  // AP 配网热点（IO9 按需开启，带超时）：热点期间必须保持 WiFi 射频（否则会被下面「移动+电池→全关」误关）
  if (apEnabled && apSessionUntil && (int32_t)(millis() - apSessionUntil) < 0) return WL_WIFI;
  if (deviceMode == 1) {                     // 移动模式
    PowerState ps = readPowerState();
    if (ps.onBattery) return WL_OFF;         // V2.1：移动+电池 → 无线全关（省电），按 IO9 临时开启
  }
  return WL_WIFI;                            // 固定 / 插电：一律 WiFi（连不上再 AP 兜底）
}

// ---- 关 WiFi（含 AP）----
void wifiDown() {
  if (apEnabled) { WiFi.softAPdisconnect(true); apEnabled = false; apClosedMs = 0; }
  WiFi.disconnect(true);
  WiFi.mode(WIFI_OFF);
  webLogln("📴 WiFi 已关闭（让位给蓝牙）");
}

// ---- ICMP 探测：ping 一下某地址；返回 true = 有回应（说明该地址**已被占用**）----
//   用途：静态 IP 查重（候选末段被占 → +1 再试）。ESP32 查不到路由器的客户端列表，只能自己发包探。
static volatile bool pingGotReply = false;
static void pingOnSuccess(esp_ping_handle_t hdl, void* args) { pingGotReply = true; }

bool pingHost(const IPAddress& ip, uint32_t timeoutMs) {
  pingGotReply = false;
  esp_ping_config_t cfg = ESP_PING_DEFAULT_CONFIG();
  cfg.count       = 1;
  cfg.interval_ms = 100;
  cfg.timeout_ms  = timeoutMs;
  cfg.data_size   = 1;
  cfg.target_addr.type = ESP_IPADDR_TYPE_V4;
  cfg.target_addr.u_addr.ip4.addr = (uint32_t)ip;
  esp_ping_callbacks_t cbs = {};
  cbs.on_ping_success = pingOnSuccess;
  esp_ping_handle_t hdl = nullptr;
  if (esp_ping_new_session(&cfg, &cbs, &hdl) != ESP_OK || !hdl) { webLogln("⚠️ ping 会话创建失败"); return false; }
  esp_ping_start(hdl);
  unsigned long t0 = millis();
  while (!pingGotReply && (millis() - t0) < (timeoutMs + 400)) delay(10);
  esp_ping_stop(hdl);
  esp_ping_delete_session(hdl);
  return pingGotReply;
}

// ---- 连接已保存的网络（静态 IP 策略，设计文档 附录 C.3）----
//   allowAP=false：失败只报错、**绝不开热点**；true：失败 → 开 AP 兜底
//   useIP=true 时：① 先 DHCP 连一次（学 gw/mask/dns 并落盘）② ping 候选末段查重（被占 +1，最多 5 个）
//                  ③ 配静态重连 ④ 都不行 → 退回 DHCP，并把「实际用的地址」报出来
//   wifiStaticFallback = true 表示「本该静态但退回了 DHCP」——调用方据此在屏幕上标明 WiFi DHCP
bool wifiStaticFallback = false;
bool wifiRelearnProtect = false;   // true = 正在"重学后重试"，防止网关自检再次清参数互相打架
// 连上 WiFi 后的横幅标题：正常「WiFi OK」；本该静态却退回 DHCP 时标「WiFi DHCP」
//   （用户要求：退回 DHCP 必须在屏幕上标出来，不然不知道连在哪）
const char* wifiOkTitle() { return wifiStaticFallback ? "WiFi DHCP" : "WiFi OK"; }

bool wifiConnectSaved(bool allowAP) {
  wifiStaticFallback = false;
  if (strlen(wifiCfg.ssid) == 0) { if (allowAP) { webLogln("📶 未配网 → 直接开 AP"); startAP(); } return false; }
  diag(String("begin ‘") + wifiCfg.ssid + "’ 密码长" + String(strlen(wifiCfg.password)) +
       " 静态" + String(wifiCfg.useIP ? "Y" : "N") + " 末段" + String(wifiCfg.ipLast) + " 模式" + String(curWireless));
  WiFi.mode(WIFI_STA);

  auto waitConnected = [](int steps) -> bool {
    for (int i = 0; i < steps && WiFi.status() != WL_CONNECTED; i++) delay(500);
    return WiFi.status() == WL_CONNECTED;
  };
  auto bail = [&](const char* why) -> bool {
    webLogln("❌ WiFi 连接失败: %s（%s）", wifiCfg.ssid, why);
    if (allowAP) { webLogln("⚠️ → 开 AP 兜底"); diag(String("连不上 ‘") + wifiCfg.ssid + "’(" + why + ") → 开 AP"); startAP(); }
    else diag(String("连不上 ‘") + wifiCfg.ssid + "’(" + why + ")，不开热点");
    return false;
  };

  if (!wifiCfg.useIP) {
    // ---------- 纯 DHCP ----------
    WiFi.config(INADDR_NONE, INADDR_NONE);          // 清掉可能残留的静态配置，确保走 DHCP
    WiFi.begin(wifiCfg.ssid, wifiCfg.password);
    if (!waitConnected(20)) return bail("DHCP 超时");
    webLogln("✅ WiFi 已连接(DHCP): %s (%s)", wifiCfg.ssid, WiFi.localIP().toString().c_str());
    diag(String("连上了 ‘") + wifiCfg.ssid + "’ @ " + WiFi.localIP().toString() + "（DHCP）");
    return checkGatewayReachable(WiFi.localIP().toString(), "");
  }

  // ---------- 静态：① 需要时才 DHCP 学一次网络参数（2026-10-03 改）----------
  //   ⚠️ 用户指出：网关/掩码/DNS **学过就该缓存**（谁家网关天天变？），
  //      原来每次启动都无条件重学 → 白等一个 DHCP 往返（1.7s，网关慢时最多 10s）+ 每次写盘。
  //   现在：已学过 → 直接用缓存；若之后配静态/网关自检失败 → 再学一次兜底（自愈换路由器场景）。
  bool gwKnown = ((uint32_t)wifiCfg.gw != 0) && ((uint32_t)wifiCfg.mask != 0);
  String dhcpIp = "-";
  auto doLearn = [&]() -> bool {
    WiFi.config(INADDR_NONE, INADDR_NONE);
    WiFi.begin(wifiCfg.ssid, wifiCfg.password);
    if (!waitConnected(20)) return false;
    dhcpIp = WiFi.localIP().toString();
    wifiCfg.gw   = WiFi.gatewayIP();
    wifiCfg.mask = WiFi.subnetMask();
    wifiCfg.dns  = WiFi.dnsIP();
    if ((uint32_t)wifiCfg.mask == 0) wifiCfg.mask = STA_MASK;
    if ((uint32_t)wifiCfg.dns  == 0) wifiCfg.dns  = wifiCfg.gw;
    // ★ 2026-10-03 关键修复：**必须回写 wifiList 再存盘**。
    //   wifiCfg 是独立对象（由 wifiList 拷贝而来），只写它的话落盘仍是空值
    //   → 下次开机又判"没学过" → 无限重复 DHCP 学习（用户实测：每次启动都白等一个往返）。
    bool wrote = false;
    for (int i = 0; i < wifiCount; i++) {
      if (strcmp(wifiList[i].ssid, wifiCfg.ssid) == 0) {
        wifiList[i].gw = wifiCfg.gw; wifiList[i].mask = wifiCfg.mask; wifiList[i].dns = wifiCfg.dns;
        wrote = true; break;
      }
    }
    if (!wrote) webLogln("⚠️ 学习成果回写失败：wifiList 里找不到 '%s'", wifiCfg.ssid);
    saveWiFiConfig();
    return true;
  };
  if (!gwKnown) {
    webLogln("📥 首次配网 → DHCP 学习网络参数");
    if (!doLearn()) return bail("DHCP 学习阶段超时");
  } else {
    webLog("📥 使用已学习的网络参数（跳过 DHCP 学习）: 网关 %s 掩码 %s DNS %s\n",
           wifiCfg.gw.toString().c_str(), wifiCfg.mask.toString().c_str(), wifiCfg.dns.toString().c_str());
  }
  // ⚠ 按字节构造基址：IPAddress 内部小端，搞错字节序会得到 227.168.31.0 这种鬼地址（实测踩到）
  IPAddress base((uint32_t)wifiCfg.gw & (uint32_t)wifiCfg.mask);
  if (!gwKnown) {   // 只有**本次真的学了**才打印这两句（否则与"跳过"日志自相矛盾）
    webLogln("📥 已学习网络参数: 网关 %s 掩码 %s DNS %s", wifiCfg.gw.toString().c_str(),
             wifiCfg.mask.toString().c_str(), wifiCfg.dns.toString().c_str());
    diag("DHCP 学习: gw=" + wifiCfg.gw.toString() + " mask=" + wifiCfg.mask.toString());
  }

  // ---------- ② 查重：从末段(默认200)起，最多 5 个，ping 有回应 = 被占 ----------
  int start = wifiCfg.ipLast ? wifiCfg.ipLast : 200;
  int gwLast = wifiCfg.gw[3];                    // 网关末段（用字节取，别用位运算）
  int chosen = -1;
  for (int k = 0; k < 5; k++) {
    int cand = start + k;
    if (cand < 2 || cand > 254) break;
    if (cand == gwLast) { webLogln("⏭️ .%d 与网关冲突 → 跳过", cand); continue; }
    IPAddress cip(base[0], base[1], base[2], (uint8_t)cand);
    if (!pingHost(cip, 600)) { chosen = cand; webLogln("✅ .%d (%s) ping 不通 → 用作静态地址", cand, cip.toString().c_str()); break; }
    webLogln("⚠️ .%d (%s) 已被占用（ping 有回应）→ 试下一个", cand, cip.toString().c_str());
  }
  if (chosen < 0) {
    webLogln("⚠️ 候选末段均不可用（被占/越界）→ 退回 DHCP（实际地址 %s）", dhcpIp.c_str());
    wifiStaticFallback = true;
    return true;                                        // 已以 DHCP 连着，直接用
  }

  // ---------- ③ 配静态并重连（失败时**重学一次参数再试**）----------
  //   ★ 2026-10-03 用户要求：网关/掩码/DNS 用缓存配静态失败 → 重学一次再配静态，
  //     而不是像旧逻辑那样直接放弃静态、永久退回 DHCP。
  const bool useIPSaved = wifiCfg.useIP;       // 失败时用来恢复静态偏好

  auto applyStatic = [&](IPAddress useGw, IPAddress useMask, IPAddress useDns) -> bool {
    IPAddress sip(base[0], base[1], base[2], (uint8_t)chosen);
    WiFi.config(sip, useGw, useMask, useDns);
    WiFi.disconnect(false, false);
    delay(200);
    WiFi.begin(wifiCfg.ssid, wifiCfg.password);
    if (!waitConnected(20)) return false;
    wifiCfg.ipLast = (uint8_t)chosen; saveWiFiConfig();
    webLogln("✅ 静态 IP 生效: %s（DHCP 曾拿 %s）", sip.toString().c_str(), dhcpIp.c_str());
    diag(String("静态生效 ‘") + wifiCfg.ssid + "’ @ " + sip.toString());
    return checkGatewayReachable(sip.toString(), dhcpIp);
  };

  if (applyStatic(wifiCfg.gw, wifiCfg.mask, wifiCfg.dns)) return true;

  // ---------- ③b 重学兜底（仅当本来用的是"缓存的"参数时才有意义）----------
  if (gwKnown) {
    webLogln("🩹 用已学习的参数配静态失败 → 重学网络参数后再试一次（保留静态偏好）");
    // 先把静态偏好恢复回来：checkGatewayReachable 的旧自愈分支可能把它改成 DHCP
    bool wrote = false;
    for (int i = 0; i < wifiCount; i++) {
      if (strcmp(wifiList[i].ssid, wifiCfg.ssid) == 0) {
        wifiList[i].useIP = true;
        wifiList[i].gw = IPAddress(0, 0, 0, 0);
        wifiList[i].mask = IPAddress(0, 0, 0, 0);
        wifiList[i].dns = IPAddress(0, 0, 0, 0);
        wrote = true; break;
      }
    }
    if (wrote) saveWiFiConfig();
    wifiCfg.useIP = true;
    wifiCfg.gw = wifiCfg.mask = wifiCfg.dns = IPAddress(0, 0, 0, 0);

    if (doLearn()) {
      wifiRelearnProtect = true;               // 自检失败时不要再清参数（交给外层兜底）
      IPAddress base2((uint32_t)wifiCfg.gw & (uint32_t)wifiCfg.mask);
      for (int k = 0; k < 5; k++) {
        int cand2 = start + k;
        if (cand2 < 2 || cand2 > 254) break;
        if (cand2 == gwLast) continue;
        IPAddress cip2(base2[0], base2[1], base2[2], (uint8_t)cand2);
        if (!pingHost(cip2, 600)) { chosen = cand2; break; }
      }
      if (chosen > 0) {
        IPAddress base3((uint32_t)wifiCfg.gw & (uint32_t)wifiCfg.mask);
        base = base3;
        bool ok2 = applyStatic(wifiCfg.gw, wifiCfg.mask, wifiCfg.dns);
        wifiRelearnProtect = false;
        if (ok2) return true;
      } else {
        wifiRelearnProtect = false;
      }
    }
    // 重学也没救回来 → 恢复用户原本的静态偏好，交给下面的 DHCP 兜底（本次会话）
    wifiCfg.useIP = true;
    for (int i = 0; i < wifiCount; i++)
      if (strcmp(wifiList[i].ssid, wifiCfg.ssid) == 0) { wifiList[i].useIP = useIPSaved; break; }
    saveWiFiConfig();
  }

  // ---------- ④ 静态连不上 → 退回 DHCP ----------
  webLogln("⚠️ 静态地址（末段 .%d）连不上 → 退回 DHCP", (int)wifiCfg.ipLast);
  WiFi.config(INADDR_NONE, INADDR_NONE);
  WiFi.disconnect();
  delay(200);
  WiFi.begin(wifiCfg.ssid, wifiCfg.password);
  if (waitConnected(20)) {
    wifiStaticFallback = true;
    webLogln("✅ 已退回 DHCP：实际地址 %s", WiFi.localIP().toString().c_str());
    diag(String("静态失败 → 退回 DHCP @ ") + WiFi.localIP().toString());
    return true;
  }
  return bail("静态与 DHCP 均失败");
}

// ---- 【兜底】网关自检：连上后 ping 一次网关，确认「地址/网关真在同一个网段」----
//   病根（实测踩到）：网络参数（gw/mask/dns）是「DHCP 学一次就落盘」的。
//     若某次连网时网络处于异常状态（例：CPE 故障期自己发了另一个网段的 DHCP），
//     学到的那套参数就被存下来；等网络恢复正常，设备仍按旧网段配静态 IP + 指旧网关
//     → WiFi 显示"已连接"，但它上不了网、PC 也够不着它 → **彻底失联，只能拔电**（见 开发日志 §十二）
//   对策：连上后验一次网关；不通就把学来的 gw/mask/dns 清掉并改用 DHCP 重连（自愈）
//   代价：每次连网多一次 ping（600ms 超时），只影响开机那几秒
bool checkGatewayReachable(const String& myIp, const String& dhcpPrevIp) {
  IPAddress gw = WiFi.gatewayIP();
  if ((uint32_t)gw == 0 || (uint32_t)gw == 0xFFFFFFFF) {
    webLogln("⚠️ 网关未知（%s）→ 跳过网关自检", myIp.c_str());
    return true;                                     // 拿不到网关就没法判，按成功处理
  }
  bool inSameSubnet = true;
  IPAddress mask = WiFi.subnetMask();
  if ((uint32_t)mask != 0) {
    // 按字节比：我的地址与网关是否同网段（IPAddress 内部小端，别用位运算）
    for (int i = 0; i < 4; i++) {
      if (((uint8_t)WiFi.localIP()[i] & (uint8_t)mask[i]) != ((uint8_t)gw[i] & (uint8_t)mask[i])) { inSameSubnet = false; break; }
    }
  }
  if (!inSameSubnet) {
    webLogln("⚠️ 本机 %s 与网关 %s 不在同一网段（掩码 %s）→ 判定参数错，走自愈",
             myIp.c_str(), gw.toString().c_str(), mask.toString().c_str());
  } else if (pingHost(gw, 600)) {
    webLogln("✅ 网关自检通过：%s 可达（本机 %s）", gw.toString().c_str(), myIp.c_str());
    return true;                                     // 一切正常，保持原配置
  } else {
    webLogln("⚠️ 网关 %s ping 不通（本机 %s）→ 判定参数错，走自愈", gw.toString().c_str(), myIp.c_str());
  }

  // ---- 自愈分支 ----
  //   ★ 2026-10-03：**重学保护期内直接失败返回**，由调用方（wifiConnectSaved）去重学后再试。
  //      否则这里会清掉参数 + 把 useIP 改成 DHCP，与新逻辑互相打架。
  if (wifiRelearnProtect) return false;

  // ---- 自愈：清掉学来的网络参数 + 退回 DHCP 重连（保留旧逻辑作为最终兜底）----
  webLogln("🩹 自愈：清除学到的网关/掩码/DNS，改用 DHCP 重新获取（旧值 gw=%s mask=%s dns=%s）",
           wifiCfg.gw.toString().c_str(), wifiCfg.mask.toString().c_str(), wifiCfg.dns.toString().c_str());
  diag("网关自检不过 → 清网络参数 + 退 DHCP 自愈");
  wifiCfg.gw = IPAddress(0, 0, 0, 0);
  wifiCfg.mask = IPAddress(0, 0, 0, 0);
  wifiCfg.dns = IPAddress(0, 0, 0, 0);
  if (wifiCfg.useIP) { wifiCfg.useIP = false; webLogln("🩹 地址方式已由「静态」改为「自动(DHCP)」（可重配静态）"); }
  saveWiFiConfig();

  wifiStaticFallback = true;
  WiFi.config(INADDR_NONE, INADDR_NONE);
  WiFi.disconnect();
  delay(200);
  WiFi.begin(wifiCfg.ssid, wifiCfg.password);
  for (int i = 0; i < 20 && WiFi.status() != WL_CONNECTED; i++) delay(500);
  if (WiFi.status() == WL_CONNECTED) {
    IPAddress gw2 = WiFi.gatewayIP();
    bool ok2 = ((uint32_t)gw2 != 0) && pingHost(gw2, 600);
    webLogln("🩹 自愈结果：DHCP 地址 %s 网关 %s → %s",
             WiFi.localIP().toString().c_str(), gw2.toString().c_str(), ok2 ? "可用 ✅" : "仍不可用 ⚠️（可长按 IO9 ≥5s 进 AP 救援）");
    uiDisplay.showToast(ok2 ? UI_TOAST_OK : UI_TOAST_FAIL, wifiOkTitle(),
                        wifiCfg.ssid, WiFi.localIP().toString().c_str(), 20000);
    return ok2;
  }
  webLogln("❌ 自愈失败：退回 DHCP 也没连上 → 建议长按 IO9 ≥5s 进 AP 救援模式重新配网");
  uiDisplay.showToast(UI_TOAST_FAIL, "WiFi FAIL", wifiCfg.ssid, "长按 IO9 ≥5s 救援", 15000);
  return false;
}

// ---- 开 WiFi（开机 / 固定用）：多组先挑最强，连不上 AP 兜底 ----
void wifiUp() {
  WiFi.mode(WIFI_STA);
  if (wifiCount > 1) wifiPickBest(false);
  wifiConnectSaved(true);
}

#if ENABLE_BLE
// ===================== BLE 收发：全部在 loop() 里做 =====================
// 教训（2026-09-13）：蓝牙写回调跑在协议栈任务上（栈约 3KB），绝不能在回调里跑大栈函数
// （/history 的解析数组就 4.8KB）——否则栈溢出 panic、设备重启。回调只拷贝，处理与发送都交给 loop()。
static char blePendBuf[512];        // 待处理请求（回调里只拷这点东西；配网 URL 可达 300+ 字节）
volatile bool blePend = false;
static String bleTxBuf;             // 待发送内容（loop 里分片发出）
static size_t bleTxPos = 0;
static bool bleTxActive = false;

// 待发送队列：避免「后来的响应把还没发完的推送顶掉」
//   实测踩到：配网成功后推 {event:wifi-connected}，被紧随其后的 /status 响应覆盖 → 手机收不到。
static const int BLE_TXQ = 4;
static String bleTxQ[BLE_TXQ];
static int bleTxQHead = 0, bleTxQTail = 0, bleTxQN = 0;

void bleSendLine(const String& s) {
  if (!bleLink || !bleTx) return;
  if (bleTxQN >= BLE_TXQ) {                 // 队列满：丢最旧的（保证最新的状态能出去）
    bleTxQHead = (bleTxQHead + 1) % BLE_TXQ; bleTxQN--;
  }
  bleTxQ[bleTxQTail] = s;
  bleTxQTail = (bleTxQTail + 1) % BLE_TXQ; bleTxQN++;
  if (!bleTxActive) {                       // 空闲则立即开始发
    bleTxBuf = bleTxQ[bleTxQHead];
    bleTxQHead = (bleTxQHead + 1) % BLE_TXQ; bleTxQN--;
    bleTxPos = 0; bleTxActive = true;
  }
}

// 在 loop() 里推进发送：每轮最多 4 片 × 180 字节，片间 4ms（几千字节约几百毫秒）
void bleTxPump() {
  if (!bleTxActive || !bleLink || !bleTx) return;
  for (int k = 0; k < 4; k++) {
    if (bleTxPos >= bleTxBuf.length()) {        // 收尾：单独一个 '\n' 作为帧结束标记
      bleTx->setValue((uint8_t*)"\n", 1);
      bleTx->notify();
      bleTxActive = false; bleTxBuf = ""; bleTxPos = 0;
      if (bleTxQN == 0) return;
      bleTxBuf = bleTxQ[bleTxQHead];            // 队列里还有 → 接着发（不丢帧）
      bleTxQHead = (bleTxQHead + 1) % BLE_TXQ; bleTxQN--;
      bleTxPos = 0; bleTxActive = true;
    }
    size_t n = bleTxBuf.length() - bleTxPos;
    if (n > 180) n = 180;
    bleTx->setValue((uint8_t*)bleTxBuf.c_str() + bleTxPos, n);
    bleTx->notify();
    bleTxPos += n;
    delay(4);
  }
}

// ---- BLE 写回调（协议栈任务，栈小）：只把请求拷走，处理交给 loop() ----
void bleHandleRequest(String req) {
  req.trim();
  if (req.startsWith("GET ")) req = req.substring(4);
  req.toCharArray(blePendBuf, sizeof(blePendBuf));
  blePend = true;
}

// 从 "?a=1&b=2" 里取整型参数
int bleQInt(const String& qs, const char* key, int def) {
  String k = String(key) + "=";
  int p = qs.indexOf(k);
  if (p < 0) return def;
  int e = qs.indexOf('&', p);
  String v = (e < 0) ? qs.substring(p + k.length()) : qs.substring(p + k.length(), e);
  return v.toInt();
}

// 配网：保存/点连接后立刻切 WiFi 去连（旧的「20 秒后重启」方案已作废）

// JSON 字符串转义（配网日志尾部回传给网页用）
String jsonEsc(const String& in) {
  String o; o.reserve(in.length() + 16);
  for (unsigned int i = 0; i < in.length(); i++) {
    char c = in[i];
    if (c == '"' || c == '\\') { o += '\\'; o += c; }
    else if (c == '\n') o += "\\n";
    else if (c == '\r') { }
    else if ((uint8_t)c < 0x20) o += ' ';
    else o += c;
  }
  return o;
}

// URL 解码（%XX 与 '+'）：配网的 SSID/密码经 encodeURIComponent 过来
String urlDecode(const String& in) {
  String out; out.reserve(in.length());
  for (unsigned int i = 0; i < in.length(); i++) {
    char c = in[i];
    if (c == '+') { out += ' '; continue; }
    if (c == '%' && i + 2 < in.length()) {
      auto hex = [](char h)->int { if (h >= '0' && h <= '9') return h - '0';
                                   if (h >= 'a' && h <= 'f') return h - 'a' + 10;
                                   if (h >= 'A' && h <= 'F') return h - 'A' + 10; return -1; };
      int hi = hex(in[i + 1]), lo = hex(in[i + 2]);
      if (hi >= 0 && lo >= 0) { out += (char)(hi * 16 + lo); i += 2; continue; }
    }
    out += c;
  }
  return out;
}
// 取字符串参数（自动 URL 解码）
String bleQStr(const String& qs, const char* key) {
  String k = String(key) + "=";
  int p = qs.indexOf(k);
  if (p < 0) return "";
  int e = qs.indexOf('&', p);
  String v = (e < 0) ? qs.substring(p + k.length()) : qs.substring(p + k.length(), e);
  return urlDecode(v);
}
bool bleHas(const String& qs, const char* key) { return qs.indexOf(String(key) + "=") >= 0; }

// ---- BLE 请求分发（在 loop() 里跑：主任务栈 8KB，足够；与 HTTP 同一套 builder，只开放只读数据 + 配网）----
void bleProcessPending() {
  if (!blePend) return;
  if (bleTxActive) return;              // 上一帧还没发完：保留请求，下一轮 loop 再处理（不丢）
  blePend = false;
  String req(blePendBuf);
  String path = req, qs = "";
  int q = req.indexOf('?');
  if (q >= 0) { path = req.substring(0, q); qs = req.substring(q + 1); }
  // 配网请求的密码在 URL 里：日志只记路径，别把密码写进 weblog
  webLogln("🔵 BLE 请求: %s", (path == "/wifi-save") ? path.c_str() : req.c_str());

  if (path == "/status" || path == "/") { bleSendLine(buildStatusJson(true)); return; }
  if (path == "/today-stats")             { bleSendLine(buildTodayStatsJson()); return; }
  if (path == "/anomaly")                 { bleSendLine(buildAnomalyJson()); return; }
  if (path == "/daily-avg")               { bleSendLine(buildDailyAvgJson()); return; }
  if (path == "/history") {
    // 蓝牙带宽有限：默认只取 100 条（HTTP 默认 200）
    int count = bleQInt(qs, "count", 100);
    if (count <= 0 || count > 100) count = 100;
    bleSendLine(buildHistoryJson(bleQInt(qs, "page", 0), count, bleQInt(qs, "filter", 0) == 1));
    return;
  }
  // ---- 配网（蓝牙版唯一可写的地方；设计文档：只写 Flash、不立即连）----
  if (path == "/wifi-list") { bleSendLine(buildWifiListJson()); return; }
  if (path == "/diag")      { bleSendLine(buildDiagJson()); return; }   // 只读诊断：最近 6 条关键日志
  if (path == "/cfgdbg") {                                              // 只读：配网调试日志（写 Flash）尾部
    String s;
    File f = LittleFS.open(CFG_DBG_PATH, "r");
    if (f) { size_t sz = f.size(); if (sz > 1800) f.seek(sz - 1800); s = f.readString(); f.close(); }
    if (!s.length()) s = "(暂无配网调试日志：还没触发过配网/IO9 按钮)";
    bleSendLine("{\"log\":\"" + jsonEsc(s) + "\"}");
    return;
  }
  if (path == "/wifi-scan") { bleSendLine(buildWifiScanJson()); return; }
  if (path == "/wifi-save") {
    String ssid = bleQStr(qs, "ssid");
    String pass = bleQStr(qs, "pass");
    if (pass.length() == 0) pass = bleQStr(qs, "password");   // 兼容网页表单的字段名
    int useIPMode = bleHas(qs, "useIP") ? (bleQStr(qs, "useIP") == "1" ? 1 : 0) : -1;
    if (ssid.length() == 0) { bleSendLine("{\"ok\":false,\"err\":\"ssid_empty\"}"); return; }
    int idx = wifiUpsert(ssid.c_str(), pass.c_str(), useIPMode, bleQInt(qs, "ipLast", 0));
    bool powered = isExternallyPowered();
    if (idx >= 0) {
      webLogln("📶 [配网] 已保存: %s（共 %d 组）→ 立即切 WiFi 连接", ssid.c_str(), wifiCount);
      beginWifiSession(ssid);                      // 设计文档：保存后立刻连（不再等重启）
    }
    bleSendLine("{\"ok\":" + String(idx >= 0 ? "true" : "false") +
                ",\"count\":" + String(wifiCount) + ",\"max\":" + String(WIFI_MAX_SAVED) +
                ",\"ssid\":\"" + ssid + "\",\"stage\":\"" + String(idx >= 0 ? "connecting" : "failed") + "\"}");
    return;
  }
  if (path == "/wifi-connect") {
    String ssid = bleQStr(qs, "ssid");
    int idx = -1;
    for (int i = 0; i < wifiCount; i++) if (ssid == String(wifiList[i].ssid)) { idx = i; break; }
    if (idx < 0) { bleSendLine("{\"ok\":false,\"err\":\"not_saved\"}"); return; }
    wifiSyncCurrent(idx);                          // 把「当前组」切到这组（用它的静态IP等配置）
    webLogln("📶 [配网] 连接已保存网络: %s", ssid.c_str());
    beginWifiSession(ssid);
    bleSendLine("{\"ok\":true,\"ssid\":\"" + ssid + "\",\"stage\":\"connecting\"}");
    return;
  }
  if (path == "/wifi-del") {
    String ssid = bleQStr(qs, "ssid");
    bool ok = wifiRemove(ssid.c_str());
    webLogln("🗑️ [配网] 删除: %s %s（剩 %d 组）", ssid.c_str(), ok ? "OK" : "未找到", wifiCount);
    bleSendLine("{\"ok\":" + String(ok ? "true" : "false") + ",\"count\":" + String(wifiCount) + "}");
    return;
  }
  bleSendLine("{\"error\":\"not_found\",\"note\":\"蓝牙/局域网只提供只读数据与配网\"}");
}

class BleServerCB : public BLEServerCallbacks {
  void onConnect(BLEServer* s)    { bleLink = true;  webLogln("🔵 蓝牙已连接"); }
  void onDisconnect(BLEServer* s) { bleLink = false; webLogln("⚪ 蓝牙断开 → 重新广播"); if (!bleStopping) BLEDevice::startAdvertising(); }
};
class BleRxCB : public BLECharacteristicCallbacks {
  void onWrite(BLECharacteristic* c) {
    String v = c->getValue().c_str();
    for (size_t i = 0; i < v.length(); i++) {
      char ch = v[i];
      if (ch == '\n' || ch == '\r') { if (bleRxBuf.length()) { bleHandleRequest(bleRxBuf); bleRxBuf = ""; } }
      else if (bleRxBuf.length() < 200) bleRxBuf += ch;
      else bleRxBuf = "";                      // 防跑飞
    }
  }
};

void startBLE() {
  if (bleOn) return;
  BLEDevice::init(BLE_DEV_NAME);
  BLEServer* srv = BLEDevice::createServer();
  srv->setCallbacks(new BleServerCB());
  BLEService* svc = srv->createService(BLE_SVC_UUID);
  bleTx = svc->createCharacteristic(BLE_TX_UUID, BLECharacteristic::PROPERTY_NOTIFY);
  bleTx->addDescriptor(new BLE2902());
  BLECharacteristic* rx = svc->createCharacteristic(BLE_RX_UUID,
      BLECharacteristic::PROPERTY_WRITE | BLECharacteristic::PROPERTY_WRITE_NR);
  rx->setCallbacks(new BleRxCB());
  svc->start();
  BLEAdvertising* adv = BLEDevice::getAdvertising();
  adv->addServiceUUID(BLE_SVC_UUID);
  adv->setScanResponse(true);
  BLEDevice::startAdvertising();
  bleOn = true;
  webLogln("🔵 蓝牙已开启并广播：%s（服务 %s）", BLE_DEV_NAME, BLE_SVC_UUID);
}

void stopBLE() {
  if (!bleOn) return;
  // ① 先停掉我自己的发送，之后不再碰任何蓝牙对象
  bleStopping = true;
  bleLink = false; bleTxActive = false; bleTxBuf = ""; bleTxQN = 0; bleTxQHead = bleTxQTail = 0;
  blePend = false;
  // ② 【关键】必须先主动断开所有客户端，并等 NimBLE 把「断开完成」事件处理完。
  //    原因：core 的 BLEDevice::deinit() **无条件 delete m_pServer**（release_memory 参数
  //    根本没被使用），删完以后晚到的 disconnect 事件还会去 erase 它的
  //    m_connectedClientsMap（毒化 0xbaad5678）→ LoadProhibited。
  //    实测 backtrace: BLEServer::removePeerDevice(BLEServer.cpp:361) ← handleGATTServerEvent(:838)
  //    ← ble_gap_rx_disconn_complete ← BLEDevice::host_task
  //    所以：手机还连着就 deinit，必炸。先断开、等干净、再 deinit。
  BLEServer* s = BLEDevice::getServer();
  if (s) {
    for (int round = 0; round < 20 && s->getConnectedCount() > 0; round++) {
      std::map<uint16_t, conn_status_t> peers = s->getPeerDevices(false);
      if (peers.empty()) { delay(20); continue; }
      for (std::map<uint16_t, conn_status_t>::iterator it = peers.begin(); it != peers.end(); ++it) {
        s->disconnect(it->first);
      }
      delay(25);
    }
    delay(60);                    // 再留一点收尾时间
  }
  // ③ 现在释放才安全
  BLEDevice::deinit(true);
  bleOn = false; bleStopping = false; bleTx = nullptr; bleRxBuf = "";
  webLogln("⚪ 蓝牙已关闭");
}
#else   // ==== ENABLE_BLE == 0：BLE 组件不编译，仅留空实现（状态机/loop 调用点零改动）====
//   函数签名与启用版一致，只是什么都不做；bleOn/bleLink 恒为 false（/status 会如实回报）。
void startBLE() {}                                    // 占位：BLE 已停用
void stopBLE()  { bleOn = false; bleLink = false; }   // 占位：确保 /status 恒报 false
void bleProcessPending() {}                           // 占位：无 BLE 请求
void bleTxPump() {}                                   // 占位：无 BLE 发送
#endif

// ---- 状态机：需要就切，切换时先停对面的射频 ----
void updateWireless() {
  uint8_t want = wantWireless();
  if (want == curWireless) return;
  // 蓝牙「缓关」：切 WiFi 时先留着蓝牙几秒，把最后的推送（SSID/IP）发给网页再关
  if (curWireless == WL_BLE && want == WL_WIFI && bleHoldUntil &&
      (int32_t)(millis() - bleHoldUntil) < 0) return;
  PowerState ps = readPowerState();
  webLogln("📡 无线切换 %s → %s（%s/%s%s）",
           curWireless == WL_BLE ? "蓝牙" : (curWireless == WL_WIFI ? "WiFi" : "无"),
           want == WL_BLE ? "蓝牙" : (want == WL_WIFI ? "WiFi" : "无"),
           deviceMode == 1 ? "移动" : "固定",
           ps.onBattery ? "电池" : (ps.powered ? "外接" : "未知"),
           wlForce ? "·强制" : (wifiForced ? "·按钮" : ""));
  diag(String("无线切换 ") + (curWireless == WL_BLE ? "蓝牙" : curWireless == WL_WIFI ? "WiFi" : "无") +
       " → " + (want == WL_BLE ? "蓝牙" : want == WL_WIFI ? "WiFi" : "无") +
       (ps.onBattery ? "（电池）" : "（外接）"));
  if (want == WL_BLE) { stopAP(); wifiDown(); }
  else if (want == WL_OFF) { stopBLE(); wifiDown(); }   // V2.1 移动+电池：射频全关
  else { stopBLE(); }
  curWireless = want;
  // 状态一变立刻刷顶栏无线图标（不等周期刷新）：此刻 CPU 正好在这儿，几乎零成本
  uiDisplay.setWifi(curWireless == WL_BLE ? UI_WIFI_BLE : wifiUIState());   // 蓝牙态显示 BT
  uiDisplay.showTop(time(nullptr));
  delay(150);                                  // 让射频/协议栈稳一下再起另一个
  if (want == WL_BLE) startBLE();
  else if (want == WL_OFF) webLogln("📴 移动+电池：无线全关（按 IO9 临时开启）");
  else if (!apEnabled && WiFi.status() != WL_CONNECTED) wifiUp();   // 已连上/正开 AP 就别重连（连网会话里 loop 已先连好）
  else webLogln("🔀 WiFi 已在线，沿用现有连接");
}

// ---- 实体 WiFi 按钮（IO9）----
//   V2.1 语义：开无线 → STA 优先（连已存最强，失败再扫）；失败/无组 → 转 AP 配网热点
//   固定：按钮【无效】（状态机本来就是 WiFi/AP，动了只会让用户疑惑「网页怎么打不开」）
//   移动 + 电池：长按 ≥1.5s 才生效 → 先选「已保存且扫到的最强」连；连不上/无组 → 开 AP 配网
//     热点带超时（AP_SESSION_MS），到期或配网成功自动关，避免把电耗光
//   V2.1.1-a 新增：移动 + 插电 → 长按切「快充 / 慢充」（临时，仅本次充电有效，拔插即回快充）
//   【兜底】**长按 ≥5s 松手 → 强制开热点 + 断开 WiFi**（任何模式、任何供电都生效）
//     用途：设备连上了网但**够不着**（如静态 IP 学错网段）时自救 —— 走 AP 192.168.5.1 重新配网
//     顺带把该网络学到的「网关/掩码/DNS」清掉，否则重连还会用旧网段（详见下面的 wifiRecover()）
void wifiRecover(const char* why);          // 前向声明（定义在 startAPWithTimeout 附近）

void checkWifiButton() {
  static bool last = HIGH;
  static unsigned long downAt = 0;
  static bool recoverHinted = false;        // 本次按住是否已提示过「可进救援模式」
  bool now = digitalRead(PIN_WIFI_BTN);
  if (last == HIGH && now == LOW) { downAt = millis(); recoverHinted = false; }
  // 按住期间：满 WIFI_BTN_RECOVER_MS 提示一次（让用户知道松手会进救援模式）—— 救援仍是长按，防误触
  if (now == LOW && !recoverHinted && downAt && (millis() - downAt) >= WIFI_BTN_RECOVER_MS) {
    recoverHinted = true;
    uiDisplay.showToast(UI_TOAST_AP, "HOLD...", "松开 = 进 AP 救援", AP_IP_STR, 4000);
    webLogln("🔘 已按住 %.1fs：再松手将进入「AP 救援模式」（强制开热点、断 WiFi）",
             (millis() - downAt) / 1000.0);
  }
  if (last == LOW && now == HIGH) {
    unsigned long held = millis() - downAt;
    if (held >= WIFI_BTN_RECOVER_MS) {
      // ①【兜底】救援模式：优先级最高，任何模式/供电都生效（**保持长按**，防误触）
      wifiRecover("长按按钮");
    } else if (held >= WIFI_BTN_DEBOUNCE_MS && held <= WIFI_BTN_SHORT_MS) {
      // ② 常规动作：**短按**（v2.2 由长按改为短按）
      const char* how = "短按";
      if (deviceMode == 1 && isExternallyPowered()) {
        // 移动 + 插电 → 切快/慢充（临时、不持久化；拔插即回快充）
        chargeForceSlow = !chargeForceSlow;
        applyChargeStrategy(readPowerState());
        uiDisplay.showToast(UI_TOAST_OK, chargeForceSlow ? "SLOW CHG" : "FAST CHG", "", "", 3000);
        webLogln("🔘 按钮%s %lums：移动+插电 → 临时%s（仅本次充电，拔插回快充）",
                 how, held, chargeForceSlow ? "慢充~297mA" : "快充~890mA");
      } else if (deviceMode == 1) {                 // 移动 + 电池 → 开无线
        wifiBtnArmed = true;
        webLogln("🔘 按钮%s %lums：扫描并连接已保存的最强网络", how, held);
      } else {                                      // 固定 → 无效
        webLogln("🔘 按钮%s：固定模式本就是 WiFi/AP → 忽略（按住 ≥5s 可进 AP 救援模式）", how);
      }
    } else if (held < WIFI_BTN_DEBOUNCE_MS) {
      // 抖动，静默忽略
    } else {
      // 1.2~5s：犹豫按压，不触发任何动作（避免"长按没按够"被误判）
      webLogln("🔘 按钮按住 %.1fs：介于短按与救援之间，未触发动作（短按≤%.1fs / 救援≥%.1fs）",
               held / 1000.0, WIFI_BTN_SHORT_MS / 1000.0, WIFI_BTN_RECOVER_MS / 1000.0);
    }
  }
  last = now;
}
// ===================================================
const int INTERVAL_SEC = 30;
const int LOG_KEEP_DAYS = 14;      // 未插卡时 /log.csv 的保留天数（兜底裁头，见 trimLogOlderThan）
const int KEEP_IN_MEMORY = 600;
const int SD_CS = 7;          // v2.2：SD CS -> IO7

// ===== 电源/电池检测引脚（v2.2 板：全部换脚）=====
// BQ24074 的 PGOOD / CHG 都是【开漏输出、低有效】：
//   PGOOD: 低 = 有效外部电源已接入；高阻 = 无有效输入
//   CHG  : 低 = 充电中；高阻 = 充电完成/未接电源
// 故 ESP32 需用【内部上拉】，读取时为 !digitalRead()
const int PIN_PGOOD = 10;    // 开漏，低=外部电源正常（v2.2：IO2 -> IO10）
const int PIN_CHG   = 9;     // 开漏，低=充电中（v2.2：IO21 -> IO9）
// 注：原 PIN_BAT(IO9) 电池分压 ADC 方案已于 V2.1 删除（板上已无 1M 分压电阻），
//     电池电压唯一来源为 INA230；IO9 释放，留作实体 WiFi 按钮（见设计文档附录 A）。

// ===== 充电控制引脚（V2.1：由 ESP32 软件控制充电）=====
//   PIN_CE   → BQ24074 CE#（pin4）：低=允许充电；高=停止充电（CE 高有效禁用充电）
//   PIN_ISET → ISET 切换 MOS(AO3400A)栅极：高=快充(短路R7，等效 1k → ≈890mA)
//                                         低=慢充(1k+2k 串联 3k → ≈297mA)
// 注：BQ24074 的 EN1/EN2 **由 GPIO 软件控制**（IO11/IO12）；v2.1 的 3P 硬件跳线方案已作废
const int PIN_CE   = 13;      // v2.2：IO17 -> IO13（BQ24074 CE#，低=允许充电）
const int PIN_ISET = 17;      // v2.2：IO18 -> IO17（IO18 让给 TPS2117 PR1）
// ===== TPS2117 电源多路复用 PR1（v2.2 新增）=====
//   PR1 ≥ VREF(≈1 V) → 选 VIN1（电池直供）；PR1 低 → 选 VIN2（LDO 输出）
//   板上已加下拉 → 上电默认低 = LDO 供电（安全默认）；固件只在低压时"单向收紧"抬为高
const int PIN_PR1  = 18;      // v2.2：TPS2117 PR1（切换 LDO ⇄ 电池直供）
// ⚠️ BQ24074 的 EN1/EN2 在 v2.2 板接到 IO11/IO12；**本版固件暂不驱动**（保持引脚默认电平），
//    待 USB 枚举检测实装后再接管（见上方 USB_ENUM_DETECT 与 硬件核对清单 第五节清单 3）
const int PIN_EN1  = 11;
const int PIN_EN2  = 12;

// ===== 电池监测 INA230（v2.2：替代 IO9 分压；INA226 已弃用）=====
//   I2C 与传感器共用总线（IO47=SDA / IO48=SCL），地址 0x40（A0=A1=GND）
//   高边 10mΩ 采样电阻跨在 BQ24074@BAT 与电池正极之间，VIN+ 靠 BQ 侧
//     → 充电时电流为正、放电为负；VBUS 接 VIN-（电池侧）→ 读电池真实电压
//   驱动实现见同目录 ina230.h（放头文件可绕开 .ino 原型注入的自定义类型问题）
const int   INA230_ADDR      = 0x40;     // A0=A1=GND
const float INA230_R_SHUNT   = 0.010f;   // 采样电阻 10 mΩ
const float INA230_MAX_A     = 1.0f;     // 预期最大电流(A)，用于自动选 Current_LSB
const float CHARGE_QUICK_mA  = 890.0f;   // 移动模式快充设定
const float CHARGE_SLOW_mA   = 297.0f;   // 固定模式慢充设定
const float CV_ZONE_RATIO    = 0.60f;    // 电流 < 设定值×60% → 判为 CV 区
const float CV_VOLT_GATE     = 4.05f;    // 电压门限：低于此值不判 CV（防误报）
INA230 ina230;                           // INA230 驱动对象（ina230.h）
// deviceMode 定义在本文件靠后（设备模式，CV 判定要用），此处先声明
extern uint8_t deviceMode;

// ===== 低电保护阈值（设计文档三档；仅电池供电且 INA230 在线时判定）=====
// 插电(PGOOD低)   : 无条件记录，外部电源绝对充足
// INA230 离线      : 电压未知 → 低电门控整体作废（照常记录、不深睡），仅告警
// 电池 + INA230在线:
//   电压 ≥ 存档档  → 正常记录
//   停采档 ~ 存档档 → 存档数据至 SD
//   深睡档 ~ 停采档 → 停止采集
//   < 深睡档       → 深睡保护（保命：强制用户充电）
// ⚠️ V2.1.1-b 整体上移（原 3.3/3.25/3.2）：实测电池 <~3.4V 时 LDO 低压差输出能力暴跌，
//    设备会在旧阈值触发【之前】就硬掉电 → 旧三档实际从未生效过（详见设计文档 V2.1.1 · 2.7）。
// ===== V2.1.1「低电特性更新」：三档改成**跟着本机校准表走**（2026-09-29）=====
//   规格：有校准文件 → 三档取本机曲线的低电端（深睡 5% / 停采 10% / 存档 15%，各留 ≥50mV 余量）；
//         无表（或只有干跑表）→ 用下面的**回落值**。
//   动机：每台设备标的是自己那块电池 → 换 LDO / 换电容 / 板间差异**自动被本机曲线吸收**，
//         不必再按"最差板"定阈值（见 实现细节.md D20-5 ④、D9 ⑦③）。
//   ⚠️ 回落值保持 3.6/3.55/3.5 不动：与标定首跑实测（按表 15/10/5% −100mV ≈ 3.65/3.61/3.54）互相印证，
//      且与最早那批 Y5V 板的 LDO 崩溃点 ~3.4V 留了 100mV 余量。
const float BATT_ARCHIVE_SD_DEF = 3.60f;   // 回落值：存档数据至 SD 卡
const float BATT_STOP_RECORD_DEF = 3.55f;  // 回落值：停止采集
const float BATT_DEEP_SLEEP_DEF  = 3.50f;  // 回落值：进入深睡保护
const float BATT_SLEEP_MARGIN_V  = 0.100f; // 深睡档余量（表 5% 点再提前 100mV，避开 LDO 崩溃点）
// 生效值：开机由 updateBattThresholds() 按本机表刷新（初始 = 回落值，表未就绪时也用它）
float battArchiveV = BATT_ARCHIVE_SD_DEF;  // 低于此电压：存档数据至 SD 卡
float battStopV    = BATT_STOP_RECORD_DEF; // 低于此电压：停止采集
float battSleepV   = BATT_DEEP_SLEEP_DEF;  // 低于此电压：进入深睡保护

// ===================================================
// ===== V2.1.1-b 电量校准（放电曲线标定）=====
//   规格见 设计文档.md · V2.1.1 · 二、电量校准
//   流程：移动+插电+充满 → 记 V_100 → 拔电 → 占空比放电（满载 T_LOAD / 静置 T_REST 采样）
//         → 掉电 → 插电开机 → 建 21 点表 /battcal.json（旧表备份 /battcal.prev.json）
//   标定期间：停 HTTP 服务、停记录、停传感器、蓝牙不跑，屏幕为唯一界面；长按 IO9 中止
// ===================================================
#define CAL_OFF  0      // 未标定
#define CAL_ARM  1      // 已确认开始，等拔掉充电器（待放电）
#define CAL_RUN  2      // 放电循环中
#define CAL_STOP 3      // 已中止

// ---- 参数 ----
const uint32_t CAL_LOAD_MS      = 9UL * 60UL * 1000UL;   // 加载段（满载耗电）
const uint32_t CAL_LOAD_LOW_MS  = 60UL * 1000UL;         // 低压段加载（加密采样）
const uint32_t CAL_REST_MS      = 60UL * 1000UL;         // 静置段（静置采样）
const float    CAL_LOW_FROM_V   = 3.60f;                 // 低于此电压 → 用低压段时长（3.50→3.60：更早转短加载段，减少下探）
// ⚠️ 2026-10-03 用户裁定：3.00V → **3.20V**。
//   原因：3.00V 太贴地 —— 放电负载下电压还会下探，容易把电池压到**保护板切断**，
//         下次开机体验极差（实测：校准把电池放到 0.474V，设备"像坏了"）。
//   留 0.2V 余量后，校准结束时电池仍有可观的剩余电量。
const float    CAL_FLOOR_V      = 3.20f;                 // 硬底线：低于此电压立即收工
const uint32_t CAL_FULL_HOLD_MS = 5UL * 60UL * 1000UL;   // 充满判定：条件需持续
const float    CAL_FULL_MIN_V   = 4.10f;                 // 充满判定：电压下限
const uint8_t  CAL_DRY_CYCLES   = 6;                     // 干跑：跑够几轮就模拟掉电重启
const uint32_t CAL_DRY_LOAD_MS  = 20UL * 1000UL;         // 干跑加载段
const uint32_t CAL_DRY_REST_MS  = 10UL * 1000UL;         // 干跑静置段
const int      CAL_MAX_ROWS     = 256;                   // CSV 最多解析行数
const char*    CAL_CSV_PATH     = "/battcal.csv";
const char*    CAL_JSON_PATH    = "/battcal.json";
const char*    CAL_PREV_PATH    = "/battcal.prev.json";
// INA230 标定期平均窗口：512 × 2 × 8.244ms ≈ 8.4 s（覆盖静置窗口，稀释自身开销）
const Ina230Avg      CAL_AVG = INA230_AVG_512;
const Ina230ConvTime CAL_CT  = INA230_CT_8244US;

// ---- 运行态（全 RAM；标定全程在一个上电周期内完成，掉电即结束）----
uint8_t  calState       = CAL_OFF;
bool     calDry         = false;      // 干跑：缩短时长 + 保留网页 + 不要求充满
uint32_t calStartMs     = 0;          // 放电起始（wall，用于「已历时」）
uint32_t calLoadedMs    = 0;          // 累计「加载时长」= 时间轴 x（静置不计）
uint32_t calCycleLoadMs = 0;          // 本轮加载时长
uint8_t  calPhase       = 0;          // 0=加载 1=静置
uint32_t calCycles      = 0;
bool     calLoadBad     = false;      // 本加载段 WiFi 是否掉过线（第9列 load_ok 的来源）
uint32_t calUiNextMs    = 0;          // 下次刷屏时刻
float    calV100        = NAN;        // 100% 锚点（开始时电池侧无电流 = 电芯静置电压）
float    calVLoad = NAN, calVRest = NAN, calILoad = NAN, calIRest = NAN;
float    calLastVolt = NAN, calLastI = NAN;
float    calAmbTemp  = NAN;           // 标定开始时的一次性环境温度（标定期间不读传感器）
int      calLastPct     = -1;
uint32_t calFullStartMs = 0;          // 满电条件起始（0=当前不满足）

// ---- 曲线表（21 点：calPctV[0]=0% … calPctV[20]=100%）----
bool  calTableOk  = false;
bool  calTableDry = false;            // 干跑建的表：只用于查看，**不生效**
int   calTableN   = 0;
float calPctV[21];
float calTableV100 = NAN, calTableVEnd = NAN;
char  calTableDate[24] = "-";

WiFiUDP calUdp;                       // 标定负载用的 UDP（只在标定时发）

// 读取电源状态
// 读取电源状态
//   电池电压/电流唯一来源 = INA230（原 IO9 分压 ADC 方案已随 V2.1 删除）。
//   INA230 离线时：battVolt = NAN、battPct = 0、inaOK = false，
//   上层据此【作废】低电保护与电量显示，改为告警 —— 不得按 0V 误判。
PowerState readPowerState() {
  PowerState ps = {};
  // 开漏输出：接内部上拉，正常态应读到低
  pinMode(PIN_PGOOD, INPUT_PULLUP);
  pinMode(PIN_CHG,   INPUT_PULLUP);
  ps.powered   = (digitalRead(PIN_PGOOD) == LOW);   // 低=有外部电源
  ps.charging  = (digitalRead(PIN_CHG)   == LOW);   // 低=充电中
  ps.onBattery = !ps.powered;

  ps.inaOK          = false;
  ps.battVolt       = NAN;      // 未知（INA230 在线时下面覆盖）
  ps.battPct        = 0;
  ps.battCurrent_mA = 0;
  ps.battPower_mW   = 0;
  ps.cvZone         = false;

  // 电池电压/电流：仅 INA230（不再有分压回退）
  if (ina230.ok()) {
    Ina230Reading ir;
    if (ina230.read(ir)) {
      ps.inaOK          = true;
      ps.battVolt       = ir.busVolt_V;      // 电池真实对地电压（VBUS 接 VIN-）
      ps.battCurrent_mA = ir.current_mA;     // 充电为正 / 放电为负
      ps.battPower_mW   = ir.power_mW;
      // CV 区判定：正在充电 + 电压已高 + 电流跌到设定值的 60% 以下
      float set_mA = (deviceMode == 1) ? CHARGE_QUICK_mA : CHARGE_SLOW_mA;
      if (ps.charging && ps.battVolt >= CV_VOLT_GATE && set_mA > 0 &&
          fabsf(ps.battCurrent_mA) < set_mA * CV_ZONE_RATIO) {
        ps.cvZone = true;
      }
    }
  }
  if (ps.inaOK) {
    // 电量：优先用标定曲线（V2.1.1-b，21 点插值）；无表或干跑表 → 退回线性估算
    //   线性估算下限定为 3.4V（LDO 崩溃点）：3.4V 以下的电量对设备无意义
    if (calTableOk && !calTableDry) {
      ps.battPct = calPctFromVolt(ps.battVolt);
    } else {
      float vmin = 3.4f, vmax = 4.2f;
      if (ps.battVolt >= vmax) ps.battPct = 100;
      else if (ps.battVolt <= vmin) ps.battPct = 0;
      else ps.battPct = (uint8_t)((ps.battVolt - vmin) / (vmax - vmin) * 100);
    }
  }
  return ps;
}

// 是否插着外部电源（PGOOD 低有效）。包装成 bool 函数：供前面的蓝牙配网代码调用，
// 避开 “早于 PIN_PGOOD 定义” 与 “.ino 原型注入自定义类型” 两个坑。
bool isExternallyPowered() { return digitalRead(PIN_PGOOD) == LOW; }

// ==================== 充电控制底层原语（BQ24074 CE# + ISET 切换 MOS）====================
// 硬件（V2.1）：
//   IO17 → BQ24074 CE#     ：低=允许充电；高=停止充电
//   IO18 → ISET 切换 MOS 栅极：高=快充(短路R7 → 等效 1k → ≈890mA)
//                              低=慢充(1k+2k 串联 → 3k → ≈297mA)
// 说明：本层只提供「底层原语」。固定/移动模式切换、80% 停充策略后续在此之上实现，
//       调用方只需 chargeSetCurrent() / chargeSetEnabled()，不直接碰 IO 电平。
// 充电使能与「充电中」状态区别：CE 是“允许/禁止充电”，CHG 是“当前是否在充电”。
// ===== 冷启动判据（2026-10-03）=====
//   设备封装后电池永不拔除 → **冷启动只可能是"电池没电"**；
//   另一种是用户拨 EN 开关（此时电池通常有电）。
//   故按 VBAT 分流：< 3.6V 视为冷启动（优先起系统），≥ 3.6V 走常规快启动。
//   用户定 3.6V：取得太保守会让"拨 EN 开机"的体验变差。
#define PWR_COLD_START_V  3.5f   // 用户裁定 3.6→3.5（读数时机改到空载后，实测空载 3.8V 与带载 3.49V 差异已消除）

// ===== 实测结论：USB500 下能否充电？（2026-10-03 实验，已定论）=====
//   【结论：**可以充，而且速度可观**】
//   实验条件：插电脑 USB 主机（判定 host）→ USB500(500mA) + 允许充电 + 快充档
//   实测数据：充电电流 **+425 mA 稳定**，电池电压 3.59V → 3.64V（持续爬升），
//             18 个采样点无复位、无失联。
//
//   ⚠️ 早先曾测得 -1.0mA 并据此写死 false —— **那个数据是错的**：
//      当时 TS 脚还是 2 kΩ（芯片判"过热"停充），测到的是 TS 故障，不是"USB500 不够"。
//      教训：**测量条件有已知故障时，数据不能当结论。**
//
//   正确模型（BQ24074 电源路径管理）：
//     系统**优先从输入(USB)取电**，剩余电流才进电池。
//     500 mA 上限下：系统约用 75 mA，剩 ≈425 mA 给电池充电。
//     ——而非"系统把 500 mA 吃满、电池拿不到"。
//
//   ⇒ 故：**USB 主机下允许充电**（插电脑就能充，体验更好）。
//      充电器（ISET 档，约 1.3 A）会更快。
const bool usbChargingViable = true;

// ===== USB 枚举状态（由 serviceUsbEnum 判定）=====
uint8_t usbEnumState   = ENUM_UNKNOWN;   // ENUM_UNKNOWN / ENUM_IS_HOST / ENUM_IS_CHARGER
bool    usbAllowCharge = false;          // 是否允许充电（枚举成功才允许）

// 读 USB-Serial-JTAG 的 SOF 帧号（低 11 位）
static inline uint32_t usbReadSofFrame() {
  return (*(volatile uint32_t*)USB_JTAG_FRAM_NUM) & USB_SOF_FRAME_MASK;
}

// ---- USB 枚举检测：观察 SOF 帧号是否在变化 ----
//   返回 true = 对端是 USB 主机（帧号在动）；false = 充电器/无主机（帧号静止）
bool usbDetectHost(uint32_t windowMs = ENUM_WINDOW_MS) {
  volatile uint32_t* clr = (volatile uint32_t*)USB_JTAG_INT_CLR;
  *clr = 0xFFFFFFFFUL;                       // 清掉历史 SOF 中断，从干净状态开始
  delay(5);

  uint32_t f0 = usbReadSofFrame();
  uint32_t start = millis();
  while (millis() - start < windowMs) {
    delay(200);
    if (usbReadSofFrame() != f0) return true;   // 只要动过一次就判定为主机
  }
  return false;
}

// ---- 启动后调用一次：判定电源类型并据此设定 BQ24074 档位 ----
void serviceUsbEnum() {
  if (usbEnumState != ENUM_UNKNOWN) return;      // 只判定一次

  bool ext = isExternallyPowered();
  uint32_t a = usbReadSofFrame();
  delay(250);
  uint32_t b = usbReadSofFrame();
  bool sofMoving = (a != b);

  if (ext && sofMoving) {
    // ===== USB 主机（电脑）=====
    usbEnumState   = ENUM_IS_HOST;
    usbAllowCharge = usbChargingViable;           // 由实测决定（见 usbChargingViable）
    //   ⚠️ 冷启动（电池没电）不否决枚举结果：若日后实测 USB500 下可充，
    //      这里会自然生效；冷启动只影响"启动期先不充、把电流让给系统"。
    // 保持 EN1=高 / EN2=低 = USB500（已在 chargeInit 设好）
    webLog("🔎 USB 枚举：**主机**（SOF 帧号 %lu→%lu 在动）→ 保持 USB500(500mA)，%s\n",
           (unsigned long)a, (unsigned long)b, usbAllowCharge ? "允许充电" : "**禁止充电**");
  } else if (ext) {
    // ===== 充电器（无 SOF）=====
    usbEnumState   = ENUM_IS_CHARGER;
    usbAllowCharge = true;
    pinMode(PIN_EN1, OUTPUT); pinMode(PIN_EN2, OUTPUT);
    digitalWrite(PIN_EN1, LOW);
    digitalWrite(PIN_EN2, HIGH);                  // (EN1,EN2)=(0,1) = ISET 档（ILIM 电阻设定，约 1.3A）
    digitalWrite(PIN_EN1, LOW); digitalWrite(PIN_EN2, HIGH);
    webLog("🔎 USB 枚举：**充电器**（SOF 帧号 %lu 静止）→ 切 ISET 档(ILIM)，允许充电\n",
           (unsigned long)b);
  } else {
    // ===== 纯电池（无外接电源）=====
    usbEnumState   = ENUM_IS_CHARGER;             // 视作"非主机"，不涉及 EN1/EN2
    usbAllowCharge = false;
    webLogln("🔎 USB 枚举：无外接电源（纯电池）→ 不涉及 EN1/EN2");
  }

  if (usbAllowCharge) digitalWrite(PIN_CE, LOW);   // 放行充电
  else                digitalWrite(PIN_CE, HIGH);  // 锁死禁充
}
// 读一次电池电压（INA230）；无效返回 NAN。
//   ⚠️ 必须在 ina230.begin() 之后调用。
static float readBatteryVoltage() {
  if (!ina230.ok()) return NAN;
  Ina230Reading r;
  if (!ina230.read(r)) return NAN;
  return r.busVolt_V;
}

// ===== 冷启动 / 热启动 分流（2026-10-03 实装 · 设计文档 V2.2 电源管理模块）=====
//   设备封装后电池永不拔除 ⇒ **冷启动只可能是"电池没电"**；
//   另一种上电是用户拨 EN 开关（此时电池通常有电）。
//   故按 VBAT 分流（阈值 PWR_COLD_START_V = 3.6V，用户定 —— 取得太保守会让拨 EN 开机体验变差）：
//     VBAT >= 3.6V → 【热启动】沿用老逻辑：允许充电，档位按 deviceMode 走
//     VBAT <  3.6V → 【冷启动】保持禁充（系统优先起），充电交由 serviceUsbEnum() 定
//   ⚠️ 调用时机：**必须在 INA230 初始化之后**（chargeInit 太早，那时读不到电压）。
bool pwrColdStart = false;      // true = 本次为冷启动
bool pwrStartupDone = false;    // 是否已分流
bool pwrStartupChargeOk = false;// 热启动时置 true → 启动期即可充电

void serviceBatteryStartup() {
  if (pwrStartupDone) return;
  pwrStartupDone = true;

  float v = readBatteryVoltage();
  if (isnan(v)) {
    // 读不到电压 → 无法判断 → 按**冷启动**保守处理（宁慢不错）
    pwrColdStart = true;
    webLogln("🔋 启动分流：电池电压不可读 → 按【冷启动】保守处理（保持禁充，待枚举）");
    return;
  }

  if (v >= PWR_COLD_START_V) {
    pwrColdStart = false;
    pwrStartupChargeOk = true;
    usbAllowCharge = true;      // 热启动：电池有电 → 提前放行充电（用户无感）
                                //   之后 serviceUsbEnum() 若判定为 USB 主机，会按实测结论收回
    webLog("🔋 启动分流：VBAT=%.3fV ≥ %.1fV → 【热启动】（拨 EN 开机）→ 沿用老逻辑，允许充电\n",
           v, PWR_COLD_START_V);
  } else {
    pwrColdStart = true;
    pwrStartupChargeOk = false;
    webLog("🔋 启动分流：VBAT=%.3fV < %.1fV → 【冷启动】（电池没电）→ 保持禁充，系统优先启动\n",
           v, PWR_COLD_START_V);
  }
}
void chargeInit() {
  // 上电安全默认。
  // ⚠️ 顺序很关键：必须先 pinMode(OUTPUT) 再 digitalWrite。
  //    实测（ESP32 core 3.3.11 / S3）：软复位（ESP.restart）后，
  //    「先 digitalWrite 再 pinMode」不会真正拉低引脚，引脚会保留上一次会话的电平——
  //    曾观测到预置快充态重启后仍读到 IO18=1，对固定"必须慢充"是隐患。
  //    改为先设方向再写电平，并末尾复写一次兜底。
  pinMode(PIN_ISET, OUTPUT);
  pinMode(PIN_CE, OUTPUT);
  digitalWrite(PIN_ISET, LOW);   // MOS 关断 → 慢充档

  // ---- BQ24074 输入限流：**必须先抬到 USB500，早于 WiFi 初始化** ----
  //   手册真值表：(EN1,EN2)=(0,0)100mA / (1,0)USB500(500mA) / (0,1)ISET档(ILIM 电阻设定)
  //   为什么必须早：ROM/固件早期与 WiFi 初始化都有电流峰值，
  //   若等到枚举之后才抬，系统可能已经在枚举阶段掉压复位（实测教训）。
  //   500mA 是 USB 规范安全值：即便插在仅能出 500mA 的电脑口也不会过载。
  pinMode(PIN_EN1, OUTPUT);
  pinMode(PIN_EN2, OUTPUT);
  digitalWrite(PIN_EN1, HIGH);
  digitalWrite(PIN_EN2, LOW);     // → USB500
  digitalWrite(PIN_EN1, HIGH);    // 兜底复写
  digitalWrite(PIN_EN2, LOW);

  // ---- 充电使能：启动期一律**先禁充**（系统优先），由 serviceUsbEnum 事后放行 ----
  //   理由：供电受限时充电会和系统抢同一份输入电流；系统起不来就没有后续可言。
#if PWR_SAFE_START
  // 【安全启动】CE 先保持**高（禁充）**，把输入电流全留给系统。
  //   之后由两处按运行期条件放行：
  //     · serviceBatteryStartup()：热启动（VBAT>=3.6V）→ 直接放行（沿用老逻辑，用户无感）
  //     · serviceUsbEnum()      ：判定为充电器 → 放行；判定为 USB 主机 → 保持禁充
  digitalWrite(PIN_CE, HIGH);
  webLogln("🔌 【安全启动】输入限流=USB500(500mA) | CE=高(禁充，待分流/枚举后再定)");
#else
  digitalWrite(PIN_CE, LOW);      // 老逻辑：允许充电（且 EN1/EN2 不驱动 → 保持上电默认 USB100）
  webLogln("🔌 充电控制初始态：允许充电 | 输入限流 = 上电默认 (0,0)=USB100");
#endif
  digitalWrite(PIN_ISET, LOW);    // 兜底复写

  // ===== TPS2117 PR1 上电安全默认（v2.2 新增）=====
  //   ⛔ **必须最先拉低**：PR1 低 → 选 VIN2(LDO 3.3V)；PR1 高 → 选 VIN1(电池直供)。
  //      模组 VDD33 绝对最大 3.6 V，而电池满电 4.2 V → 若上电瞬间选中 VIN1，
  //      **超出绝对最大值，永久损坏芯片**（依据：硬件核对清单 第三节 ②）。
  //   ⚠️ 同样遵守"先 pinMode 再 digitalWrite"的顺序（见上面软复位实测教训）。
  //   板上已有下拉给出安全默认，这里再显式拉低一次做双保险。
  pinMode(PIN_PR1, OUTPUT);
  digitalWrite(PIN_PR1, LOW);
  digitalWrite(PIN_PR1, LOW);    // 兜底复写
}

// 电流档：fast=true → 快充(~890mA)；false → 慢充(~297mA)
void chargeSetCurrent(bool fast) { digitalWrite(PIN_ISET, fast ? HIGH : LOW); }
// 当前是否为快充档
bool chargeIsFast()              { return digitalRead(PIN_ISET) == HIGH; }

// 充电使能：en=true → 允许充电(CE低)；false → 停止充电(CE高)
void chargeSetEnabled(bool en)   { digitalWrite(PIN_CE, en ? LOW : HIGH); }
// 当前是否允许充电
bool chargeIsEnabled()           { return digitalRead(PIN_CE) == LOW; }

// 当前档位对应的设定电流(mA)，供 INA230 闭环校验 / CV 判定使用
float chargeSetpoint_mA()        { return chargeIsFast() ? CHARGE_QUICK_mA : CHARGE_SLOW_mA; }

// ===== 设备模式 → 充电策略（设计文档 V2.1 · 充电策略）=====
//   固定(0)：慢充 + 80% 停充（CE 拉高）；滞回「≥4.05V 停 / ≤4.00V 恢复」→ 约 80% 浮充
//   移动(1)：快充 + 充满（CE 保持低，由 BQ24074 硬件终止到 4.2V）
// 说明：CE 拉高只停「充电」，不切断电池补充(UPS)通路，停充期间照常供电/记录。
//       INA230 离线时无法判电压 → 一律允许充电（fail-safe），仅告警一次。
const float FIX_STOP_V   = 4.05f;   // 固定停充点（≈80%）
const float FIX_RESUME_V = 4.00f;   // 固定恢复点（滞回下沿）
bool fixChargeBlocked = false;      // true = 固定已停充（CE 高）
// --- V2.1.1-a：移动模式下的「临时慢充」（IO9 在【移动 + 插电】时切换）---
//   不持久化（RAM 标志，不写 NVS）；一断电即复位（拔插回来 = 默认快充），见 serviceChargeTemp()。
bool chargeForceSlow = false;        // true = 本次充电临时用慢充（~297mA）

// ===== TPS2117 PR1 电池直供互锁（v2.2 新增）=====
//   目的：电池电压过低时绕过 LDO 让电池直供，把可用下限从 ~3.5V 压到 ~3.0V。
//
//   ⛔⛔ **安全红线（违反 = 永久损坏硬件）** ⛔⛔
//     模组 VDD33 绝对最大 **3.6 V**（S3 手册表 9）；电池满电 **4.2 V**。
//     PR1 高 = 选 VIN1（电池直供）→ 满电时会把 4.2 V 直接灌进模组 → **烧毁**。
//     故：**VBAT > 3.6 V 时，任何代码路径都不得把 PR1 拉高。**
//
//   阈值与滞回（依据：硬件核对清单 第四节 + 第五节清单 4）：
//     VBAT < 3.4 V          → 允许 PR1 高（切电池直供）
//     VBAT ≥ 3.5 V          → 回 PR1 低（回 LDO）
//     VBAT > 3.6 V          → ⛔ 一律禁止拉高（硬约束，优先于其他一切条件）
//     INA230 离线/读数无效   → 保持 PR1 低（fail-safe：宁可早关机，也不灌 4.2V 进模组）
//
//   ⚠️ 默认态 PR1 低 = LDO 安全；板上另有下拉作硬件默认。
const float PR1_ON_V      = 3.40f;   // 低于此值才允许切电池直供
const float PR1_OFF_V     = 3.50f;   // 回到此值以上切回 LDO
const float PR1_HARD_MAX  = 3.60f;   // ⛔ 超过此值一律禁止拉高（绝对最大 3.6V）
const float PR1_VALID_MIN  = 2.00f;   // 低于此值视为读数无效（未接电池/传感器故障）
//   低电深睡用的"读数合理性"下限：0V ≈ 电池被拔/未接，绝不能据此深睡（会醒不过来）
const float LOWBAT_SANE_MIN_V = 0.50f;
const float PR1_VALID_MAX = 4.50f;   // 高于此值视为读数无效

bool pr1BatteryDirect = false;       // true = 当前选了 VIN1（电池直供）

//   上电宽限期：这段时间内一律保持 LDO，让电源轨稳定、读数可信
const unsigned long PR1_GRACE_MS = 60000UL;   // 60 秒

void pr1SetDirect(bool direct, float vbat) {
  // ⛔ 最后一道保险：拉高之前再验一次电压。任何情况下都不许在高压时切直供。
  if (direct && vbat > PR1_HARD_MAX) {
    webLog("⛔ PR1 拒绝拉高：VBAT=%.3fV > %.2fV（绝对最大 3.6V，拉了会烧模组）\n",
           vbat, PR1_HARD_MAX);
    return;                                   // 保持现状（低 = LDO）
  }
  digitalWrite(PIN_PR1, direct ? HIGH : LOW);
  if (direct != pr1BatteryDirect) {
    pr1BatteryDirect = direct;
    webLog("🔀 PR1 → %s（VBAT=%.3fV）\n",
           direct ? "VIN1 电池直供" : "VIN2 LDO", vbat);
  }
}

void servicePr1Interlock(const PowerState& p) {
  // ★ 守卫 0：上电宽限期 —— 电源未稳、读数不可信，一律保持 LDO
  if (millis() < PR1_GRACE_MS) { if (pr1BatteryDirect) pr1SetDirect(false, p.battVolt);
                                 else digitalWrite(PIN_PR1, LOW); return; }

  // ★ 守卫 1（2026-10-03 加固）：**外接电源在位时绝不切电池直供**
  //   用户指出：插着电去旁路 LDO 毫无意义 —— 旁路的意义只在电池供电时榨续航。
  //   且拔插电池时 PGOOD 会瞬变，若此刻结合一个低电压读数就会误切 → 设备瞬间断电。
  //   双重判据（PGOOD + 内部状态），且读数与状态自相矛盾时按"有外接电源"处理（保守）。
  bool extPower = p.powered || isExternallyPowered()
                  || (p.charging && !isnan(p.battVolt) && p.battVolt > PR1_OFF_V);
  if (extPower) {
    if (pr1BatteryDirect) {
      pr1SetDirect(false, p.battVolt);
      webLogln("🛡️ PR1 回 LDO：检测到外部电源（插电时不旁路 LDO）");
    } else {
      digitalWrite(PIN_PR1, LOW);
    }
    return;
  }

  // 1) 读数有效性：无效 → 保持/回到 LDO（fail-safe）
  bool vValid = p.inaOK && p.battVolt > PR1_VALID_MIN && p.battVolt < PR1_VALID_MAX;
  if (!vValid) {
    static unsigned long lastWarn = 0;
    if (pr1BatteryDirect) pr1SetDirect(false, p.battVolt);
    else digitalWrite(PIN_PR1, LOW);           // 确保低（即使状态变量没变也复写一次）
    if (millis() - lastWarn > 300000UL) {      // 5 分钟限流，避免刷屏
      lastWarn = millis();
      webLogln("🛡️ PR1 保持 LDO：电池电压读数无效（INA 离线或超出 2.0~4.5V）");
    }
    return;
  }

  // 2) 电压过高 → 强制回 LDO（**这条就是防烧板子的关键分支**）
  if (p.battVolt > PR1_HARD_MAX) {
    if (pr1BatteryDirect) {
      pr1SetDirect(false, p.battVolt);
      webLog("🛡️ PR1 强制回 LDO：VBAT=%.3fV 高于硬上限 %.2fV\n", p.battVolt, PR1_HARD_MAX);
    } else {
      digitalWrite(PIN_PR1, LOW);              // 常态：复写低，零风险
    }
    return;
  }

  // 3) 正常滞回区间（此时必然 VBAT ≤ 3.60V，切直供是安全的）
  if (!pr1BatteryDirect && p.battVolt < PR1_ON_V) {
    pr1SetDirect(true, p.battVolt);            // 低压 → 切电池直供
  } else if (pr1BatteryDirect && p.battVolt >= PR1_OFF_V) {
    pr1SetDirect(false, p.battVolt);           // 电压回升 → 回 LDO
  }
}

void applyChargeStrategy(const PowerState& ps) {
#if PWR_SAFE_START
  // ★ 安全启动模式下，**充电使能由 usbAllowCharge 决定**（运行期变量）。
  //   ⛔ 这里**必须用运行期 if，不能用 #if** ——
  //      #if 是编译期求值，会把运行期变量当成 0，导致条件恒真、
  //      永远走"禁充 + return"，把 serviceUsbEnum() 拉低的 CE 又拉回去。
  //      （2026-10-03 实测踩到：插充电器时 allowCharge=true 但 chgEnabled=false）
  // ★ 充电使能**由枚举结果决定**（usbAllowCharge）。
  //   冷/热启动只影响"启动期是否提前充电"，不影响运行期充电权：
  //     热启动 → serviceBatteryStartup() 提前把 usbAllowCharge 置 true（用户无感）
  //     冷启动 → 保持禁充，等 serviceUsbEnum() 判完再说（充电器仍会允许充电）
  if (!usbAllowCharge) {
    digitalWrite(PIN_CE, HIGH);      // 未获准充电 → 锁死禁充
    return;
  }
#endif
  // 1) 电流档位随模式切换（仅在变化时打印，避免日志刷屏）
  //    V2.1.1-a：移动默认快充；移动+插电时按 IO9 可临时切慢充（chargeForceSlow，拔插即失效）
  bool wantFast = (deviceMode == 1) && !chargeForceSlow;
  if (chargeIsFast() != wantFast) {
    chargeSetCurrent(wantFast);
    webLog("⚡ 充电档位 -> %s（%s）\n", wantFast ? "快充~890mA" : "慢充~297mA",
           deviceMode != 1 ? "固定FIX" : (chargeForceSlow ? "移动·临时慢充" : "移动MOV"));
  }

  // 2) 停充点
  if (deviceMode == 1) {                       // 移动：允许充电，充满由 BQ 硬件终止
    if (fixChargeBlocked || !chargeIsEnabled()) {
      fixChargeBlocked = false;
      chargeSetEnabled(true);
      webLogln("🔌 移动模式：允许充电（硬件终止于 4.2V 满）");
    }
    return;
  }
  if (!ps.inaOK) {                             // 固定 + INA 离线：无法判定 → 允许充电
    static bool warnedFixNoIna = false;
    if (!warnedFixNoIna) {
      webLogln("⚠️ INA230 离线：无法判定固定 80% 停充点，暂按「允许充电」处理");
      warnedFixNoIna = true;
    }
    if (fixChargeBlocked || !chargeIsEnabled()) { fixChargeBlocked = false; chargeSetEnabled(true); }
    return;
  }
  if (!fixChargeBlocked && ps.battVolt >= FIX_STOP_V) {
    fixChargeBlocked = true;
    chargeSetEnabled(false);                   // CE 高 → 停充
    webLog("🛡️ 固定：电池 %.2fV ≥ %.2fV（≈80%%）→ 停充，保护电池寿命\n", ps.battVolt, FIX_STOP_V);
  } else if (fixChargeBlocked && ps.battVolt <= FIX_RESUME_V) {
    fixChargeBlocked = false;
    chargeSetEnabled(true);                    // CE 低 → 恢复充电
    webLog("🔋 固定：电池 %.2fV ≤ %.2fV → 恢复充电\n", ps.battVolt, FIX_RESUME_V);
  }
}

// V2.1.1-a：临时慢充只活在「插电期间」—— 一断电（拔线/掉电）立即复位，再插回来就是默认快充。
//   loop() 每圈调用（一次 digitalRead，极廉价）；未切慢充时直接返回。
void serviceChargeTemp() {
  if (!chargeForceSlow) return;                       // 常态：零开销
  if (!isExternallyPowered()) {                       // 外部电源已断开 → 复位
    chargeForceSlow = false;
    applyChargeStrategy(readPowerState());
    webLogln("🔌 外部电源断开 → 临时慢充复位（再插回默认快充）");
  }
}

// ===== 低电深睡保护 + 插电唤醒 =====
// 场景：电池供电且电压 < 3.5V → 深睡（保命，防止电压不足时写SD/Flash损坏数据）。
// 唤醒源：用 PGOOD(IO2) 做 ext0 唤醒 —— 插电时 PGOOD 被拉低(低电平) → 唤醒设备。
//        因此“插电即唤醒并恢复记录”，无需按键。
// 注意：进深睡前先把内存数据同步到 SD(避免丢数据)，再关闭 WiFi。
void enterDeepSleepIfNeeded() {
  // 1. 最后一次同步内存数据到 SD（防止深睡丢数据；写失败也无所谓）
  webLogln("😴 电量过低，进入深睡保护，请插上电源唤醒...");
  // flush 需要的数据：把当前 buffer 落盘（logData 已实时写 /log.csv，这里再归档一次保底）
  // 若已到归档时机则正常归档
  archivePump();       // 归档分片泵：每圈最多 40 行，**不阻塞采样**（2026-10-02）
  checkAndArchive();
  delay(100);

  // 2. 关闭 WiFi / AP（深睡下射频无需保活）
  WiFi.disconnect(true);
  WiFi.mode(WIFI_OFF);
  delay(50);

  // 3. 配置唤醒源：PGOOD 低电平唤醒（插电）
  //    ⚠️ 2026-10-03 修复：原写死 `GPIO_NUM_2`（PGOOD 的**旧脚**）。
  //       v2.2 引脚迁移后 PGOOD = IO10，而这一行没跟着改 →
  //       **设备一旦深睡就监听一个空脚，永远醒不过来**（实测：拔电池黑屏后插 USB 无反应）。
  //       现在改用 `PIN_PGOOD` 宏，引脚迁移时不会再漏。
  //    ext0 唤醒要求 GPIO 属于 RTC 域且支持深睡唤醒；IO10 可作 RTC GPIO。
  //    注意：此内核版本(3.3.9-cn)里第二个参数用数字电平(0=低电平触发)，不是枚举名。
  esp_sleep_enable_ext0_wakeup((gpio_num_t)PIN_PGOOD, 0);   // 0 = 低电平触发唤醒

  // 4. 进入深睡
  esp_deep_sleep_start();   // 不会返回，直到被唤醒（调用后重启，从 setup() 重新开始）
}

// ===== 日平均引擎 =====
#define AVG_SLOTS 2880            // 30秒一格 × 24h = 2880 槽
#define AVG_WINDOW_DAYS 30        // 30天滑动窗口（含季节特征）
#define AVG_DIR "/avg"           // 每日均值 bin 存放目录
// ======================

// ===== 绝对湿度换算（V2.1.1 · 全项目唯一口径）=====
//   为什么：相对湿度(RH)会随温度摆动 —— 温度升高时 RH 自动下降,哪怕水汽一点没变。
//   所以"湿度变率"用 RH 会误导;绝对湿度(AH = 水汽质量浓度)才是水汽的真实增减。
//   ⚠️ 本函数是**唯一**口径：网页曲线 / 网页 24h 变率 / 屏幕 24h 变率 三处都调它。
//      三处各自实现必然分叉 —— 同一天同一个数会在三个地方不一样。
//   公式（Magnus/Tetens 饱和水汽压 + 理想气体换算）：
//     es(T) = 6.112 · exp(17.67·T / (T + 243.5))          [hPa]
//     AH    = 216.7 · (RH/100) · es(T) / (T + 273.15)     [g/m³]
//   自检：T=25°C / RH=50% → 11.5 g/m³
//   任一入参 NaN → 返回 NAN（下游一律按"无数据"处理,不造虚拟值）
float absHumidity(float tC, float rh) {
  if (isnan(tC) || isnan(rh)) return NAN;
  float es = 6.112f * expf(17.67f * tC / (tC + 243.5f));
  return 216.7f * (rh / 100.0f) * es / (tC + 273.15f);
}
// ==================================================

// ===== 整点变率环（24h，三要素，仅 RAM，不落盘）=====
//   下标 = 小时(0..23)，槽内存放「上一个同整点」的值
//   变率 = 当前整点值 − 槽内旧值（即 24h 前同一整点）
//   湿度那一档用**绝对湿度**：由槽内原始 T/RH 现算（absHumidity），
//   环里仍存原始 T/RH → **环的结构与落盘格式不变**
//   掉电仅因电池耗尽的场合才会丢失；重启后需重新积累 24h 才有变率
struct HourSlot {
  float t, h, p;
  bool  valid;
};
HourSlot hourRing[24] = {};
float trendT24 = NAN, trendH24 = NAN, trendP24 = NAN;   // 最近整点算出的 24h 变率
// ==================================================

// ==================== 传感器对象 ====================
Adafruit_BMP5xx bmp;
Adafruit_SHT31 sht;
RTC_DS3231 rtc;

// ==================================================

WebServer server(80);
unsigned long recordCount = 0;
bool bmpOK = false, shtOK = false;
bool sdOK = false, rtcOK = false;
bool rtcLostPower = false;   // DS3231 是否掉过电（掉电则时间不可信，需 NTP）
bool timeSynced = false;
bool hasSyncedOnce = false;

struct DataPoint {
  uint32_t time;
  float temp;
  float humidity;
  float pressure;
};

// ===== 日平均引擎数据结构（全部放 PSRAM） =====
struct AvgSlot {
  float sumT, sumH, sumP;
  uint16_t cnt;            // 参与天数
};
struct ExtremeValue {
  float v; uint32_t t; bool set;
};
struct DayExtremes {
  ExtremeValue tempMax, tempMin, humMax, humMin, presMax, presMin;
  char date[11];
};

AvgSlot* avgSlots = NULL;      // 30天窗口历史累计 (34.5KB)
AvgSlot* todaySlots = NULL;    // 今日实时累计   (34.5KB)
DayExtremes todayExt;
bool apEnabled = false;        // AP 当前是否开启
unsigned long apClosedMs = 0;  // AP 关闭时间（断线计时用）
// ================================================

DataPoint* buffer = NULL;
int bufferHead = 0, bufferSize = 0, bufferCapacity = 0;
int dayMarkIndex = -1;
bool fileBusy = false;
time_t lastCollectTime = 0;
unsigned long fallbackLastMs = 0;

// ========== 归档追踪 ==========
int archivedMonth = -1, archivedDay = -1;

// ========== 卡尔曼滤波 ==========
struct KalmanFilter {
  float Q, R, P, K, X;
  bool initialized;
  KalmanFilter(float q = 0.01, float r = 0.1) {
    Q = q; R = r; P = 1.0; K = 0.0; X = 0.0; initialized = false;
  }
  float update(float measurement) {
    if (!initialized) { X = measurement; P = 1.0; initialized = true; return X; }
    P = P + Q; K = P / (P + R);
    X = X + K * (measurement - X);
    P = (1 - K) * P; return X;
  }
  void reset() { initialized = false; P = 1.0; }
};

void applyFilterToData(DataPoint* data, int count, bool resetFilter = true) {
  if (!data || count <= 0) return;
  static KalmanFilter tempFilter(0.05, 0.15);
  static KalmanFilter humFilter(0.1, 0.2);
  static KalmanFilter presFilter(0.02, 0.1);
  if (resetFilter) {
    tempFilter = KalmanFilter(0.05, 0.15);
    humFilter = KalmanFilter(0.1, 0.2);
    presFilter = KalmanFilter(0.02, 0.1);
  }
  for (int i = 0; i < count; i++) {
    if (!isnan(data[i].temp))     data[i].temp     = tempFilter.update(data[i].temp);
    if (!isnan(data[i].humidity)) data[i].humidity = humFilter.update(data[i].humidity);
    if (!isnan(data[i].pressure)) data[i].pressure = presFilter.update(data[i].pressure);
  }
}

// ========== 文件操作 ==========
// 写盘失败的可见化：以前是静默 return false，出问题时网页/下载看起来一切正常（实测踩到）
void warnAppendFail(bool openFail) {
  static bool warned = false;
  if (warned) return;
  warned = true;
  webLogln("⚠️ Flash 写日志失败（%s）→ /log.csv 会停在旧数据！可能是文件系统满/损坏，建议 /clear 或重启",
           openFail ? "打开失败" : "写入失败");
}
bool safeAppendFile(const char* path, const String& line) {
  if (fileBusy) return false;
  fileBusy = true;
  File file = LittleFS.open(path, "a");
  if (!file) { fileBusy = false; warnAppendFail(true); return false; }
  bool ok = file.println(line);
  file.close();
  fileBusy = false;
  if (!ok) warnAppendFail(false);
  return ok;
}

bool hasValidDate(uint32_t timestamp) {
  if (timestamp < 1000000000) return false;
  struct tm tm; time_t tt = timestamp;
  localtime_r(&tt, &tm);
  return (tm.tm_year >= 100 && tm.tm_year <= 200 &&
          tm.tm_mon >= 0 && tm.tm_mon <= 11 &&
          tm.tm_mday >= 1 && tm.tm_mday <= 31);
}

// ---- NaN 存取辅助：Flash 里的 "N/A" ↔ 内存里的 NAN ----
static String fmtVal(float v) { return isnan(v) ? String("N/A") : String(v, 2); }
static float  parseVal(const String& s) {
  if (s.length() == 0) return NAN;
  char c = s.charAt(0);
  if (c == 'N' || c == 'n') return NAN;      // "N/A" / "nan"
  return s.toFloat();
}
static String jsonNum(float v) { return isnan(v) ? String("null") : String(v, 2); }

String urlEncode(const String& str) {
  String encoded = "";
  for (size_t i = 0; i < str.length(); i++) {
    char c = str.charAt(i);
    if (isalnum(c) || c == '-' || c == '_' || c == '.' || c == '~') {
      encoded += c;
    } else {
      char hex[4];
      snprintf(hex, sizeof(hex), "%%%02X", (unsigned char)c);
      encoded += hex;
    }
  }
  return encoded;
}

bool writeLineToSDByDate(const String& line, const String& header,
                         int year, int mon, int day,
                         bool isManual, const String& manualSuffix) {
  if (!sdOK) return false;
  char basePath[32];
  snprintf(basePath, sizeof(basePath), "/%04d-%02d-%02d", year, mon, day);
  String fullPath = String(basePath);
  if (isManual) fullPath += manualSuffix;
  fullPath += ".csv";
  if (!SD.exists(fullPath.c_str())) {
    File f = SD.open(fullPath.c_str(), "w");
    if (!f) return false;
    f.println(header);
    f.close();
  }
  File f = SD.open(fullPath.c_str(), "a");
  if (!f) return false;
  bool ok = f.println(line);
  f.close();
  return ok;
}

// ===== 按需挂载 SD（2026-09-30）=====
// 背景：sdOK 以前只在 setup() 里由 initSD() 判定一次（initSD 全文件只调那一处），
//   所以**运行中插卡不会被发现** —— 必须重启才认，连网页上手动点「归档」也会失败。
// 做法：把"一次性判定"改成"用之前先试一次"，只在**真正要碰卡的三个入口**调用：
//   ① archiveToSD()（每日 02:00 自动归档 / 低电归档 / 网页手动归档）
//   ② /sdlist（网页列 SD 目录）  ③ SD 文件下载
//   插卡后第一次用到就自动认出来，不必重启。
// ⚠️ 只在 !sdOK 时探测；已就绪直接返回，不重复挂载。
// ⚠️ 总线是分开的：SD 走 sdSPI(HSPI)（引脚 5/4/6/7 = HSPI 原生），屏走默认 SPI(FSPI)（引脚 1/2 经 GPIO 矩阵）→
//   运行中重新挂载 SD 不会打扰屏幕。
// ⚠️ SD.begin() 是**阻塞**的（正常约 100~300ms，坏卡可能到秒级）→ 绝不能放进 30s 采样路径，
//   只放在上面那三个低频/人工入口。
// 前置声明：initSD() 的实现要到加载缓冲那段（约 2700 行）才出现。
//   Arduino IDE 会自动生成原型，但本工程的直连工具链构建（_build/gen-protos.js）
//   只在【最后一个类型定义之后】插原型 → 这里必须自己声明。
void initSD();

bool ensureSD() {
  if (sdOK) return true;
  initSD();                    // 内部会打「✅ SD卡已就绪」或「⚠️ SD卡初始化失败」
  return sdOK;
}

// ========== 归档函数 ==========
// ===== 归档（异步分片版，2026-10-02）=====
//   背景：原 archiveToSD() 是**一次性大循环**（读整个 /log.csv + 逐行写 SD + 重载缓冲）→
//        实测 02:00 归档把主循环**阻塞了约 109 秒**，丢掉 4 个采样点（含整点 02:00:00）。
//   改法：拆成"每圈只处理若干行"的泵（与 /abtest 自卸同一模式）→ 采样/浅睡照常进行。
//   注意：**不加 delay()**，靠"每圈有限行数"自然让出 CPU。
// 归档状态机（分片泵用；定义必须在使用它的 archiveStart 之前）
struct ArchiveState {
  bool           active     = false;
  bool           isManual   = false;
  File           in, tmp;
  String         header;
  String         manualSuffix;
  int            nowYear=0, nowMon=0, nowDay=0;
  unsigned long  todayCount = 0, archivedCount = 0;
  size_t         snapshotBytes = 0;    // 归档启动时 /log.csv 的字节数（用于收尾补读新增行）
} g_arch;
// 启动异步归档：准备文件与状态。返回 true = 已启动（之后由 archivePump 分片推进）
bool archiveStart(bool isManual = false) {
  if (g_arch.active) { webLogln("📦 归档进行中，忽略重复请求"); return false; }
  if (!ensureSD()) {                 // 先试着重挂一次：可能是运行中才插的卡（合并自 feat/wide-layout）
    webLogln("⚠️ SD卡未就绪（已尝试重新挂载），跳过归档");
    return false;
  }
  time_t now = time(nullptr);
  if (now < 1000000000) { webLogln("⚠️ 时间未同步，跳过归档"); return false; }
  struct tm tm_now; localtime_r(&now, &tm_now);
  g_arch.nowYear = tm_now.tm_year + 1900;
  g_arch.nowMon  = tm_now.tm_mon + 1;
  g_arch.nowDay  = tm_now.tm_mday;
  if (!isManual && archivedMonth == g_arch.nowMon && archivedDay == g_arch.nowDay) {
    webLogln("📦 今日已自动归档，跳过");
    return false;
  }
  LittleFS.remove("/log.tmp");                  // 清掉上次残留，保证本次从空文件开始
  g_arch.in = LittleFS.open("/log.csv", "r");
  if (!g_arch.in) { webLogln("❌ 无法打开 log.csv"); return false; }
  g_arch.header = g_arch.in.readStringUntil('\n');
  g_arch.snapshotBytes = g_arch.in.position();   // 快照位置：表头之后 = 已有数据的起点
  g_arch.tmp = LittleFS.open("/log.tmp", "a");   // a：补读新增行时追加不截断（首次由 remove 保证干净）
  if (!g_arch.tmp) { g_arch.in.close(); webLogln("❌ 无法创建临时文件"); return false; }
  g_arch.tmp.println(g_arch.header);
  g_arch.manualSuffix = "";
  if (isManual) {
    char suffix[64];
    snprintf(suffix, sizeof(suffix), "_manual_%04d%02d%02d_%02d%02d%02d",
             g_arch.nowYear, g_arch.nowMon, g_arch.nowDay, tm_now.tm_hour, tm_now.tm_min, tm_now.tm_sec);
    g_arch.manualSuffix = String(suffix);
  }
  g_arch.isManual    = isManual;
  g_arch.todayCount  = 0;
  g_arch.archivedCount = 0;
  g_arch.active      = true;
  webLog("📦 开始%s归档（分片，不阻塞采样）...\n", isManual ? "手动" : "自动");
  return true;
}


// 处理一行：返回 true = 已写入 SD（归档成功），false = 留在 Flash
bool archProcessLine(const String& line) {
  if (line.length() == 0) return false;
  int idx1 = line.indexOf(',');
  int idx2 = line.indexOf(',', idx1 + 1);
  if (idx1 < 0 || idx2 < 0) { g_arch.tmp.println(line); g_arch.todayCount++; return false; }
  String timeStr = line.substring(idx1 + 1, idx2);
  struct tm tm_line; memset(&tm_line, 0, sizeof(tm_line));
  if (!strptime(timeStr.c_str(), "%Y-%m-%d %H:%M:%S", &tm_line)) {
    g_arch.tmp.println(line); g_arch.todayCount++; return false;
  }
  int lineYear = tm_line.tm_year + 1900;
  int lineMon  = tm_line.tm_mon + 1;
  int lineDay  = tm_line.tm_mday;
  bool isToday = (lineYear == g_arch.nowYear && lineMon == g_arch.nowMon && lineDay == g_arch.nowDay);

  if (isToday && !g_arch.isManual) {                  // 自动归档：今日数据留 Flash
    g_arch.tmp.println(line); g_arch.todayCount++; return false;
  }
  bool ok = writeLineToSDByDate(line, g_arch.header, lineYear, lineMon, lineDay,
                                isToday && g_arch.isManual, g_arch.manualSuffix);
  if (ok) { g_arch.archivedCount++; return true; }
  g_arch.tmp.println(line); g_arch.todayCount++;
  return false;
}

// 收尾：切换文件、重载缓冲
void archFinish() {
  // ★ 先补读"归档期间新追加的行"：
  //   异步归档期间主循环仍在往 /log.csv 追加采样；若直接 rename，这些新行会随旧文件被删。
  //   做法：重新打开原文件，从快照位置读到**当前末尾**（读到 EOF 即停），逐行按同一规则处理。
  int tail = 0;
  {
    File f2 = LittleFS.open("/log.csv", "r");
    if (f2) {
      f2.seek(g_arch.snapshotBytes);
      while (f2.available() && tail < 200) {            // 上限保护
        String line = f2.readStringUntil('\n');
        line.trim();
        if (line.length() == 0) continue;
        archProcessLine(line);                          // /tmp 以 "a" 打开，追加不截断
        tail++;
      }
      f2.close();
    }
  }
  g_arch.in.close();
  g_arch.tmp.close();
  if (tail) webLog("📥 归档期间新增 %d 行已补入归档\n", tail);
  webLog("📊 归档统计: 归档 %lu 条, Flash保留 %lu 条\n", g_arch.archivedCount, g_arch.todayCount);
  if (g_arch.archivedCount == 0) {
    webLogln("⚠️ 没有数据需要归档，Flash不动");
    LittleFS.remove("/log.tmp");
    if (!g_arch.isManual) { archivedMonth = g_arch.nowMon; archivedDay = g_arch.nowDay; }
  } else {
    LittleFS.remove("/log.csv");
    LittleFS.rename("/log.tmp", "/log.csv");
    recordCount = g_arch.todayCount;
    if (!g_arch.isManual) { archivedMonth = g_arch.nowMon; archivedDay = g_arch.nowDay; }
    bufferSize = 0; bufferHead = 0;
    loadBufferFromFlash();
    webLog("✅ 归档完成！Flash 剩余 %lu 条\n", g_arch.todayCount);
  }
  g_arch.active = false;
}

// 每圈调用；每圈最多处理 ARCH_LINES_PER_TICK 行 → 让出 CPU（采样/浅睡不受阻）
void archivePump() {
  if (!g_arch.active) return;
  const int ARCH_LINES_PER_TICK = 40;
  int n = 0;
  while (n < ARCH_LINES_PER_TICK && g_arch.in.available()) {
    String line = g_arch.in.readStringUntil('\n');
    if (line.length() == 0) continue;
    archProcessLine(line);
    n++;
  }
  if (!g_arch.in.available()) archFinish();          // 读完了 → 收尾
}

// 同步入口（保留给"手动归档"等需要立即完成的场合）——内部循环推进分片泵
bool archiveToSDSync(bool isManual = false) {
  if (!archiveStart(isManual)) return false;
  unsigned long t0 = millis();
  while (g_arch.active && (millis() - t0) < 120000UL) archivePump();   // 上限 120s 防死循环
  return !g_arch.active;
}
// ⚠️ **会阻塞主循环**（内部同步跑完分片泵）——仅在"确实必须立即完成"时使用。
//    常规路径请用 archiveStart()（非阻塞，由 loop 的 archivePump 推进）。
//    目前代码里已无调用者，保留仅为兼容与应急。
bool archiveToSD(bool isManual = false) {
  if (g_arch.active) { webLogln("📦 归档进行中，忽略"); return false; }
  return archiveToSDSync(isManual);
}

// ========== 日平均引擎 ==========
void updateExtreme(ExtremeValue& ev, float v, uint32_t t, bool isMin = false) {
  if (!ev.set) { ev.set = true; ev.v = v; ev.t = t; return; }
  if (isMin ? (v < ev.v) : (v > ev.v)) { ev.v = v; ev.t = t; }
}

void addDaysToDate(const char* date, int days, char* out) {
  struct tm tm; memset(&tm, 0, sizeof(tm));
  sscanf(date, "%d-%d-%d", &tm.tm_year, &tm.tm_mon, &tm.tm_mday);
  tm.tm_year -= 1900; tm.tm_mon -= 1;
  time_t t = mktime(&tm) + (time_t)days * 86400L;
  localtime_r(&t, &tm);
  strftime(out, 11, "%Y-%m-%d", &tm);
}

// 判定一条“日平均”是否有效：本次修复后空槽写 NaN；修复前空槽写 0（真实读数不可能是 0），
// 两者都当“当天该槽没采集”——否则会把没数据的槽也算作一天参与平均，把基线稀释（曾把 1012 hPa 算成 507）
static inline bool avgDateValid(const float* v) {
  return !isnan(v[0]) && !isnan(v[1]) && !isnan(v[2]) && v[0] != 0.0f && v[1] != 0.0f && v[2] != 0.0f;
}

// 把 todaySlots 的均值写成 YYYY-MM-DD.bin（2880×3 float = 34.5KB）
void saveAvgBin(const char* date) {
  if (!avgSlots || !todaySlots) return;
  if (!LittleFS.exists(AVG_DIR)) LittleFS.mkdir(AVG_DIR);
  String path = String(AVG_DIR) + "/" + date + ".bin";
  File f = LittleFS.open(path, "w");
  if (!f) { webLogln("⚠️ 无法写入日平均文件"); return; }
  for (int i = 0; i < AVG_SLOTS; i++) {
    float v[3] = {NAN, NAN, NAN};      // 该槽当天无采集 → 写 NaN（读取端据此跳过，不参与平均）
    if (todaySlots[i].cnt > 0) {
      v[0] = todaySlots[i].sumT / todaySlots[i].cnt;
      v[1] = todaySlots[i].sumH / todaySlots[i].cnt;
      v[2] = todaySlots[i].sumP / todaySlots[i].cnt;
    }
    f.write((const uint8_t*)v, sizeof(v));
  }
  f.close();
  webLogln("💾 日平均已存档: %s", date);
}

// 滑动窗口：把昨天的均值加进 avgSlots，踢出 30 天前的
void updateAvgWindow(const char* date) {
  if (!avgSlots) return;
  String path = String(AVG_DIR) + "/" + date + ".bin";
  File f = LittleFS.open(path, "r");
  if (f) {
    float v[3];
    for (int i = 0; i < AVG_SLOTS; i++) {
      if (f.read((uint8_t*)v, sizeof(v)) == sizeof(v) && avgDateValid(v)) {
        avgSlots[i].sumT += v[0]; avgSlots[i].sumH += v[1]; avgSlots[i].sumP += v[2];
        avgSlots[i].cnt++;
      }
    }
    f.close();
  }
  char oldDate[11];
  addDaysToDate(date, -AVG_WINDOW_DAYS, oldDate);
  String oldPath = String(AVG_DIR) + "/" + oldDate + ".bin";
  if (LittleFS.exists(oldPath)) {
    File f2 = LittleFS.open(oldPath, "r");
    if (f2) {
      float v[3];
      for (int i = 0; i < AVG_SLOTS; i++) {
        if (f2.read((uint8_t*)v, sizeof(v)) == sizeof(v) && avgDateValid(v)) {
          avgSlots[i].sumT -= v[0]; avgSlots[i].sumH -= v[1]; avgSlots[i].sumP -= v[2];
          if (avgSlots[i].cnt > 0) avgSlots[i].cnt--;
        }
      }
      f2.close();
    }
    LittleFS.remove(oldPath);
    webLogln("🗑️ 已踢出窗口: %s", oldDate);
  }
}

// 跨天：存档昨天 → 更新滑动窗口 → 重置今日
void rolloverDay() {
  String oldDate = String(todayExt.date);
  if (oldDate.length() == 10) {
    saveAvgBin(oldDate.c_str());
    updateAvgWindow(oldDate.c_str());
  }
  memset(todaySlots, 0, AVG_SLOTS * sizeof(AvgSlot));
  memset(&todayExt, 0, sizeof(todayExt));
  struct tm tm; time_t now = time(nullptr); localtime_r(&now, &tm);
  snprintf(todayExt.date, sizeof(todayExt.date), "%04d-%02d-%02d", tm.tm_year + 1900, tm.tm_mon + 1, tm.tm_mday);
  webLogln("🌅 跨天重置：%s 已计入日平均", oldDate.c_str());
}

// 开机时从已有 bin 重建滑动窗口（最多30天）
void loadAvgWindow() {
  if (!avgSlots) return;
  if (!LittleFS.exists(AVG_DIR)) return;
  File dir = LittleFS.open(AVG_DIR);
  if (!dir || !dir.isDirectory()) return;
  char names[40][11]; int n = 0;
  File f = dir.openNextFile();
  while (f && n < 40) {
    String fn = String(f.name());
    int slash = fn.lastIndexOf('/');
    String base = fn.substring(slash + 1);
    if (base.endsWith(".bin") && base.length() == 14) {
      strncpy(names[n], base.c_str(), 10); names[n][10] = '\0'; n++;
    }
    f = dir.openNextFile();
  }
  dir.close();
  if (n == 0) return;
  for (int i = 0; i < n - 1; i++)
    for (int j = i + 1; j < n; j++)
      if (strcmp(names[j], names[i]) < 0) { char tmp[11]; strcpy(tmp, names[i]); strcpy(names[i], names[j]); strcpy(names[j], tmp); }
  int start = (n > AVG_WINDOW_DAYS) ? (n - AVG_WINDOW_DAYS) : 0;
  for (int k = start; k < n; k++) {
    String path = String(AVG_DIR) + "/" + names[k] + ".bin";
    File bf = LittleFS.open(path, "r");
    if (!bf) continue;
    float v[3];
    for (int i = 0; i < AVG_SLOTS; i++) {
      if (bf.read((uint8_t*)v, sizeof(v)) == sizeof(v) && avgDateValid(v)) {
        avgSlots[i].sumT += v[0]; avgSlots[i].sumH += v[1]; avgSlots[i].sumP += v[2];
        avgSlots[i].cnt++;
      }
    }
    bf.close();
  }
  webLogln("📚 日平均窗口加载: %d 天", n - start);
}

// PSRAM 分配（失败则禁用引擎，不影响主功能）
void initAvgEngine() {
  avgSlots = (AvgSlot*)ps_malloc(AVG_SLOTS * sizeof(AvgSlot));
  todaySlots = (AvgSlot*)ps_malloc(AVG_SLOTS * sizeof(AvgSlot));
  if (!avgSlots || !todaySlots) {
    webLogln("⚠️ PSRAM 分配失败，日平均引擎禁用（不影响基础功能）");
    return;
  }
  memset(avgSlots, 0, AVG_SLOTS * sizeof(AvgSlot));
  memset(todaySlots, 0, AVG_SLOTS * sizeof(AvgSlot));
  loadAvgWindow();
  webLogln("✅ 日平均引擎就绪 (PSRAM %d KB)", (AVG_SLOTS * (sizeof(AvgSlot) * 2)) / 1024);
}

// 凌晨 02:00–02:05 为自动归档窗口。
// ⚠️ loop() 每轮都会调用本函数：不加守卫时，窗口内每一轮都会打一条日志
//    （SD 正常打「今日已自动归档，跳过」，SD 异常打「SD卡未就绪，跳过归档」），
//    5 分钟足以刷爆 200 条网页日志环形缓冲，把有用日志挤掉。
//    策略：当天归档成功即停；失败（如 SD 未就绪）按 30s 间隔重试。
// ===== 未插卡的兜底：裁掉 /log.csv 里超过保留期的头部（2026-09-30）=====
// 为什么需要：不插 SD 时 archiveToSD() 永远失败 → /log.csv 只涨不清。littlefs 分区
//   3.38 MB，按 2880 条/天（≈138 KB/天）约 26 天填满；满后 safeAppendFile() 失败，
//   而那时唯一能腾空间的手段是 /clear（全清）。这里给一个「只保留最近 N 天」的兜底。
//
// ⚠️ 为什么按**时间戳**裁，而不是「砍掉最老的 2880 条」：低电压时 readAndLog() 会跳过
//   记录（allowRecord=false）、重启也会丢采样，一天的实际条数经常不到 2880。
//   按固定条数裁会净减（产出 2600 / 裁掉 2880 → 每天少 280 条）→ 越裁越少，
//   最后可能只剩不到一天。按时间戳裁则保留期恒等于 keepDays，且能自我收敛。
//
// ⚠️ 为什么只能整文件重写：littlefs 不能在文件中间打洞，所以只能是
//   读 → 过滤 → 写 /log.tmp → rename（与 archiveToSD() 同一套写法）。
//   代价：每次把剩余部分重写一遍（14 天 ≈ 2 MB）。按天裁 = 每天多写约 2 MB，
//   相对记账本身的 138 KB/天 是多 15 倍，但绝对值仍可忽略（约 365 次擦写/块·年）。
//
// ✅ 读取端**完全不用改**：还是同一个 /log.csv、同样的行格式，/history 仍按行数分页。
//
// 返回：true = 已处理（裁过了，或本来就没什么可裁）；false = 出错（交给调用方重试）
bool trimLogOlderThan(int keepDays) {
  time_t now = time(nullptr);
  if (now < 1000000000) return false;          // 时间没同步：宁可不裁，否则会把整份数据删光
  time_t cutoff = now - (time_t)keepDays * 86400L;

  if (fileBusy) return false;
  fileBusy = true;

  File in = LittleFS.open("/log.csv", "r");
  if (!in) { fileBusy = false; return false; }
  in.readStringUntil('\n');                     // 丢掉表头

  // 先只找第一条数据行的时间：还没到期就什么都不做（省掉一次整文件重写）
  time_t firstT = 0;
  while (in.available() && firstT == 0) {
    String l = in.readStringUntil('\n');
    if (!l.length()) continue;
    int i1 = l.indexOf(','), i2 = l.indexOf(',', i1 + 1);
    if (i1 < 0 || i2 <= i1) continue;
    struct tm tml;
    if (strptime(l.substring(i1 + 1, i2).c_str(), "%Y-%m-%d %H:%M:%S", &tml)) firstT = mktime(&tml);
  }
  if (firstT == 0 || firstT >= cutoff) {        // 解析不出时间 / 还没到保留期
    in.close(); fileBusy = false; return true;
  }

  // 确认要裁 → 从头重读，过滤进 /log.tmp
  in.seek(0);
  String header = in.readStringUntil('\n');
  File out = LittleFS.open("/log.tmp", "w");
  if (!out) { in.close(); fileBusy = false; return false; }
  out.println(header);
  unsigned long dropped = 0, kept = 0;
  while (in.available()) {
    String l = in.readStringUntil('\n');
    if (!l.length()) continue;
    int i1 = l.indexOf(','), i2 = l.indexOf(',', i1 + 1);
    time_t lt = 0;
    if (i1 >= 0 && i2 > i1) {
      struct tm tml;
      if (strptime(l.substring(i1 + 1, i2).c_str(), "%Y-%m-%d %H:%M:%S", &tml)) lt = mktime(&tml);
    }
    if (lt != 0 && lt < cutoff) { dropped++; continue; }
    out.println(l); kept++;                      // 时间戳解析不出的行一律保留（宁可留着也不丢）
  }
  in.close(); out.close();

  if (dropped == 0) { LittleFS.remove("/log.tmp"); fileBusy = false; return true; }

  LittleFS.remove("/log.csv");
  LittleFS.rename("/log.tmp", "/log.csv");
  recordCount = kept;                            // 与 archiveToSD() 同口径：= flash 里的条数
  bufferSize = 0; bufferHead = 0;
  loadBufferFromFlash();                         // 文件变了 → 刷新 RAM 环，别让 /history 与环对不上
  fileBusy = false;
  webLogln("🧹 未插卡兜底：裁掉 %lu 条（早于 %d 天前），Flash 保留 %lu 条", dropped, keepDays, kept);
  return true;
}

void checkAndArchive() {
  time_t now = time(nullptr);
  if (now < 1000000000) return;
  struct tm tm;
  localtime_r(&now, &tm);
  if (tm.tm_hour != 2 || tm.tm_min >= 5) return;

  static int           doneYday  = -1;
  static unsigned long lastTryMs = 0;

  if (tm.tm_yday == doneYday) return;                        // 当天已完成，不再判定
  if (g_arch.active) return;                                 // 正在分片归档中，别重复发起
  unsigned long nowMs = millis();
  if (lastTryMs != 0 && (nowMs - lastTryMs) < 30000UL) return;  // 失败重试间隔 30s
  lastTryMs = nowMs;
  // ⚠️ 2026-10-02 融合两处改动：
  //   ①（feat/light-sleep）改**非阻塞启动**：archiveStart 只准备文件，实际处理交给 loop 的 archivePump；
  //      原来调 archiveToSD() 会一次跑完整个大循环 → 阻塞主循环约 109 秒 → 丢 4 个采样点。
  //   ②（feat/wide-layout）先试着重挂载 SD：可能是运行中才插的卡；确实没卡 → 兜底裁掉超期表头。
  //      ⚠️ 这里必须自己收工（doneYday = …）：本函数在窗口内每 30s 重试一次，
  //         不设守卫的话裁头会连做多遍，等于把整个文件重写多遍。
  if (!ensureSD()) {
    if (trimLogOlderThan(LOG_KEEP_DAYS)) doneYday = tm.tm_yday;
    return;
  }
  if (archiveStart(false)) doneYday = tm.tm_yday;            // 非阻塞启动；当天只发起一次
}

// ========== 初始化各模块 ==========
// ---- 旧版 CSV 表头迁移（V2.1 新增第 6 列「模式」）----
//   老 /log.csv 是 5 列，直接追加新数据会出现「新旧列数不一致」。
//   这里一次性重写：表头换成 6 列，旧数据行的模式列补占位符 "-"（历史模式未知）。
//   表头已含「模式」则原样跳过。仅开机执行一次。
static void migrateLogHeaderIfNeeded() {
  File in = LittleFS.open("/log.csv", "r");
  if (!in) return;
  String header = in.readStringUntil('\n');
  if (header.indexOf("模式") >= 0) { in.close(); return; }   // 已是新格式
  webLogln("🔄 旧版 CSV 无「模式」列，开始迁移…");
  File out = LittleFS.open("/log.tmp", "w");
  if (!out) { in.close(); webLogln("⚠️ CSV 迁移失败：无法创建临时文件"); return; }
  out.println("序号,时间,温度(°C),湿度(%RH),气压(hPa),模式");
  unsigned long n = 0;
  while (in.available()) {
    String line = in.readStringUntil('\n');
    line.trim();
    if (line.length() == 0) continue;
    int commas = 0;
    for (int i = 0; i < (int)line.length(); i++) if (line.charAt(i) == ',') commas++;
    out.print(line);
    if (commas < 5) out.print(",-");      // 只有 5 列 → 补占位符（模式未知）
    out.println();
    n++;
  }
  in.close();
  out.close();
  // 先备份再替换，避免中途掉电丢数据
  LittleFS.remove("/log.bak");
  LittleFS.rename("/log.csv", "/log.bak");
  if (!LittleFS.rename("/log.tmp", "/log.csv")) {
    LittleFS.rename("/log.bak", "/log.csv");   // 回滚
    webLogln("⚠️ CSV 迁移失败：替换出错，已回滚");
    return;
  }
  LittleFS.remove("/log.bak");
  webLogln("✅ CSV 迁移完成：%lu 行已补齐「模式」列（旧行填 \"-\"）", n);
}

void initFS() {
  if (!LittleFS.begin(true, "/littlefs", 10, "littlefs")) {  // ← true = 挂载失败自动格式化
    webLogln("❌ Flash 挂载失败");
    return;
  }
  fsReadyForDbg = true;   // ✅ 挂载成功后才允许落盘

  if (!LittleFS.exists("/log.csv")) {
    File file = LittleFS.open("/log.csv", "w");
    if (file) { file.println("序号,时间,温度(°C),湿度(%RH),气压(hPa),模式"); file.close(); }
  } else {
    migrateLogHeaderIfNeeded();     // 旧 5 列表头 → 6 列（旧行补 "-"）
    File file = LittleFS.open("/log.csv", "r");
    if (file) {
      recordCount = 0;
      while (file.available()) { if (file.read() == '\n') recordCount++; }
      file.close();
      if (recordCount > 0) recordCount--;
    }
  }
  bufferCapacity = KEEP_IN_MEMORY;
  buffer = new DataPoint[bufferCapacity];
  if (!buffer) { bufferCapacity = 300; buffer = new DataPoint[bufferCapacity]; }
  if (!buffer) { bufferCapacity = 100; buffer = new DataPoint[bufferCapacity]; }
  if (buffer) loadBufferFromFlash();
}

void loadBufferFromFlash() {
  if (!buffer) return;
  File file = LittleFS.open("/log.csv", "r");
  if (!file) return;
  file.readStringUntil('\n');
  unsigned long totalLines = 0;
  while (file.available()) { if (file.read() == '\n') totalLines++; }
  file.close();
  if (totalLines == 0) return;
  file = LittleFS.open("/log.csv", "r");
  file.readStringUntil('\n');
  unsigned long skipLines = (totalLines > KEEP_IN_MEMORY) ? (totalLines - KEEP_IN_MEMORY) : 0;
  for (unsigned long i = 0; i < skipLines; i++) file.readStringUntil('\n');
  bufferSize = 0; bufferHead = 0;
  int loadedCount = 0;
  while (file.available() && loadedCount < KEEP_IN_MEMORY) {
    String line = file.readStringUntil('\n');
    if (line.length() == 0) continue;
    int idx1 = line.indexOf(','), idx2 = line.indexOf(',', idx1 + 1);
    int idx3 = line.indexOf(',', idx2 + 1), idx4 = line.indexOf(',', idx3 + 1);
    int idx5 = line.indexOf(',', idx4 + 1);   // 第6列=设备模式（旧数据可能没有）
    if (idx1 < 0 || idx2 < 0 || idx3 < 0 || idx4 < 0) continue;
    String timeStr = line.substring(idx1 + 1, idx2);
    String tempStr = line.substring(idx2 + 1, idx3);
    String humStr  = line.substring(idx3 + 1, idx4);
    String presStr = (idx5 < 0) ? line.substring(idx4 + 1) : line.substring(idx4 + 1, idx5);
    uint32_t timestamp = 0; struct tm tm;
    if (strptime(timeStr.c_str(), "%Y-%m-%d %H:%M:%S", &tm)) { timestamp = mktime(&tm); }
    else { int h,m,s; if (sscanf(timeStr.c_str(),"%d:%d:%d",&h,&m,&s)==3) timestamp = h*3600+m*60+s; else timestamp = loadedCount * INTERVAL_SEC; }
    buffer[bufferHead].time = timestamp;
    buffer[bufferHead].temp = parseVal(tempStr);
    buffer[bufferHead].humidity = parseVal(humStr);
    buffer[bufferHead].pressure = parseVal(presStr);
    bufferHead = (bufferHead + 1) % bufferCapacity;
    bufferSize++; loadedCount++;
  }
  file.close();
  if (bufferSize > 0) {
    int lastIdx = (bufferHead - 1 + bufferCapacity) % bufferCapacity;
    lastCollectTime = buffer[lastIdx].time;
  }
}

// ===== V2.1.1 Bug②：开机把「今天」已采的数据回灌进今日统计（极值 + 距平槽）=====
//   为什么：`todayExt`/`todaySlots` 只在实时采样路径里更新，OTA / 掉电 / 复位后当天已过去的数据全丢。
//   ⚠ 必须扫**整个 /log.csv**（不能只扫 RAM 那 600 条：600×30s ≈ 5h，盖不住一整天）。
//   ⚠ 必须在「系统时间已就绪」且**日平均引擎与跨天逻辑都已就位**之后调用（见 setup 里的调用点）。
//   成本：一次线性扫描（几千行 ≈ 几十 ms），只在开机做一次，不碰采样节奏、不写 SD。
//   返回：成功喂入的样本条数（-1 表示条件不满足没跑）
int backfillTodayFromLog() {
  if (!avgSlots || !todaySlots) return -1;                 // 引擎没起来（PSRAM 分配失败）
  if (!timeSynced) return -1;                              // 时间没同步，判不了"今天"
  time_t now = time(nullptr);
  if (now < 1000000000) return -1;
  char today[11];
  struct tm tmn; localtime_r(&now, &tmn);
  snprintf(today, sizeof(today), "%04d-%02d-%02d", tmn.tm_year + 1900, tmn.tm_mon + 1, tmn.tm_mday);
  // 先给 todayExt.date 打上"今天"（回灌期间不会有跨天，也**绝不能**触发 rolloverDay）：
  //   todayExt.date 为空 → feedTodaySample() 会直接返回，所以这里必须先设好
  if (strlen(todayExt.date) != 10) snprintf(todayExt.date, sizeof(todayExt.date), "%s", today);

  File file = LittleFS.open("/log.csv", "r");
  if (!file) { webLogln("ℹ️ 今日回灌：无 /log.csv，跳过"); return 0; }
  file.readStringUntil('\n');                              // 表头
  int fed = 0, skips = 0;
  while (file.available()) {
    String line = file.readStringUntil('\n');
    line.trim();
    if (line.length() == 0) continue;
    int idx1 = line.indexOf(','), idx2 = line.indexOf(',', idx1 + 1);
    int idx3 = line.indexOf(',', idx2 + 1), idx4 = line.indexOf(',', idx3 + 1);
    if (idx1 < 0 || idx2 < 0 || idx3 < 0 || idx4 < 0) continue;
    String timeStr = line.substring(idx1 + 1, idx2);
    if (timeStr.length() < 10) continue;
    if (timeStr.substring(0, 10) != String(today)) continue;   // 只喂"今天"的（CSV 已按时间递增）
    uint32_t ts = 0; struct tm tmv;
    memset(&tmv, 0, sizeof(tmv));
    if (strptime(timeStr.c_str(), "%Y-%m-%d %H:%M:%S", &tmv)) ts = (uint32_t)mktime(&tmv);
    if (ts == 0) { skips++; continue; }
    float tC = parseVal(line.substring(idx2 + 1, idx3));
    float h  = parseVal(line.substring(idx3 + 1, idx4));
    float p  = parseVal(line.substring(idx4 + 1));             // 第 5 列；后面可能还有「模式」列，parseVal 会处理脏尾巴
    feedTodaySample(ts, tC, h, p);
    fed++;
  }
  file.close();
  webLogln("📥 今日回灌：/log.csv 命中 %s 共 %d 条（跳过时间戳异常 %d 条）→ 极值与距平槽已补齐",
           today, fed, skips);
  diag(String("今日回灌 ") + today + "：" + String(fed) + " 条");
  return fed;
}

void initSD() {
  sdSPI.begin(5, 4, 6, 7);      // v2.2：SCK=IO5 MISO=IO4 MOSI=IO6 CS=IO7
  if (!SD.begin(SD_CS, sdSPI)) {
    webLogln("⚠️ SD卡初始化失败");
    sdOK = false;
  } else {
    webLogln("✅ SD卡已就绪");
    sdOK = true;
  }
}

void initRTC() {
  if (!rtc.begin()) {
    webLogln("⚠️ DS3231 未检测到");
    rtcOK = false;
  } else {
    webLogln("✅ DS3231 RTC 已就绪");
    rtcOK = true;
    rtcLostPower = rtc.lostPower();
    if (rtcLostPower) webLogln("⚠️ RTC 掉电，需通过 NTP 设置时间");
  }
}

void cleanupUntimestampedData() {
  if (!timeSynced || !hasSyncedOnce) return;
  File file = LittleFS.open("/log.csv", "r");
  if (!file) return;
  File tmp = LittleFS.open("/log.tmp", "w");
  if (!tmp) { file.close(); return; }
  String header = file.readStringUntil('\n');
  tmp.println(header);
  int fileCleaned = 0, fileKept = 0;
  unsigned long newRecordCount = 0;
  while (file.available()) {
    String line = file.readStringUntil('\n');
    if (line.length() == 0) continue;
    int idx1 = line.indexOf(','), idx2 = line.indexOf(',', idx1 + 1);
    if (idx1 < 0 || idx2 < 0) continue;
    String timeStr = line.substring(idx1 + 1, idx2);
    struct tm tm;
    if (strptime(timeStr.c_str(), "%Y-%m-%d %H:%M:%S", &tm)) {
      tmp.println(line); fileKept++; newRecordCount++;
    } else { fileCleaned++; }
  }
  file.close(); tmp.close();
  if (fileCleaned > 0) {
    LittleFS.remove("/log.csv");
    LittleFS.rename("/log.tmp", "/log.csv");
    recordCount = newRecordCount;
  } else { LittleFS.remove("/log.tmp"); }
  hasSyncedOnce = false;
}

// ===== NTP：非阻塞启动 + 轮询完成（2026-10-03 重构）=====
//   背景：原 syncTimeFromNTP() 用 delay(250) 轮询最多 40 次 = **最多阻塞 10 秒**，
//        在启动路径上非常拖时间。
//   拆分：
//     · ntpStart()      —— 只调 configTime() 启动 SNTP，**立即返回**
//     · ntpIsDone()     —— 查系统时间是否已被 SNTP 拉正
//     · syncTimeFromNTPBlocking(ms) —— 需要"立刻拿到时间"时才用（如 RTC 掉电）
//   ⚠️ 完成后的落地动作（写 RTC / 记 ntpLastOkAt）统一在 serviceNtpSync() 里做。
bool ntpPending = false;          // SNTP 已启动、等结果
unsigned long ntpStartedMs = 0;

void ntpStart() {
  configTime(8 * 3600, 0, "pool.ntp.org", "ntp.aliyun.com");
  ntpPending   = true;
  ntpStartedMs = millis();
  webLogln("🕐 NTP 同步已启动（非阻塞）");
}

bool ntpIsDone() { return time(nullptr) >= 1000000000; }

// 需要立刻拿到时间时用（会阻塞）；返回是否成功
bool syncTimeFromNTPBlocking(unsigned long maxMs = 10000UL) {
  time_t now = 0;
  unsigned long t0 = millis();
  while ((now = time(nullptr)) < 1000000000) {
    if (millis() - t0 > maxMs) break;
    delay(100);
  }
  if (now >= 1000000000) {
    timeSynced = true; hasSyncedOnce = true;
    ntpLastOkAt = now;
    struct timeval tv = { now, 0 };
    settimeofday(&tv, nullptr);
    char buf[30]; strftime(buf, 30, "%Y-%m-%d %H:%M:%S", localtime(&now));
    webLog("✅ NTP: %s\n", buf);
    if (rtcOK) { rtc.adjust(DateTime(now)); webLogln("✅ RTC 已同步 NTP 时间"); }
    cleanupUntimestampedData();
    ntpPending = false;
    return true;
  }
  webLogln("⚠️ NTP 超时（改用 RTC 时间）");
  _fallbackToRtcTime();
  return false;
}

// 时间回退到 RTC（NTP 不可用时的保底）
void _fallbackToRtcTime() {
  if (!rtcOK) return;
  DateTime dt = rtc.now();
  time_t rtcTime = dt.unixtime();
  if (rtcTime >= 1000000000) {
    struct timeval tv = { rtcTime, 0 };
    settimeofday(&tv, nullptr);
    timeSynced = true; hasSyncedOnce = true;
    char buf[30]; strftime(buf, 30, "%Y-%m-%d %H:%M:%S", localtime(&rtcTime));
    webLog("✅ 从 RTC 获取时间: %s\n", buf);
    cleanupUntimestampedData();
  }
}

// ===== NTP 每日 02:00 定期检查（loop 每圈调，几乎零开销）=====
//   条件：插电 + WiFi 已连 + 当前时间已有效（否则没法判断"到 02:00 了吗"）。
//   动作：跨过 02:00 当天做一次判定；距上次成功 >= NTP_RESYNC_DAYS 天 → 非阻塞同步。
//   ⚠️ RTC 掉电且当时无网络 → 挂起（ntpDailyPending），一旦有网立刻补一次。
void serviceNtpDailyCheck() {
  // 时间有效性：若时间还没被设过（< 2021），先不动
  time_t nowT = time(nullptr);
  if (nowT < 1000000000) return;

  struct tm tmv;
  localtime_r(&nowT, &tmv);
  int  today    = tmv.tm_yday;
  bool atOrAfter2 = (tmv.tm_hour >= 2);

  // 每日只在跨过 02:00 后检查一次
  bool dueToday = atOrAfter2 && (ntpDailyLastDay != today);

  // RTC 掉电且没网 → 挂起
  if (rtcLostPower && WiFi.status() != WL_CONNECTED) { ntpDailyPending = true; return; }

  if (!dueToday && !(ntpDailyPending && WiFi.status() == WL_CONNECTED)) return;

  if (!isExternallyPowered()) return;      // 电池供电时绝不去连网校时（省电）
  if (WiFi.status() != WL_CONNECTED) return;

  bool stale = (ntpLastOkAt == 0) || ((nowT - ntpLastOkAt) >= NTP_RESYNC_DAYS * 24L * 3600L);
  if (!stale && !rtcLostPower && !ntpDailyPending) { ntpDailyLastDay = today; return; }

  ntpDailyLastDay = today;
  ntpDailyPending = false;
  webLogln("🕐 每日 NTP 检查：距上次成功已超 %ld 天 → 发起同步（非阻塞）", NTP_RESYNC_DAYS);
  ntpStart();
}
// loop 每圈调用：SNTP 有结果就落地（写 RTC、记时刻），超时就回退 RTC
void serviceNtpSync() {
  if (!ntpPending) return;
  if (ntpIsDone()) {
    time_t now = time(nullptr);
    timeSynced = true; hasSyncedOnce = true;
    ntpLastOkAt = now;
    if (rtcOK) { rtc.adjust(DateTime(now)); webLogln("✅ NTP 已同步（并写入 RTC）"); }
    else       { webLogln("✅ NTP 已同步"); }
    cleanupUntimestampedData();
    ntpPending = false;
  } else if (millis() - ntpStartedMs > 20000UL) {   // 20s 无结果 → 回退
    webLogln("⚠️ NTP 20 秒无结果 → 回退 RTC 时间");
    _fallbackToRtcTime();
    ntpPending = false;
  }
}
// 兼容旧调用：**会阻塞**（最多 10s）。新代码请用 ntpStart() / serviceNtpSync()。
void syncTimeFromNTPLegacy() {
  webLog("🕐 NTP 同步...");
  configTime(8 * 3600, 0, "pool.ntp.org", "ntp.aliyun.com");
  time_t now = 0;
  int ntpRetry = 0;
  while (now < 1000000000 && ntpRetry < 40) {
    delay(250); now = time(nullptr); ntpRetry++; webLog(".");
  }
  if (now >= 1000000000) {
    timeSynced = true; hasSyncedOnce = true;
  ntpLastOkAt = time(nullptr);                     // 记录 NTP 成功时刻（供 3 天重试判据用）
    struct timeval tv = { now, 0 };
    settimeofday(&tv, nullptr);
    char buf[30]; strftime(buf, 30, "%Y-%m-%d %H:%M:%S", localtime(&now));
    webLog("\n✅ NTP: %s\n", buf);
    if (rtcOK) { rtc.adjust(DateTime(now)); webLogln("✅ RTC 已同步 NTP 时间"); }
    cleanupUntimestampedData();
  } else {
    webLogln("\n⚠️ NTP 超时");
    if (rtcOK) {
      DateTime dt = rtc.now();
      time_t rtcTime = dt.unixtime();
      if (rtcTime >= 1000000000) {
        struct timeval tv = { rtcTime, 0 };
        settimeofday(&tv, nullptr);
        timeSynced = true; hasSyncedOnce = true;
        char buf[30]; strftime(buf, 30, "%Y-%m-%d %H:%M:%S", localtime(&rtcTime));
        webLog("✅ 从 RTC 获取时间: %s\n", buf);
        cleanupUntimestampedData();
      }
    }
  }
}

// ========== JSON 构建 ==========
String buildLatestJSON(int count, bool applyFilter = true) {
  if (!buffer || bufferSize == 0) return "[]";
  int getCount = (count < bufferSize) ? count : bufferSize;
  int idx = bufferHead - getCount;
  if (idx < 0) idx += bufferCapacity;
  DataPoint* displayData = new DataPoint[getCount];
  if (!displayData) return "[]";
  for (int i = 0; i < getCount; i++) displayData[i] = buffer[(idx + i) % bufferCapacity];
  if (applyFilter && getCount > 1) applyFilterToData(displayData, getCount);
  String json = "[";
  for (int i = 0; i < getCount; i++) {
    if (i > 0) json += ",";
    bool validDate = hasValidDate(displayData[i].time);
    json += "{\"t\":" + String(displayData[i].time) + ",\"tp\":" + jsonNum(displayData[i].temp) +
            ",\"hm\":" + jsonNum(displayData[i].humidity) + ",\"pr\":" + jsonNum(displayData[i].pressure) +
            ",\"ah\":" + jsonNum(absHumidity(displayData[i].temp, displayData[i].humidity)) +
            ",\"vd\":" + String(validDate ? 1 : 0);
    if (dayMarkIndex >= 0) {
      int realIdx = (idx + i) % bufferCapacity;
      if (realIdx == dayMarkIndex) json += ",\"dm\":1";
    }
    json += "}";
  }
  json += "]";
  delete[] displayData;
  return json;
}

// ========== ★★★ Web 服务器 ★★★ ==========
String fmtHM(uint32_t t) {
  if (!hasValidDate(t)) return "-";
  struct tm tm; time_t tt = t; localtime_r(&tt, &tm);
  char b[16]; snprintf(b, sizeof(b), "%02d:%02d", tm.tm_hour, tm.tm_min);
  return String(b);
}

// ==================== 设备模式（固定 / 移动）====================
//  0 = 固定(FIX)   1 = 移动(MOV)     存 NVS(Flash)，断电不丢
//  说明：模式最终还应驱动 BQ24074 的 CE 停充点 / IO18 的 ISET 电流切换（V2.1 硬件），
//        本版先把它作为「统一状态源 + 屏幕显示」，网页 /mode 可切换。
Preferences prefs;
uint8_t deviceMode = 0;          // 默认固定

// ==================== 设备一机一密（2026-10-05）====================
//   密钥**只存 NVS，绝不进固件** —— 这样 OTA 的 .bin 是"无秘密"的，
//   固件被谁下载走都不构成泄漏；而 Preferences(NVS) 分区独立于 app 分区，
//   **OTA 升级不会清掉密钥**，所以"内网绑一次、之后随便 OTA"成立。
//
//   签名式必须与服务器 PHT_SERVER/devicekey.py 完全一致：
//     待签串 = "v1|" + deviceId + "|" + ts + "|" + body
//     头     = X-PHT-Auth: v1|<deviceId>|<ts>|<hex HMAC-SHA256>
char     devKeySecret[65] = "";   // 64 hex + NUL；空 = 未绑定 → 回退旧静态 token
char     devKeyId[33]     = "";   // 32 hex 公开标识（非凭据）
uint32_t devKeySetAt      = 0;
bool     devKeySelfTestOk = false;   // pht_crypto 自检结果（开机跑一次）

// 是否已绑定密钥
bool devKeyBound() { return devKeySecret[0] != '\0'; }

void loadDeviceMode() {
  prefs.begin("pht", true);
  deviceMode = prefs.getUChar("mode", 0);
  prefs.end();
  if (deviceMode > 1) deviceMode = 0;
}
void saveDeviceMode(uint8_t m) {
  deviceMode = (m == 1) ? 1 : 0;
  prefs.begin("pht", false);
  prefs.putUChar("mode", deviceMode);
  prefs.end();
}
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
void loop() {
  // ---- V2.1.1-b：标定期间接管一切（停记录 / 停传感器 / 停网页，屏幕为唯一界面）----
  if (calState == CAL_ARM || calState == CAL_RUN) { serviceCal(); return; }

  unsigned long nowMs = millis();
  time_t nowTime = time(nullptr);

  uiDisplay.tickToast();     // 提示横幅到期自动还原（极廉价：无横幅时立即返回）

  bleProcessPending();       // 蓝牙请求处理（放在 loop 主任务里：栈大，避免压崩协议栈任务）
  bleTxPump();               // 蓝牙响应分片发送（非阻塞）
  serviceWifiSession();      // 连网会话：按钮动作 / 配网后的连接（含阻塞式连网，放最后）

  // 无线互斥状态机 + 实体 WiFi 按钮（每 2 秒看一次；插拔电源/切模式/按按钮都会触发切换）
  checkWifiButton();                          // 每圈都查（一次 digitalRead，极廉价）：原先 2 秒轮询会漏掉短按
  serviceChargeTemp();                        // V2.1.1-a：断电即复位临时慢充（常态立即返回，零开销）
  serviceNtpSync();                           // NTP 非阻塞落地（写 RTC / 记时刻 / 超时回退）
  serviceNtpDailyCheck();                     // NTP 每日 02:00 定期重同步
  servicePr1Interlock(readPowerState());      // v2.2：TPS2117 PR1 电池直供互锁（低电才切；>3.6V 硬禁）
  serviceBattAnchor();                        // V2.1.1-b：满电锚点（满电保持 5min → 刷新表内 100% 点）
  serviceTopBar();                            // V2.1.1-c：顶栏快通道（拔插/充电/WiFi 变化 → 立刻反映）
  if (nowMs - lastWirelessCheck > 2000) {
    lastWirelessCheck = nowMs;
    updateWireless();
  }

  // ---- 采样 + 浅睡：**统一调度**（2026-10-01 重做）----
  //   锚点 = 采样点网格（:00/:30 对齐）。每轮都按"下一个采样点"算睡眠时长，
  //   醒来（定时器或 GPIO 事件）后立刻采样 → 采样**真的落在 :00/:30**，不靠事后对齐。
  //   ⚠️ 历史教训：① 判据写"必须正好落在整秒"→ 浅睡醒来差几百毫秒就错过 → 节拍漂成 26~65s；
  //                ② 睡眠时长用墙上时间与 millis() 混算 → 算出 700ms 怪值。
  //      现在：睡眠时长用**墙上时间到采样点的秒差**、采样用**同一网格**，两者同源 → 不再漂。
  if (timeSynced && nowTime >= 1000000000) {
    if (nextSampleTime == 0) {
      // 首次：对齐到下一个 :00 / :30
      nextSampleTime = nowTime - (nowTime % INTERVAL_SEC) + INTERVAL_SEC;
    }
    if (nowTime >= nextSampleTime) {
      lastCollectTime = nowTime;
      uint32_t behind = (uint32_t)(nowTime - nextSampleTime);
      do { nextSampleTime += INTERVAL_SEC; } while (nextSampleTime <= nowTime);
      if (behind >= 2 * INTERVAL_SEC) {
        webLogln("⚠️ 采样落后 %lus（已追上，跳过错过的槽位）", (unsigned long)behind);
      }
      readAndLog();
      // ---- NTP 重试（见上方策略）：**只有插电 + WiFi 已连 + ≥3 天没成功** 才试；每次开机最多一次。
      //    ⛔ 不满足这三条就一个字都不做（尤其电池供电时绝不去连网校时）。
      serviceNtpDailyCheck();   // 每日 02:00 的定期重同步（取代原来的"每次开机只试一次"）
    } else {
      lightSleepService(nextSampleTime);   // 睡到采样点（守卫不满足时立即返回）
    }
  } else {
    if (nowMs - fallbackLastMs >= INTERVAL_SEC * 1000UL) {
      fallbackLastMs = nowMs;
      readAndLog();
      // ---- NTP 重试（见上方策略）：**只有插电 + WiFi 已连 + ≥3 天没成功** 才试；每次开机最多一次。
      //    ⛔ 不满足这三条就一个字都不做（尤其电池供电时绝不去连网校时）。
      serviceNtpDailyCheck();   // 每日 02:00 的定期重同步（取代原来的"每次开机只试一次"）
    }
  }

  // ---- AP 自动管理：连上WiFi关AP；断线超时重开AP（防失联） ----
  if (apEnabled) {
    if (WiFi.status() == WL_CONNECTED) {     // 热点开着时又连回路由器了 → 弹成功提示
      stopAP();
      char tl2[48], tl3[32];
      buildSsidLine(tl2, sizeof(tl2), wifiCfg.ssid);
      snprintf(tl3, sizeof(tl3), "%s", WiFi.localIP().toString().c_str());
      uiDisplay.showToast(UI_TOAST_OK, wifiOkTitle(), tl2, tl3, 20000);
    }
  } else {
    // ⚠ 只在「当前确定用 WiFi」时走这套重连/AP 兼底——否则蓝牙模式下会误开 AP（实测踩到，违反互斥）
    if (wifiRecoverUntil && (int32_t)(millis() - wifiRecoverUntil) < 0) {
      // 【兜底】AP 救援窗口内：**禁止任何 STA 重连**（否则会把刚开的热点顶掉、又变回够不着）
      apClosedMs = 0;
    } else if (curWireless != WL_WIFI) {
      apClosedMs = 0;                    // 蓝牙模式：WiFi 本就该关着，不参与重连
    } else if (strlen(wifiCfg.ssid) > 0 && WiFi.status() != WL_CONNECTED) {
      if (apClosedMs == 0) apClosedMs = nowMs;
      if (nowMs - apClosedMs > 60000UL) {   // 断线 60 秒重开 AP
        apClosedMs = 0;
        webLogln("⚠️ WiFi 断线，重新开启 AP 配置模式");
        startAP();
        if (wifiCount > 1) wifiPickBest(false);           // 多组：重连前重新挑最强的
        WiFi.begin(wifiCfg.ssid, wifiCfg.password);  // 后台继续重连
      }
    } else {
      apClosedMs = 0;
    }
  }

  servicePushTick();   // v2.2 推送：微秒级判断（插电/首次联网 → 置位；HTTP 全在独立任务里）

  archivePump();       // 归档分片泵：每圈最多 40 行，**不阻塞采样**（2026-10-02）
  checkAndArchive();
  server.handleClient();
}
