StellaRigel/ESP32-Pressure-Temperature-Humidity-Recorder/web_icon.h

// ============================================================================
//  web_icon.h —— 网页图标（iOS / Android 主屏），全部由 PNG 转成的字节数组
//  ----------------------------------------------------------------------------
//  为什么这里非要用 PNG：**iOS Safari 不接受 SVG 作为 apple-touch-icon** —— 它是独立于现代
//  favicon 的一套老机制；Android 的 manifest 图标同样只吃 PNG。网页里的 favicon 仍是 SVG data URI
//  （见 PHT_2_X.ino 的 WEB_ICONS，零额外请求），这里只放"主屏图标"。
//
//  图形：三档同一个「雷暴」母题（云 + 闪电 + 气压尖峰），深板岩底 #2c3e50（雷暴的暗天空），
//        因底色深而把云翻转成浅色 #ecf0f1。三档只差"图形占画布的比例"：
//          180 → 69%（iOS 只切圆角，内容不会被裁）
//          192 / 512 → 55%（Android maskable 会被裁成圆形：安全区只有画布 80% 直径，
//                            内容正方形对角线 ≤ 0.8W/√2 → 边长上限 56.6%）
//
//  生成：Edge 无头渲染对应尺寸的 HTML 截图（与 tools/cal-chart*.cjs 的 SVG→PNG 同一路数）：
//    msedge --headless --disable-gpu --hide-scrollbars --screenshot=<out.png> \
//           --window-size=<N>,<N> file:///.../icon_apple_180.html | icon_android_192.html | _512.html
//  ⚠️ 别把多次渲染塞进一个 PowerShell 循环：Edge 会把 \"--window-size=512,512\" 里的逗号吃坏，
//     把几次调用的输出路径拼错（实测：第二次渲染写到了 \"192\\icon-512.png\"）。一次一个进程。
//
//  路由：/apple-touch-icon.png、/apple-touch-icon-precomposed.png、/icon-192.png、/icon-512.png
//        全部由 send_P 从 flash 直发（不占 RAM）+ Cache-Control max-age=86400。
//  换图：重新生成 PNG 后重跑生成脚本替换数组，并同步下面的字节数。
// ============================================================================
#pragma once
#include <stdint.h>

// iOS 主屏图标（apple-touch-icon 路由）。图形占画布 69% —— iOS 只切圆角、不裁内容。
// apple-touch-icon.png —— 180x180，3,042 字节
static const uint8_t WEB_ICON_180_PNG[3042] = {
  0x89, 0x50, 0x4E, 0x47, 0x0D, 0x0A, 0x1A, 0x0A, 0x00, 0x00, 0x00, 0x0D,
  0x49, 0x48, 0x44, 0x52, 0x00, 0x00, 0x00, 0xB4, 0x00, 0x00, 0x00, 0xB4,
  0x08, 0x02, 0x00, 0x00, 0x00, 0xB2, 0xAF, 0x91, 0x65, 0x00, 0x00, 0x0B,
  0x97, 0x49, 0x44, 0x41, 0x54, 0x78, 0x9C, 0xEC, 0xDD, 0x7D, 0x70, 0x14,
  0xE5, 0x1D, 0xC0, 0xF1, 0xDF, 0xEE, 0x5E, 0xEE, 0x92, 0xBB, 0xBC, 0x1E,
  0x11, 0x82, 0xC8, 0x4B, 0x90, 0x04, 0x12, 0x13, 0x02, 0x02, 0xC3, 0x3B,
  0x8A, 0x2F, 0x04, 0xAA, 0x52, 0x9D, 0x82, 0x4A, 0xB5, 0xA3, 0x23, 0xCA,
  0x4C, 0x3B, 0x16, 0xEB, 0x1F, 0x56, 0x6D, 0x3B, 0x53, 0x3B, 0xD6, 0xBE,
  0x4C, 0xA7, 0x55, 0x3B, 0x6D, 0xA7, 0x75, 0x3A, 0x32, 0x56, 0xA5, 0x56,
  0xA9, 0x53, 0x15, 0xB5, 0x40, 0x25, 0xF2, 0x22, 0xD1, 0x80, 0x91, 0x17,
  0x85, 0x80, 0x40, 0xDE, 0x48, 0x4C, 0x08, 0x24, 0xE4, 0xED, 0x2E, 0x77,
  0xB7, 0xBB, 0x4F, 0x9F, 0x10, 0x85, 0x10, 0xF6, 0x17, 0x92, 0x4B, 0x5C,
  0xF7, 0xD9, 0xE7, 0xF7, 0x99, 0xFC, 0xA1, 0x77, 0x39, 0x26, 0xC9, 0x7D,
  0x6F, 0xF7, 0xB9, 0x67, 0x77, 0x9F, 0xF3, 0x14, 0x2C, 0xBA, 0x15, 0x08,
  0xB1, 0xA2, 0x02, 0x21, 0x08, 0x8A, 0x83, 0xA0, 0x28, 0x0E, 0x82, 0xA2,
  0x38, 0x08, 0x8A, 0xE2, 0x20, 0x28, 0x8A, 0x83, 0xA0, 0x28, 0x0E, 0x82,
  0xA2, 0x38, 0x08, 0x8A, 0xE2, 0x20, 0x28, 0x8A, 0x83, 0xA0, 0x28, 0x0E,
  0x82, 0xA2, 0x38, 0x08, 0x8A, 0xE2, 0x20, 0x28, 0x8A, 0x83, 0xA0, 0x28,
  0x0E, 0x82, 0xA2, 0x38, 0x08, 0x8A, 0xE2, 0x20, 0x28, 0x8A, 0x83, 0xA0,
  0x28, 0x0E, 0x82, 0xA2, 0x38, 0x08, 0x8A, 0xE2, 0x20, 0x28, 0x8A, 0x83,
  0xA0, 0x28, 0x0E, 0x82, 0xA2, 0x38, 0x08, 0x8A, 0xE2, 0x20, 0x28, 0x8A,
  0x83, 0xA0, 0x28, 0x0E, 0x82, 0xA2, 0x38, 0x08, 0x8A, 0xE2, 0x20, 0x28,
  0x8A, 0x83, 0xA0, 0x28, 0x0E, 0x82, 0xA2, 0x38, 0x08, 0x8A, 0xE2, 0x20,
  0x28, 0x8A, 0x83, 0xA0, 0x28, 0x0E, 0x82, 0xA2, 0x38, 0x08, 0x8A, 0xE2,
  0x20, 0x28, 0x8A, 0x83, 0xA0, 0x3C, 0xE0, 0x16, 0x23, 0x33, 0x83, 0x69,
  0xA9, 0x29, 0x89, 0x89, 0xBE, 0xD6, 0xF6, 0x8E, 0xF6, 0xB6, 0x8E, 0x96,
  0xD6, 0x36, 0x20, 0x43, 0x23, 0x76, 0x1C, 0x93, 0xB2, 0xC7, 0x2F, 0x98,
  0x73, 0xF5, 0xC2, 0xB9, 0x33, 0xAE, 0x9C, 0x30, 0xB6, 0xCF, 0x5D, 0xBA,
  0xAE, 0x97, 0xEF, 0x3F, 0xB4, 0xE3, 0xC3, 0x3D, 0x3B, 0x4B, 0xCB, 0x29,
  0x94, 0xF8, 0x28, 0x82, 0x2E, 0x52, 0x3B, 0xAD, 0x60, 0xCA, 0x9A, 0x7B,
  0x56, 0xE6, 0x4F, 0x9E, 0x74, 0xC9, 0xEF, 0xD4, 0x0D, 0x63, 0xD3, 0xD6,
  0x9D, 0x2F, 0xBC, 0xF2, 0xC6, 0xC9, 0xA6, 0xD3, 0x40, 0x06, 0x43, 0xBC,
  0x38, 0xF2, 0x73, 0xAF, 0xE4, 0x59, 0x4C, 0x2B, 0xCC, 0x1B, 0xD4, 0xA3,
  0x62, 0x31, 0xFD, 0xAD, 0x4D, 0xEF, 0xBF, 0xF4, 0xDA, 0x5B, 0xCD, 0x2D,
  0x67, 0xFA, 0xFF, 0xCE, 0x8C, 0xB4, 0xD4, 0xEB, 0x16, 0xCD, 0xCE, 0x1A,
  0x75, 0x59, 0x4A, 0x20, 0x90, 0x92, 0xEC, 0x4F, 0x4A, 0xF2, 0x75, 0x76,
  0x86, 0xDB, 0x3B, 0x3A, 0xDB, 0x3A, 0x43, 0xF5, 0xF5, 0x8D, 0xDB, 0x76,
  0xED, 0x6E, 0x6D, 0xEB, 0x00, 0x39, 0x08, 0x16, 0xC7, 0x35, 0xF3, 0x66,
  0x3E, 0xBA, 0xF6, 0x7E, 0xBF, 0x3F, 0x09, 0xE2, 0x72, 0xB4, 0xB2, 0xE6,
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
  0x10, 0x8A, 0x00, 0x00, 0x80, 0x50, 0x04, 0x00, 0x00, 0x84, 0x22, 0x00,
  0x00, 0x20, 0x14, 0x01, 0x00, 0x00, 0xA1, 0x08, 0x00, 0x00, 0x08, 0x45,
  0x00, 0x00, 0x40, 0x28, 0x02, 0x00, 0x00, 0x42, 0x11, 0x00, 0x00, 0x10,
  0x8A, 0x00, 0x00, 0x80, 0x50, 0x04, 0x00, 0x00, 0x84, 0x22, 0x00, 0x00,
  0x20, 0x14, 0x01, 0x00, 0x00, 0xA1, 0x08, 0x00, 0x00, 0x08, 0x45, 0x00,
  0x00, 0x40, 0x28, 0x02, 0x00, 0x00, 0x42, 0x11, 0x00, 0x00, 0x10, 0x8A,
  0x00, 0x00, 0x80, 0x50, 0x04, 0x00, 0x00, 0x84, 0x22, 0x00, 0x00, 0x20,
  0x14, 0x01, 0x00, 0x00, 0xA1, 0x08, 0x00, 0x00, 0x08, 0x45, 0x00, 0x00,
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
};
