StellaRigel/ESP32-Pressure-Temperature-Humidity-Recorder/ui_font_oldsans.h

#pragma once
// ============================================================================
//  ui_font_oldsans.h —— OldSansBlack 点阵字模（由 TTF 光栅化生成）
// ----------------------------------------------------------------------------
//  源字体   : OldSansBlack.ttf  (unitsPerEm=1000, 粗黑体, 比例字体)
//  生成参数 : em=22px 基准 (由 Photoshop 设计参数换算: 6px * 缩放)
//             顶栏 : em22 x (hs=0.80, vs=0.80)  -> 数字高 ~13px
//             数据 : em22 x (hs=1.00, vs=1.15)  -> 数字高 ~20px
//  字符集   : ASCII 0x20..0x7E (95) + °µ±·×÷ (6) = 101
//  字模格式 : [列][字节], bit0 = 最上行; 每列字节数 = ceil(行数/8)
//     uiFontTop : 20 列 x 19 行 (3B/列), baseline 第 15 行, 左右留 2px
//     uiFontBot : 24 列 x 27 行 (4B/列), baseline 第 21 行, 左右留 2px
//  绘制     : 字形框左上 = (pen - UIFONT_*_PAD, y);  pen += uiFont*Adv[索引]
//  字符索引 : idx = (cp>=0x20 && cp<=0x7E) ? cp-0x20 : (95 + 扩展表位置)
//  ⚠ 该字体缺 Ω ≈ ↑ ↓ → ←; 将来要用需另补字形
// ============================================================================

#include <stdint.h>

#define UIFONT_TOP_ROWS   19
#define UIFONT_TOP_COLS   20
#define UIFONT_TOP_BYTES  3
#define UIFONT_TOP_ASC    15
#define UIFONT_TOP_PAD    2

#define UIFONT_BOT_ROWS   27
#define UIFONT_BOT_COLS   24
#define UIFONT_BOT_BYTES  4
#define UIFONT_BOT_ASC    21
#define UIFONT_BOT_PAD    2

#define UIFONT_CHAR_COUNT  101
#define UIFONT_EXT_COUNT   6

// 扩展符号 (索引 95..100)
static const uint16_t uiFontExt[UIFONT_EXT_COUNT] = {
  0x00B0, // 95  °
  0x00B5, // 96  µ
  0x00B1, // 97  ±
  0x00B7, // 98  ·
  0x00D7, // 99  ×
  0x00F7, // 100 ÷
};

// ---- 字符推进宽度表 (像素) ----
static const uint8_t uiFontTopAdv[UIFONT_CHAR_COUNT] = {
  5,6,6,11,11,16,12,4,6,6,9,11,5,6,5,5,11,11,11,11,11,11,11,11,11,11,5,5,11,11,11,8,14,11,12,11,12,11,10,12,13,6,8,12,10,15,13,12,11,12,12,11,10,13,10,15,10,10,10,6,5,6,11,9,5,9,10,9,10,9,6,9,10,5,5,9,5,15,10,9,10,10,6,8,6,10,8,12,8,8,8,6,4,6,11,7,10,11,5,11,11
};

static const uint8_t uiFontBotAdv[UIFONT_CHAR_COUNT] = {
  7,7,7,13,13,20,15,5,7,7,11,13,7,7,7,6,13,13,13,13,13,13,13,13,13,13,7,7,13,13,13,10,18,13,15,13,15,13,12,15,16,7,10,15,12,18,16,15,13,15,15,13,12,16,12,18,12,12,12,7,6,7,13,11,6,11,12,11,12,11,7,11,12,6,6,11,6,18,12,11,12,12,7,10,7,12,10,15,10,10,10,7,5,7,13,9,12,13,7,13,13
};


// ---- 位图 ----
static const uint8_t uiFontTop[UIFONT_CHAR_COUNT][20][3] = {
  { // [0] ' '  adv=5
    {0x00,0x00,0x00},
    {0x00,0x00,0x00},
    {0x00,0x00,0x00},
    {0x00,0x00,0x00},
    {0x00,0x00,0x00},
    {0x00,0x00,0x00},
    {0x00,0x00,0x00},
    {0x00,0x00,0x00},
    {0x00,0x00,0x00},
    {0x00,0x00,0x00},
    {0x00,0x00,0x00},
    {0x00,0x00,0x00},
    {0x00,0x00,0x00},
    {0x00,0x00,0x00},
    {0x00,0x00,0x00},
    {0x00,0x00,0x00},
    {0x00,0x00,0x00},
    {0x00,0x00,0x00},
    {0x00,0x00,0x00},
    {0x00,0x00,0x00}
  },
  { // [1] '!'  adv=6
    {0x00,0x00,0x00},
    {0x00,0x00,0x00},
    {0x00,0x00,0x00},
    {0x0C,0x60,0x00},
    {0xFC,0x77,0x00},
    {0xFC,0x77,0x00},
    {0x00,0x00,0x00},
    {0x00,0x00,0x00},
    {0x00,0x00,0x00},
    {0x00,0x00,0x00},
    {0x00,0x00,0x00},
    {0x00,0x00,0x00},
    {0x00,0x00,0x00},
    {0x00,0x00,0x00},
    {0x00,0x00,0x00},
    {0x00,0x00,0x00},
    {0x00,0x00,0x00},
    {0x00,0x00,0x00},
    {0x00,0x00,0x00},
    {0x00,0x00,0x00}
  },
  { // [2] '"'  adv=6
    {0x00,0x00,0x00},
    {0x00,0x00,0x00},
    {0x7C,0x00,0x00},
    {0x7C,0x00,0x00},
    {0x7C,0x00,0x00},
    {0x7C,0x00,0x00},
    {0x7C,0x00,0x00},
    {0x7C,0x00,0x00},
    {0x00,0x00,0x00},
    {0x00,0x00,0x00},
    {0x00,0x00,0x00},
    {0x00,0x00,0x00},
    {0x00,0x00,0x00},
    {0x00,0x00,0x00},
    {0x00,0x00,0x00},
    {0x00,0x00,0x00},
    {0x00,0x00,0x00},
    {0x00,0x00,0x00},
    {0x00,0x00,0x00},
    {0x00,0x00,0x00}
  },
  { // [3] '#'  adv=11
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
    {0x00,0x00,0x00,0x00},
    {0x00,0x00,0x00,0x00}
  },
};

// ---- 字符 -> 字模索引 (未知回退空格) ----
static inline int uiFontIdx(uint16_t cp) {
  if (cp >= 0x20 && cp <= 0x7E) return (int)(cp - 0x20);
  for (int i = 0; i < UIFONT_EXT_COUNT; i++)
    if (uiFontExt[i] == cp) return 95 + i;
  return 0;
}
