StellaRigel/ESP32-Pressure-Temperature-Humidity-Recorder/ui_cjk.h

#pragma once
// ============================================================================
//  ui_cjk.h —— 中文点阵（23px），从原底图 ui_landscape.h 里【原样抠出】，勿手改
// ----------------------------------------------------------------------------
//  「温 度 湿 气 压」五个字形 = 底图里三个静态标签的全部像素，
//  底图已删除，改为由 ui_display.h 动态绘制（drawCjkText）。
//  字形 = 墨迹包围盒(rowsBits, 按行 MSB 在左) + 相对笔位的 (xoff,yoff)
//  笔位约定：首字 x=6，字距 ADV=26（即第二字 x=32）；带顶 y=25/57/90
//  生成：Node 脚本反解底图 + 往返比对（0 差异），见 README 变更记录
// ============================================================================
#include <Arduino.h>

#define UI_CJK_ADV   26     // 中文字距（与底图原样一致）

typedef struct {
  uint32_t cp;            // Unicode 码点
  uint8_t  w, h;          // 包围盒宽高
  int8_t   xoff, yoff;    // 相对笔位的偏移
  const uint8_t *bits;    // 逐行打包，MSB=最左列
} UiCjkGlyph;

// 温  23x23  xoff=1 yoff=0
static const uint8_t cjk_6e29[69] = {
  0x20, 0x00, 0x00, 0x70, 0xff, 0xf0, 0x38, 0xff, 0xf0, 0x1c, 0xc0, 0x30, 0x0c, 0xc0, 0x30, 0x00,
  0xff, 0xf0, 0x40, 0xff, 0xf0, 0xe0, 0xc0, 0x30, 0xf0, 0xc0, 0x30, 0x38, 0xff, 0xf0, 0x10, 0xff,
  0xf0, 0x00, 0x00, 0x00, 0x00, 0x00, 0x00, 0x11, 0xff, 0xf8, 0x39, 0xff, 0xf8, 0x31, 0x99, 0x98,
  0x31, 0x99, 0x98, 0x71, 0x99, 0x98, 0x61, 0x99, 0x98, 0x61, 0x99, 0x98, 0xe7, 0xff, 0xfe, 0xe7,
  0xff, 0xfe, 0x20, 0x00, 0x00,
};

// 度  23x23  xoff=0 yoff=0
static const uint8_t cjk_5ea6[69] = {
  0x00, 0x38, 0x00, 0x00, 0x18, 0x00, 0x1f, 0xff, 0xfc, 0x1f, 0xff, 0xfc, 0x18, 0x40, 0xc0, 0x18,
  0x60, 0xc0, 0x1b, 0xff, 0xfc, 0x1b, 0xff, 0xfc, 0x18, 0x60, 0xc0, 0x18, 0x60, 0xc0, 0x18, 0x7f,
  0xc0, 0x18, 0x7f, 0xc0, 0x18, 0x00, 0x00, 0x1b, 0xff, 0xf0, 0x1b, 0xff, 0xe0, 0x38, 0x60, 0xe0,
  0x30, 0x71, 0xc0, 0x30, 0x3b, 0x80, 0x30, 0x1f, 0x00, 0x70, 0x3f, 0xc0, 0x67, 0xfb, 0xfe, 0xe7,
  0xe0, 0xfc, 0x23, 0x00, 0x0c,
};

// 湿  23x21  xoff=1 yoff=1
static const uint8_t cjk_6e7f[63] = {
  0x10, 0xff, 0xf8, 0x3c, 0xff, 0xf8, 0x0e, 0xc0, 0x18, 0x04, 0xc0, 0x18, 0x00, 0xff, 0xf8, 0x00,
  0xff, 0xf8, 0x60, 0xc0, 0x18, 0x78, 0xc0, 0x18, 0x1c, 0xff, 0xf8, 0x08, 0xff, 0xf8, 0x00, 0x18,
  0xc0, 0x00, 0x18, 0xc8, 0x1b, 0x98, 0xce, 0x19, 0x98, 0xcc, 0x31, 0x98, 0xdc, 0x31, 0xd8, 0xd8,
  0x70, 0x18, 0xc8, 0x60, 0x18, 0xc0, 0xe3, 0xff, 0xfe, 0xe3, 0xff, 0xfe, 0x60, 0x00, 0x00,
};

// 气  24x23  xoff=0 yoff=0
static const uint8_t cjk_6c14[69] = {
  0x03, 0x00, 0x00, 0x03, 0x80, 0x00, 0x07, 0x00, 0x00, 0x07, 0xff, 0xfe, 0x0f, 0xff, 0xfe, 0x1c,
  0x00, 0x00, 0x3b, 0xff, 0xf0, 0xf3, 0xff, 0xf0, 0x20, 0x00, 0x00, 0x00, 0x00, 0x00, 0x1f, 0xff,
  0xe0, 0x1f, 0xff, 0xe0, 0x00, 0x00, 0x60, 0x00, 0x00, 0x60, 0x00, 0x00, 0x60, 0x00, 0x00, 0x60,
  0x00, 0x00, 0x60, 0x00, 0x00, 0x32, 0x00, 0x00, 0x33, 0x00, 0x00, 0x3b, 0x00, 0x00, 0x1f, 0x00,
  0x00, 0x0e, 0x00, 0x00, 0x06,
};

// 压  22x21  xoff=0 yoff=1
static const uint8_t cjk_538b[63] = {
  0x1f, 0xff, 0xfc, 0x1f, 0xff, 0xfc, 0x18, 0x00, 0x00, 0x18, 0x0e, 0x00, 0x18, 0x0c, 0x00, 0x18,
  0x0c, 0x00, 0x18, 0x0c, 0x00, 0x18, 0x0c, 0x00, 0x19, 0xff, 0xf0, 0x19, 0xff, 0xf0, 0x18, 0x0c,
  0x00, 0x18, 0x0c, 0x40, 0x18, 0x0c, 0xe0, 0x18, 0x0c, 0x60, 0x38, 0x0c, 0x70, 0x30, 0x0c, 0x30,
  0x30, 0x0c, 0x00, 0x30, 0x0c, 0x00, 0x77, 0xff, 0xfc, 0x67, 0xff, 0xfc, 0xe0, 0x00, 0x00,
};

static const UiCjkGlyph uiCjkTable[] = {
  { 0x6E29, 23, 23, 1, 0, cjk_6e29 },  // 温
  { 0x5EA6, 23, 23, 0, 0, cjk_5ea6 },  // 度
  { 0x6E7F, 23, 21, 1, 1, cjk_6e7f },  // 湿
  { 0x6C14, 24, 23, 0, 0, cjk_6c14 },  // 气
  { 0x538B, 22, 21, 0, 1, cjk_538b },  // 压
};
static const int uiCjkCount = sizeof(uiCjkTable) / sizeof(uiCjkTable[0]);
