StellaRigel/ESP32-Pressure-Temperature-Humidity-Recorder/(commit log)

2026-10-02 PHT 2.x 首个公开版本（v2.2.0 开发起点）
    - 从 PHT_2_0 (v2.1.1) 迁移固件与工具链作为演进基线
    - 主 sketch 更名 PHT_2_X.ino（与工程目录一致）
    - 脱敏：WIFI_SSID 置空；移除文档中的真实 SSID；全仓敏感串清零
    - .gitignore 增强：运行期凭据（wifi.json / battcal.* / *.log）与构建产物全部挡在库外
    - README 重写为公开仓库形态（特性/硬件/引脚/构建/隐私/许可/状态）
    - 历史全新（不含任何个人凭据或旧测试代码）
2026-10-02 设计文档：标注 V2.1 早期引脚表已过时，指向 硬件核对清单 第 7.1 节（v2.2 权威表）
2026-10-02 许可：代码/工具/文档 MIT(LICENSE) + 硬件设计 CERN-OHL-S v2(LICENSE-HARDWARE)；README 许可段落与目录树更新；移除原理图截图(仅保留在本地/立创平台)
2026-10-02 README：目录树移除已删除的 Schematic 项（上次替换因换行符不匹配未生效）
2026-10-02 LICENSE-HARDWARE：补入 CERN-OHL-S v2 官方全文（13419 字节，逐字未改，含适用声明与获取地址存档）
2026-10-02 README：移除对前置版本(2.1.1)的提及——公开仓库只呈现 2.x 系列，此前置版本不对外挂
2026-10-02 设计文档：移除误插在 V2.2 章『屏幕SPI总线』中的过时标注（V2.2 章本身是最新内容，标注位置错误）；顺带对齐 IO1-SCK 缩进
2026-10-02 feat/pin-migration: v2.2 全引脚迁移 —— SD SPI(IO5/4/6/7,走HSPI)/LCD(IO40/41/42/1/2,走默认SPI)/I2C(IO47/48)/BQ24074(CE13 CHG9 PGOOD10 EN1-11 EN2-12)/TPS2117 PR1(IO18,新增)/ISET(18->17)/按钮(21)。SPI 主机分配避开控制器原生脚错配。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
2026-10-02 INA2xx: 放宽身份校验兼容 INA230(原硬校验 die==0x2260 会让 INA230 被判离线→低电保护全废)；FEh/FFh 读取与打印提到 begin() 之前(原先藏在成功分支里，校验不过就看不到真实ID)；保留全0/全FF 无应答判定
2026-10-02 硬件核对清单：标记第七节清单 1(INA230 身份校验)与 6(引脚全线迁移)为已完成，附提交号与说明
2026-10-02 INA230-only 收尾：驱动文件 ina226.h->ina230.h(含类型 Ina226*->Ina230*)、全项目标识统一(共112+29处)、身份校验收紧为'只认INA230'(全0=INA230正常身份,仅全FF判离线;原先'全0即离线'会把好器件误判掉)、日志文案与注释同步
2026-10-02 TPS2117 PR1 电池直供互锁实装(v2.2)：VBAT<3.4V切电池直供/>=3.5V回LDO(滞回)；VBAT>3.6V一律禁止拉高(模组VDD33绝对最大3.6V,满电4.2V直供会烧毁)——三重保险(函数内硬保险+硬上限分支提前返回+上电显式拉低)；INA离线或读数越界保持LDO(fail-safe)。4.2V实测全程IO18=0,零风险验证通过
2026-10-02 按钮交互改短按(v2.2)：短按(30~1200ms)=常规动作(移动+插电切快慢充/移动+电池开无线/固定忽略)；长按>=5s 仍为 AP 救援模式(保留长按防误触,用户裁定)；1.2~5s 犹豫按压不触发并记录日志；顶栏快通道判定同步；WIFI_BTN_HOLD_MS 由短按上限 WIFI_BTN_SHORT_MS 取代并加 30ms 抖动下限
2026-10-02 修按钮日志时长显示：新增的两处用了 %.0f 配 unsigned long(可变参数类型不匹配,32位整数被当浮点解释→显示 0ms)，改为 %lu。全项目其余 %.Nf 用法核查无同类问题
    [PHT_2_X.ino]
2026-10-02 PR1 状态多路呈现 + USB 枚举开关 + 注释勘误
    - /status 新增 pr1(LDO/电池直供)、pr1Raw(引脚实际回读电平,可发现'写了没生效')、pr1Safe、pr1Thr{on,off,hardMax}
    - 屏幕顶栏新增直供标识(11x11,仅在电池直供这个罕见低压态出现,常态不占位)；ui_display 增 setPr1()
    - 新增 USB_ENUM_DETECT 编译开关，默认 0(安全)：靠 USB 供电刷机的测试机置 0，其余设备可置 1 正常识别切换(机制本身待实装)
    - 勘误：批量替换 INA226->INA230 时误改了说明文字(如'INA226 已弃用'被改成'INA230 已弃用')，逐处修正；并标注 AVG 被夹到 128 的实测是 INA226 时代结论，新板待今晚验证
    -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
    [PHT_2_X.ino, ina230.h, ui_display.h]
2026-10-03 安全加固(2026-10-03 事故修复)：①深睡唤醒源写死 IO2→改用 PIN_PGOOD(IO10)——引脚迁移漏网，导致设备深睡后永远醒不过来(拔电池黑屏的根因之二)；②低电深睡三重守卫(有外接电源不睡/读数<0.5V不睡(电池拔掉读0V而非NaN)/连续3次确认才睡)；③PR1加插电守卫(外接电源在位绝不切直供)+60秒上电宽限期。硬件核对清单修正PGOOD/CHG脚位笔误并记录事故
    [PHT_2_X.ino]
2026-10-03 阶段1安全启动(PWR_SAFE_START=1)：修'插USB拔电池→设备起不来'——实测证据(3.3V轨一直在/EN1EN2从未拉高/PGOOD无脉冲)→根因是BQ24074输入限流恒为(0,0)=USB100=100mA,撑不住WiFi初始化峰值(之前靠电池补)。措施:①CE拉高禁止充电(不跟系统抢电流)②EN1抬高→(EN2,EN1)=(0,1)=USB500(500mA,USB规范安全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
2026-10-03 文档同步(v2.2 电源路径)：实现细节 D29(BQ24074 EN1/EN2真值表+100mA根因+冷启动流程+两个真bug+待验证项)；开发日志二十三(排障过程+9处弯路复盘+方法论小结)并修编号重复(二十二出现两次、缺十八)；硬件核对清单更正'深睡致黑屏'错误结论为'输入限流不足'并修好被\n破坏的表格；BQ24074手册与提取件归档到 doc/
2026-10-03 USB枚举检测实装(SOF帧号法)：读 USB-Serial-JTAG 的 FRAM_NUM(0x60038000+0x24,低11位) 观察是否自增——主机每1ms发SOF→计数在动=真主机，静止=充电器。实测插电脑:1033→1284(+251/250ms)判定正确✅。决策:主机→保持USB500+禁止充电(实测USB500下battCurrent仅-1.0mA,系统吃满500mA充不进);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
    [PHT_2_X.ino]
2026-10-03 修关键bug: applyChargeStrategy 里误用 #if(PWR_SAFE_START && !usbAllowCharge)——#if 是编译期求值,运行期变量被当成0,条件恒真,导致该函数永远走'CE拉高+return',把 serviceUsbEnum() 判为充电器后拉低的 CE 又拉回去(实测症状:allowCharge=True 但 chgEnabled=False)。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
2026-10-03 定位并记录关键硬件坑: BQ24074 的 TS 脚被画成 2kΩ(应接10k NTC或不测温用10k固定电阻)。芯片内部以75uA恒流灌TS,VTS=75uA*R;VHOT阈值300mV/VCOLD阈值2100mV,VTS越界即判温度异常【直接停充且无任何报错】。2k->VTS=150mV<300mV->全程判过热拒绝充电,导致'换芯片无效/换电池无效/CE-ISET-EN组合全无效'的假象。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
    [charge_en.ino]
2026-10-03 硬件核对清单补记 TS 脚事故(三点六)：图纸 2kΩ 致 VTS=150mV<300mV 判过热→全程停充，换 12kΩ(VTS=900mV)修复；附手册阈值、隐蔽性分析、四种修法对比、实测电流与预充行为吻合
2026-10-03 实装冷启动/热启动分流(设计文档V2.2电源管理模块第2条前置): INA230起来后按VBAT分流——>=3.6V热启动(拨EN,沿用老逻辑提前放行充电)/<3.6V冷启动(电池没电,保持禁充让系统优先启动);冷热只影响启动期是否提前充电,最终充电权仍交serviceUsbEnum判定(否则冷启动=电池没电会永远充不上,实测踩到).拔出readBatteryVoltage()与serviceB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
2026-10-03 实验定论: USB500(USB主机)下【可以充电】——实测充电电流+425mA稳定、电池3.59->3.64V持续爬升、18点无复位。修正此前错误结论(早先测得-1.0mA是在TS=2K芯片判过热停充期间测的,数据被污染不能当结论)。正确模型:BQ24074电源路径管理下系统优先从输入取电,500mA上限中系统约用75mA、余425mA进电池(而非'系统吃满500mA')。故usbChargi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
    [usb500_charge_exp.csv]
2026-10-03 实现细节 D29 补 D29-8: USB枚举(SOF帧号法,寄存器0x60038000+0x24)+冷热启动分流(3.6V)+USB500充电实验定论(425mA可充,附正确电源路径模型与'测量条件有故障时数据不能当结论'的教训);待验证表更新
2026-10-03 启动流程重排(24s->8.5s)+NTP非阻塞+WiFi两项浪费修复。【重排】:①保命与上电安全(chargeInit/INA230/读电压分流)②尽早点亮屏幕(RTC时间先设,不再等NTP)③采集能力就绪(传感器前移)④联网与服务(SD延后);delay 1000->500。关键修正:电压读数从23.9s(带载3.49V)提到0.6s(空载3.81V),冷热分流才准。【NTP】拆为ntpSt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
2026-10-03 四项用户裁定改动:①电池校准硬底线 CAL_FLOOR_V 3.00->3.20V(3.0V太贴地,放电负载下电压继续下探把电池压到保护板切断,下次开机体验极差;实测校准曾把电池放到0.474V)并 CAL_LOW_FROM_V 3.50->3.60V(更早转短加载段减少下探);②冷启动阈值 3.6->3.5V(读数时机改到空载后,空载3.8V与带载3.49V的差异已消除);③NTP改每日02: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
2026-10-03 清理两处过期注释(合理性检查与0%点说明里还硬编码着旧的 3.0V 底线,改为引用 CAL_FLOOR_V 常量并说明 2026-10-03 起为 3.20V)
2026-10-03 事项①失败兜底重学:静态IP用缓存参数配置/网关自检失败时,不再直接放弃静态永久退回DHCP(旧自愈分支还会把useIP改成false,丢掉用户的静态偏好),改为先清掉gw/mask/dns重学一次,再用新参数配静态重试一次;期间用 wifiRelearnProtect 保护避免网关自检再清参数互相打架;重学仍失败则恢复用户原本的静态偏好后走DHCP兜底(仅本次会话)
2026-10-03 实现细节新增 D31(INA230 实测结论,临时分支做完即删):①AVG 恒锁 128 无法更改(不经库直写CONFIG八档全试回读恒0x4927,连读5次确定性)②CT字段写入完全正常(八档140us~8244us全生效,证明非写保护)③库buildConfig()实现与手册位域逐位一致④CT是唯一有效降噪旋钮且效果达两个数量级(140us电流sd1.67mA->8244us的0)⑤标定用C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
2026-10-03 服务器部署完成(KICKPI K3B):Armbian 26.8.6/Debian13 装入 eMMC 并独立启动;静态IP 192.168.1.20(刻意避开PHT设备的.99);SSH密钥免密;pht-server systemd服务已enable;全链路验证(health/根页面/POST样本/设备列表)全部通过,内存占用34MB。新增 docs/PHT服务器部署记录.md 归档环境与5个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
2026-10-03 服务器IP改 192.168.1.20 -> 192.168.1.100(用户指出.20落在家用路由器DHCP池常见区间,有被占用冲突的风险;.100位置更高更安全,实测确认空闲);部署记录同步更新并追加穿透方案决策:选定 Sakura Frp,但明确先跑通局域网再折腾穿透
2026-10-03 API Token 加固完成并验证:①config.py 加 PHT_API_TOKEN(空=不校验)+RATE_ENABLED/WINDOW/MAX/MAX_IPS②app.py 加 _check_token(hmac.compare_digest 防时序侧信道)与 _check_rate(按IP滑动窗口,取IP优先信任X-Forwarded-For以兼容穿透场景),POST端点先限速后校验t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
2026-10-03 开发日志新增二十五章(KICKPI K3B 服务器上线,2026-10-03 夜间):二十五-1 设备端 v2.2 电源路径收尾(USB枚举/编译期#if bug/USB500充电实验定论/冷热分流/TS脚坑/启动重排/NTP与WiFi修复/INA230 D31);二十五-2 服务器端 eMMC 装系统与部署全流程(armbian-install 非交互API/预配置/服务部署/API Toke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
2026-10-04 SD卡初始化失败底层诊断(新增 硬件核对清单 三点七):用临时探针固件逐层验证——引脚IO5/4/6/7与V2.2表一致无冲突;CMD0返回0x01(卡响应);CMD8 R7=0x1AA;CMD58 OCR=0xC0FF8080 CCS=1;ACMD41三次后就绪;CMD9识别为32GB SDHC;CMD17能读扇区——【硬件与SPI协议层完全正常】;但SD.begin()在400k~20M全速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
    [sd_probe4.ino]
2026-10-04 SD卡初始化失败【根因找到并修复】:不是硬件/引脚/走线/库的问题,而是【卡是GPT分区表】——ESP32 的 SD.h 与 SdFat 都只支持MBR,GPT卡在MBR里只有0xEE保护性MBR项,库找不到FAT分区故挂载失败。完整排查链:①引脚核对一致无冲突 ②initSD实现标准 ③底层SPI CMD0=0x01(卡响应) ④完整协议CMD8/CMD58/ACMD41/CMD9(识别32G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
    [sd_probe9.ino]
2026-10-04 ESP32推送 第1阶段:配置层+设备名(含严格重名校验)。①新增推送配置常量(PUSH_INTERVAL_SEC=900秒即15分钟/PUSH_JITTER_MAX_SEC=120按MAC抖动错开多设备/PUSH_BATCH_MAX=200/PUSH_CHUNK_GAP_MS=2000批间让步/HTTP超时8s/服务器192.168.1.100:8080)+HTTPClient头(tag to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
    [PHT_2_X.ino]
2026-10-05 ESP32推送 第2阶段:发送引擎(独立任务/分片/退避/游标NVS)+/push端点; 附直连工具链_build(沙箱里arduino-cli跑不了)
2026-10-05 推送第二阶段上机验收通过(§7.1 六条):持续推送/设备可见/序列连续/重推不丢不重/失败不阻塞采样/无重启; 记录编译刷机三条硬条件(纯ASCII路径+全新build目录+build_opt.h强制重编)
2026-10-05 推送:游标夹紧抽成函数并提前调用(两条路径口径一致)+新增 /status.push.cursorOk 观测位; 更正 D32-6 的误判(重启后 pending=1 本来就是对的,误导来自会话内的 passes 计数)
2026-10-05 验收④真实停机测试取证(101秒停机零丢失/自动补传15条);记录既有采样空档(旧固件同期也有同型空档,非推送回归) —— 实现细节 D32-10
2026-10-05 澄清 pushCancel 是预留位(目前无人置位;实际收手靠 WiFi 状态与开关两道检查)
2026-10-05 第三阶段:flash(/log.csv)补传 —— 流式读日志只推时间戳有效的行,NVS 记 flashSync/flashDone,补传期间 pushRamFloor 挡住 RAM 防跳档,单轮上限1200行;实测把 1100 条缺口全部补上(1852 条 00:00~15:48 全在服务器)
2026-10-05 实现细节 D33:flash 补传的实装要点(流式/只推有效时间/NVS 续传/防跳档 pushRamFloor)、上机结果与未做的 SD 归档
2026-10-05 feat(push): SD 归档补传（牌组模型），补齐 10-02~10-04 历史
    原来的补传只走 /log.csv（flash）和内存环，SD 上冻结的按天归档
    （/2026-10-XX.csv）从来没被推过 —— 服务器 ts_min 一直卡在 10-05。
    改成「牌组（deck）」模型：数据在三个时间上不重叠的地方，
    必须【从旧到新】依次补，否则先推了新点、中间空洞就永远补不回来
    （服务器只按 ts 去重，不会回填）。
    ① SD 归档 /2026-10-XX.csv（冻结，每天一个）
    ② flash /log.csv（最近几天，还在长）
    ③ RAM 内存环（最后 600 条）
    每个牌组用【自己的游标】，所以不再需要 pushRamFl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
2026-10-05 docs(实现细节): D34 —— SD 归档补传的牌组模型、两个防呆与上机结果
    - 记录把 pushRamFloor 换成「牌组（deck）」的设计动机：不再用"下限/水位"
    补洞，改用"每牌组各自游标 + 从旧到新调度"，结构上杜绝跳档。
    - 两个防呆：① 卡没挂上 != 补完了（否则永久跳过整个 SD 归档）；
    ② 文件打不开不要死循环重试。
    - 上机结果：服务器 PHT-6B4580 1852 -> 6418 条，ts_min 回到 10-02 12:42，
    /days 从 1 天变 4 天，SD->flash 交接处 0 断点；唯一大断点是真实停机期。
    - 踩坑：这个 .ino 不要再上自动化补丁脚本（连续翻车三次）。
    - 同时把 D33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
2026-10-05 feat(devicekey): 设备一机一密 —— 密钥存 NVS、HMAC-SHA256 签名（源码就绪，未上机）
    背景：原来的静态 API_TOKEN 被编译进固件 → 固件可下载 = token 泄漏；
    且 device_id 取自请求 JSON，一台设备失陷 = 可冒充任意设备。
    改成：每台设备一个密钥，**只存设备自己的 NVS、绝不进固件**。
    于是 OTA 的 .bin 是"无秘密"的；NVS 分区独立于 app 分区，
    OTA 升级不会清掉密钥，所以"内网绑一次、之后随便 OTA"成立。
    新增 pht_crypto.h
    - 自带的 SHA-256（FIPS 180-4）+ HMAC-SHA256（RFC 2104）。
    - 为什么不用 mbedtls：本项目一直刻意少引组件；SHA-256 是完全确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
2026-10-05 docs(实现细节): D35 一机一密上机验证 + 更正 D32-6 根因
    - 新增 D35：密钥来源与生命周期、三道门实测、上机结果、selftest 说明、
    OTA 构图两个硬伤（64KB 对齐 / 尾部照抄）、merge_same_region 的必要性
    - D32-6 标记为已解决并加更正说明（原推断错误，真因在 appimage.py 自身）
2026-10-05 docs(实现细节): D35 末尾加"操作手册"指针，指向 docs/加设备与用户SOP.md
    D35 记的是实现原理，不是"照着做"的步骤。而加设备真正容易踩的是操作细节：
    - 设备网页**没有密钥入口**（/devkey、/pushcfg、/devname 都是 JSON 接口），
    所以步骤是命令而不是点按钮
    - 注册请求是**设备**发给服务器的，所以服务器的"仅内网"检查看的是设备的 IP，
    与你从哪台电脑敲命令无关
    SOP 里的每条命令都已在真机验证（10/10），包括"口令错被拒""生成新密钥→注册→
    两侧 keyId 一致→推送恢复"。
2026-10-05 feat(web): 设备网页补「密钥 / 推送地址」配置页（/keycfg），上机验证
    起因：写「加设备 SOP」时发现 /pushcfg、/devkey、/devname 只有 JSON 接口，
    固件里对它们的 UI 引用是 0 处（pushcfg 全文只出现 1 次，就是它自己的处理函数）。
    于是"加一台新机器"要手敲 5 条 curl，作为一份要被照着做的流程不合格。
    做法：新增 keyPageHtml() 与 /keycfg 路由，**只驱动已有 JSON 接口，后端零改动**。
    注意这些 POST 是 form-urlencoded（固件用 server.arg() 读），不是 JSON。
    入口**故意低调**：放在「系统」卡末尾，一行 11px 灰色小字，不是和
    WiFi设置/OTA升级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
2026-10-05 feat(devname): 设备身份与显示名分离 + 以服务器为准的对时 + 修非法 JSON
    ① pushDevId（身份）与 pushDevName（显示名）彻底分开：
    - 身份 = ESP.getEfuseMac() 派生 PHT-<MAC后6位>，**终身不变**，
    进签名串 / 注册 URL / 推送 body 的 device / 服务器样本归属；
    用 getEfuseMac 而非 WiFi.macAddress（后者能被 esp_wifi_set_mac 改）。
    - 显示名 = 用户设置，支持中文（UTF-8 按码点计长，≤24），只进 NVS、
    改名请求、本地网页标题。
    - 老库迁移：若老 devName 与派生值不同，说明那台设备的服务器身份就是它，
    必须继续沿用当 ID，否则历史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
2026-10-05 fix(devname): 支持"清除显示名"（空名字 = 合法语义）
    - devRenameTo：**只在非空时校验**名字 —— 否则"清除"这条路会被自己挡住。
    - 收到服务器下发的空名字时，**本地也要清掉**（否则服务器已回退显示 ID，
    设备上还挂着旧名字）。
    - 设备网页设备名输入框：**留空 = 清除**，加二次确认（防手滑）。
    服务端同样把空名字当"清除"，不是校验失败。
    上机验证：设备侧清空成功（库变 NULL、网页标题回退「气象站 v2.1」）；
    管理员在服务器清除后，等有新采样时推送把通知带到、设备采纳、pending 清零。
    [PHT_2_X.ino]
